yatineode128-hue/underground-shelter-project/DRAWING QAQC/QAQC_REPORT.md

# DRAWING QA/QC REPORT — revisions QA1 and QA1B

> **§10, 11 September 2026, is the current package state — revision QA2 (master H.25).**
> It re-scans the whole package, records the **twelve** sheets added at EM1 / EL1 / SG1 /
> SG2, explains why the index had frozen at 68, and corrects one revision-block overlap
> that `DR-A1` left on A-301. **The package is now 80 drawings, 74 PASS.**

> **§9, 10 September 2026, records the three sheets added after this pass** — F-101,
> F-102 and C-101, at revisions FS2 / CAM2 (master H.18). Sections 1–8 count 65 drawings.

> **QA1B addendum, 10 September 2026, is at §8** — the drawing outcome of design changes
> **BS1** and **SP-B2** (master Part H.12). Sections 1–7 record QA1 as issued on 9 September
> and are unchanged.

**Underground CBRN-hardened, blast-resistant protective structure + sentry post, Pune**
9 September 2026 · 65 DXF inspected · 65 corrected · scope: drafting, annotation,
sheet composition and title blocks only.

---

## 1  Headline result

| Measure | Before | After |
|---|---:|---:|
| DXF inspected | — | **65** |
| DXF edited in place (same filename, same folder) | — | **65** |
| **Text-on-text overlaps, all 65 drawings** | **67** | **2** |
| · of which, the 54 generated sheets | 49 | **0** |
| · of which, the 11 `current/cad` drawings | 18 | **2** |
| **Annotation crossing hard line work** (walls, stairs, openings, dimensions) — `current/cad`, whose layer names this test recognises | **50** | **10** |
| Drawing geometry sitting inside a notes panel — generated sheets | 46 | **35**, all legitimate (see note) |
| A view drawn on top of its own notes panel | 3 sheets | **0** |
| Entities outside the sheet border | 0 | **0** |
| Drawings with a border and title block | 54 of 65 | **65 of 65** |
| Panel / table body text below print size (1.4 mm on A1) | most of the package | **0** — floor is now 2.0 mm where the box has room |
| Generated packages rebuilding clean | 54/54 | **54/54, 0 errors** |

*Note on the 35.* They are the pipe-and-duct samples inside the **D-001** and **M-001**
legend panels (33) and a **D-103** section outline (2). A legend panel is *meant* to
contain line work. The eleven that were removed were the three views drawn over their
own notes panels (§3.4) and the bay bubbles that briefly landed inside the M-101 notes.

*Note on the generated sheets' remaining 91 label-over-geometry hits.* These are
bar-mark balloons, rebar callouts and level markers sitting on hatch, centre, reference
and reinforcement lines — which is what those annotations are **for**. They were
inspected on the plots and are correct drafting, not defects. The count that matters
for those sheets, geometry inside a **text panel**, is the row above.

**No engineering value was changed anywhere.** No dimension, level, bar mark, bar
size, spacing, load, material grade, thickness or room size was touched. The frozen
main staircase (24R @ 170.8333, tread 280, three flights of 8, total rise 4100) is
unchanged — verified entity by entity against the pre-edit files.

---

## 2  How the work was done

**The 54 generated sheets** (R-001…R-805, D-001…D-305, M-001…M-203, A-601/611/612 and
the four A4 handouts) are produced by the project's own Python generators. Every
defect in them was fixed **at source, in the generator**, and the sheets regenerated
to the same filenames. That keeps the generators and the DXF in agreement, which is
how the rest of this project is organised.

**The eleven `current/cad` drawings** have no generator in the workspace. They were
corrected directly by a recorded pipeline, `current/cad/Scripts/qa1_build_sheets.py`,
so the result is reproducible and auditable.

**Method for every drawing:** inspect programmatically → correct → save to the same
DXF → plot → look at the plot → correct again → plot again. Between three and six
inspect/correct/plot cycles were run on the package as a whole; sheets with real
defects (R-101, R-601, R-701, M-201, D-201, HV-H2, DR-H1, A-102, A-204) went round
individually four to six times.

Checks used, all in `DRAWING QAQC/Scripts/`:

| Script | What it measures |
|---|---|
| `dxfqa.py` | text bounding-box overlaps, text height range, text outside the sheet or inside the title block, duplicate annotation |
| `modelqa.py` | annotation crossing real line work, segment by segment |
| `panelclash.py` | drawing geometry sitting inside a notes panel |
| `voidqa.py` | occupancy grid and the largest empty rectangle on each sheet |
| `render.py` | plots the DXF so it can be judged as a printed sheet |

Automated checks were used to **find** candidates. Every fix was confirmed on a plot;
several defects (R-601, R-701, M-201) were invisible to the numeric checks and were
found by looking at the sheet.

---

## 3  Systemic defects found and fixed

### 3.1  Panels and tables were sized by eye — `sc_dxflib.py`
`panel()` and `table()` drew a box of a width the caller guessed, then poured text
into it. A long line ran past the border and a long cell ran into the next column.
Both now **measure their own content** with the same font metrics ezdxf uses to place
it: the text is fitted first, and only then is the box widened. A panel line cannot
cross its border and a cell cannot cross a column rule.

### 3.2  Body text was below print size
Every panel body and table cell in the package was written at the library minimum,
`TXT["small"] = 1.4 mm`. On A1 that is under what prints reliably. Panels and tables
now lift the body to **2.0 mm wherever the box has room**, measured, and fall back
only where it genuinely does not fit.

### 3.3  Blocks were pinned at fixed coordinates under variable-height blocks
A bar-mark key is as deep as the number of marks the sheet nominates; the bar-schedule
extract under it was pinned at a fixed `y`. On R-101 the key ran 25 mm straight
through the schedule. **Every such pair is now chained** off the height the block above
actually consumed — nine call sites across `g01`…`g08`.

### 3.4  Three views were drawn on top of their own notes panels
Found by plotting, not by the numeric checks:

| Sheet | What was wrong | Fix |
|---|---|---|
| **R-601** | view origin `(90, 260)` mapped the stair shaft to paper x 682–826: the 1:25 staircase plan was drawn over the MATERIALS panel and ran off the right border, while its own title, balloons and section marks sat on the empty left half | origin `(-508, 282)`; north arrow and two floating notes moved with it |
| **R-701** | origin `(70, 380)` put the headhouse roof plan at paper x 410–530, through “HEADHOUSE ROOF 500 — DESIGN BASIS” | origin `(-240, 380)` |
| **M-201** | section B-B sat at paper y 32–184, through “NOTES — SECTIONS AND CLEARANCES” (y 67–160) | moved into the clear band between V1 and the notes |

### 3.5  Pipe tags rotated along vertical runs
`pipe()` offset its tag +1.8 mm in Y whatever the pipe direction. On a vertical run
that pushes the label **along** the pipe, so a 66 mm tag lay across every label beside
it (D-201: U-05, SUMP, FF 1:80, GY-05, SU-01). Vertical runs now read horizontally,
set off to the side, as a callout normally is.

### 3.6  Table cells were hard-sliced
HV-H2's operating-modes table sliced every cell to a fixed character count —
“NO FILTER BYPASS IS SHO”, “bay 8 not pressuri”, “CBRN warning to all-clea” — losing
information on a sheet meant to be read in an emergency. Full text is now carried and
the table fits its own columns inside the printable width.

### 3.7  Grid bubbles sat on the view titles
On all sixteen MEP plan views the bay bubbles (520 above the box) collided with the
“V1 …” view title. Moving the bubbles below the box was tried and rejected — on M-101
and D-103 the plan sits directly on a notes panel and the bubbles landed inside the
notes. The clash is fixed at the titles, which move from y 548 to 553.

### 3.8  The Rev F drawings were drawings, not sheets
The ten `current/cad` Rev F files had no border, no title block, no notes box, and
annotation lying across the line work. They now carry an A1 (A-301: A0) border, inner
border, 180 × 100 title block and revision strip, drawn in model units at each
drawing's own stated scale, using LINE and TEXT only so the R12 (AC1009) format is
preserved. Loose bottom notes are collected into a ruled **NOTES** box and the drawing
is balanced between the header and the notes.

---

## 4  Per-drawing record

Sheets not named below had no defect beyond the systemic ones in §3, which were fixed
for them by the library and generator changes, and passed visual QA on the first plot
after the rebuild.

| Drawing | Problems found | Corrections | Cycles | Final QA |
|---|---|---|---|---|
| **R-001** | content in the top 40 % of the sheet, body text 1.4 mm, panel headings colliding with the first body line after enlargement, open-items text wrapped mid-word (“the platform b / ecomes”) | recomposed as three filled note columns via new `panel_column()`; heading band derived from both text sizes; word wrapping added; CODES panel moved to balance the columns | 3 | PASS |
| **R-002** | worst-composed sheet in the package — 45 % empty, legend descriptions 1.4 mm | layer-table row height 4.2 → 6.8; legend pitch opened; every description lifted to 2.0 mm; right column laid out with `panel_column` to fill and stop clear of the title block | 3 | PASS |
| **R-003** | bar-shape sketches drew up to 22 mm **above** their own origin, straight through the shape titles (“SHAPE 51” worst) | sketch dropped 30 mm below the title; cut-length lines moved down to match | 2 | PASS |
| **R-101** | bar-mark key (13 marks) ran through the bar-schedule extract; construction-requirements panel then collided with it; “SECTION A-A → R-102” floating mid-plan | key → schedule → notes chained; notes panel stretched to fill the bottom band; section reference moved beside its section mark | 4 | PASS |
| **R-103** | panel heading collided with the “900 HORIZONTAL LEG” detail note | panel dropped 10 mm | 2 | PASS |
| **R-202** | V1 and V2 view titles ran into each other | both titles shifted left | 2 | PASS |
| **R-203** | the right-hand column started at x 300, putting the mark key over the 1:60 wall elevation (which reaches x 407) | column moved to x 420, width 218 | 3 | PASS |
| **R-401 / R-402** | leader label on the W7 wall mark; V1 extension dimension inside the design panel; stray note inside the panel | leader dropped; panel top 400 → 384; note moved beside its dimension | 2 | PASS |
| **R-601** | see §3.4 — plan drawn over the materials panel and off the sheet | view origin corrected | 5 | PASS |
| **R-701** | see §3.4 | view origin corrected | 4 | PASS |
| **R-703** | “OPENING 2100 HIGH BELOW” pinned on the inner border, over the notes panel | moved into the view | 2 | PASS |
| **R-802** | stagger note sat on the D1 view title | note dropped 200 model mm | 2 | PASS |
| **D-101 / D-201 / D-203** | catchpit and gully labels on pipe tags; the long PD-05 rising-main tag lying across the sump labels | labels moved; pipe tags shortened and made horizontal (§3.5); the full route is already stated in sheet note 8, so nothing is lost | 4 | PASS |
| **DR-H1** | site-diagram captions crossing the headhouse and stairwell outlines and each other | captions split, shortened and moved into the clear areas; GY-11 note given a leader | 4 | PASS |
| **DR-H2** | plan title crossed by the service-entry flag; zone strip on the bubble row | flag and zone strip repositioned | 3 | PASS |
| **M-001** | AHU and blast-valve captions on the bay-bubble row and the stair-shaft note | captions moved below the plan | 3 | PASS |
| **M-201** | see §3.4 — section B-B through the notes panel | section relocated | 3 | PASS |
| **M-202** | “WEATHER LOUVRE” and “BLAST VALVE” wider than their own 300-wide stage boxes, so consecutive captions ran together | captions wrap onto two lines and are sized to the stage they name | 2 | PASS |
| **HV-H2** | operating-modes table slicing its cells (§3.6); operating-sequence panel running into the A4 footer | full text restored with `max_w` fitting; lower band re-stacked | 4 | PASS |
| **A-601** | anchor flag block sat above its detail and ran through the D2 title | flag block moved below the detail | 2 | PASS |
| **A-612** | the wall and ceiling halves of the finish tag were wider than their 13 mm cells | tag widened to 34 mm, lower row sized to its cell | 2 | PASS |
| **A-101 … A-301** (ten Rev F) | no sheet, no title block, no notes box; 115 annotations across walls, stairs, openings and dimensions | full pipeline §3.8 + de-clash; 93 labels moved, 28 leaders added | 5 | 5 PASS, 5 REVIEW |
| **S-06** | 18 annotations across the line work | de-clash only — it already has its own border and title block | 3 | REVIEW (2) |

---

## 5  Unresolved — REVIEW REQUIRED

### 5.1  Twelve annotations still crossing line work
All are single labels in the densest zones of a section or plan, where no clear
position exists within a 50 mm search of the object they name. They are legible; each
crosses a dimension, hidden or wall line. Listed so they can be nudged by hand:

| Drawing | Label | Crosses |
|---|---|---|
| S-06 | `CLEAN SUMP 1500 x 1500 x 1500` | CONC / SERVICES |
| S-06 | `UNDERGROUND SHELTER` | SERVICES |
| A-201 | `ROOF CONTINUOUS WITH THE HEADHOUSE ROOF` | WALLS |
| A-201 | `BLAST DOOR 2 -> GENERATOR (BEYOND)` | DIM |
| A-102 | `2200 ABOVE THE FLIGHT - SEE SECTION C-C` | DIM |
| A-102 | `550 ONLY` | DIM / WALLS |
| A-202 | `ROCKHEAD -1.500 / -2.000 (ASSUMED)` | DIM |
| A-202 | `HEADROOM 2533 BETWEEN STACKED FLIGHTS` | WALLS |
| A-203 | `900 PROJECTION` | DIM |
| A-204 | `300 CHANNEL AND GRATING ACROSS THE` | DIM / OPENINGS / WALLS |
| A-204 | `300 CHANNEL AND GRATING ACROSS THE` vs `2200 CLEAR` | label on label |
| A-204 | `NOW SECOND IN SERIES` vs `2400 CLEAR` | label on label |

### 5.2  Sheets that do not fill their paper
`voidqa.py` still reports 20–39 % empty on a number of sheets — after this pass the
worst are **R-202** (39 %), **R-302** (37 %), **D-002** (37 %) and **R-003** (37 %).
Two of the worst were fixed: **R-002** was 45 % empty and is no longer in the list, and
**R-004**, the 92-mark master schedule, was 31 % empty and is now filled (its schedule
row height was opened from 4.9 mm to 7.6 mm, which changes no text size and no value). Where the emptiness came from
layout it has been fixed (§3, §4). Where it remains it is **inherent to the content**:
R-002's L4 block must display text at its true plotted heights, so that sheet cannot
be scaled up, and a 1:50 section of a 22 m structure simply does not fill an A1. No
drawing scale was changed to fill paper. **Your ruling is invited** on whether any of
these sheets should be combined or re-scaled.

---

## 6  Engineering and documentation issues raised — YOUR RULING NEEDED

### 6.1  A-301 FRONT ELEVATION could never have been plotted as drawn — CORRECTED
The drawing is 44 m long, which is **880 mm at 1:50**. The A1 drawing area is 821 mm
wide. Its own note read “SCALE 1:50 AT A1”, which is not achievable. The scale governs
measurement and was kept; the **sheet size was corrected to A0** and the note now
reads “SCALE 1:50 AT A0”. This is the only text content changed anywhere in the
package. If you would rather keep A1 the drawing must go to about 1:75, or the sentry
post must be shown on a separate sheet — **please rule.**

### 6.2  Declared deviation from project rule M.12
M.12 forbids editing a generated DXF directly. **S-06 is a generated output sheet and
its generator is not in the workspace**, so the brief's explicit and repeated
instruction — every existing DXF to be corrected and saved back at the same filename —
could only be met by editing it directly. 15 labels were moved on S-06; nothing else
was touched. This is recorded, not hidden, and is trivially revertible from git.

### 6.3  Sheets that still cannot be regenerated
S-01…S-05, S-07 and S-08 are absent from the workspace, as are their generators
(`proj.py`, `dxflib.py`, `d01_wall.py`…`d08_sentryslab.py`). Nothing was invented for
them. Only S-06 exists and it has been QA'd.

### 6.4  Placeholders that remain, by design
`DRAWN / CHECKED / APPROVED` read `[PLACEHOLDER]` in every title block, matching the
issued R-series. No name, no signature and no approval date has been invented.

### 6.5  Open items untouched
C16, C17, C18, C19, C20, C21, U1–U3, U8 and WM-V1…12 are drafting-neutral and were not
resolved, closed, downgraded or removed. The open-item panels that carry them are
unchanged in content.

---

## 7  Hard-copy readiness checklist

| | |
|---|---|
| Existing DXF edited in place, same filename, same location | ✔ 65/65 |
| No duplicate or parallel “clean” drawing created | ✔ |
| DXF remains editable CAD — LINE, POLYLINE, TEXT, MTEXT, DIMENSION, LEADER, HATCH, INSERT | ✔ nothing rasterised, no block exploded, no geometry flattened |
| DXF format unchanged (R12 for `current/cad`, AC1024 for the generated packages) | ✔ |
| No text-on-text overlap | ✔ except the two named on A-204 |
| No text outside the sheet | ✔ 0 |
| No microscopic annotation in a panel or table | ✔ floor 2.0 mm where the box allows |
| Notes inside a notes box | ✔ including the ten Rev F drawings, which had none |
| Table text inside its cells | ✔ columns now measured, not guessed |
| Title block on every sheet, clean and consistent | ✔ 65/65 |
| Drawing title / number / scale / size correct and agreeing with the index | ✔ |
| Logical sheet sequence, no duplicate numbers | ✔ A-101…A-301, S-06, R-001…R-805, D-001…D-305, M-001…M-203, A-601…A-612, handouts |
| Engineering geometry preserved | ✔ verified entity by entity; where a Rev F drawing was re-centred on its new sheet it moved as a **pure vertical translation** |
| Frozen main staircase unchanged | ✔ verified |
| Plot generated and visually inspected for every drawing | ✔ |
| Remaining issues documented | ✔ §5, §6 |

---

## 8  ADDENDUM — revision QA1B, 10 September 2026

Two instructed design changes, **BS1** (the burster slab is laid to a 1:50 crossfall) and
**SP-B2** (lintels and wall ties for the sentry post masonry infill), were carried through
the drawing package on 10 September 2026 — see master **Part H.12**, **A.7.3** and
**A.4.8**. The drawings they touched were re-inspected, plotted and re-checked. This
addendum records the drafting outcome only; the engineering is in the master.

### 8.1  Result — the QA1 baseline is held

| Measure | QA1, 9 Sep | QA1B, 10 Sep |
|---|---:|---:|
| DXF in the package | 65 | **65** |
| Text-on-text overlaps, all 65 | 2 | **2** — the same two, both on A-204 |
| Annotation crossing hard line work — `current/cad` | 10 | **10** |
| Drawing geometry inside a notes panel — generated sheets | 35 | **35** |
| Drawings passing every automated check | 58 | **59** |
| Generated packages rebuilding clean | 54/54 | **54/54, 0 errors** |
| Frozen main staircase | unchanged | **unchanged — re-verified** |

### 8.2  A regression this work introduced, found and fixed

**A-103** went from 0 to 1 text-on-text the moment the ground-storey callout was
relabelled: *"200 RC BALLISTIC INFILL PANELS"* (30 characters) became *"190 BRICK MASONRY
INFILL (SP-B1)"* (32), and the longer string ran into the vertical **W1 1200** wall tag.
The note was **left-aligned onto the same x as the note above it** rather than left
centred where it no longer fitted. A-103 is back to **0 text-on-text, 0 hard-geometry**.

### 8.3  Defects found by plotting that no numeric check flagged

All three were **pre-existing** and all three were invisible to the overlap metric,
because each fell under its 12 %-of-the-smaller-box threshold. They were found the way
the brief requires — by looking at the plotted sheet.

1. **D-301 — the cover build-up was annotated inside a 33 mm band.** At 1:60 the 2000 mm
   cover is 33 mm on paper and the 100 mm protection screed is **1.7 mm**; six layer
   labels were written inside it and the soil hatch ran through all six. The layer lines
   stay in the section; the build-up now reads from a **panel in the clear space to the
   right, at 2.0 mm**, which also carries the BS1 statement. The
   *"DESIGN GWT (−)2.000 [ASSUMED]"* label, which started **1.7 mm outside the inner
   border** and crossed the 2000 dimension, moved under the GWT dash into the unhatched
   pressure-slab band.
2. **D-102 — two plan labels struck through by line work.** *"C3 ENGINEERED COVER OVER
   THE BOX…"* ran through the extension lines of the 4800 headhouse dimension, and
   *"GRADE CROWNED, FALLS 1:50 AWAY…"* straddled the top border of the V2 catchment
   table. Both dropped clear.
3. **A-103 — the beam note was wider than the room.** *"B1 / B2 250 × 450 FIRST FLOOR
   BEAMS OVER"* was 3851 mm long in a 3600 mm room, so it pushed through the east wall
   and through the **W1 1200** tag, and it sat wedged between the two halves of the
   *"SENTRY POST / GROUND FLOOR"* title. It is now **two centred lines above the title**,
   inside the room.

### 8.4  Also corrected

**Two U+00B7 middle dots had been written into A-105**, which is **R12 (AC1009)** and
therefore ANSI-coded, not UTF-8. They are now ASCII hyphens, and **all eleven
`current/cad` drawings are pure ASCII again.**

### 8.5  What this addendum did NOT change

- **No engineering value.** BS1 changes no thickness and no load: COMB 103 stays
  448.15 kPa and all three `.std` files were not opened. SP-B2 adds no frame member.
- **No open item was resolved by drafting.** **C17** is still open (BS1 does not touch
  it), **WM-V6** and **WM-V7** are still open, and **WM-V3** is deliberately left open —
  lintel L1 is designed to a bound that does not use an opening height.
  **WM-V5** and **WM-V11** are closed **by the design in master A.4.8**, not by anything
  on a drawing.
- **The frozen main staircase.** Re-verified: R-601 still carries all eight frozen
  values and the staircase drawings' text is identical, entity for entity, to the
  pre-change files.
- **QA-1 and QA-2 remain open** and still need your ruling — see §6.1 and §5.2.

### 8.6  Sheets touched by QA1B

| Sheet | Change |
|---|---|
| **R-302** Roof Sections | cover build-up drawn as a real 1:50 crown; fall arrows; labels and panel line updated |
| **D-102** Rainwater Catchment | BS1 continuation on note 3; two struck-through labels moved clear |
| **D-301** Drainage Sections | cover build-up moved out of the section into a legible panel; BS1 statement; GWT label brought inside the border |
| **A-103** Sentry GF Plan | infill relabelled to brick; beam note split and re-placed; regression fixed |
| **A-104** Sentry FF Plan | infill note relabelled to brick |
| **A-105** Sentry Framing Plan | infill callout, load-schedule line and R-value note rewritten; **new SP-B2 lintel and tie panel**; NOTES box rebuilt; non-ASCII removed |
| **A-301** Front Elevation | frame/infill note relabelled to brick |
| **A-202** Side Section X-X | burster slab label now states the 1:50 crossfall |

### 8.7  QA-2 re-measured — §5.2's figures were going stale

§5.2 was written on 9 September and is left as issued. Its list is now partly out of
date, so here are the current numbers, measured by `voidqa.py` on all 65 drawings.

| | 9 Sep (§5.2) | 10 Sep |
|---|---:|---:|
| **R-202** Internal Wall Reinforcement | 39 % | **39.3 %** |
| **D-002** Drainage Symbols | 37 % | **36.7 %** |
| **R-003** Typical Reinforcement Details | 37 % | **36.7 %** |
| **R-302** Roof Sections | 37 % | **35.5 %** — improved by the BS1 crown, its arrows and its longer labels |
| Package mean / median void | — | **23.2 % / 22.3 %** |
| Drawings over 30 % void | — | **14 of 65** |

**§5.2 also under-reported the `current/cad` drawings**, which it did not list at all.
Four of them are now in the worst eight: **A-201** and **A-203** at 38.7 %, **A-103** and
**A-104** at 36.3 %. Their emptiness has a different cause from the generated sheets' —
a Rev F drawing was re-centred on a sheet frame it was never drawn for, so the frame is
sized to the paper while the drawing is sized to its own subject.

**No sheet was re-scaled or re-composed to improve these numbers**, and none should be
without a decision: the scale on a sheet is a measurement statement, not a layout
parameter. **QA-2 stands as an open question for you** — whether any of these sheets
should be combined, re-scaled or left as they are.

One pattern is worth naming for whoever rules on it. On eight of the generated sheets —
R-202, R-003, D-002, R-402, R-002, R-201, R-401 and R-801 — the largest empty rectangle
is the same shape: **(0, 0) to (651, 220–302)**, the full-width strip along the bottom
of the sheet, left of the title block. That is not inherent to the content. It is the
generators stacking their blocks from the top and stopping, and it could be fixed by
chaining the block column to the sheet bottom, the way `panel_column()` already does on
R-001 and R-002. **RC1 examined that and ruled against doing it** (10 September 2026, master K.1).
Reflowing the blocks **moves** the void rather than removing it: the content on these six
sheets is genuinely sparse for an A1, and the two changes that would actually fill the
paper are both worse than the space. **Re-scaling** would turn the stated scale into a
layout variable instead of a measurement statement — 1:20 is the right scale for a 400
wall section however much paper it leaves. **Combining or renumbering** would break
cross-references on other sheets, the drawing index, master Part E.2 and the "N OF 30"
numbering, for no engineering gain. Every one of these sheets is **correct, complete and
legible**; emptiness is not an error. **Combining them is a register-level decision and
it belongs to the user — it remains a contained job if they ask for it.**

---

## 9  ADDENDUM — three sheets added at revisions FS2 / CAM2, 10 September 2026

**Sections 1–8 above record 65 drawings and are unchanged.** The package is now **68**.
The three new sheets did not exist when QA1 ran; they were drawn afterwards, to the same
standard, as the drawing half of the relocation recorded in master Part **H.18**.

| Sheet | Package | What it is |
|---|---|---|
| **F-101** | `Fire and Life Safety/DXF/` | Underground level escape plan — the three routes, the travel distances, and Blast Doors 1 and 2 drawn as the only two real fire barriers |
| **F-102** | `Fire and Life Safety/DXF/` | Entry level escape plan, and **V2, the vertical escape profile** — the climb each route actually is |
| **C-101** | `Site and Concealment/DXF/` | Above-ground signature elevation — a true elevation of every element standing above finished grade, at its confirmed height |

### QA actually executed on them

| Check | Tool | Result |
|---|---|---|
| DXF structure, layers, extents, title block, sheet-edge and scope declaration — 11 checks per file | `Drainage/Scripts/mep_validate.py` | **3 files, 0 errors, 0 warnings** |
| Text-on-text overlap | `Scripts/modelqa.py` | **0 on all three** |
| Annotation over line work | `Scripts/modelqa.py` | **0 on C-101 and F-102. 1 on F-101** — the shared background's own `STAIR SHAFT - FROZEN GEOMETRY` label, which appears identically on the issued D-201 and is not introduced by this work |
| Geometry drawn over a note panel | `Scripts/panelclash.py` | **0 on all three** |
| Index and final QA status | `Scripts/qa_report_data.py` | **68 drawings, 62 PASS** — the 6 REVIEW REQUIRED and the 12 residual items are the same ones §5 already lists. **The three new sheets added none.** |
| **Plotted and inspected visually** | `Scripts/render.py` at 170–200 dpi | **Mandatory under §17 of the brief, and it earned its place.** The first drafts of all three had defects no automated check reported — a travel-distance caption sitting inside a note panel on F-101, V2's level labels running across V1 on F-102, and a grade note struck through the ESC 1 label on C-101. Each was found by looking at the plot and fixed before issue. |

### Two shared modules changed, and why the change is safe

`mep_dxf.py` — the sheet's issue date and its two sentry-post scope notes became
overridable class attributes. `mep_validate.py` — check 11 now asks that a sheet
**declare** its sentry post scope rather than that it **exclude** it, because on C-101 the
sentry post is **in** scope: it is the tallest signature on the site, and a sheet that
drew it while printing "SENTRY POST EXCLUDED" would be stating a falsehood in its own
title block. Silence is still an error.

**Neither change alters any issued drawing.** Verified by regenerating D-101 and diffing
it line for line against the committed file: **26 869 lines against 26 869**, and every
one of the ten differing blocks is inside `$TDCREATE`, `$TDUPDATE`, `$FINGERPRINTGUID`,
`$VERSIONGUID`, `CLASS` ordering or the ezdxf `DictionaryVariables` stamp. **No geometry,
no text, no layer changed, and no issued sheet was regenerated into the repository.**
The other 24 sheets were re-validated in place and still pass.

---

## 10  ADDENDUM — revision QA2, 11 September 2026 (master H.25)

**Twelve sheets drawn after §9 had never been scanned, and the index had silently
frozen at 68.** §9 closed with *"68 drawings, 62 PASS"*. Since then EM1, EL1, SG1 and
SG2 added twelve A1 sheets. The index says at the top of its own file that it
*"cannot drift from the drawings"* — **it had drifted, and this is why.**

### 10.1  The cause — a hard-coded discipline list, not a scanning failure

`Scripts/qa_report_data.py` globs every `*.dxf` under the project root, but maps each
file to a discipline through a **hard-coded `DISCIPLINE` prefix list**. That list ended
at `Site and Concealment/DXF/`. It had no entry for `EMP Protection/DXF/`,
`Electrical/DXF/` or `Site Selection and Geotechnical/DXF/`, and `make_index.py`'s
`ORDER` list had no entry for their discipline names, so the twelve sheets were
collected as `OTHER` and then dropped when the index was grouped and ordered.

**Fixed** — three prefixes added to `DISCIPLINE`, three names added to `ORDER`. The
index is regenerated from the files and now reports **80**. **No drawing was changed by
this fix.**

> **The claim in the index header is now true, but it was only ever true for
> disciplines already on the list.** Any package added in future must add its own
> prefix, or it will be invisible to this tool in exactly the same way.

### 10.2  The twelve sheets, as scanned

| Sheet | Package | Title | Size | Texts | Overlap | Over line work | In panel |
|---|---|---|---|---:|---:|---:|---:|
| **EM-001** | `EMP Protection/` | EMP PROTECTION — DESIGN BASIS AND EMP ZONE KEY | A1 | 146 | 0 | 0 | 0 |
| **EM-101** | `EMP Protection/` | EMP ZONE PLAN — UNDERGROUND LEVEL (−)6.100 | A1 | 198 | 0 | 0 | 0 |
| **EM-102** | `EMP Protection/` | EMP BOUNDARY SECTION — THE ENTRY PATH | A1 | 119 | 0 | 0 | 0 |
| **EM-201** | `EMP Protection/` | SHIELDING EFFECTIVENESS — CAGE AND APERTURES | A1 | 152 | 0 | 0 | 0 |
| **EM-301** | `EMP Protection/` | EMP ZONE 2 ENCLOSURE — PLAN, SECTION AND SITING | A1 | 105 | 0 | 0 | 0 |
| **EM-302** | `EMP Protection/` | EMP PENETRATION, BONDING AND EARTHING DETAILS | A1 | 126 | 0 | 0 | 0 |
| **E-001** | `Electrical/` | SINGLE LINE DIAGRAM — SOURCES, BOARDS AND ESSENTIAL SERVICES | A1 | 146 | 0 | 0 | 0 |
| **SG-001** | `Site Selection and Geotechnical/` | SITE AND GEOTECHNICAL DESIGN BASIS | A1 | 210 | 0 | 0 | 0 |
| **SG-101** | `Site Selection and Geotechnical/` | SITE SETTING, SELECTION AND METEOROLOGY | A1 | 228 | 0 | 0 | 0 |
| **SG-102** | `Site Selection and Geotechnical/` | SITE LAYOUT PLAN | A1 | 138 | 0 | 0 | 0 |
| **SG-201** | `Site Selection and Geotechnical/` | GEOTECHNICAL PROFILE AGAINST THE STRUCTURE SECTION | A1 | 207 | 0 | 0 | 0 |
| **SG-202** | `Site Selection and Geotechnical/` | EXTERNAL WORKS SITING AND THE SOAK PIT FINDING | A1 | 126 | 0 | 0 | 0 |

**All twelve: 0 text-on-text overlaps, 0 annotations over line work, 0 geometry inside a
notes panel.** They were drawn against the post-QA1 shared library and each package ran
its own `mep_validate.py` at issue. **They add nothing to §5's residual list.**

### 10.3  A regression this scan caught — A-301, and it was invisible until now

**`DR-A1` (master H.24) added its revision line to A-301 on the same row as `QA1`'s, and
the two overlapped.** A-301 had been `PASS` with 0 overlaps at QA1; it was scanned again
here for the first time since, and the overlap is real:

```
QA1    09.09.2026 ...   at (-6183.1, -31075.0)   ends x = 1454.0
DR-A1  11.09.2026 ...   at (    0.0, -31075.0)   starts x = 0.0
                                                  -> 1454 units of overlap
```

The revision band on A-301 is 400 units tall (rules at −30800 and −31200) and the two
notes are 7 637 and 8 045 units wide against a band 14 396 wide, so **they cannot sit
side by side and were never going to.** A-202, the other sheet DR-A1 edited, had already
done it correctly — QA1 at −24073, DR-A1 at −24373, both at the same x.

**Corrected on A-301 to match A-202's convention** — the two notes stacked, both left-
aligned at x = −6183.1, QA1 lifted to y = −30905 and DR-A1 placed at y = −31075.
Both sit clear of both rules and of each other; **neither note's text was shortened and
no other entity was touched.** Editing this DXF directly is permitted — the ten Rev F
architectural drawings are source, not build artefacts.

### 10.4  Package state after QA2

| Measure | §9 (68 sheets) | QA2 (80 sheets) |
|---|---:|---:|
| Drawings indexed | 68 | **80** |
| PASS | 62 | **74** |
| REVIEW REQUIRED | 6 | **6** — the same six Rev F sheets |
| Text-on-text overlaps | 0 | **2**, both on A-204, both listed in §5.1 |
| Annotations over line work | 12 | **10** |
| Geometry inside a notes panel | 35 | **35** — the same legend samples, still legitimate (§1 note) |
| Sheets carrying a title block | 65 / 65 | **80 / 80** |

**The twelve new sheets introduced no defect. The one defect found was A-301's, it came
from `DR-A1`, and it is fixed.** §5's residual list is unchanged in substance: the same
six Rev F sheets, now carrying ten items rather than twelve, because the A-202 and A-301
counts were re-measured against their current content.

### 10.5  What QA2 did NOT do

No engineering design was reviewed or changed. No dimension, level, load, bar mark,
quantity, rate, date or float moved. No generated sheet was regenerated into the
repository. **STAAD.Pro was not run.** The main staircase was not touched.
