yatineode128-hue/underground-shelter-project/Site Selection and Geotechnical/Documentation/SITE_SELECTION_AND_GEOTECHNICAL_REPORT.md

# SITE SELECTION AND GEOTECHNICAL INVESTIGATION
### Underground CBRN-hardened blast-resistant protective structure and sentry post — Pune, Maharashtra

**Package** `Site Selection and Geotechnical/` · **revision SG1** · **11.09.2026** · GEOMETRY REV F + M1
**Status — FOR REVIEW - NOT FOR CONSTRUCTION.**

**Evidence class, as everywhere in this project:** `[C]` confirmed · `[R]` reconstructed · `[D]` derived here · `[A]` assumed by this package · `[U]` unresolved · `[N]` not available — DATA REQUIRED

---

## 1. Why this section exists, and what it does not do

Until now this project has carried its site and its ground entirely as assumptions. Master `A.6` tags **every** soil parameter `[ASSUMED]`; `K.2` lists six of them as items that must be confirmed before construction; and the Part J dependency map draws `[SITE INVESTIGATION]` as a root node with **nothing feeding it**. The design report has never contained a site selection section at all.

Two documents have now been supplied that feed that node for the first time. This section records them, checks them against each other and against the master, and states exactly what they do and do not establish.

> ### It resolves nothing, deliberately.
> Master rule `M.6` and the project operating guide both forbid converting an `[ASSUMED]` into a confirmed fact. **Not one `K.2` assumption is closed by this section.** What each one now has, for the first time, is a **stated provenance and a quantified margin** — and in four cases, a reason to stay open that is stronger than before.

**No design value changes.** No load, thickness, bar, level, quantity, rate, date or float moves. No `.std` file is touched. The main staircase is untouched. The sentry post is in scope for **ground only** — footing F1 bears on in-situ basalt at `(−)2.000` and that is a geotechnical statement — and no sentry structural value is changed.

## 2. Sources

| # | Document | What it is | Class |
|---|---|---|---|
| **1** | **SEMT/67/15** — *REPORT ON SUB-SOIL INVESTIGATION FOR CTW PH-III ACCN PROJECT AT CME PUNE*. Soil Engineering & Material Testing Wing, College of Military Engineering, Pune 411 031. Raised on CTW letter No 8722/Ph-III/CTW/116/Q dated 20 May 2015. | A real sub-soil investigation: **11 trial pits at 3 locations**, Appendices A (classification), B (soil test result) and C (rock cores), Sketches P and Q. | `[C]` |
| **2** | **P1 presentation deck** — *CONSTRUCTION OF CBRN HARDENED UNDERGROUND OPS ROOM*, TEAM GROUNDZERO, 32 slides. | The project's own first-phase presentation: site location, contour, watershed, road, pipelines, recce, elevation profile, SWOT, wind, precipitation, temperature, seismic and soil slides. | `[C]` as a record of what was presented |
| **3** | Location pin `https://maps.app.goo.gl/H2VjnrjS8X8SsXEr9` | The project owner's own positional reference. | `[N]` — **NOT RESOLVED - maps.app.goo.gl refused by the session egress policy (403). Coordinates [N]; supply lat/long to close.** |

### 2.1 A limitation that must be read before anything else

**The SEMT report is not an investigation of this plot.** It investigates three named buildings on the CTW/CME campus — **G Building (TP-1 to TP-4)**, **H Building (TP-5 to TP-8)** and the **Mess Building (TP-9 to TP-11)**. The project plot is a separate undeveloped area east of the CTW blocks, against the perimeter track (deck slides 13, 14 and 22).

The report may be carried across to this plot only on the strength of its own paragraph 5:

> *“The area under investigation is underlain by the Deccan Trap formation. These are volcanic lava flows, which were poured out between the late cretaceous and early Eocene times. These basaltic flows are horizontally bedded and more or less uniform in character over a wide area.”*

That carry-across is an **assumption of this section, not a finding of the report** `[A]`. And the report itself shows how much variation “uniform over a wide area” permits: across three locations a few hundred metres apart, rockhead moved from **0.9 m to 1.5 m** and the surface stratum changed from a 1.0 m high-plasticity clay to a 0.2 m clayey-sand murrum.

## 3. Site identification

| Item | Value | Class |
|---|---|---|
| Installation | CTW / College of Military Engineering campus, Pune, Maharashtra | `[C]` |
| Plot | Undeveloped rectangle **east of the two CTW blocks**, west of the perimeter track and nullah line, **CBRN Live Training Area to the south** | `[C]` deck slides 13, 14, 22 |
| Latitude / longitude | **NOT ESTABLISHED** — NOT RESOLVED - maps.app.goo.gl refused by the session egress policy (403). Coordinates [N]; supply lat/long to close. | `[N]` |
| Plot boundary and area | **NOT DIMENSIONED ANYWHERE.** No scale bar, grid, boundary dimension or coordinate appears on any supplied site image | `[N]` — master gap **D3** |
| Site benchmark | **NONE.** Nothing ties any supplied level to the project datum | `[N]` |
| Project datum | **finished grade = 0.000**, local, master `A.4.1` | `[C]` |

> **Master gap D3 — “no site plan” — is NOT closed by this section and cannot be.** Imagery is not a site plan. Until a boundary, a dimension, a benchmark and a coordinate exist, the berm, the hardstanding, the access, the five external drainage runs, the concealment layout (`CAM2`) and the cut-and-fill cannot be drawn. What this section adds is that the *setting* is now recorded, which it was not.

## 4. Site selection

The selection was made at P1 and is recorded here for the first time. The deck's own SWOT, verbatim:

| | |
|---|---|
| **Strengths** | Proximity to FCBRNP · Availability of electric lines · Good road connectivity · Good water supply · No pipelines |
| **Weaknesses** | Located near Perimeter Fence |
| **Opportunities** | Enhanced trg opportunities · Live demo model to facilitate practical trg · Good connectivity |
| **Threats** | Interference with CTW schedule |

### 4.1 What the selection got right, in this project's own terms

Three of the recorded strengths are load-bearing for the design that followed, and none of them was written down as such at the time:

1. **“No pipelines.”** The pipelines sketch (slide 18) draws the site box **outside** the campus pipe network; the nearest services are the RCC overhead reservoir (15 000 gallons, 15 m staging) and substation SS-15 beside buildings 526/527. For a **22 m × 6.2 m box excavated to (−)6.800** with a **continuous gas-tight, EMP-bonded envelope**, a buried main crossing the footprint would have been a first-order problem: every envelope penetration is a blast, gas and EMP discontinuity, which is why the master forbids movement joints inside the protective envelope at all. A clear plot is worth more here than on an ordinary building.
2. **“Availability of electric lines.”** `EL1` found that the only record of an incoming mains supply anywhere in the project is a line in the owner's own construction schedule. Slide 22 is the second, and it is earlier. It does not give a capacity — `EL-V4`, which blocks any fault-level study, **stays open**.
3. **“Good road connectivity.”** The road connectivity slide shows the plot reached from the campus network without passing through the built-up core. The works management package programmes **994 m³ of rock excavation by hydraulic breaker with no blasting** and tipper haulage throughout; that is a haul-route requirement, and the site meets it.

### 4.2 What the selection did not consider, and what it costs

| Not considered | Consequence, now quantified |
|---|---|
| **Ground conditions on the plot itself** | The selection rests on a soil report for three *other* buildings. The confirmatory site investigation (WBS `A1075`, 12 d, **critical path**) has to be located **on this plot**, not repeated from the report. `SG-V1` |
| **Depth of investigation** | Nothing is known below about 1.5 m; the structure founds at `(−)6.800`. **`SG-V2` — the governing item of this section.** |
| **Ground slope** | The plot sits on the edge of a slope falling east. A 22 m box on a level formation under a crowned grade needs cut and fill; **no cut-and-fill item exists in the BOQ** because no site plan exists. `SG-V4` |
| **“Located near Perimeter Fence”**, recorded as the single weakness | It is also a **concealment** weakness, and `CAM2` — whose finding is that *the shelter is concealed, the installation is not* — could not draw a concealment layout for exactly this reason. The sentry post stands at **+7.000** and the headhouse at **+0.900 with no earth cover**; how visible those are from the fence line is a function of a distance nobody has recorded. `CAM-V2`, `D3` |

## 5. Site setting — topography, drainage and access

### 5.1 Level and fall — and a conflict inside the deck

Two slides describe the ground surface, and **they do not agree**:

| Source | What it says | Implied ground level | Implied fall |
|---|---|---|---|
| **Contour map**, slide 15 | 1 m contours labelled **575 to 584**; the **580** and **581** contours both cross the plot; ground falls east / north-east, towards the track and nullah | **≈ 580–582 m** on that map's datum | of the order of **1–1.5 m** across the plot, ≈ 1 in 40 |
| **Elevation profile**, slide 21 | **593.9 m** at 0 m rising to **596.2 m** at **26.8 m** | **593.9–596.2 m** | **2.3 m over 26.8 m** = **1 in 11.7** (8.6%) |

**They differ by 12 to 16 m in level and by roughly a factor of four in gradient.** `[U]` `SG-V4`

The most likely reading is that the contour map is on a local survey datum while the profile is a satellite-derived MSL profile taken across a short transect that includes the track embankment east of the plot — **but that is a guess and it is recorded as one.** Neither figure is adopted.

**Why it does not matter to any calculation.** The project works on a local datum with finished grade `= 0.000` (master `A.4.1`). Every level in Parts A, B and F is relative to it and **no absolute reduced level appears anywhere in the project**. Nothing recalculates.

**Why it matters anyway.** Three things that are not yet drawn depend on it: the **cut and fill** needed to give a 22 m box a level formation under a crowned grade; the **berm toe**; and the point where the cover's **1:50 crossfall** (`BS1`) daylights into the berm fill. With 1 to 1.5 m of natural fall across the plot, finished grade at 0.000 **cannot be the natural surface everywhere**.

The report's own terrain sentence — *“The location for the proposed buildings is on fairly level ground.”* — is said of the G, H and Mess building locations. The contour map shows this plot is the edge of a slope.

### 5.2 Surface drainage

The watershed slide (16) shows the plot on the shoulder of a catchment draining east and south-east to the track and nullah line, with no channel crossing the plot itself. That is consistent with the contours and with the drainage package's position that **the engineered cover is not drained by pipework**: rain sheds at the surface, what infiltrates is intercepted by the 150 granular filter and dispersed at the berm toe (`D-201` note 3, calculation `D.7`, and `BS1`, which gave the burster slab the 1:50 crossfall that claim depends on).

**The site-wide catchment still cannot be closed.** Calculation `D.7` records the structures' own catchments as complete (177.23 m²) and the berm, approach and hardstanding as `[N]` for want of a site plan. Slide 16 does not supply a boundary, so that stays `[N]`.

## 6. Geology and regional setting

> *“The area under investigation is underlain by the Deccan Trap formation. These are volcanic lava flows, which were poured out between the late cretaceous and early Eocene times. These basaltic flows are horizontally bedded and more or less uniform in character over a wide area.”* — SEMT/67/15 para 5 `[C]`

This is the Deccan Trap, and the master has assumed it since Rev D. The report confirms the formation. **What it does not confirm is the thing the master is actually afraid of:**

> **Master `A.6`:** *“The hazard is not the basalt — it is the flow contacts. A single red-bole seam under the mat produces the differential-support case that SIZES the mat.”*

That case — a 3.0 m band of red-bole or vesicular material removed at the worst position — is **what governs the 600 mat and its T16 @ 150 EF EW at 84 % utilisation** (master `B.3`, Case 2). Horizontally bedded flows are precisely the geometry that produces flow contacts at intervals. **The report neither finds nor excludes one, because it never reached the founding horizon.** The red-bole case stands exactly as designed, and the confirmatory investigation must look for seams **at and below (−)6.800**, not above it.

## 7. The sub-soil investigation

### 7.1 Scope and method

| Item | Record | Class |
|---|---|---|
| Method | *“Excavation in open trench / trial pit by JCB was carried out and 11 trial pits were made.”* | `[C]` |
| Pits | **11**, at 3 locations | `[C]` |
| Boreholes | **none** | `[C]` |
| In-situ testing | **none** — no SPT, no plate load test, no permeability test, no percolation test | `[C]` |
| Date of field work | **not stated anywhere in the report** | `[N]` `SG-V10` |
| Laboratory | Soil Classification (IS 2720 Pt IV-1975 & IS 1498-1970) · Free Swell test (IS 2720 Pt XL-1977) · Soil compaction (IS 2720 Part VIII-1983) · UCS test (IS 2720 Pt X-1991) · Direct Shear Test (IS 2720 Pt XIII-1986) · Compressive strength on Rock (IS 1121 Pt I- 1874 [as printed]) | `[C]` |

### 7.2 The governing finding of this whole section

| | Level |
|---|---|
| **Deepest stratum boundary recorded anywhere in the report** | **(−)1.500** |
| Sentry footing F1, on in-situ basalt | `-2.000` |
| Underground box, internal floor | `-6.100` |
| Mat soffit | `-6.700` |
| **FORMATION — what the mat actually bears on** | **`-6.800`** |
| Sump SU-01 base | `-8.000` |

> ## `SG-F2` — THE INVESTIGATION REACHED ABOUT 1.5 m. THE STRUCTURE FOUNDS AT 6.8 m.
> There are **5.3 m of completely unlogged ground** between the bottom of the deepest trial pit and the formation the 600 mat bears on, and **6.5 m** to the sump base. **Only the sentry post footing F1 at `(−)2.000` lies inside the investigated horizon, and only just.**
> 
> Nothing the report says about rockhead continuity, groundwater, jointing, red-bole seams or modulus of subgrade reaction can be read as covering the founding horizon of the shelter. Master `K.2` items **A1, A2, A4, A5 and A8 all stay open**, and the programme's confirmatory site investigation `A1075` — *boreholes, rockhead, red-bole seams*, 12 days, **total float 0** — remains mandatory in full. `SG-V2`

### 7.3 What the pits did find — and the check that it is usable

The full stratum log is in `Schedules/TRIAL_PIT_SCHEDULE.md`. In summary, at all three locations: a thin **black cotton (CH) cover**, **murrum** below it, **disintegrated broken basalt** below that, and **sound basalt** below that again.

Before using any of it, the report was tested against itself. **Every derived number in it reproduces from its own inputs** (calculation `G.2`):

| Chain | Check | Result |
|---|---|---|
| Soil | `SBC = q_ult / 2.5`, the report's own stated factor of safety | **6 of 6 rows reproduce** |
| Rock, step 1 | `UCS = max load / specimen area` | **6 of 6 rows reproduce** |
| Rock, step 2 | `SBC = UCS / 25`, rounded — the factor the report applies but never prints | **6 of 6 rows reproduce** |

> **`SG-F1`.** The SEMT report is internally consistent and is usable. That is worth establishing before anything is built on it.

## 8. Bearing capacity

### 8.1 Soaked or unsoaked? It is not a free choice

The report gives sound basalt **two** bearing values, and they differ by a factor of about 1.6:

| Condition | Band | Class |
|---|---|---|
| **Soaked** | **1961 – 2059 kPa** (20–21 kg/cm²) | `[C]` |
| Unsoaked | 2942 – 3530 kPa (30–36 kg/cm²) | `[C]` |
| Master `A.6` presumptive, IS 1904:1986 Table 1, hard rock | **3240 kPa** | `[A]` |

The design groundwater table is at `-2.000` and the formation at `-6.800` — **4.8 m below it**, permanently submerged. **The soaked value is the applicable one.** Appendix B makes the same choice for the soils in its own remark: *“in submerged condition of soil”*.

The master's presumptive **3240 kPa** sits inside the *unsoaked* band and is **+65%** on the *soaked* one.

### 8.2 And it does not matter

Every bearing check in the master, re-run at the lowest soaked value:

| Check | Demand | / 3240 `[A]` | / 1961 soaked | Verdict |
|---|---|---|---|---|
| Mat, service — master `B.3` | 58.4 kPa | 1.80% | 2.98% | **PASS** |
| Mat, **blast** — master `B.3` | 404.9 kPa | 12.50% | 20.64% | **PASS** |
| Sentry footing F1 — master `B.8.7` | 157.6 kPa | 4.86% | 8.04% | **PASS** |

> **`SG-F3`.** The worst bearing utilisation in the whole project rises from **12.5 % to 20.6%** and everything still passes with a factor of **4.8** in hand. **Master `A.6` is not changed** — 3240 kPa is a presumptive value from IS 1904 and it is declared as one. What this section adds is that **the design is now known to survive the measured value too.**

A second check the report offers for free: even at the **broken** basalt value of 981 kPa — the horizon 5 m *above* the formation — the mat under full blast would be at **41%**. The bearing case is nowhere near governing anything.

### 8.3 The real foundation story: net pressure

The excavation removes ground before the structure replaces it. The report's profile lets that be quantified for the first time (calculation `G.5`, γ values `[A]`):

| | kPa |
|---|---|
| Overburden removed, 1.13 m soil at 19.5 kN/m³ | 22.10 |
| Overburden removed, 5.67 m basalt at 25.0 kN/m³ | 141.67 |
| **Total gross pressure removed at formation** | **163.77** |
| Replaced by, in service (master `B.3`) | 58.40 |
| **Net change in pressure at formation** | **-105.37** |

> **`SG-F4`.** **In service the structure is lighter than the ground it replaces, by about 105 kPa.** It is a fully compensated foundation and then some. This is the physical reason master `B.3` can write *“SETTLEMENT Negligible”* and mean it — and it is the same fact seen from the other side that makes **flotation**, not bearing or settlement, the governing foundation problem (FoS **0.33** at the mat-only stage). The report does not change either conclusion. It explains them.

## 9. Rockhead — and what it costs

> *“Basalt rock is encountered below this murrum / broken rock, below a depth 0.9 m to 1.5 m.”* — SEMT/67/15 para 12

| Location | Sound basalt below | On the project datum |
|---|---|---|
| G Building (TP-1 to TP-4) | 1.500 m | `(−)1.500` |
| H Building (TP-5 to TP-8) | 0.900 m | `(−)0.900` |
| Mess Bldg (TP-9 to TP-11) | 1.000 m | `(−)1.000` |
| **Report band** | | **`(−)0.900` to `(−)1.500`** `[C]` |
| **Master `A.6` assumed band** | | **`(−)1.500` to `(−)2.000`** `[A]` |

> **`SG-F5`. The two bands touch at exactly one point, `(−)1.500`.** The report's rock is at or **above** the master's whole assumed range. The master is therefore **conservative for founding depth** — the rock is there sooner than assumed — and **unconservative for excavation quantity**, because more of the cut is in rock and less is in soil.

Quantifying it. BOQ item `E-02b` at the mean rockhead, with its own stated range, fixes the excavation plan area:

| Rockhead | Depth of rock cut | Rock volume m³ | vs BOQ upper bound |
|---|---|---|---|
| `(−)0.900` | 5.900 m | 1161.12 | +118.12 |
| `(−)1.000` | 5.800 m | 1141.44 | +98.44 |
| `(−)1.500` | 5.300 m | 1043.04 | +0.04 |
| `(−)1.750` ← BOQ `E-02b` | 5.050 m | 993.84 | -49.16 |
| `(−)2.000` | 4.800 m | 944.64 | -98.36 |

| | |
|---|---|
| BOQ prices | **944.6 – 1043.0 m³** |
| On the report's band | **1043.0 – 1161.1 m³** |
| The report's **lower** bound equals the BOQ's **upper** bound | `(−)1.500` → 1043.0 m³ |
| Overrun at the report's shallow rockhead | **+118.1 m³** (**+11.3%**) |
| At the WBS `A2050` output of 60 m³/day | **≈ 2 extra days** |

**Total excavation does not change** — soil falls by the same volume as rock rises — so the money at stake is the **rate difference** over about 118 m³, not a rock rate over 118 m³.

**No BOQ quantity is changed here.** `WM2` adopted the project owner's own BOQ and it governs (master `H.13`), and risk `R-03` in the works management risk register already carries *“rock excavation quantity exceeds the estimate because rockhead is shallower than the mean assumed”*. What this section adds is **the number**: the register says *“roughly one extra day”*, and on the report's band it is about **2**.

One consequence is favourable and is recorded because it is free. Master `B.3` dismisses sliding on the grounds that the box is *“socketed ~4.8 m into basalt”*. On the report's band the socket is **5.3 m to 5.9 m**. The argument gets stronger.

## 10. Groundwater — the central question

> *“Water table was not encountered in any trial pit. However, water table may raise during/after rainy season.”* — SEMT/67/15 para 13 `[C]`

> P1 deck slide 29, verbatim: *“Water Table not encountered in any trial pit”* · *“Might increase during monsoon”* · **“Proposed structure safe for water table at depth of 2 m below GL”** `[C]`

### 10.1 The provenance of `(−)2.000`, recorded for the first time

Master `A.6` and `K.2 A2` record the design groundwater table as **`(−)2.000` `[ASSUMED]` — the single most important number to confirm** — and give **no source**. The source is now known, and it is this:

> **No water was found in any trial pit, so a depth of 2 m below ground level was *chosen*, and the structure was then designed to be safe for it.**

That is an assumption adopted in the absence of data. It is a defensible one — it puts the water table near the surface, which is the conservative direction for uplift and for lateral load. **It is not a measurement, and this section does not turn it into one.**

### 10.2 Three reasons the observation does not reach the design question

**(1) Depth.** The pits reached about 1.5 m. The design GWT is at `-2.000` — **already below the deepest pit** — and the founding horizon is at `-6.800`. A pit that stops at 1.5 m cannot find a water table at 2 m, let alone characterise one at 6.8 m. **Here, *“not encountered”* means *“not reached”*.**

**(2) Season.** The report itself says the table *“may raise during/after rainy season”*. The request is dated **20 May 2015**; if the field work followed promptly it was done in the last weeks before the monsoon — the annual minimum. **The report nowhere states the date of the field work**, so this is inference and is recorded as an open item, not as a finding. `[U]` `SG-V10`

**(3) Ground type.** Deccan Trap groundwater is not a simple water table in a porous medium. It sits in the vesicular and jointed zones **at the flow contacts** — the same feature master `A.6` names as the hazard and that the red-bole differential-support case in `B.3` is built around. Such water is commonly perched and strongly seasonal. **An open trial pit in the dry season is close to the worst available instrument for finding it.**

### 10.3 Why this is the number that matters

| From master `A.7.2` and `B.3` | |
|---|---|
| Of the **15.41 kPa/m** lateral gradient | **9.81 is water**, only 5.60 is soil |
| Hydrostatic uplift on the mat | **46.11 kPa = 6 289 kN over 136.4 m²** |
| Flotation FoS, mat cast only | **0.33 — FAIL** |
| Flotation FoS, box complete, no backfill | **1.22 — MARGINAL** |
| Flotation FoS, box complete, flooded to grade | **0.86 — FLOATS** |

> **`SG-F6`. `K.2 A2` stays `[ASSUMED]` and stays open — and the new evidence is a reason to keep it open, not to close it.** Water is nearly two thirds of the lateral load and the whole of the uplift. Everything this structure is afraid of is water.

### 10.4 What would actually close it — and a programme problem

The works management programme carries the right activity:

> `A1080` — **“Monsoon groundwater monitoring — confirm the design GWT (−)2.000”**, 20 days, **12-11-26 to 04-12-26**, total float 0, noted *“the single most important assumption in the project”*.

> ## `SG-F7` — that window is not in the monsoon.
> On the deck's own precipitation table, June to September carry **559.7 mm (74% of the year)**, while **November and December carry 28.6 mm between them**. An activity called *monsoon* groundwater monitoring scheduled **12 November to 4 December** measures the **recession, not the peak** — and the peak is exactly what `A2` asks for.
> 
> What closes `A2` is a **standpipe piezometer installed in the `A1075` borehole and read through a full monsoon**. Nothing shorter does. **No programme date is changed here**: the owner's own Master Construction Schedule R0 governs (master `H.13`) and `A1080` sits on the critical path at TF 0, so moving it moves the job. It is raised, with its reason and its cost, as **`SG-V3`** — a decision for the project owner.

## 11. Seismicity

| Source | Statement |
|---|---|
| SEMT/67/15 para 7 | *“Pune falls under Seismic Zone III as per IS 1893 of 1984. However, the earthquake activity in 1993 at Killari (Latur, Maharastra) should be kept in mind while designing the structure.”* |
| P1 deck slide 27 | **ZONE III**, design per **IS 1893:2016** |
| Master `A.7.8` | **Z = 0.16 (Zone III)**, IS 1893 (Part 1):2016 |

The report cites the **1984** zone map and the design uses the **2016** code. Pune is Zone III on both, and Z = 0.16 is read from IS 1893 (Part 1):2016 Table 3. Reproducing the master's two seismic coefficients from it:

| Structure | R | A_h = (Z/2)(I/R)(Sa/g) | Master | |
|---|---|---|---|---|
| Underground box | 4.0 | (0.16/2)(1.5/4.0)(2.5) = **0.0750** | 0.075 | **✔** |
| Sentry post | 3.0 | (0.16/2)(1.5/3.0)(2.5) = **0.1000** | 0.100 | **✔** |

> **`SG-F12`. Zone III is now corroborated by a document outside the project, and the master's seismic coefficients reproduce exactly from it.** This is the **only** master design input this section is able to corroborate externally. Nothing changes — and that is the point. It was already right.

The two documents name **different** 1993 events — the report names Killari (Latur), the deck names the Koyna area on 28 August 1993. Both are recorded as they stand; neither changes the zone, which is what the design uses, and this section does not adjudicate seismology. The deck's three regional events (M 4.8, 3.2, 2.6) are all well below the Zone III design basis and are recorded as context.

## 12. Meteorology

The full monthly table is in `Schedules/METEOROLOGICAL_SCHEDULE.md`.

### 12.1 Rainfall — the two documents disagree

| Source | Annual rainfall | Class |
|---|---|---|
| P1 deck slide 25, summed | **759.6 mm** | `[C]` |
| SEMT/67/15 para 9 | **500 – 600 mm** | `[C]` |
| Difference | **+27% to +52%** | `[U]` |

> **`SG-F11`. The two supplied documents disagree on annual rainfall by between a quarter and a half.** Neither names a station, a period of record or a source: the deck says *“last 10 years avg”* and the report says *“the region”*.

**No third figure is adopted here.** Published tertiary figures for “Pune” themselves range from about 720 mm to over 1 000 mm depending on which gauge and which period is quoted — which is the reason a **named station and period** is required, and the reason substituting a web figure for the deck's would be putting false authority on the design report. `SG-V5`

**One month is the outlier.** Read as a monsoon distribution for the interior Deccan:

| | |
|---|---|
| June to September | **559.7 mm**, 74% of the year |
| **October alone** | **139.8 mm**, 18% of the year |
| October ÷ September | **1.04** |
| October ÷ August | **1.16** |

The south-west monsoon withdraws from interior Maharashtra in the first half of October. An October that nearly equals September **and exceeds August** is not the shape of a Deccan rainfall year. **The October figure is the one to go back and check** — and note that removing it alone would bring the deck's total to **619.8 mm**, still above the report's range. **It is not corrected here**: correcting a datum whose source is unknown would be inventing evidence. `SG-V5`

### 12.2 And the part that matters most — nothing in the design uses the annual total

| What the design actually uses | Status |
|---|---|
| **50 mm/h design intensity**, Rev F drawing 5 note 1 — the only rainfall intensity anywhere in the project, with **no return period, duration or IDF source** | drainage open item **`DR-D1`**, **NOT closed by this section** — a monthly total cannot produce a short-duration intensity |
| **Soak-pit absorption 20 L/m²/day** | `K.2 A7` — needs the IS 2470 (Pt 2) Cl. 4 **percolation test** and nothing else. The report's basalt makes failure likely, which the master already says |
| **The monsoon window** | a **programme** input — `SG-F7` above |

So the rainfall conflict **changes no number in this project**. It changes what the design report may claim, and it changes when the groundwater monitoring has to happen.

### 12.3 Temperature — not a conflict, and a gap narrowed

| Source | Statistic | Values |
|---|---|---|
| SEMT/67/15 para 8 | **absolute extremes** | summer 40 / 12 °C · winter 26 / 4 °C |
| P1 deck slide 26 | **monthly means** | hottest Apr 38.3 °C mean daily max · coldest Jan 11.6 °C mean daily min |

A monthly mean daily maximum of 38.3 °C sitting under an absolute maximum of 40 °C is exactly what one expects. **These are different statistics and they are mutually consistent.**

HVAC calculation `H.10` records *“outdoor design dry-bulb / wet-bulb, Pune … NOT IN THE PROJECT `[N]`”* as the **first of eight missing inputs** that stop a cooling load being computed. This section **narrows that gap and does not close it**: an absolute extreme and a monthly mean are not a design dry-bulb, and **neither document gives a wet-bulb or any coincident value at all**. The remaining seven inputs are untouched, and `EL-V6` — *no cooling plant exists anywhere in the project* — is untouched.

### 12.4 Wind — a warning, because this one invites a wrong “correction”

| | |
|---|---|
| Deck slide 24, windiest month | June **6.6 km/h** = 1.83 m/s |
| Master `A.7.8` design basic wind speed | **39 m/s** |
| Ratio | **21.3 : 1** |

> **These are not the same quantity and the ratio is not an error.** The deck plots a **monthly mean speed**. IS 875 (Part 3):2015 `V_b` is a **3-second gust at 10 m with a 50-year return period**. A mean of 1.8 m/s and a 50-year gust of 39 m/s are entirely compatible. **Master `A.7.8` is not to be reduced on the strength of slide 24** — and in any case seismic governs the sentry post **2.4 : 1**, so the wind case decides nothing.

## 13. The soil parameters in master `A.6`, checked against measured data

Appendix B gives compaction and shear results for the **murrum** — the material the engineered fill, the side backfill and the berm will actually be built from. Master `A.6` and `A.7.3` have carried round numbers for these since Rev D with no measurement behind either. The full arithmetic is in calculation `G.8`.

### 13.1 Unit weight

| | |
|---|---|
| Measured, 95 % MDD at OMC, three murrum samples | **19.12 – 19.61 kN/m³** `[D]` |
| Master `A.6` / `A.7.3` bulk | **20.00 kN/m³** `[A]` — **2–5 % high**, i.e. conservative for lateral load |
| γ_sat back-figured from the measured MDD, G_s = 2.75 `[A]` | **21.26 kN/m³** `[R]` |
| Master `A.6` γ_sat | **21.00 kN/m³** — agrees within **1.2 %** |

Applied to the **engineered cover**, whose total is held at **40.65 kPa** by `RC1` / `C17`:

| Case | Six-layer sum | vs the held 40.65 |
|---|---|---|
| As placed, at the **lowest** measured γ | **38.49 kPa** | −2.16 (the declared allowance grows from 1.50 to 2.16) |
| As tabulated in `A.7.3` | 39.15 kPa | −1.50 (the `C17` allowance) |
| **Fully saturated**, all three soil-like layers `[A]` | **41.07 kPa** | **+0.42**, which is **+0.09 % of COMB 103** |

> **`SG-F8`. The held value of 40.65 kPa brackets both the as-placed case (lighter) and the fully saturated case (heavier by about 1 %, which is one tenth of one percent of COMB 103).** `C17`'s declared allowance turns out to be doing real work. **Nothing changes**: 40.65 stands, COMB 103 stays **448.15 kPa**, no `.std` file is touched.

### 13.2 Shear strength and K₀

| Sample | Class | c kg/cm² | φ | 1 − sin φ | vs the assumed 0.50 |
|---|---|---|---|---|---|
| 45/15 | `GM` | 0.00 | 33° | **0.4554** | -0.0446 |
| 62/15 | `GM` | 0.00 | 34° | **0.4408** | -0.0592 |
| 64/15 | `SC` | 0.01 | 27° | **0.5460** | +0.0460 |
| 65/15 | `GP` | 0.00 | 35° | **0.4264** | -0.0736 |

Three granular murrum samples give K₀ **0.426 – 0.455**: the assumed **0.50 is conservative against all three**. One clayey sand (`SC`, TP-9, a 0.2 m surface layer) gives 0.546. Carrying even that value to full depth — which no reading of the profile supports — moves the wall pressure at the floor from **83.18 to 87.11 kPa**, and against the 383 kPa blast on the same face that is **+0.84 % on the total**.

> **`SG-F9`. The measured shear parameters move the wall design load by under 1 %.** The walls are blast-governed. `A.6`'s K₀ = 0.50 is not changed, and the report gives no reason to change it.

### 13.3 A limit on all of the above, stated plainly

On the report's own rockhead band the box occupies `(−)2.000` to `(−)6.800` and is therefore **entirely within basalt**. What bears on the buried walls is rock and the 300 lean-concrete annulus, **not soil**. The master's *K₀ soil plus full hydrostatic* model is a conservative idealisation of that, and it is right to keep the whole hydrostatic term, because water pressure in a jointed rock mass is real and is two thirds of the load. **The measured soil parameters are the right check on the berm, the backfill and the cover. They are not a description of what the buried walls retain.**

## 14. The black cotton soil — where it is harmless, and two places it is not

| Property | Measured |
|---|---|
| Depth | **0.18 – 1.0 m** |
| Liquid limit | 61 – 63 % |
| Plastic limit | 29 – 30 % |
| Plasticity index | 32 – 33 % `[R]` |
| **Free swell index** | **60 – 65 %** |
| IS 1498 classification | **CH** |
| SBC | 0.25 – 0.27 kg/cm² = **24.5 – 26.5 kPa** |

A free swell index above 50 % is the top band of the IS 1498 scale — **very high swelling potential**. Deck slide 30 puts it in plain words: the soil *“contracts and produce cracks in dry season, 10 to 15 cm wide extending to maximum depth of 1 m”* and is *“Not suitable for foundation”*.

### 14.1 Where it is harmless — which is most of the project

**Nothing structural founds in it.** The mat is at `(−)6.700` and sentry footing F1 at `(−)2.000`, both in basalt, both far below the 0.18–1.0 m black cotton horizon. Master `B.8.7`'s insistence that F1 bears *“on IN-SITU ROCK, never on backfill”* — and the decision to put the sentry post **≥ 10 m clear of the shelter excavation** — are now backed by a measurement. **No action.**

### 14.2 `SG-F13` — the covered entry stairwell's stepped raft

Master `A.4.7`: *“Stepped RC raft 300 thk **on compacted fill**”*, stepping from the top landing at `0.000` down to the platform at `(−)2.000`. With 300 of raft, **its top founds at about `(−)0.300` — inside the black cotton horizon at two of the report's three locations.**

*“On compacted fill”* implies the black cotton is stripped and replaced, but **no specification anywhere says so**, **no strip-and-replace item exists in the BOQ**, and a very-high-swelling CH clay under a stepped raft is a **heave** problem, not a bearing one — the SBC of 24.5 kPa is irrelevant; the 60–65 % free swell is not.

The stairwell is declared **expendable** against blast (master `B.6`, Rev F drawing note 8) — but **heave is a service-life problem, not a blast one, and this stair is the only primary access to the shelter**. `SG-V6`

### 14.3 `SG-F14` — the concealment layer

Master `A.7.3` puts **300 of topsoil / turf** at the top of the cover, and `CAM2` makes it *the concealment layer*, **“re-laid from the site's own stockpile.”** If the site's own topsoil is this CH clay at FSI 60–65 %, then the concealment layer is a very-high-swelling clay 300 mm thick:

- it **cracks in the dry season**, and a cracked, patchy turf is a **concealment defect** — which is `CAM2`'s entire subject;
- the cracks are a **direct infiltration path** into the 150 granular filter immediately below it;
- wetting and drying cycles **pump clay fines into that filter**, which is the one thing the filter exists to stop (`A.7.3`: *“Stops fines clogging”*).

**The load is unaffected** — 300 at 18 kN/m³ = 5.40 kPa is right for a black cotton soil — so **no calculation moves**. What is missing is a **specification**: either qualify the stockpiled topsoil against a swell limit, or import a non-expansive topsoil and price it. Neither exists. `BS1`'s 1:50 crossfall on the burster slab still works and is unaffected; it is the filter above it that would see more water and more fines than assumed. `SG-V7`

## 15. The P1 deck against its own cited source

Deck slides 29 and 30 both carry the source line *“Source : SEMT wing, CME”*. **Three of their statements are not in that report.** They are listed because the deck is a **presented** document and the same claims will be presented again unless they are corrected at source. **None of them affects the design**, because the design does not use any of them.

| Deck statement | What the report actually says | Effect on the design |
|---|---|---|
| *“Safe Bearing Capacity = 300 kN/m² at 1.5 m depth from Top”* | 300 kPa = 3.06 kg/cm², which is **not any value in the report**. At 1.5 m it gives CH clay 26.5, murrum 418.7, broken rock 981, sound basalt 1961 soaked / 3236 unsoaked kPa | **None.** It is 6.5× below the lowest rock value at that depth — conservative — and master `A.6` uses the IS 1904 presumptive 3240 kPa instead |
| *“Murrum … SBC of 25 – 30 kg/cm²”* | the report's murrum SBCs are **2.07, 4.27, 4.66 and 5.18 kg/cm²**. 25–30 is the **sound basalt unsoaked** band | **None.** But it assigns **rock** strength to **soil**, about 5–6× high |
| *“Compressive strength ranging from 609 – 900 kg/cm² in unsoaked condition”* | Appendix C's unsoaked results are **[752, 814, 900]** — a range of **752 to 900**. **609 appears nowhere in the report** | **None.** The upper bound is right |

Two deck statements are **right and important**:

- *“Ultimate Bearing Capacity = S.B.C × 2.5”* — this is Appendix B's own relationship read backwards, with the report's stated factor of safety. **Correct.**
- *“Proposed structure safe for water table at depth of 2 m below GL”* — **true, and now traceable**. It is the provenance of `(−)2.000`. See §10.

`SG-V8`

## 16. Findings

| Ref | Finding |
|---|---|
| `SG-F1` | The SEMT report reproduces completely from its own inputs — soil, rock strength and rock bearing. **It is usable.** |
| `SG-F2` | **THE INVESTIGATION REACHED ABOUT 1.5 m; THE STRUCTURE FOUNDS AT 6.8 m.** 5.3 m of unlogged ground under the whole structure. **The governing finding.** |
| `SG-F3` | The presumptive SBC is 65 % above the measured *soaked* value — and no element cares. Worst utilisation 12.5 % → 20.6 %. |
| `SG-F4` | In service the structure is **lighter than the ground it replaces**, by ≈ 105 kPa. Settlement was never the problem; flotation always was. |
| `SG-F5` | The report's rockhead band (0.9–1.5 m) is **entirely at or above** the master's assumed band (1.5–2.0 m). +118 m³ of rock, ≈ 2 days. |
| `SG-F6` | *“No water table”* means **“not reached”**. `K.2 A2` stays `[ASSUMED]` and stays open — the provenance of `(−)2.000` is now recorded, its verification is not. |
| `SG-F7` | **The monsoon groundwater monitoring is programmed outside the monsoon** (12 Nov – 4 Dec), on the critical path. |
| `SG-F8` | The held cover value of 40.65 kPa **brackets both** the as-placed and the fully saturated case. `C17`'s declared allowance is doing real work. |
| `SG-F9` | Measured shear parameters move the wall design load by **under 1 %**. The walls are blast-governed. |
| `SG-F10` | The deck's contour map and its elevation profile disagree by **12–16 m** in level and ≈ 4× in gradient. |
| `SG-F11` | The two supplied documents disagree on annual rainfall by **27 – 52 %**. October is the outlier. |
| `SG-F12` | **Seismic Zone III is externally corroborated** and the master's A_h values reproduce exactly. The only master input this section can corroborate. |
| `SG-F13` | The **entry stairwell's stepped raft founds in very-high-swelling CH clay** with no strip-and-replace specification anywhere. |
| `SG-F14` | **The concealment layer may be a very-high-swelling CH clay** re-laid from the site's own stockpile, over the filter it would clog. |

## 17. Open items — `SG-V1` to `SG-V10`

**None of these is resolved, and that is deliberate.** Each needs something this project does not contain.

| Ref | Item | What would close it |
|---|---|---|
| `SG-V1` | **The geotechnical data is off-site.** The trial pits are at the G, H and Mess buildings. **No investigation has ever been made on the project plot.** | Locate WBS `A1075` **on this plot** |
| `SG-V2` | **Depth of investigation.** ≈ 1.5 m against a formation at `(−)6.800` and a sump base at `(−)8.000`. | Boreholes with core recovery and RQD to well below `(−)6.800`, logging **every flow contact and red-bole seam**, with packer permeability at the contacts |
| `SG-V3` | **The monsoon GWT monitoring window is not in the monsoon** (12-11-26 → 04-12-26, TF 0). | A project-owner decision: a standpipe piezometer in the `A1075` borehole read through a **full monsoon**, and the programme consequence accepted |
| `SG-V4` | **Site level and fall.** The contour map and the elevation profile disagree by 12–16 m; nothing ties either to the project datum. | A levelled **benchmark on the plot** and a spot-level survey; then the cut-and-fill, berm toe and `BS1` daylight point can be drawn |
| `SG-V5` | **Annual rainfall.** 759.6 mm against 500–600 mm; the **October figure** does not fit a Deccan year. | A **named IMD station and period of record** — and separately, an IDF source for the 50 mm/h intensity (`DR-D1`) |
| `SG-V6` | **The entry stairwell raft founds in black cotton soil.** No strip-and-replace specification or BOQ item. | A specification for stripping and replacing the CH horizon under the stepped raft, and the quantity priced |
| `SG-V7` | **The 300 concealment turf may be very-high-swelling CH clay** re-laid from the site's own stockpile. | A swell limit on the stockpiled topsoil, or imported non-expansive topsoil, priced — a `CAM2` coordination decision |
| `SG-V8` | **Three P1 deck statements are not in the report they cite** (SBC 300 kN/m², murrum SBC 25–30 kg/cm², UCS 609–900 kg/cm²). | Correct them at source before the next presentation. **No design value is affected** |
| `SG-V9` | **The project has no coordinates.** The owner's Google Maps pin could not be resolved in this session (egress 403). | The latitude and longitude, supplied directly |
| `SG-V10` | **The date of the SEMT field work is not stated**, so the season in which *“no water table”* was observed cannot be established. | The field-work dates from the SEMT wing, or acceptance that the observation is season-unknown |

## 18. What this section changed, and what it did not

**Changed:** nothing in the design.

| | |
|---|---|
| Design values in Parts A, B, D, F, L | **untouched** |
| Loads, thicknesses, bars, levels | **untouched** |
| `.std` models | **untouched — and STAAD.Pro was not run** |
| Existing DXF, schedules, calculations | **untouched** |
| BOQ quantities, rates, dates, floats | **untouched** — `WM2` adopted the owner's own documents and they govern |
| **The main staircase** | **untouched — frozen, 24R @ 170.8333 / 280, 3 flights × 8, total rise 4100** |
| Any `[ASSUMED]` tag | **not one converted, downgraded or deleted** |

**Added:** this section, five schedules, a calculation printout, three A1 drawings, a QA/QC report, and — in the master — Part `H.22`, provenance notes against `A.6` and `K.2`, ten new open items in `K.1b`, and the manifest entries.

### 18.1 What this section is still not

- It is **not a site investigation report**. It is a reading of somebody else's, for other buildings, that stopped 5.3 m above the founding horizon.
- It is **not a site plan**. Master gap **D3 stays open**: no boundary, no dimension, no benchmark, no coordinate.
- It **does not close `DR-D1`**, `EL-V4`, `EL-V6`, `CAM-V2`, or any `K.2` assumption.
- It is **not construction-ready**, and neither is the confirmatory investigation it calls for — that is `A1075` and `A1080` on the programme, both on the critical path, both still to happen.

---

## 19. References

| Code / document | Used for |
|---|---|
| **IS 1498:1970** | Classification and identification of soils — CH, GM, GP, SC, free swell index |
| **IS 2720** Pts IV, VIII, X, XIII, XL | Classification, compaction, UCS, direct shear, free swell — the report's own test methods |
| **IS 1121 (Pt I)** | Compressive strength of rock |
| **IS 12070:1987** | Design and construction of shallow foundations on rocks — Cl. 6 bearing, Table 2 broken bedrock |
| **IS 1904:1986** | Presumptive bearing capacity, Table 1, hard rock 3240 kPa — the master's `A.6` value |
| **IS 1893 (Part 1):2016** | Seismic zone and Z; the report cites the **1984** map |
| **IS 875 (Part 3):2015** | Basic wind speed — §12.4 |
| **IS 2470 (Part 2):1985** Cl. 4 | Percolation test — still mandatory, `K.2 A7` |
| **IS 2720 (Part 28)** | In-situ density testing of backfill, WBS `A7015` |
| **SEMT/67/15** | The sub-soil investigation itself |
| **P1 presentation deck** | Site selection, setting and meteorology |

---

*Site Selection and Geotechnical package, revision **SG1**, 11.09.2026. Compiled from the two supplied documents and the master project state. Every value is tagged. Nothing in this document was invented, and nothing that was assumed has been made confirmed.*
