yatineode128-hue/underground-shelter-project/Drainage/Documentation/DRAINAGE_DESIGN_BASIS.md

# DRAINAGE DESIGN BASIS

**Underground CBRN-hardened blast-resistant protective structure — Pune, Maharashtra**
Package **DRAINAGE**, revision **DR1** · 5 September 2026 · geometry **Rev F + M1**
Status: **DEVELOPED FOR PROJECT COORDINATION — PENDING ENGINEERING VERIFICATION**

**Sentry post is excluded from this package.** No sentry post drainage is designed, drawn,
scheduled or quantified here. Historical sentry post information elsewhere in the project is
untouched.

---
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
