yatineode128-hue/underground-shelter-project/WORKS MANAGEMENT/Documentation/WM_PROJECT_COMPONENT_REGISTER.md

<!-- GENERATED by WORKS MANAGEMENT/Scripts/wm_docs.py.  Edit the source
     data in wm_data.py / wm_content.py and re-run wm_build_all.py. -->

# PROJECT COMPONENT REGISTER
## Underground CBRN-hardened blast-resistant protective structure and sentry post — Pune, Maharashtra

**Works Management package revision WM1** · 07 September 2026
**Geometry:** Architectural Rev F · Structural Phase 2 Rev A + M1 · **Services:** Drainage DR1 · HVAC HV1 · Schedule of Finishes FN1 · Structural CAD SC1
**Evidence classes:** `[C]` confirmed · `[D]` derived here · `[A]` assumed by this package ·
`[U]` unresolved · `[N]` not available — data required

> **THE ONLY DESIGN CHANGE in this package is reference SP-B1: the sentry post walls
> are BRICK MASONRY, replacing the Rev F 200 mm RC ballistic infill panels.
> No other element of the project is changed.**

> **AMENDED 10 September 2026 for design revision SP-B2** (master **A.4.8**, Part
> **H.12**), which designs the **lintel L1** and the **wall tie detail** that SP-B1
> created a need for and this package recorded as not existing. **WM-V5 and WM-V11 are
> closed by it.** The amendment is to the WRITTEN RECORD ONLY — the lintel and tie
> paragraphs, the risk entry, the verification register and the gap list now state the
> designed values instead of saying no design exists. **NO QUANTITY, RATE, DURATION,
> DATE, FLOAT OR RESOURCE IN THIS PACKAGE CHANGED**, and bill item `SP-06` still
> measures the superseded provisional 200 × 150 lintel section: see
> `Documentation/WM_RECONCILIATION_REGISTER.md` §6. **WM-V3, WM-V6 and WM-V7 remain
> open.**

---

Before a work breakdown structure can be written, the components that make up the
finished project have to be identified from the project record — not assumed.

This register lists every component the current project documentation actually
establishes. A component is included only where the master project state file, the
Rev F drawings or an existing discipline package confirms it. Where the project
does not support a component, it is not invented, and the second table records the
items in the supplied R0 schedule that were removed for exactly that reason.

**Twenty-three components are confirmed. All twenty-three are covered by the Works
Management package.**

---

## Confirmed components

| Ref | Component | Description | Source | Class |
|---|---|---|---|---|
| `PC-01` | **Main underground box — mat foundation** | 600 thk M35 mat on 100 M15 blinding, u/s (-)6.700, on in-situ Deccan basalt. T16 @ 150 EF EW with a T12 @ 250 x 250 link grid. 84 % utilised — the most highly worked foundation element. | master A.4.2, B.3, F.1 | `[C]` |
| `PC-02` | **Main underground box — perimeter walls W1–W4** | 600 thk M35, 3.200 clear height, T16 @ 150 EF EW with T12 closed links @ 200. Designed for 383 kPa blast on the walls as well as the roof (K_a = 1.0) plus a 15.41 kPa/m earth-and-water gradient. | master A.4.2, B.1, F.1 | `[C]` |
| `PC-03` | **Main underground box — protective walls W6 and W7** | 400 thk M35 at X 14800–15200 and 18000–18400. These two walls, with the mat, the perimeter walls, the pressure slab and blast doors 1 and 2, ARE the protective boundary. T20 @ 150 EF EW, T12 4L @ 200. | master A.3, B.2, F.1 | `[C]` |
| `PC-04` | **Main underground box — wall W5 and partitions W8** | W5 200 thk at X 12600–12800, fire and gas-tight only, no pressure differential. Four W8 partitions at 110 thk with A252 mesh both faces, each with a 900 door gap at Y 2500–3400. Non-structural. | master A.3, F.1 | `[C]` |
| `PC-05` | **Main underground box — pressure (roof) slab** | 900 thk M35, top (-)2.000, soffit (-)2.900, spanning ONE WAY across the 5.000 internal width. T25 @ 150 EF EW. Total design load 448.15 kPa under COMB 103. THE GOVERNING ELEMENT of the whole structure. | master A.4.2, A.7.4, B.4, F.1 | `[C]` |
| `PC-06` | **Roof openings — stair void and escape shafts** | Stair void 2800 x 3160 at X 15200–18000, Y 600–3760; two 1400 dia escape openings. Slab locally thickened 900 to 1200 with 6-T25 and 5-T25 trimmer bands and 4-T25 diagonal bars at the re-entrant corners. | master A.4.4, A.4.5, B.4.1, F.1 | `[C]` |
| `PC-07` | **Sump pit SU-01** | 1500 x 1500 x 1500 clear, invert (-)7.600, base slab (-)8.000, walls 300 and base 400, cast monolithic with the mat with the membrane dressed around the pit. Conflict C18 is CLOSED - RULED AT 400 by RC1, master K.1 U10: (-)8.000 - (-)7.600 = 0.400 is arithmetic, and F.1 says 400 too. | master F.1, Drainage DR1 | `[C]/[U]` |
| `PC-08` | **Escape shafts ESC 1 and ESC 2** | 1400 dia clear, 250 RC collar, OD 1900. ESC 1 at (2050, 2050) with its head at +0.150; ESC 2 at (19900, 2050) with its head at +0.700. The 750 clearance rule means a bay must be at least 2900 wide to hold one. | master A.4.5 | `[C]` |
| `PC-09` | **Blast doors 1 and 2** | 1200 x 2100, 7 bar, gas-tight, rebound rated, in W6 and W7 at Y 600–1800, level (-)6.100. Vendor item. The cast-in frame is welded to the reinforcement cage for EMP continuity. Jambs 4-T20 each face; header 400 x 1100 with 4-T20 top and bottom. | master A.2, F.1 | `[C]/[N]` |
| `PC-10` | **Main staircase — FROZEN** | Bay 7. 24 risers at 170.8333, tread 280, three flights of eight, total rise 4100, flights 1200 wide, waist 200, headroom 2533. Inside the protective envelope but NOT a blast element — designed to IS 456 with normal partial factors. Geometry is frozen and is not touched by this package. | master A.4.4, B.5; frozen by project instruction | `[C]` |
| `PC-11` | **Entry headhouse** | External 4800 x 5800 sitting on the pressure slab; walls 400, roof 500, top +0.900, NO earth cover. HW3 has no wall beneath it and loads the pressure slab as a line load. Walls designed for 383 kPa on either face (conflict C10). Roof at 90 % utilisation. | master A.4.6, B.7, F.3 | `[C]` |
| `PC-12` | **Covered entry stairwell** | External 6800 x 2000, walls 250, 12 risers at 166.6667 with 300 going, waist 250, platform 1500 x 1500 at (-)2.000, stepped raft 300 with a MOVEMENT JOINT at the headhouse. Outside the protective boundary and DECLARED EXPENDABLE. | master A.4.7, B.6, F.2 | `[C]` |
| `PC-13` | **Engineered cover / overburden** | 2000 layered = 40.65 kPa in six layers: 100 protection screed, 750 compacted fill at 95 % MDD, 500 crushed basalt rubble, 200 M30 burster slab, 150 granular filter, 300 topsoil and turf. The second metre is bought entirely for prompt neutron and gamma attenuation. | master A.7.3 | `[C]` |
| `PC-14` | **Waterproofing system WP-01 to WP-06** | Continuous external tank on the blinding, up the walls and over the roof; 100 protection screed; integral crystalline admixture in the concrete; internal wet-area tanking; two waterstops at every construction joint; external-grade roofing to the headhouse and stairwell. | Schedule of Finishes FN1, R-805 | `[C]` |
| `PC-15` | **Drainage and sanitary installation** | Clean sump SU-01 with duty, standby AND hand pumps; segregated decontamination effluent to tank TK-01 (tanker only, never to the clean sump); stairwell sump SU-02; septic tank ST-01; soak pits SK-01 to SK-04; gullies, drains, chambers and the threshold channel. | Drainage DR1 | `[C]` |
| `PC-16` | **HVAC and CBRN plant** | Two 300 m³/h NBC filter trains in true N+1 (louvre, blast valve, G4/F7 pre-filter, H14 HEPA, ASZM-TEDA carbon, fan with hand crank); CO2 scrubber; oxygen store; dehumidifier; five blast valves; fresh-air shaft SH-1 and generator air shaft SH-2; generator GEN-1 15 kVA in bay 8. | HVAC HV1 | `[C]` |
| `PC-17` | **Electrical and EMP installation** | Supply, distribution, lighting, small power, emergency lighting, generator changeover, earthing to a 5 ohm target, EMP Zone 2 shielded enclosure in bay 3, EMP straps at every construction joint, and EMP protection at every service penetration. THE SCOPE IS CONFIRMED BUT NO ELECTRICAL DESIGN PACKAGE EXISTS — every quantity is [N]. | master A.3, G; MIL-STD-188-125-1 | `[C] scope / [N] design` |
| `PC-18` | **Internal finishes** | Thirteen spaces. Every finish is a PERFORMANCE REQUIREMENT — decontaminable, non-dusting, joint-free within a room, no suspended ceiling and no boxing-in anywhere in the gas-tight envelope. The product that satisfies each requirement is deliberately left open. | Schedule of Finishes FN1 | `[C] requirement / [N] product` |
| `PC-19` | **SENTRY POST — RC frame** | Separate two-storey RC framed building, at least 10 m clear of the shelter excavation, on its own footings on in-situ basalt at (-)2.000. F1 1500 x 1500 x 600 x 4; C1 350 x 350 x 4 both storeys; B1/B2 250 x 450; S1 150 two-way at both levels; PB 250 x 400 at +0.450; external spiral stair. M30 / Fe500, ductile detailing to IS 13920. NOT BLAST DESIGNED — a recorded decision. | master A.4.8, B.8, F.4 | `[C]` |
| `PC-20` | **SENTRY POST — BRICK MASONRY WALLS  (design change SP-B1)** | Infill walls between the columns, both storeys, 190 thk one-brick modular brickwork in CM 1:6 within the confirmed 200 structural zone. REPLACES the 200 RC ballistic infill panels of Rev F. Ground storey has door D1 900 and window W1 1200; first storey has eight armoured vision panels 1200 wide and door D1. Lintels are a NEW requirement created by this change. | SP-B1, this package; geometry from Rev F drawings 3, 4, 6 | `[C] instruction / [D] quantities` |
| `PC-21` | **External works, berm and site restoration** | Berm graded 1.5:1 to +0.900 against the headhouse and covered stairwell; site crowned with 1:50 falls away from the structure; surface water drainage; access route and hardstanding; removal of temporary works. NO SITE PLAN OR GROUND MODEL EXISTS, so extents are indicative. | master A.4.6, A.4.7; Drainage DR1 open item D3 | `[C] intent / [N] extent` |
| `PC-22` | **Camouflage and concealment** | The 300 topsoil and turf layer at the top of the engineered cover is the only concealment element the project confirms; its stated function is 'concealment, erosion, sheds rain'. Any further measure — spoil dressing, screening, track discipline, planting regime — is planned as work but has no specification in the project. | master A.7.3 | `[C] layer / [N] regime` |
| `PC-23` | **Testing, commissioning and handover** | Cube results, NDT, watertightness, drainage tests, electrical tests, earth resistance, EMP shielding effectiveness survey to IEEE Std 299, blast door functional and seal tests, escape shaft functional test, CBRN commissioning, gas-tightness and overpressure test, generator load test, integrated protective-mode commissioning, training and handover. | master G; this package | `[C]` |

---

## Components that do NOT exist in this project

The supplied R0 master construction schedule describes a different building in
several places. Each item below was removed from the Works Management scope because
the project record does not support it.

| Item in R0 | Why it is not in this project |
|---|---|
| **Lift / lift shaft** | The supplied R0 schedule contains 'Column, Staircase & Lift Shear Wall' activities. THERE IS NO LIFT ANYWHERE IN THIS PROJECT. Those activities are generic building boilerplate and have been removed. |
| **Second grade slab over 4 m of overburden** | The R0 schedule programmes a '2nd Slab (Ground Lvl) Grade Slab' over '4m Soil Overburdon'. The current design has a SINGLE 900 pressure slab at (-)2.000 under 2000 of layered engineered cover containing a 200 M30 burster slab. The 4 m arrangement is a superseded revision. |
| **1000 mm roof slab** | The R0 schedule calls the roof '1st Slab (1000 mm Thk)'. The confirmed thickness is 900. |
| **Structural RC columns in the shelter** | None exists. The box is a wall-and-slab structure; master B.3 declares punching shear NOT APPLICABLE for the same reason, and Structural CAD SC1 records that drawing a column sheet would be fabrication. |
| **Dado / wall tiling in the shelter** | The R0 schedule programmes wall tiles. The Schedule of Finishes states the opposite for the gas-tight envelope: 'NO joints, NO tiles, NO grout — grout lines are a decontamination failure'. Tiling is therefore not programmed inside the envelope. |
| **Suspended ceilings and gypsum punning in the shelter** | The R0 schedule programmes gypsum punning to ceilings. FN1 forbids any suspended ceiling or boxing-in in the gas-tight envelope for three confirmed reasons: duct inspectability, pipe inspectability and contamination trapping. |

---

## The three structures

The project is not one building. Master A.2 defines three separate structures, and
the Works Management package treats them as three, because they have different
design bases, different risk profiles and different places in the programme.

**1. The main underground box.** Buried RC shelter, eight bays, 22.0 × 6.2 m
external, roof 2.0 m below grade. Designed for a 344.7 kPa nuclear air-blast design
basis threat with a design pressure of 383 kPa on the roof **and** the walls. This
is the protected structure.

**2. The entry headhouse and covered approach stairwell.** Above-ground bermed RC
sitting on the shelter roof and on adjacent fill. The headhouse is designed for full
blast pressure on either face; **the covered stairwell is outside the protective
boundary and is declared expendable.**

**3. The sentry post.** A separate two-storey RC framed building at least 10 m clear
of the shelter excavation, on its own footings on in-situ rock. **Not blast
designed — a recorded decision.** Its walls are the subject of the only design
change in this package.

### The protective boundary

Master A.2 is explicit and the Works Management sequence depends on it:

> The protective boundary is **Blast Doors 1 and 2 at level (-)6.100, plus walls
> W6/W7, the perimeter walls, the mat and the pressure slab.** Everything above the
> blast doors — the stair shaft, the headhouse, the entry stairwell — is outside the
> boundary, and the entry stairwell is declared expendable.

That is why the blast door frames must be cast into W6 and W7, why there is no
movement joint anywhere inside the envelope, why every construction joint carries
two waterstops and a welded EMP strap, and why the gas-tightness test covers bays 1
to 6 only.

---

## Scope coverage check

| Requirement | Covered by | Where |
|---|---|---|
| Main underground shelter structure | `PC-01` to `PC-10` | WBS 3, 4 |
| Sentry post | `PC-19`, `PC-20` | WBS 8 |
| All associated structural works | `PC-11`, `PC-12` | WBS 5 |
| Access and egress | `PC-08` to `PC-12` | WBS 4.4, 5 |
| External works | `PC-21` | WBS 13 |
| Drainage | `PC-15` | WBS 10 |
| Waterproofing | `PC-14` | WBS 6 |
| Electrical works | `PC-17` | WBS 11 |
| Overburden and backfilling | `PC-13` | WBS 7 |
| Camouflage and concealment | `PC-22` | WBS 13.3 |
| Construction and completion activities | `PC-23` | WBS 1, 2, 14 |
