yatineode128-hue/underground-shelter-project/WORKS MANAGEMENT/Cost/WM4_Underground_Shelter_BOQ_Cost_Estimate_SSR_2022-23.xlsx

Sheet: Cover
BILL OF QUANTITIES AND DETAILED COST ESTIMATE
Underground CBRN-hardened blast-resistant protective structure and sentry post — Pune, Maharashtra
 | THE ESTIMATE
 | Package revision | Works Management WM4
 | Date | 15 September 2026
 | Supersedes | Nothing. WM1 (master H.10) measured this bill and carried NO rate; WM4 prices it. WM1, WM2 and WM3 are preserved unaltered alongside
 | Geometry | Architectural Rev F · Structural Phase 2 Rev A + M1
 | Quantities | WM1, unchanged. NOT ONE QUANTITY IS ALTERED BY THIS REVISION. Where a WM1 line is split to reach two different SSR items the parts sum back to the WM1 figure exactly — see the Verification sheet
 | RATE SOURCE
 | Schedule | Government of Maharashtra, Public Works Department — STATE SCHEDULE OF RATES 2022-23, approved by Government Circular RADASU-2022/PR.KR.12/NIYOJAN-3 dated 25 July 2022, effective 25 July 2022. Supplied by the project owner as "SSR 22-23 MH (1).pdf", 624 pages.
 | Rate basis | 'Completed Rate for 2022-23 excluding GST' — the SSR's own column. These rates ALREADY contain 10 % overheads, 10 % contractor's profit and 1 % labour cess, and every concrete item already contains its steel centering and formwork
 | Reinforcement | NOT in the concrete rates — SSR 26.33, measured on the weight fixed in position
 | WHAT THE BOTTOM LINE COVERS
 | Priced at a published SSR item | 53 lines Rs 13,823,328.00
 | Priced on a stated assumption [A] | 21 lines Rs 1,459,949.78
 | Included in another rate — not payable twice | 15 lines
 | NOT PRICED — no specification, or no SSR item | 25 lines
 | TOTAL OF ITEMS | Rs 15,283,277.78
 | ESTIMATED COST after recapitulation and GST | Rs 20,739,407.95
 | WHAT IS EXCLUDED FROM IT — READ THIS BEFORE USING THE FIGURE
 | Protective plant and closures | Blast doors, exit hatches, blast valves, the NBC collective protection trains, the EMP Zone 2 enclosure, the standby generator, sump pumps and commissioning have NO SSR ITEM and are NOT in the total. The owner's own bill prices them at about Rs 1.05 crore from vendor figures. See sheet 'Not priced'
 | Electrical and EMP installation | No electrical design package exists, so there is no quantity to price. Seven lines, all nil
 | Waterstops | 109.76 m measured. THE SSR HAS NO WATERSTOP ITEM anywhere in 624 pages
 | Flooring, window W1, spiral stair, berm, camouflage | No specification, or no quantity, exists in the project for any of them. No rate is invented
 | EVIDENCE DISCIPLINE
 | No invented rates | Every rate is either a published SSR item, or is derived from one by a method the SSR itself prescribes, with the arithmetic shown on the 'Rate derivation' sheet
 | No resolved assumptions | Every [A] and [N] tag carried by WM1 is carried forward. None is upgraded
 | Main staircase | UNTOUCHED — 24 risers, 170.8333 mm riser, 280 mm tread, 3 flights x 8, 4 100 mm total rise
 | Open items raised by this revision | WM4-V1, WM4-V2, WM4-V3, WM4-V4, WM4-V5, WM4-V6, WM4-V7 — see the 'Open items' sheet

Sheet: BOQ priced
BILL OF QUANTITIES — PRICED AT SSR 2022-23
Quantities are WM1's, unchanged. Amount = Quantity x Rate, as a formula in every row. Rates in blue are read from the SSR; rates in black are derived from a published SSR item by the schedule's own method.
Section / Item | Description | Unit | Quantity | SSR item | Rate (Rs) | Amount (Rs) | Status | Basis / note
A · SITE PREPARATION AND EARTHWORKS
E-01 | Site clearance and grubbing, shelter area | m2 | 618.800 | 21.33 | 7.00 |  | PRICED | Clearance only. The 150 topsoil strip is measured and priced at E-01a
E-01a | Topsoil stripped 150 thk and stockpiled for re-use in the concealment layer | m3 | 92.820 | 21.02 | 207.00 |  | PRICED | Excavation in soil, lift <= 1.5 m, mechanical. Stacking within 50 m is inside the SSR rate, which is exactly what stockpiling for re-use is
E-02 | Bulk excavation, main shelter, 0.000 to (-)6.800, all strata — SUM OF THE SIX DEPTH BANDS BELOW | m3 | 1338.240 | — |  |  | INCLUDED — not separately payable | Measured at E-02.1 to E-02.6. Plan area 196.80 m2 = 1338.24 / 6.800
E-02.1 | 0.000 to (-)1.500, soil / weathered overburden | m3 | 295.200 | 21.02 | 207.00 |  | PRICED | Lift <= 1.5 m. Reproduces the WM1 lower bound of 295.2 m3 exactly
E-02.2 | (-)1.500 to (-)1.750, soil to mean rockhead | m3 | 49.200 | 21.04 | 258.00 |  | PRICED | Lift 1.5 to 3.0 m. E-02.1 + E-02.2 = 344.4 m3 = WM1 item E-02a exactly
E-02.3 | (-)1.750 to (-)3.000, Deccan basalt | m3 | 246.000 | 21.20 | 1307.00 |  | PRICED | BY HYDRAULIC BREAKER, NOT BLASTING — WM_CONSTRUCTION_METHODOLOGY.md and risk S-02. SSR 21.20 is the schedule's non-blasting rock item; the three blasting items 21.17 / 21.18 / 21.19 do not apply to this project
E-02.4 | (-)3.000 to (-)4.500, Deccan basalt | m3 | 295.200 | 21.20 | 1568.40 |  | PRICED | SSR 21.20 + 20 % depth increase, General Notes Section B
E-02.5 | (-)4.500 to (-)6.000, Deccan basalt | m3 | 295.200 | 21.20 | 1699.10 |  | PRICED | SSR 21.20 + 30 % depth increase, General Notes Section B
E-02.6 | (-)6.000 to (-)6.800, Deccan basalt | m3 | 157.440 | 21.20 | 1699.10 |  | PRICED [A] — stated assumption | [A] BEYOND THE SSR's LAST DEFINED BAND. Priced at the 4.5-6.0 m band's +30 % as a declared LOWER BOUND. Section B leaves the percentage to the Superintending Engineer. OPEN ITEM WM4-V1
E-02a | of which excavation in soil / weathered overburden | m3 | 344.400 | — |  |  | INCLUDED — not separately payable | Memorandum. Priced at E-02.1 and E-02.2
E-02b | of which excavation in rock (Deccan basalt) | m3 | 993.840 | — |  |  | INCLUDED — not separately payable | Memorandum. Priced at E-02.3 to E-02.6
E-03 | Excavation in rock for sump pit SU-01, below general formation | m3 | 9.477 | 21.20 | 1699.10 |  | PRICED [A] — stated assumption | [A] Below (-)6.800, so beyond the SSR's last defined depth band. Same lower bound and the same open item as E-02.6 — WM4-V1
E-04 | Excavation for the covered entry stairwell, outside the box envelope, 0.000 to (-)2.000 | m3 | 19.096 | 21.04 | 258.00 |  | PRICED [A] — stated assumption | [A] Priced wholly as soil at the 1.5-3.0 m lift. The strata split is not derivable from the project record; SG1 puts a CH clay horizon here to 1.0 m. If basalt is met below the mean rockhead the 21.20 rate applies to that part
E-05.1 | Excavation, sentry post footings F1, 4 No.: 0.000 to (-)1.500, soil | m3 | 26.460 | 21.02 | 207.00 |  | PRICED | Pits 2.100 sq (0.300 working space) x 2.100 deep — wm_quantities.py 1.6
E-05.2 | (-)1.500 to (-)1.750, soil | m3 | 4.410 | 21.04 | 258.00 |  | PRICED | Lift 1.5 to 3.0 m
E-05.3 | (-)1.750 to (-)2.100, Deccan basalt | m3 | 6.174 | 21.20 | 1307.00 |  | PRICED | F1 founds on in-situ basalt at (-)2.000. Depth under 3.0 m: no increase. E-05.1 + E-05.2 + E-05.3 = 37.044 m3 = WM1 item E-05 exactly
E-06 | Filling in compacted granular fill under the sentry post ground floor | m3 | 7.452 | 21.37 | 599.00 |  | PRICED | Contractor's material, 15-20 cm layers, watered and compacted
E-07 | Side backfill in selected granular fill, 250 layers to 95 % MDD | m3 | 289.920 | 21.37 | 599.00 |  | PRICED | SSR layers are 15-20 cm against the specified 250 — the specification is TIGHTER than the schedule, so the SSR rate is not understated on that count
E-08 | Surplus excavated material — re-use on site as engineered fill / crushed rubble, remainder to spoil | m3 | 1113.937 | — |  |  | INCLUDED — not separately payable | INCLUDED. Every SSR excavation item already carries removal to 50 m beyond the building area and stacking as directed. Lead beyond 50 m is payable under SSR Statement C-1 transportation charges and CANNOT be quantified — no site plan and no spoil destination exists (Drainage D3)
E-09 | Preconstructional antitermite treatment to the bottom surface and sides of the excavation, IS 6313 Part II | m2 |  | 21.22 | 107.00 |  | NOT PRICED | NOT IN THE WM1 BILL and no quantity exists. Listed because the owner's own RC1 bill carries a 320 m2 anti-termite line and the SSR has an item for it. Rate shown for information; NOT in the total
 | SUB-TOTAL — A
B · MAIN UNDERGROUND SHELTER — CONCRETE
C-01 | Mat 600 (M35) | m3 | 81.800 | 25.17 | 7562.00 |  | PRICED | SSR 25.17 names raft foundations explicitly. Formwork IS IN THE RATE
C-02 | Pressure slab 900, net of openings (M35) | m3 | 112.000 | 25.76 | 14391.00 |  | PRICED | R.C.C. slabs and landings, M-35
C-03 | Perimeter walls 600 (M35) | m3 | 103.700 | 26.19 der. | 16024.97 |  | PRICED | R.C.C. pardi (wall) of required thickness, grade-uplifted M25 -> M35 by the SSR's own cement-consumption rule
C-04 | Walls W6 / W7 400 (M35) | m3 | 12.800 | 26.19 der. | 16024.97 |  | PRICED | As C-03
C-05 | Wall W5 200 (M35) | m3 | 3.200 | 26.19 der. | 16024.97 |  | PRICED | As C-03
C-06.1 | Headhouse walls 400 (M35) | m3 | 18.800 | 26.19 der. | 16024.97 |  | PRICED | WM1 item C-06 is walls + roof at 32.7 m3. Split pro rata from its own derivation: walls (4.800 x 5.800 - 4.000 x 5.000) x 2.400 = 18.816, roof 4.800 x 5.800 x 0.500 = 13.920, total 32.736. No quantity is changed
C-06.2 | Headhouse roof 500 (M35) | m3 | 13.900 | 25.76 | 14391.00 |  | PRICED | Same split as C-06.1
C-07 | Main staircase, waist and landings (M35) | m3 | 3.000 | 26.26 der. | 12518.97 |  | PRICED | R.C.C. waist slab and steps of staircases, grade-uplifted M25 -> M35. THE STAIRCASE GEOMETRY IS FROZEN AND IS NOT TOUCHED — 24 risers, 170.8333 riser, 280 tread, 3 flights x 8, 4 100 total rise
C-08 | Entry stairwell: walls, roof, raft, flight, landings (M35) | m3 | 19.900 | 26.19 der. | 16024.97 |  | PRICED [A] — stated assumption | [A] A composite accepted whole from SC1 — no volume split by member exists. Priced entirely at the WALL rate, which is the DEAREST of the M-35 family, so the line cannot be understated by the choice. 83.0 of the 110.9 m2 of its formwork is wall face, so walls do govern
C-09 | Blinding / PCC M15, 100 thk under the mat | m3 | 14.208 | 24.04 | 6359.00 |  | PRICED | M15 for foundation and bedding
C-10 | Blinding / PCC M15, 100 thk, sump pit, footings F1 and stairwell raft | m3 | 3.045 | 24.04 | 6359.00 |  | PRICED | As C-09
C-11 | Sump pit SU-01 walls 300 and base 400 below the mat soffit (M35) | m3 | 3.708 | 26.19 der. | 16024.97 |  | PRICED [A] — stated assumption | [A] Walls and base measured together in WM1. Priced at the wall rate throughout — the dearer of the two applicable rates
C-12 | Escape shaft collars ESC 1 and ESC 2, 250 RC, OD 1900 (M35) | m3 | 6.285 | 26.19 der. | 16024.97 |  | PRICED | Circular 250 walls. The SSR has no curved-formwork item; 26.19 is 'of required thickness' and is the closest published item
C-13 | Local thickenings of the pressure slab 900 -> 1200 at openings (M35) | m3 | 3.331 | 25.76 | 14391.00 |  | PRICED | Slab work
C-14 | Internal partitions W8, 4 No., 110 thk, non-structural (M35) | m3 | 6.208 | 26.19 der. | 16024.97 |  | PRICED [A] — stated assumption | [A] W8 is non-structural with A252 mesh both faces; the project states NO GRADE and WM1 measured it as M35 with the rest of the box (tagged [A] there). That tag is carried, not resolved
 | SUB-TOTAL — B
C · REINFORCEMENT — ALL WORKS
R-T8 | Reinforcement T8 Fe500D, shelter and entry structures | t | 0.006 | 26.33 | 89703.00 |  | PRICED | TMT Fe-500, cut, bent, hooked, tied and FIXED IN POSITION. The SSR measures the fixed weight, which is the net weight scheduled here
R-T10 | Reinforcement T10 Fe500D, shelter and entry structures | t | 0.063 | 26.33 | 89703.00 |  | PRICED | TMT Fe-500, cut, bent, hooked, tied and FIXED IN POSITION. The SSR measures the fixed weight, which is the net weight scheduled here
R-T12 | Reinforcement T12 Fe500D, shelter and entry structures | t | 20.318 | 26.33 | 89703.00 |  | PRICED | TMT Fe-500, cut, bent, hooked, tied and FIXED IN POSITION. The SSR measures the fixed weight, which is the net weight scheduled here
R-T16 | Reinforcement T16 Fe500D, shelter and entry structures | t | 23.707 | 26.33 | 89703.00 |  | PRICED | TMT Fe-500, cut, bent, hooked, tied and FIXED IN POSITION. The SSR measures the fixed weight, which is the net weight scheduled here
R-T20 | Reinforcement T20 Fe500D, shelter and entry structures | t | 10.923 | 26.33 | 89703.00 |  | PRICED | TMT Fe-500, cut, bent, hooked, tied and FIXED IN POSITION. The SSR measures the fixed weight, which is the net weight scheduled here
R-T25 | Reinforcement T25 Fe500D, shelter and entry structures | t | 15.439 | 26.33 | 89703.00 |  | PRICED | TMT Fe-500, cut, bent, hooked, tied and FIXED IN POSITION. The SSR measures the fixed weight, which is the net weight scheduled here
R-BS | Reinforcement T12 Fe500 to the burster slab (M30) | t | 1.218 | 26.33 | 89703.00 |  | PRICED | TMT Fe-500, cut, bent, hooked, tied and FIXED IN POSITION. The SSR measures the fixed weight, which is the net weight scheduled here
R-S8 | Reinforcement T8 Fe500, sentry post | t | 0.645 | 26.33 | 89703.00 |  | PRICED | TMT Fe-500, cut, bent, hooked, tied and FIXED IN POSITION. The SSR measures the fixed weight, which is the net weight scheduled here
R-S10 | Reinforcement T10 Fe500, sentry post | t | 0.245 | 26.33 | 89703.00 |  | PRICED | TMT Fe-500, cut, bent, hooked, tied and FIXED IN POSITION. The SSR measures the fixed weight, which is the net weight scheduled here
R-S12 | Reinforcement T12 Fe500, sentry post | t | 0.190 | 26.33 | 89703.00 |  | PRICED | TMT Fe-500, cut, bent, hooked, tied and FIXED IN POSITION. The SSR measures the fixed weight, which is the net weight scheduled here
R-S16 | Reinforcement T16 Fe500, sentry post | t | 0.624 | 26.33 | 89703.00 |  | PRICED | TMT Fe-500, cut, bent, hooked, tied and FIXED IN POSITION. The SSR measures the fixed weight, which is the net weight scheduled here
R-S20 | Reinforcement T20 Fe500, sentry post | t | 0.269 | 26.33 | 89703.00 |  | PRICED | TMT Fe-500, cut, bent, hooked, tied and FIXED IN POSITION. The SSR measures the fixed weight, which is the net weight scheduled here
R-ORD | Reinforcement ORDER quantity, all works, incl. 5 % wastage | t | 77.330 | — |  |  | INCLUDED — not separately payable | PROCUREMENT MEMORANDUM, NOT A PAYABLE ITEM. SSR 26.33 is paid on the weight fixed in position — 73.647 t, the sum of the twelve lines above. 77.33 / 1.05 = 73.648, so the two figures agree exactly. Wastage is inside the SSR rate and must not be paid a second time
 | SUB-TOTAL — C
D · FORMWORK AND FALSEWORK
F-01 | Formwork, shelter and entry structures, contact area | m2 | 1057.743 | — |  |  | INCLUDED — not separately payable | INCLUDED IN EVERY CONCRETE RATE ABOVE. SSR items 24.04, 25.15, 25.17, 25.35, 25.54, 25.74, 25.76, 26.19 and 26.26 each read 'including STEEL CENTERING, FORMWORK, cover blocks'. Paying F-01 separately would pay for the same formwork twice. The quantity stands as a measured control figure
F-02 | Falsework to the pressure slab soffit, 3.200 m height, props to remain 14 days (IS 456 Table 11) | m2 | 104.000 | — |  |  | INCLUDED — not separately payable | INCLUDED, as F-01. The 14-day prop period remains a PROGRAMME driver even though it is not a separately payable item
 | SUB-TOTAL — D
E · ENGINEERED COVER, OVERBURDEN AND CONCEALMENT
B-screed | Protection screed 100 over the membrane (cover layer 1) | m3 | 10.289 | 24.04 | 6359.00 |  | PRICED | M15 bedding concrete. THIS IS THE SAME WORK AS ITEM W-05, which is measured in m2 — 102.889 x 0.100 = 10.289. Paid here ONCE
B-fill | Compacted engineered fill @ 95 % MDD | m3 | 77.167 | 21.37 | 599.00 |  | PRICED | As E-07
B-rubble | Crushed basalt rubble 25-75 mm | m3 | 51.445 | 21.38 | 1382.00 |  | PRICED | Trap rubble stone soling, hand packed and compacted. SEE THE CREDIT LINE BELOW — this material is to be won from the project's own rock excavation
B-rubble-cr | CREDIT if the rubble is won on site and crushed, as the quantity derivation directs | m3 | 51.445 | 21.38 |  |  | INCLUDED — not separately payable | MEMORANDUM, NOT DEDUCTED. 994 m3 of basalt comes out of E-02b against 51.4 m3 needed. The SSR labour component of 21.38 is Rs 432 against the completed Rs 1 382, so winning it on site is worth about 51.445 x (1382 - 432) = Rs 48 873, and removes 51 m3 of import AND 51 m3 of cart-away. Left in the bill at the full SSR rate because the crushing plant is not in the project record
B-burster | RC burster slab M30, T12 @ 150 B/W, 200 thk | m3 | 20.578 | 25.15 | 7471.00 |  | PRICED | Ground-supported: it is cast on the 500 crushed-rubble layer, and its own formwork measure is EDGE ONLY, 11.3 m2. So the raft item 25.15 governs, not the suspended-slab item 25.74 (M-30, Rs 14 299)
B-filter | Granular filter, 150 thk | m3 | 15.433 | 21.39 | 2160.00 |  | PRICED [A] — stated assumption | [A] SSR 21.39 sand filling is the nearest published item and carries the condition 'to be executed with prior approval of the Superintending Engineer'. The project specifies no filter grading — no gradation is invented here
B-concealment | Topsoil / turf — concealment and erosion, 300 thk | m3 | 30.867 | 21.36 | 120.00 |  | PRICED | Filling with APPROVED EXCAVATED MATERIAL, watered and compacted — exactly the 92.82 m3 stripped and stockpiled at E-01a, of which 30.867 is used. TURFING ITSELF IS NOT IN THE SSR: the schedule directs Parks and Gardens wing rates for that, which this project does not hold
B-berm | Berm forming and grading, 1.5:1 to +0.900 against the headhouse and covered stairwell | m3 |  | 21.36 |  |  | NOT PRICED | NOT PRICED. NO QUANTITY EXISTS — no site plan and no ground model is in the project (Drainage open item D3). A rate is available (SSR 21.36, Rs 120/m3) the moment a quantity does
B-camo | Camouflage and concealment measures beyond the 300 topsoil / turf layer | item |  | — |  |  | NOT PRICED | NOT PRICED and NOT IN THE SSR. No concealment specification exists in the project. SSR General Notes Section B: rates not in the schedule are to be approved by the Superintending Engineer
 | SUB-TOTAL — E
F · WATERPROOFING
W-01 | WP-01 tanking, horizontal on blinding under the mat | m2 | 142.080 | 51.114 | 678.00 |  | PRICED [A] — stated assumption | [A] SPECIFICATION SUBSTITUTION. WP-01 is a continuous external tanking MEMBRANE (FINISH_LEGEND). SSR 51.114 is a five-layer polymeric membrane on a 90 micron HMHDPE core — the material matches; the SSR describes it applied to roof and parapet, not below grade. The SSR's own below-grade item, 31.12, is a rough shahabad BOX treatment at Rs 1 286 — a different specification, carried in the workbook as the alternative
W-02 | WP-01 tanking, vertical to external wall faces, (-)6.700 to (-)2.000 | m2 | 265.080 | 51.114 | 678.00 |  | PRICED [A] — stated assumption | [A] As W-01. SSR alternative for vertical basement faces is 31.13, Rs 1 338
W-03 | WP-01 tanking, roof membrane, net of the void and shafts | m2 | 121.881 | 51.114 | 678.00 |  | PRICED [A] — stated assumption | [A] As W-01
W-04 | WP-01 upstands, fillets and dressing to openings and penetrations | m2 | 37.145 | 51.114 | 678.00 |  | PRICED [A] — stated assumption | [A] As W-01
W-05 | WP-02 protection screed 100 over the roof membrane (also cover layer 1) | m2 | 102.889 | — |  |  | INCLUDED — not separately payable | THE SAME WORK AS B-screed, measured in m2 instead of m3. Paid once, at B-screed. 102.889 x 0.100 = 10.289 m3
W-06 | WP-06 headhouse and stairwell roofs, external grade + protection | m2 | 41.440 | 51.114 + 51.115 | 1068.00 |  | PRICED [A] — stated assumption | [A] Membrane plus the SSR's own 20 mm mechanical protective layer
W-08 | WP-04 internal wet-area tanking, floors | m2 | 26.800 | 31.09 | 615.00 |  | PRICED [A] — stated assumption | [A] Acrylic polymer modified cement-based coating with fibre glass mesh — the SSR's tanking-under-finish item. WP-04 names no product
W-09 | WP-04 internal wet-area tanking, walls, 2.000 high | m2 | 81.440 | 31.09 | 615.00 |  | PRICED [A] — stated assumption | [A] As W-08
W-10 | Waterstops, 2 No. at every construction joint (WP-05), ~6 m centres | m | 109.760 | — |  |  | NOT PRICED | NOT PRICED. THE SSR HAS NO WATERSTOP ITEM ANYWHERE IN 624 PAGES — searched for waterstop, water stop, water bar and PVC water bar. Section B: the rate is to be approved by the Superintending Engineer. The joint positions are also not fixed in the project ([A] in WM1)
 | SUB-TOTAL — F
G · SENTRY POST — CONCRETE AND FRAME (M30)
SC-01 | Sentry post: Footings F1, 4 No., 1500 x 1500 x 600 | m3 | 5.400 | 25.15 | 7471.00 |  | PRICED | M-30 foundations and footings
SC-02 | Sentry post: Columns C1, 4 No., 350 x 350, (-)1.400 to +6.700 | m3 | 3.969 | 25.35 | 14150.00 |  | PRICED | M-30 columns. No floor lift applied — a column is cast in one pour from its base
SC-03 | Sentry post: Plinth beam PB 250 x 400, 15.200 m clear | m3 | 1.520 | 25.54 | 12635.00 |  | PRICED | M-30 beams, ground level
SC-04.1 | Sentry post: Beams B1 / B2 250 x 450, first-floor level | m3 | 1.140 | 25.54 | 12761.35 |  | PRICED | Half of WM1 item SC-04 (2.28 m3 at two levels). +1 % first-floor lift
SC-04.2 | Sentry post: Beams B1 / B2 250 x 450, roof level | m3 | 1.140 | 25.54 | 12761.35 |  | PRICED | The other half. +1 % floor lift
SC-05 | Sentry post: Slab S1 150, first floor, 4.000 x 5.000 | m3 | 3.000 | 25.74 | 14441.99 |  | PRICED | M-30 slabs, +1 % first-floor lift
SC-06 | Sentry post: Slab S1 150, roof, 4.600 x 5.600 incl. the 300 projection | m3 | 3.864 | 25.74 | 14441.99 |  | PRICED | M-30 slabs, +1 % floor lift. The SSR table runs ground / first / second / third / fourth; the roof of a G+1 is read as the first-floor band
SC-07 | Sentry post: Parapet 300 high x 150 thk over the roof projection | m3 | 0.918 | 26.19 der. | 16092.65 |  | PRICED [A] — stated assumption | [A] Pardi grade-uplifted M25 -> M30, +1 % floor lift. The 150 thickness is [A] in WM1 and that tag is carried, not resolved
SC-08 | Sentry post ground floor slab on grade — PROVISIONAL, not designed | m2 | 16.560 | — |  |  | NOT PRICED | NOT PRICED. Thickness and specification are to be confirmed — WM1 tags this [N] and no rate can be chosen without them
SC-09 | Sentry post: blinding / PCC M15 100 thk under F1, 4 No. | m3 | 1.156 | 24.04 | 6359.00 |  | PRICED | As C-09
SC-10 | Sentry post: external spiral stair, 1000 R, 250 dia central pole | item | 1.000 | — |  |  | NOT PRICED | NOT PRICED. THE SSR HAS NO SPIRAL STAIR ITEM, and the fabrication detail is not in the project record. SSR 40.06, SS 304 handrail at Rs 1 220/m, is the only related published item and cannot stand for the stair. Section B: Superintending Engineer to approve the rate
 | SUB-TOTAL — G
H · SENTRY POST — BRICK MASONRY AND FINISHES (design change SP-B1)
SP-01 | Brick masonry, ground storey, 190 thk in a 200 zone, CM 1:6, incl. scaffolding | m3 | 6.876 | 27.05 | 7994.00 |  | PRICED [A] — stated assumption | [A] Mortar CM 1:6 and location (superstructure) match SSR 27.05 exactly. SP-B1 specifies modular bricks CLASS 10 to IS 1077. THE SSR PUBLISHES NO FIRST-CLASS ITEM FOR SUPERSTRUCTURE WALLS AT ALL — chapter 27 offers first class only in plinth (27.02) and in pillars (27.08, 27.09) — so 27.05 is the only published superstructure brick wall item and it governs whatever class the bricks are. The SSR's first / second class is a workmanship grading and does not map onto IS 1077 strength classes. OPEN ITEM WM4-V2
SP-02 | Brick masonry, first storey, 190 thk in a 200 zone, CM 1:6, incl. scaffolding | m3 | 5.320 | 27.05 | 8073.94 |  | PRICED [A] — stated assumption | [A] As SP-01, +1 % first-floor lift
SP-03 | Modular burnt clay bricks class 10 to IS 1077, delivered | No. | 6402.952 | — |  |  | INCLUDED — not separately payable | INCLUDED in SP-01 / SP-02 — SSR 27.05 is a composite supply-and-lay rate. SSR general material rate for II class brick is Rs 8.50 each, so this quantity carries about Rs 54 425 of material INSIDE the masonry rate
SP-04 | Cement for masonry mortar CM 1:6 | bag | 14.458 | — |  |  | INCLUDED — not separately payable | INCLUDED in SP-01 / SP-02. SSR general rate Rs 6 000 / M.T. = Rs 300 / bag
SP-05 | Sand for masonry mortar, to IS 2116 | m3 | 3.012 | — |  |  | INCLUDED — not separately payable | INCLUDED in SP-01 / SP-02. SSR general rate, crushed sand, Rs 1 200 / m3
SP-06 | RC lintels over openings, 200 x 150 — PROVISIONAL section | m3 | 0.510 | 25.54 | 12635.00 |  | PRICED [A] — stated assumption | [A] M-30 beams and lintels. THE SECTION IS SUPERSEDED: design revision SP-B2 (master A.4.8 / H.12) designs lintel L1 at 190 x 150, and WM_RECONCILIATION_REGISTER section 6 records that this bill line still measures the superseded 200 x 150. WM4 does NOT re-measure it — the quantity is WM1's and stays WM1's. OPEN ITEM WM4-V3
SP-07 | Internal cement plaster 12 mm, CM 1:4 | m2 | 125.150 | 32.04 | 278.00 |  | PRICED | Thickness, mortar and location all match the SSR item exactly. WM1's description says 'sand faced'; sand facing is an EXTERNAL finish in the SSR (32.11) and 12 mm internal CM 1:4 is 32.04. Priced as internal
SP-08 | External cement plaster 15 mm, two coat | m2 | 97.390 | 32.11 | 639.00 |  | PRICED | SSR 32.11 sand faced external: 15 mm base coat in CM 1:4 plus a finishing coat — the specified two-coat 15 mm work exactly
SP-09 | Flooring, ground and first floor, 3.600 x 4.600 each | m2 | 33.120 | 33.24 |  |  | NOT PRICED | NOT PRICED. NO FLOORING SPECIFICATION EXISTS IN THE PROJECT (WM1 tags it [N]). For information only, and NOT in the total: SSR 33.24 matt ceramic 300 x 300 is Rs 1 182 / m2, which would be Rs 39 147
SP-10.1 | Painting, INTERNAL — plastic emulsion, two coats | m2 | 125.150 | 36.12 | 80.00 |  | PRICED [A] — stated assumption | [A] WM1 item SP-10 is one 222.54 m2 line for internal and external together. It splits EXACTLY on the two plaster areas — 125.15 + 97.39 = 222.54 — so the split is arithmetic, not judgement. The paint SYSTEM is assumed: WM1 records the specification as not in the project
SP-10.2 | Painting, EXTERNAL — exterior acrylic emulsion, two coats | m2 | 97.390 | 35.25 | 261.00 |  | PRICED [A] — stated assumption | [A] As SP-10.1
SP-11 | Door D1 900 x 2100, 2 No. (ground and first floor) | m2 | 3.780 | 39.10 | 2913.00 |  | PRICED [A] — stated assumption | [A] SHUTTER ONLY — the SSR bills the frame as a separate item and no frame specification exists. The door TYPE is not in the project either; a 32 mm commercial flush shutter is assumed. Height 2100 is [A] in WM1
SP-12 | Window W1 1200 wide, ground storey, 1 No. | No. | 1.000 | 39.50 |  |  | NOT PRICED | NOT PRICED. THE HEIGHT IS NOT STATED ANYWHERE IN THE PROJECT ([N] in WM1), so there is no area to price. SSR 39.50 aluminium openable window is Rs 5 700 / m2 when a height exists
SP-13 | Armoured vision panels 1200 wide, 8 No., first storey — SPECIALIST | No. | 8.000 | — |  |  | NOT PRICED | NOT PRICED and NOT IN THE SSR. An armoured vision panel is not a schedule item. Specification is not in the project either
 | SUB-TOTAL — H
I · ELECTRICAL AND EMP INSTALLATION
EL-01 | Conduits, boxes and concealed work, cast into RC — builder's work | item |  | — |  |  | NOT PRICED | NOT PRICED. NO ELECTRICAL DESIGN PACKAGE EXISTS — no quantity, and for EL-03 and EL-07 no SSR item either. The SSR's water-supply and sanitary chapters 41-43 hold no EMP or shielding item of any kind
EL-02 | Cabling, distribution board and final circuits | item |  | — |  |  | NOT PRICED | NOT PRICED. NO ELECTRICAL DESIGN PACKAGE EXISTS — no quantity, and for EL-03 and EL-07 no SSR item either. The SSR's water-supply and sanitary chapters 41-43 hold no EMP or shielding item of any kind
EL-03 | EMP Zone 2 shielded enclosure, bay 3 — SPECIALIST | item |  | — |  |  | NOT PRICED | NOT PRICED. NO ELECTRICAL DESIGN PACKAGE EXISTS — no quantity, and for EL-03 and EL-07 no SSR item either. The SSR's water-supply and sanitary chapters 41-43 hold no EMP or shielding item of any kind
EL-04 | Earthing installation, 5 ohm target, IS 3043 | item |  | — |  |  | NOT PRICED | NOT PRICED. NO ELECTRICAL DESIGN PACKAGE EXISTS — no quantity, and for EL-03 and EL-07 no SSR item either. The SSR's water-supply and sanitary chapters 41-43 hold no EMP or shielding item of any kind
EL-05 | Lighting, small power and emergency lighting | item |  | — |  |  | NOT PRICED | NOT PRICED. NO ELECTRICAL DESIGN PACKAGE EXISTS — no quantity, and for EL-03 and EL-07 no SSR item either. The SSR's water-supply and sanitary chapters 41-43 hold no EMP or shielding item of any kind
EL-06 | Generator connection, changeover and protection | item |  | — |  |  | NOT PRICED | NOT PRICED. NO ELECTRICAL DESIGN PACKAGE EXISTS — no quantity, and for EL-03 and EL-07 no SSR item either. The SSR's water-supply and sanitary chapters 41-43 hold no EMP or shielding item of any kind
EL-07 | EMP protection to every service penetration (power PCI, waveguide-below-cutoff, fibre) | item |  | — |  |  | NOT PRICED | NOT PRICED. NO ELECTRICAL DESIGN PACKAGE EXISTS — no quantity, and for EL-03 and EL-07 no SSR item either. The SSR's water-supply and sanitary chapters 41-43 hold no EMP or shielding item of any kind
 | SUB-TOTAL — I
J · PRINCIPAL MATERIALS — PROCUREMENT VOLUMES
M-01 | Cement, OPC 43 grade to IS 269, all works | t | 194.169 | — |  |  | INCLUDED — not separately payable | PROCUREMENT MEMORANDUM, NOT A PAYABLE ITEM — cement is inside every composite rate above. At the SSR general rate of Rs 6 000 / M.T. this volume carries Rs 1 165 014 of cement INSIDE those rates
M-02 | Coarse and fine aggregate to IS 383, all concrete | t | 828.661 | — |  |  | INCLUDED — not separately payable | PROCUREMENT MEMORANDUM. Inside the composite rates. SSR general rates: 20 mm aggregate Rs 1 050 / m3, crushed sand Rs 1 200 / m3
M-03 | Water for concrete, mortar and curing — site supply | item |  | — |  |  | INCLUDED — not separately payable | PROCUREMENT MEMORANDUM. Curing and watering are inside every SSR item. SSR general rate for water is Rs 213 / 1 000 litre
 | SUB-TOTAL — J
K · ITEMS ADDED BY OWNER RULING RC4 (master H.28)
RC4-01 | Strip expansive CH horizon to 1.000 m below existing ground under and 1.000 m beyond the entry stairwell stepped raft, cart away and dispose | m3 | 8.000 | 21.02 | 207.00 |  | PRICED | RC4 recorded this as '[A] NOT PRICED' because no rate existed. A RATE NOW EXISTS. The QUANTITY tag stays [R] and the ruling is untouched — only the rate column is filled
RC4-02 | Supply and place free-draining granular replacement fill, FSI <= 20 % to IS 2720 Pt XL, in 200 mm layers compacted to >= 95 % MDD, incl. 50 mm sand blinding | m3 | 8.000 | 21.37 | 599.00 |  | PRICED | As RC4-01. SSR 21.37 is filling with contractor's material in 15-20 cm layers, watered and compacted — the specified work, at a TIGHTER layer thickness than the schedule assumes
 | SUB-TOTAL — K
L · PROTECTIVE PLANT, CLOSURES AND SERVICES — OUTSIDE THE SSR
Z-01 | Blast Doors 1 and 2, >= 7 bar, rebound-rated | set | 2.000 | — |  |  | NOT PRICED | NOT IN THE WM1 BILL AND NOT IN THE SSR. Recorded here so the estimate is honest about its boundary: the owner's own bill (Cost/USER_BOQ_*, Cost/REVISED_BOQ_*_RC1) prices these from vendor figures. SSR General Notes Section B: 'The items for which rates are not included in State Schedule of Rates, the rates shall be approved by concerned Superintending Engineer, PWD'
Z-02 | Emergency exit hatches, 900 clear, 621 kPa | set | 2.000 | — |  |  | NOT PRICED | NOT IN THE WM1 BILL AND NOT IN THE SSR. Recorded here so the estimate is honest about its boundary: the owner's own bill (Cost/USER_BOQ_*, Cost/REVISED_BOQ_*_RC1) prices these from vendor figures. SSR General Notes Section B: 'The items for which rates are not included in State Schedule of Rates, the rates shall be approved by concerned Superintending Engineer, PWD'
Z-03 | Fast-acting blast valves BV-1 to BV-3 (DN100) | set | 3.000 | — |  |  | NOT PRICED | NOT IN THE WM1 BILL AND NOT IN THE SSR. Recorded here so the estimate is honest about its boundary: the owner's own bill (Cost/USER_BOQ_*, Cost/REVISED_BOQ_*_RC1) prices these from vendor figures. SSR General Notes Section B: 'The items for which rates are not included in State Schedule of Rates, the rates shall be approved by concerned Superintending Engineer, PWD'
Z-04 | Generator blast valves BV-4 and BV-5 (DN350) | set | 2.000 | — |  |  | NOT PRICED | NOT IN THE WM1 BILL AND NOT IN THE SSR. Recorded here so the estimate is honest about its boundary: the owner's own bill (Cost/USER_BOQ_*, Cost/REVISED_BOQ_*_RC1) prices these from vendor figures. SSR General Notes Section B: 'The items for which rates are not included in State Schedule of Rates, the rates shall be approved by concerned Superintending Engineer, PWD'
Z-05 | NBC collective protection trains, 2 x 300 m3/h | set | 2.000 | — |  |  | NOT PRICED | NOT IN THE WM1 BILL AND NOT IN THE SSR. Recorded here so the estimate is honest about its boundary: the owner's own bill (Cost/USER_BOQ_*, Cost/REVISED_BOQ_*_RC1) prices these from vendor figures. SSR General Notes Section B: 'The items for which rates are not included in State Schedule of Rates, the rates shall be approved by concerned Superintending Engineer, PWD'
Z-06 | Sealed Zone-2 welded EMP enclosure, 3 x 3 x 2.4 m | item | 1.000 | — |  |  | NOT PRICED | NOT IN THE WM1 BILL AND NOT IN THE SSR. Recorded here so the estimate is honest about its boundary: the owner's own bill (Cost/USER_BOQ_*, Cost/REVISED_BOQ_*_RC1) prices these from vendor figures. SSR General Notes Section B: 'The items for which rates are not included in State Schedule of Rates, the rates shall be approved by concerned Superintending Engineer, PWD'
Z-07 | Submersible sump pumps, effluent piping and septic | set | 1.000 | — |  |  | NOT PRICED | NOT IN THE WM1 BILL AND NOT IN THE SSR. Recorded here so the estimate is honest about its boundary: the owner's own bill (Cost/USER_BOQ_*, Cost/REVISED_BOQ_*_RC1) prices these from vendor figures. SSR General Notes Section B: 'The items for which rates are not included in State Schedule of Rates, the rates shall be approved by concerned Superintending Engineer, PWD'
Z-08 | Standby generator 15 kVA in bay 8, fuel system, exhaust and acoustic treatment | set | 1.000 | — |  |  | NOT PRICED | NOT IN THE WM1 BILL AND NOT IN THE SSR. Recorded here so the estimate is honest about its boundary: the owner's own bill (Cost/USER_BOQ_*, Cost/REVISED_BOQ_*_RC1) prices these from vendor figures. SSR General Notes Section B: 'The items for which rates are not included in State Schedule of Rates, the rates shall be approved by concerned Superintending Engineer, PWD'
Z-09 | Testing, commissioning and envelope leakage test | item | 1.000 | — |  |  | NOT PRICED | NOT IN THE WM1 BILL AND NOT IN THE SSR. Recorded here so the estimate is honest about its boundary: the owner's own bill (Cost/USER_BOQ_*, Cost/REVISED_BOQ_*_RC1) prices these from vendor figures. SSR General Notes Section B: 'The items for which rates are not included in State Schedule of Rates, the rates shall be approved by concerned Superintending Engineer, PWD'
 | SUB-TOTAL — L
 | TOTAL OF ITEMS — carried to the Recapitulation sheet

Sheet: Recapitulation
RECAPITULATION
Block A is the SSR's own recapitulation, General Notes Section B. Block B is the project owner's provision structure, carried from their RC1 estimate and kept separate because it is not part of the schedule. Block D is what must NOT be added.
 | Head | Basis | Rate | Amount (Rs) | Source / note
A | Total of items — SSR 2022-23 completed rates, excl. GST | sum of the priced bill |  |  | this bill
A | Insurance of project / work facility | 1.00 % — work value above Rs 25.00 lakh | 1.00% |  | SSR General Notes Section B (i) A
A | Labour insurance | 1.00 % — work value above Rs 25.00 lakh | 1.00% |  | SSR General Notes Section B (i) B
A | Material testing charges | SSR chapter 18, Testing Charges and Frequency of Test |  |  | NOT QUANTIFIED — the test schedule is priced per test and the frequencies depend on delivered lot sizes
A | SUB-TOTAL — SSR recapitulation, before GST
B | Contingencies | 3 % of the item total | 3.00% |  | Project owner's own provision structure, carried from their RC1 estimate. NOT part of the schedule of rates
B | Water and electricity provisions | 1 % of the item total | 1.00% |  | Project owner's own provision structure, carried from their RC1 estimate. NOT part of the schedule of rates
B | Specialist CBRN / EMP and engineering consultant | 6 % of the item total | 6.00% |  | Project owner's own provision structure, carried from their RC1 estimate. NOT part of the schedule of rates
B | Site supervision and quality assurance | 2 % of the item total | 2.00% |  | Project owner's own provision structure, carried from their RC1 estimate. NOT part of the schedule of rates
B | Statutory clearances and liaisoning | 1 % of the item total | 1.00% |  | Project owner's own provision structure, carried from their RC1 estimate. NOT part of the schedule of rates
B | SUB-TOTAL — before GST
C | GST on works contract | 18 % [A] | 18.00% |  | SSR requires a separate provision in the recapitulation sheet but does NOT fix the rate — tagged [A]
C | ESTIMATED COST — civil works priced from SSR 2022-23 |  |  |  | EXCLUDES every NOT PRICED item — see the exclusions register
D | Contractor's overhead — NOT ADDED | 10 % |  |  | ALREADY INSIDE EVERY SSR COMPLETED RATE. General Notes: 'For labour amenities and all other overhead charges, 10 % provision is considered in Rate Abstract'
D | Contractor's profit — NOT ADDED | 10 % |  |  | ALREADY INSIDE EVERY SSR COMPLETED RATE. General Notes: 'In addition, 10 % provision for Contractor's Profit is also considered separately'
D | Labour cess — NOT ADDED | 1 % |  |  | ALREADY INSIDE EVERY SSR COMPLETED RATE. General Notes, Govt. Circular SSR-1090/CR-6453/PLN-3 dt. 14.07.1993: 'Labour Cess at 1 % has been considered separately in Rate Abstracts'
 | THE YELLOW CELL IS THE ONLY LEVER IN THIS WORKBOOK
 | Change the GST rate in D15 and every figure below it recalculates. Percentages in blue are inputs.

Sheet: Rate derivation
RATE DERIVATION
Every rate in the bill that is not a straight SSR item, with the arithmetic that produced it. The method is the SSR's own.
Derived rate | Rs | Working
PARDI_M35 | 16024.97 | SSR 26.19 R.C.C. pardi M-25 = 15750. Highest grade published for this item is M-25; the box is M-35. General Notes Section B: derive by adding the difference in standard cement consumption. (8.25 - 7.50) bags x 50 kg x Rs 6.00/kg x 1.2221 on-cost = 274.97. 15750 + 274.97 = 16024.97 /m3
PARDI_M30 | 15933.32 | SSR 26.19 R.C.C. pardi M-25 = 15750. Sentry post parapet is M-30. (8.00 - 7.50) bags x 50 kg x Rs 6.00/kg x 1.2221 = 183.32. 15750 + 183.32 = 15933.32 /m3
WAIST_M35 | 12518.97 | SSR 26.26 R.C.C. waist slab and steps of staircases M-25 = 12244. Highest grade published for this item is M-25; the main staircase is M-35. (8.25 - 7.50) bags x 50 kg x Rs 6.00/kg x 1.2221 = 274.97. 12244 + 274.97 = 12518.97 /m3
ROCK_0_3 | 1307.00 | SSR 21.20 hard rock by chiselling / wedging / line drilling, mechanical = 1307. Depth below 3.0 m: no increase
ROCK_3_45 | 1568.40 | SSR 21.20 = 1307 x 1.20. Section B: '3.0 m to 4.50 m depth add 20 %'
ROCK_45_6 | 1699.10 | SSR 21.20 = 1307 x 1.30. Section B: '4.5 m to 6.0 m depth add 30 %'
ROCK_6_PLUS | 1699.10 | SSR 21.20 = 1307 x 1.30. [A] Section B stops at 6.0 m: 'Depth beyond 6.0 m - extra percent to be decided by concerned Superintending Engineer'. NO PERCENTAGE IS INVENTED HERE. The 4.5-6.0 m band's 30 % is carried on as a DECLARED LOWER BOUND so the line is not left blank; the true figure can only be higher. Open item WM4-V1
M30_SLAB_FF | 14441.99 | SSR 25.74 = 14299 x 1.01. Section B floor lift: 'First floor 1 %'
M30_BEAM_FF | 12761.35 | SSR 25.54 = 12635 x 1.01. Section B floor lift: 'First floor 1 %'
PARDI_M30_FF | 16092.65 | Derived M-30 pardi 15933.32 x 1.01 (first floor lift 1 %)
BRICK_FF | 8073.94 | SSR 27.05 = 7994 x 1.01 (first floor lift 1 %)
MEMBRANE_PROT | 1068.00 | SSR 51.114 membrane 678 + SSR 51.115 20 mm protective screed 390 = 1068 /m2. WP-06 is specified as external-grade membrane PLUS protection
THE CHECK THAT MAKES THESE USABLE
M20 to M25 | 183.32 | The SSR publishes this step itself, in four separate item families, as 183 / 184. The formula reproduces it, so the same formula can be trusted where the SSR stops publishing.
M25 to M30 | 183.32 | The SSR publishes this step itself, in four separate item families, as 183 / 184. The formula reproduces it, so the same formula can be trusted where the SSR stops publishing.
M30 to M35 | 91.66 | The SSR publishes this step itself, in four separate item families, as 91 / 92. The formula reproduces it, so the same formula can be trusted where the SSR stops publishing.

Sheet: SSR rate library
SSR 2022-23 — EVERY RATE USED, AS PUBLISHED
Read out of the owner's PDF and re-verified against the raw page text. 'Completed rate' and 'Labour rate' are the SSR's own column headings, both excluding GST.
SSR item | SSR chapter | Description (SSR wording, trimmed) | Unit | Completed rate (Rs) | Labour rate (Rs) | SSR page | PDF page
21.02 | Excavation | Excavation for foundation in earth, soil of all types, sand, gravel and soft murum, including removing the excavated material up to a distance of 50 m beyond the building area and stacking and spreading as directed, dewatering, preparing the bed for the foundation and necessary back filling, ramming, watering including shoring and strutting etc. complete. (Lift upto 1.5 m.) By Mechanical Means | m3 | 207 | 116 | 153 | 160
21.04 | Excavation | Excavation for foundation in earth, soils of all types, sand, gravel and soft murum ... (Lift from 1.5 m to 3.0 m) By Mechanical Means | m3 | 258 | 144 | 153 | 160
21.20 | Excavation | Excavation for foundation in Hard rock by chiselling, wedging, line drilling, etc. including trimming and levelling the bed, removing the excavated material upto a distance of 50 metres beyond the building area, stacking as directed, dewatering and back filling with available earth/murum, watering, ramming etc. complete. (Lift upto 1.5 m.) By Mechanical Means | m3 | 1307 | 889 | 155 | 162
21.22 | Excavation | Providing preconstructional antitermite treatment as per IS 6313 (Part-II) by treating the bottom surface and sides of excavation at the rate of 5 litres of emulsion concentrate of 1.0 percent chlorpyrifos per square metre etc. complete | m2 | 107 | 6 | 155 | 162
21.33 | Excavation | Labour charges for removing grass, thorny shrubs, jungli shrub, kubabul and alike grass, making the ground clean by shovel and phavaras etc. complete | m2 | 7 | 7 | 157 | 164
21.36 | Excavation | Filling in plinth and floors with approved excavated material in 15 cm to 20 cm layers including watering and compacting etc. complete | m3 | 120 | 120 | 157 | 164
21.37 | Excavation | Filling in plinth and floors with contractor's material / brought from outside and approved by Engineer in charge in layers of 15 cm to 20 cm including watering and compaction etc. complete | m3 | 599 | 135 | 157 | 164
21.38 | Excavation | Providing dry / trap / granite / quartzite / gneiss rubble stone soling 15 cm to 20 cm thick including hand packing and compacting etc. complete | m3 | 1382 | 432 | 157 | 164
21.39 | Excavation | Providing and filling in the foundation with sand of approved quality including watering, compacting etc. complete. (To be executed with prior approval of Superintending Engineer) | m3 | 2160 | 120 | 157 | 164
21.40 | Excavation | Providing soling using 80 mm size trap metal in 15 cm layer including filling voids with crushed sand / grit, ramming, watering etc. complete | m3 | 1454 | 436 | 157 | 164
24.01 | Plain Cement Concrete | Providing and laying cast in situ / ready mix cement concrete in M-10 of trap / granite / quartzite / gneiss metal for foundation and bedding including bailing out water, steel centering, formwork, laying / pumping, compacting and curing etc. complete. The SSR's own consumption table gives nominal PCC 1:3:6 and M-10 the SAME 4.40 bags/m3, so 24.01 is the published item for a 1:3:6 levelling bed | m3 | 5830 | 1616 | 175 | 182
24.04 | Plain Cement Concrete | Providing and laying cast in situ / ready mix cement concrete in M15 of trap / granite / quartzite / gneiss metal for foundation and bedding / steps including steel centering, formwork, laying / pumping, compacting, roughening them if special finish is to be provided, finishing uneven and honeycombed surface and curing etc. complete. With fine aggregate (Crushed sand VSI grade) | m3 | 6359 | 1616 | 175 | 182
25.15 | Reinforced Cement Concrete | Providing and laying cast in situ / ready mix cement concrete M-30 of trap / granite / quartzite / gneiss metal for R.C.C. work in foundations like raft, strip foundations, grillage and footings of R.C.C. columns and steel stanchions etc. ... including steel centering, formwork, cover blocks, laying / pumping, compaction, finishing ... and curing etc. complete, (EXCLUDING reinforcement and structural steel) | m3 | 7471 | 2110 | 178 | 185
25.17 | Reinforced Cement Concrete | As 25.15 but grade M-35. | m3 | 7562 | 2110 | 178 | 185
25.35 | Reinforced Cement Concrete | Providing and laying cast in situ / ready mix cement concrete M-30 ... for R.C.C. COLUMNS as per detailed designs and drawing ... including steel centering, formwork, cover blocks ... (EXCLUDING reinforcement) | m3 | 14150 | 5252 | 180 | 187
25.54 | Reinforced Cement Concrete | Providing and laying cast in situ / ready mix cement concrete M-30 ... for R.C.C. BEAMS AND LINTELS ... including steel centering, formwork, cover blocks ... (EXCLUDING reinforcement) | m3 | 12635 | 5085 | 181 | 188
25.74 | Reinforced Cement Concrete | Providing and laying cast in situ / ready mix cement concrete M-30 ... for R.C.C. SLABS AND LANDINGS ... including steel centering, formwork, cover blocks ... (EXCLUDING reinforcement) | m3 | 14299 | 5988 | 183 | 190
25.76 | Reinforced Cement Concrete | As 25.74 but grade M-35. | m3 | 14391 | 5988 | 183 | 190
26.19 | Reinforced Cement Concrete | Providing and laying cast in situ / ready mix cement concrete in M-25 ... for R.C.C. PARDI (wall) of required thickness including steel centering, formwork, cover blocks ... (EXCLUDING reinforcement). M-25 is the HIGHEST grade the SSR publishes for this item | m3 | 15750 | 7338 | 185 | 192
26.26 | Reinforced Cement Concrete | Providing and laying cast in situ / ready mix cement concrete in M-25 ... for R.C.C. WAIST SLAB AND STEPS OF STAIRCASES ... (EXCLUDING reinforcement). M-25 is the HIGHEST grade the SSR publishes for this item | m3 | 12244 | 5219 | 186 | 193
26.33 | Reinforced Cement Concrete | Providing and fixing in position TMT Fe-500 bar reinforcement of various diameters for R.C.C. pile caps, footings, foundations, slabs, beams, columns, canopies, staircase, newels, chajjas, lintels, pardis, copings, fins, arches etc. as per detailed designs, drawings and schedules, including cutting, bending, hooking the bars, binding with wires or tack welding and supporting as required, complete | t | 89703 | 11762 | 188 | 195
27.05 | Brick Work | Providing second class burnt brick masonry with conventional / IS type bricks in cement mortar 1:6 in SUPERSTRUCTURE including striking joints, raking out joints, watering and scaffolding etc. complete | m3 | 7994 | 1705 | 197 | 204
27.06 | Brick Work | Providing second class burnt brick masonry with conventional / IS type bricks in cement mortar 1:4 in HALF BRICK THICK WALL including mild steel longitudinal reinforcement of 2 bars of 6 mm dia / 2 hoop iron strips 25 x 1.6 mm at every third course, scaffolding etc. complete | m2 | 1119 | 203 | 197 | 204
27.08 | Brick Work | Providing FIRST class burnt brick masonry with conventional / IS type bricks in cement mortar 1:4 including scaffolding, racking out joints, pointing in CM 1:3 and watering etc. IN PILLARS of rectangular or square shape. NOTE: the SSR publishes NO first-class item for superstructure WALLS — 27.08 and 27.09 are both pillar items | m3 | 9525 | 2704 | 197 | 204
31.09 | Water Proofing | Providing and applying waterproofing treatment using acrylic polymer modified cement based waterproofing coating with fibre glass mesh etc. complete | m2 | 615 | 316 | 206 | 213
31.12 | Water Proofing | Providing and fixing 20 to 25 mm thick rough shahabad box type waterproofing FOR BASEMENT OR UNDERGROUND FLOOR on a base of cement concrete 1:3:6 ... with 7 years guarantee ... with ponding test etc. complete (excluding cement concrete 1:3:6 base concrete) | m2 | 1286 | 393 | 206 | 213
31.13 | Water Proofing | Providing and fixing 20 to 25 mm thick rough shahabad box type waterproofing treatment TO VERTICAL OUTSIDE FACES OF REINFORCED CEMENT CONCRETE WALLS OF BASEMENT or underground floor ... with 7 years guarantee ... with ponding test etc. complete | m2 | 1338 | 509 | 207 | 214
32.04 | Plastering and Pointing | Providing INTERNAL cement plaster 12 mm thick in single coat in cement mortar 1:4 without neeru finish to concrete or brick surfaces, in all positions, including scaffolding and curing etc. complete | m2 | 278 | 204 | 209 | 216
32.11 | Plastering and Pointing | Providing SAND FACED plaster EXTERNALLY in cement mortar using approved screened sand, in all positions, including base coat of 15 mm thick in cement mortar 1:4 and a finishing coat, including scaffolding and curing etc. complete | m2 | 639 | 412 | 209 | 216
32.15 | Plastering and Pointing | Providing NEERU FINISH to plastered surfaces in all positions including scaffolding and curing etc. complete | m2 | 65 | 56 | 210 | 217
33.24 | Paving, Flooring and Dado | Providing and laying matt finish ceramic tiles 30 cm x 30 cm conforming to IS 15622, on a bed of cement mortar, including cement float, filling joints, curing etc. complete | m2 | 1182 | 355 | 216 | 223
35.25 | Oil Painting | Providing and applying two coats of EXTERIOR ACRYLIC EMULSION paint conforming to the corresponding IS, of approved make, colour and shade, including scaffolding and preparing the surface etc. complete | m2 | 261 | 172 | 226 | 233
36.12 | Colouring | Providing and applying PLASTIC EMULSION paint of approved quality, colour and shade to old and new surfaces in TWO coats including scaffolding and preparing the surface etc. complete | m2 | 80 | 24 | 228 | 235
39.10 | Doors and Windows | Providing and fixing solid core FLUSH DOOR SHUTTER, commercial, single leaf, 32 mm thick, without ventilator, with necessary fixtures and fastenings etc. complete. SHUTTER ONLY — the frame is a separate item | m2 | 2913 | 851 | 246 | 253
39.50 | Doors and Windows | Providing and fixing in position ALUMINIUM OPENABLE WINDOW of any size as per detailed drawing, with all necessary aluminium sections, fixtures and fastenings, with 5 mm thick clear float glass etc. complete, with colour anodising (section weight 6.90 kg/m2 considered) | m2 | 5700 | 1809 | 256 | 263
40.06 | Iron Work | Providing and fixing 40 mm diameter and 1.5 mm thick STAINLESS STEEL HAND RAILING in SS 304 grade including fabrication, fixtures, erection etc. complete | m | 1220 | 286 | 264 | 271
51.114 | Water Proofing (new items 2019-20) | Providing and laying Hyperplas standard or equivalent POLYMERIC MULTIPLE MONOLITHIC FIVE LAYER waterproofing flexible, pliable, high tensile strength MEMBRANE (3 kg/m2) with a centre core of 90 micron thick high molecular high density polyethylene film (HMHDPE) protected on both sides with polymeric mix, applied by thermofusing after a primer, 10 cm overlapping, with a 7 year guarantee. (Prior written permission of the Superintending Engineer is necessary before inclusion in an estimate) | m2 | 678 | 115 | 382 | 389
51.115 | Water Proofing (new items 2019-20) | Providing and laying mechanical protective layer over waterproofing membrane with cement screed plaster 1:5 after laying chicken mesh over the membrane, 20 mm thick, including the cost of chicken mesh, curing, and a 7 year guarantee | m2 | 390 | 193 | 383 | 390

Sheet: Not priced
DECLARED EXCLUSIONS — NOT IN ANY TOTAL IN THIS WORKBOOK
Each line is here because the project has no specification for it, or the SSR has no item for it, or both. No rate is invented for any of them. SSR General Notes Section B: 'The items for which rates are not included in State Schedule of Rates, the rates shall be approved by concerned Superintending Engineer, PWD.'
Sec | Item | Description | Unit | Quantity | Why it is not priced
A | E-09 | Preconstructional antitermite treatment to the bottom surface and sides of the excavation, IS 6313 Part II | m2 |  | NOT IN THE WM1 BILL and no quantity exists. Listed because the owner's own RC1 bill carries a 320 m2 anti-termite line and the SSR has an item for it. Rate shown for information; NOT in the total
E | B-berm | Berm forming and grading, 1.5:1 to +0.900 against the headhouse and covered stairwell | m3 |  | NOT PRICED. NO QUANTITY EXISTS — no site plan and no ground model is in the project (Drainage open item D3). A rate is available (SSR 21.36, Rs 120/m3) the moment a quantity does
E | B-camo | Camouflage and concealment measures beyond the 300 topsoil / turf layer | item |  | NOT PRICED and NOT IN THE SSR. No concealment specification exists in the project. SSR General Notes Section B: rates not in the schedule are to be approved by the Superintending Engineer
F | W-10 | Waterstops, 2 No. at every construction joint (WP-05), ~6 m centres | m | 109.760 | NOT PRICED. THE SSR HAS NO WATERSTOP ITEM ANYWHERE IN 624 PAGES — searched for waterstop, water stop, water bar and PVC water bar. Section B: the rate is to be approved by the Superintending Engineer. The joint positions are also not fixed in the project ([A] in WM1)
G | SC-08 | Sentry post ground floor slab on grade — PROVISIONAL, not designed | m2 | 16.560 | NOT PRICED. Thickness and specification are to be confirmed — WM1 tags this [N] and no rate can be chosen without them
G | SC-10 | Sentry post: external spiral stair, 1000 R, 250 dia central pole | item | 1.000 | NOT PRICED. THE SSR HAS NO SPIRAL STAIR ITEM, and the fabrication detail is not in the project record. SSR 40.06, SS 304 handrail at Rs 1 220/m, is the only related published item and cannot stand for the stair. Section B: Superintending Engineer to approve the rate
H | SP-09 | Flooring, ground and first floor, 3.600 x 4.600 each | m2 | 33.120 | NOT PRICED. NO FLOORING SPECIFICATION EXISTS IN THE PROJECT (WM1 tags it [N]). For information only, and NOT in the total: SSR 33.24 matt ceramic 300 x 300 is Rs 1 182 / m2, which would be Rs 39 147
H | SP-12 | Window W1 1200 wide, ground storey, 1 No. | No. | 1.000 | NOT PRICED. THE HEIGHT IS NOT STATED ANYWHERE IN THE PROJECT ([N] in WM1), so there is no area to price. SSR 39.50 aluminium openable window is Rs 5 700 / m2 when a height exists
H | SP-13 | Armoured vision panels 1200 wide, 8 No., first storey — SPECIALIST | No. | 8.000 | NOT PRICED and NOT IN THE SSR. An armoured vision panel is not a schedule item. Specification is not in the project either
I | EL-01 | Conduits, boxes and concealed work, cast into RC — builder's work | item |  | NOT PRICED. NO ELECTRICAL DESIGN PACKAGE EXISTS — no quantity, and for EL-03 and EL-07 no SSR item either. The SSR's water-supply and sanitary chapters 41-43 hold no EMP or shielding item of any kind
I | EL-02 | Cabling, distribution board and final circuits | item |  | NOT PRICED. NO ELECTRICAL DESIGN PACKAGE EXISTS — no quantity, and for EL-03 and EL-07 no SSR item either. The SSR's water-supply and sanitary chapters 41-43 hold no EMP or shielding item of any kind
I | EL-03 | EMP Zone 2 shielded enclosure, bay 3 — SPECIALIST | item |  | NOT PRICED. NO ELECTRICAL DESIGN PACKAGE EXISTS — no quantity, and for EL-03 and EL-07 no SSR item either. The SSR's water-supply and sanitary chapters 41-43 hold no EMP or shielding item of any kind
I | EL-04 | Earthing installation, 5 ohm target, IS 3043 | item |  | NOT PRICED. NO ELECTRICAL DESIGN PACKAGE EXISTS — no quantity, and for EL-03 and EL-07 no SSR item either. The SSR's water-supply and sanitary chapters 41-43 hold no EMP or shielding item of any kind
I | EL-05 | Lighting, small power and emergency lighting | item |  | NOT PRICED. NO ELECTRICAL DESIGN PACKAGE EXISTS — no quantity, and for EL-03 and EL-07 no SSR item either. The SSR's water-supply and sanitary chapters 41-43 hold no EMP or shielding item of any kind
I | EL-06 | Generator connection, changeover and protection | item |  | NOT PRICED. NO ELECTRICAL DESIGN PACKAGE EXISTS — no quantity, and for EL-03 and EL-07 no SSR item either. The SSR's water-supply and sanitary chapters 41-43 hold no EMP or shielding item of any kind
I | EL-07 | EMP protection to every service penetration (power PCI, waveguide-below-cutoff, fibre) | item |  | NOT PRICED. NO ELECTRICAL DESIGN PACKAGE EXISTS — no quantity, and for EL-03 and EL-07 no SSR item either. The SSR's water-supply and sanitary chapters 41-43 hold no EMP or shielding item of any kind
L | Z-01 | Blast Doors 1 and 2, >= 7 bar, rebound-rated | set | 2.000 | NOT IN THE WM1 BILL AND NOT IN THE SSR. Recorded here so the estimate is honest about its boundary: the owner's own bill (Cost/USER_BOQ_*, Cost/REVISED_BOQ_*_RC1) prices these from vendor figures. SSR General Notes Section B: 'The items for which rates are not included in State Schedule of Rates, the rates shall be approved by concerned Superintending Engineer, PWD'
L | Z-02 | Emergency exit hatches, 900 clear, 621 kPa | set | 2.000 | NOT IN THE WM1 BILL AND NOT IN THE SSR. Recorded here so the estimate is honest about its boundary: the owner's own bill (Cost/USER_BOQ_*, Cost/REVISED_BOQ_*_RC1) prices these from vendor figures. SSR General Notes Section B: 'The items for which rates are not included in State Schedule of Rates, the rates shall be approved by concerned Superintending Engineer, PWD'
L | Z-03 | Fast-acting blast valves BV-1 to BV-3 (DN100) | set | 3.000 | NOT IN THE WM1 BILL AND NOT IN THE SSR. Recorded here so the estimate is honest about its boundary: the owner's own bill (Cost/USER_BOQ_*, Cost/REVISED_BOQ_*_RC1) prices these from vendor figures. SSR General Notes Section B: 'The items for which rates are not included in State Schedule of Rates, the rates shall be approved by concerned Superintending Engineer, PWD'
L | Z-04 | Generator blast valves BV-4 and BV-5 (DN350) | set | 2.000 | NOT IN THE WM1 BILL AND NOT IN THE SSR. Recorded here so the estimate is honest about its boundary: the owner's own bill (Cost/USER_BOQ_*, Cost/REVISED_BOQ_*_RC1) prices these from vendor figures. SSR General Notes Section B: 'The items for which rates are not included in State Schedule of Rates, the rates shall be approved by concerned Superintending Engineer, PWD'
L | Z-05 | NBC collective protection trains, 2 x 300 m3/h | set | 2.000 | NOT IN THE WM1 BILL AND NOT IN THE SSR. Recorded here so the estimate is honest about its boundary: the owner's own bill (Cost/USER_BOQ_*, Cost/REVISED_BOQ_*_RC1) prices these from vendor figures. SSR General Notes Section B: 'The items for which rates are not included in State Schedule of Rates, the rates shall be approved by concerned Superintending Engineer, PWD'
L | Z-06 | Sealed Zone-2 welded EMP enclosure, 3 x 3 x 2.4 m | item | 1.000 | NOT IN THE WM1 BILL AND NOT IN THE SSR. Recorded here so the estimate is honest about its boundary: the owner's own bill (Cost/USER_BOQ_*, Cost/REVISED_BOQ_*_RC1) prices these from vendor figures. SSR General Notes Section B: 'The items for which rates are not included in State Schedule of Rates, the rates shall be approved by concerned Superintending Engineer, PWD'
L | Z-07 | Submersible sump pumps, effluent piping and septic | set | 1.000 | NOT IN THE WM1 BILL AND NOT IN THE SSR. Recorded here so the estimate is honest about its boundary: the owner's own bill (Cost/USER_BOQ_*, Cost/REVISED_BOQ_*_RC1) prices these from vendor figures. SSR General Notes Section B: 'The items for which rates are not included in State Schedule of Rates, the rates shall be approved by concerned Superintending Engineer, PWD'
L | Z-08 | Standby generator 15 kVA in bay 8, fuel system, exhaust and acoustic treatment | set | 1.000 | NOT IN THE WM1 BILL AND NOT IN THE SSR. Recorded here so the estimate is honest about its boundary: the owner's own bill (Cost/USER_BOQ_*, Cost/REVISED_BOQ_*_RC1) prices these from vendor figures. SSR General Notes Section B: 'The items for which rates are not included in State Schedule of Rates, the rates shall be approved by concerned Superintending Engineer, PWD'
L | Z-09 | Testing, commissioning and envelope leakage test | item | 1.000 | NOT IN THE WM1 BILL AND NOT IN THE SSR. Recorded here so the estimate is honest about its boundary: the owner's own bill (Cost/USER_BOQ_*, Cost/REVISED_BOQ_*_RC1) prices these from vendor figures. SSR General Notes Section B: 'The items for which rates are not included in State Schedule of Rates, the rates shall be approved by concerned Superintending Engineer, PWD'

Sheet: Included not payable
MEASURED, BUT ALREADY INSIDE ANOTHER RATE
The double-count guard. Every line here is real work with a real quantity that is already paid for somewhere else in the bill. Pricing any of them again would pay for the same work twice.
Sec | Item | Description | Unit | Quantity | Where it is already paid
A | E-02 | Bulk excavation, main shelter, 0.000 to (-)6.800, all strata — SUM OF THE SIX DEPTH BANDS BELOW | m3 | 1338.240 | Measured at E-02.1 to E-02.6. Plan area 196.80 m2 = 1338.24 / 6.800
A | E-02a | of which excavation in soil / weathered overburden | m3 | 344.400 | Memorandum. Priced at E-02.1 and E-02.2
A | E-02b | of which excavation in rock (Deccan basalt) | m3 | 993.840 | Memorandum. Priced at E-02.3 to E-02.6
A | E-08 | Surplus excavated material — re-use on site as engineered fill / crushed rubble, remainder to spoil | m3 | 1113.937 | INCLUDED. Every SSR excavation item already carries removal to 50 m beyond the building area and stacking as directed. Lead beyond 50 m is payable under SSR Statement C-1 transportation charges and CANNOT be quantified — no site plan and no spoil destination exists (Drainage D3)
C | R-ORD | Reinforcement ORDER quantity, all works, incl. 5 % wastage | t | 77.330 | PROCUREMENT MEMORANDUM, NOT A PAYABLE ITEM. SSR 26.33 is paid on the weight fixed in position — 73.647 t, the sum of the twelve lines above. 77.33 / 1.05 = 73.648, so the two figures agree exactly. Wastage is inside the SSR rate and must not be paid a second time
D | F-01 | Formwork, shelter and entry structures, contact area | m2 | 1057.743 | INCLUDED IN EVERY CONCRETE RATE ABOVE. SSR items 24.04, 25.15, 25.17, 25.35, 25.54, 25.74, 25.76, 26.19 and 26.26 each read 'including STEEL CENTERING, FORMWORK, cover blocks'. Paying F-01 separately would pay for the same formwork twice. The quantity stands as a measured control figure
D | F-02 | Falsework to the pressure slab soffit, 3.200 m height, props to remain 14 days (IS 456 Table 11) | m2 | 104.000 | INCLUDED, as F-01. The 14-day prop period remains a PROGRAMME driver even though it is not a separately payable item
E | B-rubble-cr | CREDIT if the rubble is won on site and crushed, as the quantity derivation directs | m3 | 51.445 | MEMORANDUM, NOT DEDUCTED. 994 m3 of basalt comes out of E-02b against 51.4 m3 needed. The SSR labour component of 21.38 is Rs 432 against the completed Rs 1 382, so winning it on site is worth about 51.445 x (1382 - 432) = Rs 48 873, and removes 51 m3 of import AND 51 m3 of cart-away. Left in the bill at the full SSR rate because the crushing plant is not in the project record
F | W-05 | WP-02 protection screed 100 over the roof membrane (also cover layer 1) | m2 | 102.889 | THE SAME WORK AS B-screed, measured in m2 instead of m3. Paid once, at B-screed. 102.889 x 0.100 = 10.289 m3
H | SP-03 | Modular burnt clay bricks class 10 to IS 1077, delivered | No. | 6402.952 | INCLUDED in SP-01 / SP-02 — SSR 27.05 is a composite supply-and-lay rate. SSR general material rate for II class brick is Rs 8.50 each, so this quantity carries about Rs 54 425 of material INSIDE the masonry rate
H | SP-04 | Cement for masonry mortar CM 1:6 | bag | 14.458 | INCLUDED in SP-01 / SP-02. SSR general rate Rs 6 000 / M.T. = Rs 300 / bag
H | SP-05 | Sand for masonry mortar, to IS 2116 | m3 | 3.012 | INCLUDED in SP-01 / SP-02. SSR general rate, crushed sand, Rs 1 200 / m3
J | M-01 | Cement, OPC 43 grade to IS 269, all works | t | 194.169 | PROCUREMENT MEMORANDUM, NOT A PAYABLE ITEM — cement is inside every composite rate above. At the SSR general rate of Rs 6 000 / M.T. this volume carries Rs 1 165 014 of cement INSIDE those rates
J | M-02 | Coarse and fine aggregate to IS 383, all concrete | t | 828.661 | PROCUREMENT MEMORANDUM. Inside the composite rates. SSR general rates: 20 mm aggregate Rs 1 050 / m3, crushed sand Rs 1 200 / m3
J | M-03 | Water for concrete, mortar and curing — site supply | item |  | PROCUREMENT MEMORANDUM. Curing and watering are inside every SSR item. SSR general rate for water is Rs 213 / 1 000 litre

Sheet: Owner bill vs SSR
THE OWNER'S OWN PRICED BILL, RE-RATED AT SSR 2022-23
The owner's quantities and the owner's rates are reproduced exactly as supplied and nothing in their bill is edited. Master H.15 records of that bill: 'No cost was re-estimated, no rate was checked against a market or a schedule of rates.' This sheet is that check.
Part | Owner's bill description (RC1) | Unit | Quantity | Owner rate | Owner amount | SSR item | SSR rate | SSR amount | Difference | Diff % | Note
I | Confirmatory soil and rock core boreholes | No | 4.000 | 50000.00 |  | — |  |  |  |  | Not comparable. The SSR's site-investigation items are road trial pits, not cored boreholes
I | Site clearance, grubbing and setting out | m2 | 1800.000 | 44.80 |  | 21.33 | 7.00 |  |  |  | SSR clearance is a labour-only item at Rs 7/m2
I | Mass excavation in basalt / murum (~6.8 m) | m3 | 1539.000 | 850.00 |  | 21.20 | 1307.00 |  |  |  | SSR 21.20, hard rock by chiselling, BEFORE the Section B depth increases of +20 % and +30 % that a 6.8 m excavation attracts. The owner's single blended Rs 850 covers both murum and basalt
I | Surface dressing and anti-termite treatment | m2 | 320.000 | 180.00 |  | 21.22 | 107.00 |  |  |  | IS 6313 Part II, bottom and sides of excavation
II | Formwork for mat raft and bay 5 sump | m2 | 125.000 | 410.00 |  | — |  |  |  |  | INCLUDED IN THE SSR CONCRETE RATE
II | PCC 1:3:6 levelling bed (100 mm) | m3 | 17.170 | 5500.00 |  | 24.01 | 5830.00 |  |  |  | The SSR's consumption table gives 1:3:6 and M-10 the same 4.40 bags/m3. The project's own bill (C-09 / C-10) specifies M15, which is 24.04 at Rs 6 359 — the two bills differ on the blinding grade
II | Monolithic mat raft casting (M35) | m3 | 81.840 | 8640.00 |  | 25.17 | 7562.00 |  |  |  | Raft foundations, M-35. Formwork inside both rates
II | Pre-applied waterproofing membrane + screed | m2 | 280.000 | 950.00 |  | 51.114 + 51.115 | 1068.00 |  |  |  | Polymeric HMHDPE membrane plus the SSR's 20 mm protective screed
II | Dual swelling hydrophilic kicker waterstops | m | 68.000 | 650.00 |  | — |  |  |  |  | NOT IN THE SSR — no waterstop item exists in the schedule
III | Formwork for 600 mm shear walls (3.2 m ht) | m2 | 480.000 | 580.00 |  | — |  |  |  |  | INCLUDED IN THE SSR CONCRETE RATE
III | Casting 600 mm perimeter and shear walls (M35) | m3 | 132.610 | 8640.00 |  | 26.19 der. | 16024.97 |  |  |  | R.C.C. pardi (wall) uplifted M25 -> M35. THE LARGEST SINGLE RATE GAP IN THE BILL: wall formwork is what the SSR item is dear for
III | Formwork and staging for 900 mm pressure slab | m2 | 145.000 | 650.00 |  | — |  |  |  |  | INCLUDED IN THE SSR CONCRETE RATE
III | Casting 900 mm pressure roof slab (M35) | m3 | 114.720 | 8640.00 |  | 25.76 | 14391.00 |  |  |  | R.C.C. slabs and landings, M-35
III | Internal dog-leg staircase RCC | m3 | 4.800 | 9200.00 |  | 26.26 der. | 12518.97 |  |  |  | Waist slab and steps, uplifted M25 -> M35
III | Headhouse structure (400 mm wall / 500 mm roof) | m3 | 28.560 | 8640.00 |  | 26.19 der. / 25.76 |  |  |  |  | Two SSR items apply — walls at the derived pardi rate, roof at 25.76. The owner bills them as one line, so no single SSR rate can stand against it. The project's own bill splits them at C-06.1 / C-06.2
III | Approach stairwell RC box (250 mm RC) | m3 | 18.200 | 8640.00 |  | 26.19 der. | 16024.97 |  |  |  | Priced at the wall rate, as C-08
III | Engineered burster slab (200 mm M30 — RC1 R-1) | m3 | 38.400 | 8200.00 |  | 25.15 | 7471.00 |  |  |  | Ground-supported slab on the rubble layer, so the M-30 raft item. RC1 flagged this rate [REVIEW] after the grade changed; the SSR answers it
III | Sentry post RC frame — brick infill measured as brickwork (RC1 R-6) | m3 | 18.600 | 8500.00 |  | 25.15 / 25.35 / 25.54 / 25.74 |  |  |  |  | Four SSR items apply to a frame — footings, columns, beams, slabs — at Rs 7 471 to Rs 14 299. The project's own bill splits them at SC-01 to SC-07. One blended rate cannot be checked against one SSR rate
III | 110 mm internal brick partition walls | m2 | 95.000 | 920.00 |  | 27.06 | 1119.00 |  |  |  | Half-brick thick wall in CM 1:4 with hoop-iron reinforcement. NOTE: the project's own W8 partitions (C-14) are 110 REINFORCED CONCRETE with A252 mesh both faces, not brick — the two bills describe different work
III | Escape shaft collars ESC 1 and ESC 2, 250 RC, OD 1900 (RC1 R-7) | m3 | 6.285 | 8640.00 |  | 26.19 der. | 16024.97 |  |  |  | As C-12
IV | Pressure roof slab rebar (T25 / T12) | t | 23.220 | 78000.00 |  | 26.33 | 89703.00 |  |  |  | TMT Fe-500 fixed in position
IV | Perimeter and shear wall rebar (T16 / T20) | t | 17.850 | 78000.00 |  | 26.33 | 89703.00 |  |  |  | As above
IV | Mat raft and haunch diagonal rebar | t | 13.140 | 78000.00 |  | 26.33 | 89703.00 |  |  |  | As above
IV | Headhouse, approach and staircase steel | t | 6.760 | 78000.00 |  | 26.33 | 89703.00 |  |  |  | As above
IV | Burster slab mesh (T12 @ 150 B/W) | t | 2.890 | 78000.00 |  | 26.33 | 89703.00 |  |  |  | The RC1 [REVIEW] on this line is a QUANTITY question and the SSR does not touch it — only the rate is compared here
IV | Sentry post structural rebar | t | 3.930 | 78000.00 |  | 26.33 | 89703.00 |  |  |  | As above
IV | EMP welding at 4th node and bonding straps | item | 1.000 | 380000.00 |  | — |  |  |  |  | NOT IN THE SSR
V | Blast doors 1 and 2 (>= 7 bar, rebound-rated) | set | 2.000 | 1250000.00 |  | — |  |  |  |  | NOT IN THE SSR
V | Emergency exit hatches (900 clear, 621 kPa) | set | 2.000 | 450000.00 |  | — |  |  |  |  | NOT IN THE SSR
V | Fast-acting blast valves BV-1 to BV-3 (DN100) | set | 3.000 | 160000.00 |  | — |  |  |  |  | NOT IN THE SSR
V | Generator blast valves BV-4 and BV-5 (DN350) | set | 2.000 | 320000.00 |  | — |  |  |  |  | NOT IN THE SSR
V | NBC collective protection trains (2 x 300 m3/h) | set | 2.000 | 1850000.00 |  | — |  |  |  |  | NOT IN THE SSR
V | Sealed Zone-2 welded EMP enclosure (3 x 3 x 2.4 m) | item | 1.000 | 850000.00 |  | — |  |  |  |  | NOT IN THE SSR
V | Layerwise engineered fill and basalt rubble berm | m3 | 620.000 | 420.00 |  | 21.37 / 21.38 | 599.00 |  |  |  | Compared at the engineered-fill item 21.37. The rubble part of the same owner line is 21.38 at Rs 1 382
V | Submersible sump pumps + effluent piping + septic | set | 1.000 | 420000.00 |  | — |  |  |  |  | NOT IN THE SSR in this form
V | Sand-faced internal plaster, punning and painting | m2 | 720.000 | 180.00 |  | 32.04 + 32.15 + 36.12 | 423.00 |  |  |  | Three SSR items make up this one owner line: 12 mm internal plaster CM 1:4 (Rs 278) + neeru finish, which is what punning is (Rs 65) + two coats of plastic emulsion (Rs 80) = Rs 423
V | Testing, commissioning and envelope leakage test | item | 1.000 | 250000.00 |  | — |  |  |  |  | NOT IN THE SSR
 | TOTAL — comparable lines only |  |  |  |  |  |  |  |  |  | The owner's rates sit BELOW SSR 2022-23 on the lines that can be compared. The gap is concentrated in three places: R.C.C. wall casting, rock excavation, and reinforcement.

Sheet: SSR general rates
SSR 2022-23 — GENERAL MATERIAL, LABOUR AND CONSUMPTION RATES
Printed pages 541 (materials), 545 (labour) and 567-581 (consumption). These do not price the bill — the completed rates do. They are here because the derivations use them and because they show what is inside a composite rate.
Description | Unit | Rate / quantity (Rs) | Block
Cement | M.T. | 6000.00 | Material
Structural Steel | M.T. | 62575.00 | Material
TMT Fe-500 | M.T. | 61000.00 | Material
HCRM / CRS reinforcement | M.T. | 63755.00 | Material
Sand — natural / VSI artificial | Cu.M. | 1670.00 | Material
Sand — crushed | Cu.M. | 1200.00 | Material
Sand — natural screened (plaster only) | Cu.M. | 1781.00 | Material
Bricks — I class (red) | No. | 9.00 | Material
Bricks — II class (red) | No. | 8.50 | Material
Rubble stone (excluding royalty) | Cu.M. | 653.00 | Material
Aggregate 40 mm (hand broken, blasted, excl. royalty) | Cu.M. | 900.00 | Material
Aggregate 20 mm | Cu.M. | 1050.00 | Material
Stone dust | Cu.M. | 835.00 | Material
Soft murum | Cu.M. | 313.00 | Material
Hard murum | Cu.M. | 316.00 | Material
Water | 1000 litre | 213.00 | Material
Mason I class (skilled) | day | 677.00 | Labour
Carpenter I class (skilled) | day | 677.00 | Labour
Bar bender (skilled) | day | 677.00 | Labour
Vibrator operator (skilled) | day | 677.00 | Labour
Painter I class (skilled) | day | 677.00 | Labour
Welder (skilled) | day | 677.00 | Labour
Electrician | day | 677.00 | Labour
Maistry / supervisor / mate (skilled) | day | 677.00 | Labour
Jack hammer operator | day | 677.00 | Labour
Semi-skilled labour | day | 648.00 | Labour
Chiseler (semi-skilled) | day | 648.00 | Labour
Breaker (semi-skilled) | day | 648.00 | Labour
Bhisti, mixing / curing (semi-skilled) | day | 648.00 | Labour
Mukadam (semi-skilled) | day | 648.00 | Labour
Mazdoor — unskilled heavy | day | 615.00 | Labour
Helper — unskilled | day | 615.00 | Labour
Labour for excavation in hard rock (unblasted) | day | 615.00 | Labour
Cement consumption, M15 | bags of 50 kg / m3 | 6.00 | Consumption
Cement consumption, M20 | bags of 50 kg / m3 | 7.00 | Consumption
Cement consumption, M25 | bags of 50 kg / m3 | 7.50 | Consumption
Cement consumption, M30 | bags of 50 kg / m3 | 8.00 | Consumption
Cement consumption, M35 | bags of 50 kg / m3 | 8.25 | Consumption
Cement consumption, M40 | bags of 50 kg / m3 | 8.50 | Consumption

Sheet: Open items
OPEN ITEMS RAISED BY THIS REVISION
Each one is a question this rating exercise could not answer from the evidence. None of them is closed here and none is guessed.
Ref | Title | What the evidence says | What WM4 did | What is needed to close it
WM4-V1 | Excavation below 6.0 m depth — the SSR sets no percentage | SSR General Notes Section B stops at '4.5 m to 6.0 m depth add 30 %' and then says 'Depth beyond 6.0 m — extra percent to be decided by concerned Superintending Engineer'. 157.44 m3 of rock between (-)6.000 and (-)6.800, and the 9.477 m3 sump pit below it, fall in that band. | Priced at +30 % as a DECLARED LOWER BOUND, tagged [A]. Every extra 10 percentage points is about Rs 21 800 on these two lines. | A determination by the Superintending Engineer, PWD, Pune circle
WM4-V2 | Brick class — SSR grading against IS 1077 | SP-B1 specifies modular bricks CLASS 10 to IS 1077. The SSR grades brick masonry as 'first class' and 'second class', which is a workmanship grading, and it publishes NO first-class item for superstructure walls at all — only plinth (27.02) and pillars (27.08, 27.09). | Priced at 27.05, second class in CM 1:6 in superstructure, which is the only published superstructure wall item and matches the specified mortar. | Confirmation that 27.05 is the correct billing item for class 10 bricks
WM4-V3 | Lintel SP-06 measures a superseded section | The bill line measures 200 x 150. Design revision SP-B2 (master A.4.8, H.12) designs lintel L1 at 190 x 150. WM_RECONCILIATION_REGISTER section 6 already records this. | WM4 prices the quantity AS MEASURED and does not re-measure it. The difference is 0.51 against 0.4845 m3, about 5 %, or Rs 322. | A re-measure, which belongs to the package that owns the quantity, not to a rating exercise
WM4-V4 | No district cost index or circle variation applied | The SSR is a STATE schedule. Its covering circular gives every Superintending Engineer power to vary the rates of relevant items for the geographical conditions of the district, and the General Notes say the basic material rates are a state-wide average. | State rates are used exactly as published. No index, uplift or discount is applied anywhere. | The Pune circle's current variation order, if one exists
WM4-V5 | GST rate is not fixed by the schedule | The SSR says 'separate provision for GST shall be made in recapitulation sheet' and does not state a percentage anywhere in 624 pages. | 18 % is used, tagged [A], as a single parameter cell in the workbook so another rate can be tested by changing one number. | The applicable works-contract GST rate for this employer
WM4-V6 | Tanking specification substituted | WP-01 is a continuous external tanking MEMBRANE. The SSR's own below-grade items (31.12, 31.13) are rough shahabad BOX treatments, a different specification. The nearest membrane item, 51.114, is described applied to roof and parapet. | Priced at 51.114 because the MATERIAL matches — a five-layer polymeric membrane on a 90 micron HMHDPE core. The shahabad alternative is carried in the workbook at Rs 1 286 / Rs 1 338 so the swap can be costed: it would add about Rs 400 000. | A decision on which specification is being bought
WM4-V7 | The protective plant is outside the schedule entirely | Blast doors, exit hatches, blast valves, the NBC trains, the EMP enclosure, the generator and the commissioning tests have NO SSR item. The SSR's answer is explicit: 'The items for which rates are not included in State Schedule of Rates, the rates shall be approved by concerned Superintending Engineer, PWD.' | Listed in bill section L at nil. The owner's own bill prices them from vendor figures at about Rs 1.05 crore; those figures are NOT SSR rates and WM4 does not adopt them. | Vendor quotations, and the Superintending Engineer's approval of the resulting non-schedule rates

Sheet: Verification
CONSISTENCY AND VERIFICATION
Run by wm4_build.py against the generated bill every time it is built. The quantity checks prove that splitting a WM1 line to reach two SSR items did not change the quantity.
Result | Check | Detail
PASS | E-02 depth bands sum to the WM1 quantity | 1338.24 against 1338.24
PASS | soil bands sum to WM1 E-02a | 344.40 against 344.4
PASS | rock bands sum to WM1 E-02b | 993.84 against 993.84
PASS | E-05 bands sum to the WM1 quantity | 37.044 against 37.044
PASS | C-06 split sums to the WM1 quantity | 32.70 against 32.7
PASS | SC-04 split sums to the WM1 quantity | 2.28 against 2.28
PASS | SP-10 split sums to the WM1 quantity | 222.54 against 222.54
PASS | reinforcement net = order / 1.05 | 73.647 against 73.648
PASS | W-05 and B-screed are the same work, paid once | 102.889 x 0.100 = 10.2889
PASS | grade uplift M20->M25 reproduces the SSR step | 183.32 against the SSR's 183
PASS | grade uplift M25->M30 reproduces the SSR step | 183.32 against the SSR's 183
PASS | grade uplift M30->M35 reproduces the SSR step | 91.66 against the SSR's 92
PASS | no bill line carries both a rate and 'included'
PASS | every NOT PRICED line carries no amount
PASS | every PRICED line carries a rate and an amount
PASS | every rate used is in the SSR library or is a derived rate
PASS | overhead, profit and labour cess are NOT added again
PASS | MAIN STAIRCASE QUANTITY UNCHANGED (frozen geometry) | 3.00 m3, as WM1
