yatineode128-hue/underground-shelter-project/Owner Rulings RC4/Schedules/RC4_BOQ_ADDENDUM.csv

ITEM | DESCRIPTION | UNIT | QTY | RATE | CLASS | BASIS
RC4-01 | Strip expansive CH horizon to 1.000 m below existing ground level under and 1.000 m beyond the entry stairwell stepped raft, cart away and dispose | m3 | 8 | [A] NOT PRICED | [R] qty | RC4 ruling on SG-V6, master H.28. Plan extent 4.410 x 4.000 m, mean depth below raft formation 0.400 m. Derivation in Owner Rulings RC4/Calculations/RC4_CALC_OUTPUT.txt R.5
RC4-02 | Supply and place free-draining granular replacement fill, free swell index <= 20 % to IS 2720 Pt XL, in 200 mm layers compacted to >= 95 % MDD to IS 2720 Pt VIII, tested to IS 2720 Pt 28, including 50 mm sand blinding | m3 | 8 | [A] NOT PRICED | [R] qty | Same extent as RC4-01. Must extend 1.000 m beyond every raft edge so the raft never bears partly on replaced and partly on natural CH
