yatineode128-hue/underground-shelter-project/Fire and Life Safety/Schedules/FS_ESCAPE_ROUTE_SCHEDULE.csv

ROUTE | DESCRIPTION | GEOMETRY | TRAVEL m | CLIMB m | EMERGES AT | EVIDENCE
R1 | PRIMARY - MAIN STAIR | BAY 7 STAIR SHAFT, 24R @ 170.8333, 3 FLIGHTS OF 8, 1200 WIDE - FROZEN GEOMETRY | 14.6 m | 6.100 m | HEADHOUSE (-2.000), THEN 12R @ 166.6667 TO THE ENTRY DOOR AT GRADE | [C] / [D]
R2 | ESCAPE SHAFT - ESC 1 | BAY 1, 1400 DIA CLEAR, 250 RC COLLAR, OD 1900 | 1.45 m | 6.250 m | HEAD (+0.150) | [C] / [D]
R3 | ESCAPE SHAFT - ESC 2 | BAY 8, 1400 DIA CLEAR - SHARED WITH THE GENERATOR, FS-3 | 1.50 m | 6.800 m | HEAD (+0.700) | [C] / [D]
