yatineode128-hue/underground-shelter-project/WORKS MANAGEMENT/USER_SOURCE/Underground_CBRN_Ops_Room_BOQ_Estimate.xlsx

Sheet: BOQ & Estimate
BILL OF QUANTITIES & COST ESTIMATE
Underground CBRN-Hardened Ops Room (22.0 m × 6.2 m Box)
WORKS MANAGEMENT & SCHEDULE PARAMETERS
Total Duration | 224 Working Days
Scheduled Dates | 02-11-2026 to 26-07-2027
Working Week | 6 Days / Week
Monsoon Relaxation | 3 Days / Month
Milestone 1 | Substructure Finish (18-12-26)
Milestone 2 | Superstructure Finish (26-03-27)
Milestone 3 | Hand-Over (26-07-27)
Specifications | M35 RCC & Fe500D (Blast Governed)
1. CONCRETE ESTIMATE
# | Structural Component & Geometry | Grade | Quantity | Unit
1.1 | Bottom PCC Levelling Bed for Raft Mat (100 mm thk) | M15 | 17.17 | m³
1.2 | Monolithic Mat Raft Foundation (600 mm thk) | M35 | 81.84 | m³
1.3 | Perimeter External Shear Walls W1–W4 (600 mm thk) | M35 | 108.29 | m³
1.4 | Internal Structural / Blast Shaft Walls W5–W7 | M35 | 24.32 | m³
1.5 | Pressure Roof Slab (900 mm thk, deduct stair void) | M35 | 114.72 | m³
1.6 | Internal Dog-Leg Staircase Flights & Intermediate Landings | M35 | 4.8 | m³
1.7 | Internal Sump Pit (1.5 m³) & Equipment Plinth Pads | M35 | 6.4 | m³
1.8 | Entry Headhouse (400 mm Walls, 500 mm Roof Slab) | M35 | 28.56 | m³
1.9 | Approach Stairwell Box (250 mm Raking Wall & Roof) | M35 | 18.2 | m³
1.10 | Sacrificial RC Burster Slab in 2 m Soil Overburden (300 mm) | M35 | 57.6 | m³
1.11 | Detached Sentry Post (Footings, Plinth, Columns, Beams, Slabs) | M30 | 18.6 | m³
 | TOTAL CONCRETE QUANTITY |  | 470.5 | m³
2. STEEL REINFORCEMENT ESTIMATE (Fe500D)
# | Bar Diameter & Structural Application | Net Weight (kg) | Wastage | Gross Weight (Tonnes)
2.1 | 8 mm Bars (Hoops, Ties, Sentry Post Reinforcement) | 1120 | 5% | 1.18
2.2 | 10 mm Bars (Distribution Steel & Secondary Links) | 1480 | 5% | 1.55
2.3 | 12 mm Bars (Shear Links, Burster Slab, Internal Partitions) | 9390 | 5% | 9.86
2.4 | 16 mm Bars (Perimeter Walls, Raft Foundation Mesh) | 24140 | 5% | 25.35
2.5 | 20 mm Bars (Shaft Walls W6/W7, Headhouse, Haunches) | 8740 | 5% | 9.18
2.6 | 25 mm Bars (Pressure Slab Main Curtains & Opening Trimmers) | 19690 | 5% | 20.67
 | TOTAL REINFORCEMENT STEEL | 64560 |  | 67.79

Sheet: Detailed BOQ
Part | # | Item Description | Unit | Qty | Rate (₹) | Material (₹) | Labour Deployment | Total Cost (₹)
PART I - SURVEY, SITE CLEARANCE & EXCAVATION
PART I - SURVEY, SITE CLEARANCE & EXCAVATION | 1 | Confirmatory Soil & Rock Core Boreholes | No | 4.00 | 50000.00 | 200000.00 | 2 Trad / 4 Maz (10 d) | 234660.00
PART I - SURVEY, SITE CLEARANCE & EXCAVATION | 2 | Site Clearance, Grubbing & Setting Out | Sqm | 1800.00 | 44.80 | 80640.00 | 1 Trad / 6 Maz (4 d) | 96500.00
PART I - SURVEY, SITE CLEARANCE & EXCAVATION | 3 | Mass Excavation in Basalt / Murum (~6.8 m) | Cum | 1539.00 | 850.00 | 1308150.00 | 2 Trad / 10 Maz (30 d) | 1512570.00
PART I - SURVEY, SITE CLEARANCE & EXCAVATION | 4 | Surface Dressing & Anti-Termite Treatment | Sqm | 320.00 | 180.00 | 57600.00 | 1 Trad / 4 Maz (4 d) | 68996.00
 |  |  |  |  |  |  | SUBTOTAL | 1912726
PART II - SUBSTRUCTURE & FOUNDATION WORKS
PART II - SUBSTRUCTURE & FOUNDATION WORKS | 1 | Formwork for Mat Raft & Bay 5 Sump | Sqm | 125.00 | 410.00 | 51250.00 | 4 Trad / 6 Maz (5 d) | 82750.00
PART II - SUBSTRUCTURE & FOUNDATION WORKS | 2 | PCC 1:3:6 Levelling Bed (100 mm) | Cum | 17.17 | 5500.00 | 94435.00 | 2 Trad / 8 Maz (2 d) | 105831.00
PART II - SUBSTRUCTURE & FOUNDATION WORKS | 3 | Monolithic Mat Raft Casting (M35) | Cum | 81.84 | 8640.00 | 707098.00 | 4 Trad / 12 Maz (6 d) | 762082.00
PART II - SUBSTRUCTURE & FOUNDATION WORKS | 4 | Pre-Applied Waterproofing Membrane + Screed | Sqm | 280.00 | 950.00 | 266000.00 | 2 Trad / 4 Maz (4 d) | 280832.00
PART II - SUBSTRUCTURE & FOUNDATION WORKS | 5 | Dual Swelling Hydrophilic Kicker Waterstops | M | 68.00 | 650.00 | 44200.00 | 2 Trad / 2 Maz (3 d) | 51976.00
 |  |  |  |  |  |  | SUBTOTAL | 1283471
PART III - SUPERSTRUCTURE & STRUCTURAL RCC
PART III - SUPERSTRUCTURE & STRUCTURAL RCC | 1 | Formwork for 600 mm Shear Walls (3.2 m Ht) | Sqm | 480.00 | 580.00 | 278400.00 | 6 Trad / 12 Maz (12 d) | 411888.00
PART III - SUPERSTRUCTURE & STRUCTURAL RCC | 2 | Casting 600 mm Perimeter & Shear Walls (M35) | Cum | 132.61 | 8640.00 | 1145750.00 | 4 Trad / 16 Maz (8 d) | 1236918.00
PART III - SUPERSTRUCTURE & STRUCTURAL RCC | 3 | Formwork & Staging for 900 mm Pressure Slab | Sqm | 145.00 | 650.00 | 94250.00 | 6 Trad / 14 Maz (10 d) | 216650.00
PART III - SUPERSTRUCTURE & STRUCTURAL RCC | 4 | Casting 900 mm Pressure Roof Slab (M35) | Cum | 114.72 | 8640.00 | 991181.00 | 6 Trad / 18 Maz (6 d) | 1073657.00
PART III - SUPERSTRUCTURE & STRUCTURAL RCC | 5 | Internal Dog-Leg Staircase RCC | Cum | 4.80 | 9200.00 | 44160.00 | 2 Trad / 4 Maz (4 d) | 58992.00
PART III - SUPERSTRUCTURE & STRUCTURAL RCC | 6 | Headhouse Structure (400 mm Wall / 500 mm Roof) | Cum | 28.56 | 8640.00 | 246758.00 | 3 Trad / 6 Maz (6 d) | 280130.00
PART III - SUPERSTRUCTURE & STRUCTURAL RCC | 7 | Approach Stairwell RC Box (250 mm RC) | Cum | 18.20 | 8640.00 | 157248.00 | 2 Trad / 4 Maz (5 d) | 175788.00
PART III - SUPERSTRUCTURE & STRUCTURAL RCC | 8 | Concrete Burster Slab (300 mm M35) | Cum | 57.60 | 8200.00 | 472320.00 | 3 Trad / 8 Maz (6 d) | 510210.00
PART III - SUPERSTRUCTURE & STRUCTURAL RCC | 9 | Sentry Post RCC Frame & Infill | Cum | 18.60 | 8500.00 | 158100.00 | 2 Trad / 4 Maz (8 d) | 187764.00
PART III - SUPERSTRUCTURE & STRUCTURAL RCC | 10 | 110 mm Internal Brick Partition Walls | Sqm | 95.00 | 920.00 | 87400.00 | 2 Trad / 4 Maz (6 d) | 109648.00
 |  |  |  |  |  |  | SUBTOTAL | 4261645
PART IV - REINFORCEMENT STEEL & SHIELDING
PART IV - REINFORCEMENT STEEL & SHIELDING | 1 | Pressure Roof Slab Rebar (T25 / T12) | Tonne | 23.22 | 78000.00 | 1811160.00 | 6 Trad / 12 Maz (18 d) | 2011392.00
PART IV - REINFORCEMENT STEEL & SHIELDING | 2 | Perimeter & Shear Wall Rebar (T16 / T20) | Tonne | 17.85 | 78000.00 | 1392300.00 | 6 Trad / 12 Maz (16 d) | 1570284.00
PART IV - REINFORCEMENT STEEL & SHIELDING | 3 | Mat Raft & Haunch Diagonal Rebar | Tonne | 13.14 | 78000.00 | 1024920.00 | 5 Trad / 10 Maz (12 d) | 1136160.00
PART IV - REINFORCEMENT STEEL & SHIELDING | 4 | Headhouse, Approach & Staircase Steel | Tonne | 6.76 | 78000.00 | 527280.00 | 4 Trad / 8 Maz (10 d) | 601440.00
PART IV - REINFORCEMENT STEEL & SHIELDING | 5 | Burster Slab Mesh (T12 @ 150 B/W) | Tonne | 2.89 | 78000.00 | 225420.00 | 3 Trad / 6 Maz (6 d) | 258792.00
PART IV - REINFORCEMENT STEEL & SHIELDING | 6 | Sentry Post Structural Rebar | Tonne | 3.93 | 78000.00 | 306540.00 | 2 Trad / 4 Maz (8 d) | 336204.00
PART IV - REINFORCEMENT STEEL & SHIELDING | 7 | EMP Welding at 4th Node & Bonding Straps | Item | 1.00 | 380000.00 | 380000.00 | 2 Trad / 2 Maz (15 d) | 418880.00
 |  |  |  |  |  |  | SUBTOTAL | 6333152
PART V - CBRN, EMP, CLOSURES & ANCILLARY SERVICES
PART V - CBRN, EMP, CLOSURES & ANCILLARY SERVICES | 1 | Blast Doors 1 & 2 (≥7 bar, Rebound-Rated) | Set | 2.00 | 1250000.00 | 2500000.00 | 4 Trad / 6 Maz (8 d) | 2550400.00
PART V - CBRN, EMP, CLOSURES & ANCILLARY SERVICES | 2 | Emergency Exit Hatches (900 mm Clear, 621 kPa) | Set | 2.00 | 450000.00 | 900000.00 | 2 Trad / 4 Maz (6 d) | 922248.00
PART V - CBRN, EMP, CLOSURES & ANCILLARY SERVICES | 3 | Fast-Acting Blast Valves BV-1 to BV-3 (DN100) | Set | 3.00 | 160000.00 | 480000.00 | 2 Trad / 2 Maz (4 d) | 490368.00
PART V - CBRN, EMP, CLOSURES & ANCILLARY SERVICES | 4 | Generator Blast Valves BV-4 & BV-5 (DN350) | Set | 2.00 | 320000.00 | 640000.00 | 2 Trad / 2 Maz (4 d) | 650368.00
PART V - CBRN, EMP, CLOSURES & ANCILLARY SERVICES | 5 | NBC Collective Protection Trains (2 × 300 m³/h) | Set | 2.00 | 1850000.00 | 3700000.00 | 4 Trad / 4 Maz (14 d) | 3772576.00
PART V - CBRN, EMP, CLOSURES & ANCILLARY SERVICES | 6 | Sealed Zone-2 Welded EMP Enclosure (3×3×2.4 m) | Item | 1.00 | 850000.00 | 850000.00 | 2 Trad / 4 Maz (12 d) | 894496.00
PART V - CBRN, EMP, CLOSURES & ANCILLARY SERVICES | 7 | Layerwise Engineered Fill & Basalt Rubble Berm | Cum | 620.00 | 420.00 | 260400.00 | 2 Trad / 10 Maz (12 d) | 342168.00
PART V - CBRN, EMP, CLOSURES & ANCILLARY SERVICES | 8 | Submersible Sump Pumps + Effluent Piping + Septic | Set | 1.00 | 420000.00 | 420000.00 | 2 Trad / 4 Maz (10 d) | 456500.00
PART V - CBRN, EMP, CLOSURES & ANCILLARY SERVICES | 9 | Sand-Faced Internal Plaster, Punning & Painting | Sqm | 720.00 | 180.00 | 129600.00 | 4 Trad / 6 Maz (12 d) | 199632.00
PART V - CBRN, EMP, CLOSURES & ANCILLARY SERVICES | 10 | Testing, Commissioning & Envelope Leakage Test | Item | 1.00 | 250000.00 | 250000.00 | 4 Trad / 2 Maz (4 d) | 266272.00
 |  |  |  |  |  |  | SUBTOTAL | 10545028

Sheet: Cost Summary
Cost Head Component | Basis / % Addition | Cost Incurred (₹)
Total Basic Cost | Subtotal Packages | ₹24336022.00
Contingencies | 3.0% | ₹730081.00
Water & Electricity Provisions | 1.0% | ₹243360.00
Specialist CBRN / EMP & Engineering Consultant | 6.0% | ₹1460161.00
Site Supervision & Quality Assurance | 2.0% | ₹486720.00
Statutory Clearances & Liaisoning | 1.0% | ₹243360.00
Contractor's Overhead & Profit | 10.0% | ₹2433602.00
FINAL PROJECT COST | - | ₹30033306.00
