yatineode128-hue/underground-shelter-project/Drainage/Handout/DR-H1_Drainage_Above_Ground.dxf

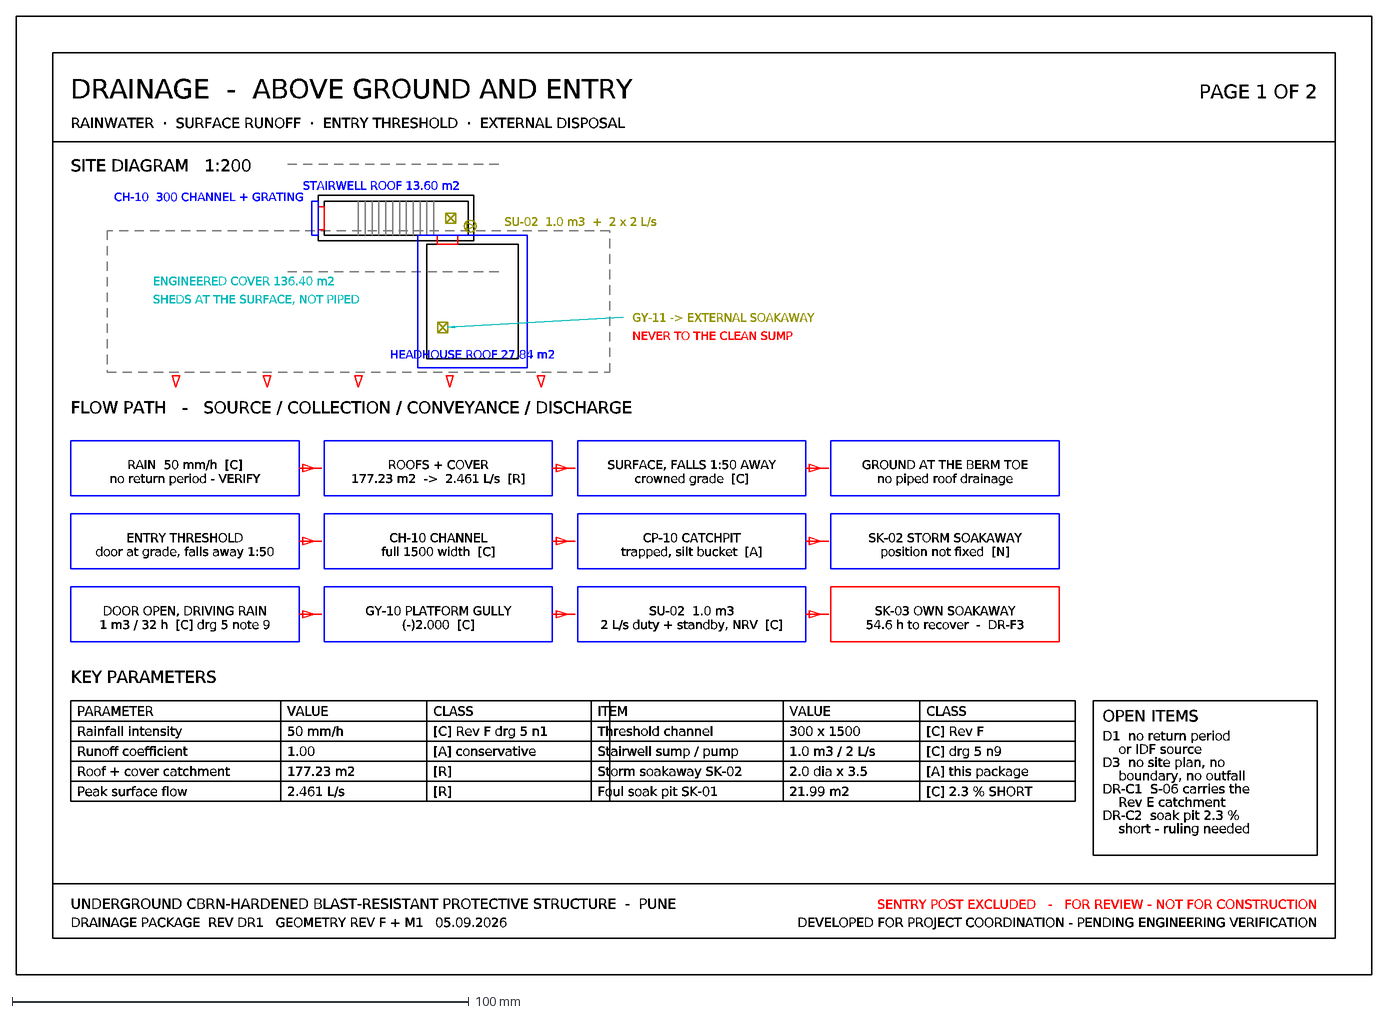
[picture p1: CAD file, 2026-09-10]
Drainage/Handout/DR-H1_Drainage_Above_Ground.dxf
SITE DIAGRAM 1:200
HEADHOUSE ROOF 27.84 m2
STAIRWELL ROOF 13.60 m2
ENGINEERED COVER 136.40 m2
SHEDS AT THE SURFACE, NOT PIPED
CH-10 300 CHANNEL + GRATING
SU-02 1.0 m3 + 2 x 2 L/s
GY-11 -> EXTERNAL SOAKAWAY
NEVER TO THE CLEAN SUMP
FLOW PATH - SOURCE / COLLECTION / CONVEYANCE / DISCHARGE
RAIN 50 mm/h [C]
no return period - VERIFY
ROOFS + COVER
177.23 m2 -> 2.461 L/s [R]
SURFACE, FALLS 1:50 AWAY
crowned grade [C]
GROUND AT THE BERM TOE
no piped roof drainage
ENTRY THRESHOLD
door at grade, falls away 1:50
CH-10 CHANNEL
full 1500 width [C]
CP-10 CATCHPIT
trapped, silt bucket [A]
SK-02 STORM SOAKAWAY
position not fixed [N]
DOOR OPEN, DRIVING RAIN
1 m3 / 32 h [C] drg 5 note 9
GY-10 PLATFORM GULLY
(-)2.000 [C]
SU-02 1.0 m3
2 L/s duty + standby, NRV [C]
SK-03 OWN SOAKAWAY
54.6 h to recover - DR-F3
KEY PARAMETERS
PARAMETER
VALUE
CLASS
Rainfall intensity
50 mm/h
[C] Rev F drg 5 n1
Runoff coefficient
1.00
[A] conservative
Roof + cover catchment
177.23 m2
[R]
Peak surface flow
2.461 L/s
ITEM
Threshold channel
300 x 1500
[C] Rev F
Stairwell sump / pump
1.0 m3 / 2 L/s
[C] drg 5 n9
Storm soakaway SK-02
2.0 dia x 3.5
[A] this package
Foul soak pit SK-01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
