yatineode128-hue/underground-shelter-project/HVAC/Handout/HV-H1_HVAC_Normal_Operation.dxf

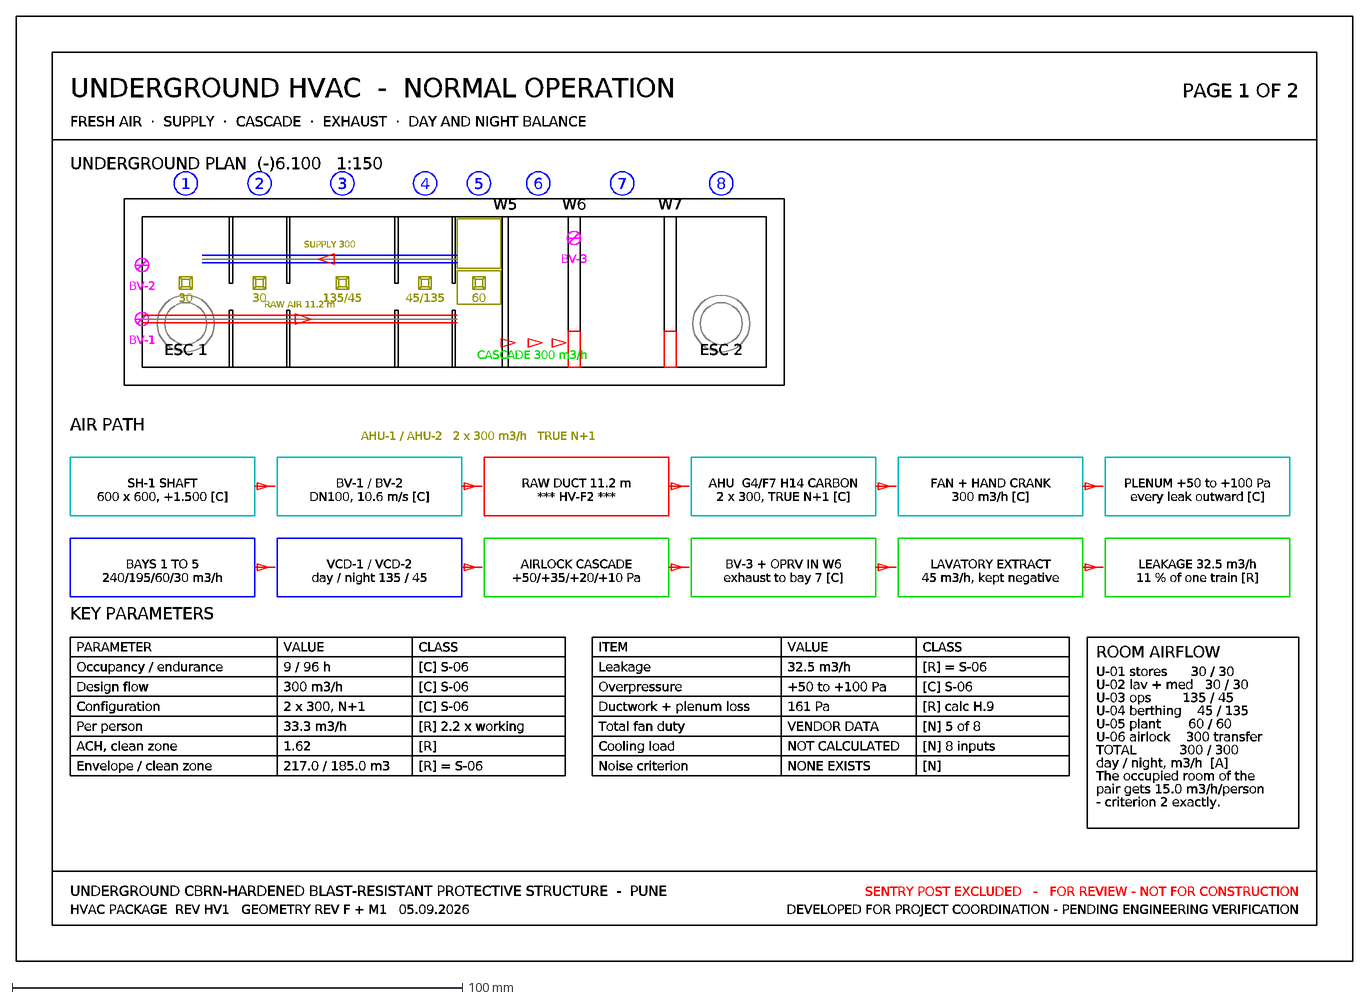
[picture p2: CAD file, 2026-09-11]
HVAC/Handout/HV-H1_HVAC_Normal_Operation.dxf
UNDERGROUND PLAN (-)6.100 1:150
W5
W6
W7
ESC 1
ESC 2
1
2
3
4
5
6
7
8
AHU-1 / AHU-2 2 x 300 m3/h TRUE N+1
BV-1
BV-2
BV-3
RAW AIR 11.2 m
SUPPLY 300
30
135/45
45/135
60
CASCADE 300 m3/h
AIR PATH
SH-1 SHAFT
600 x 600, +1.500 [C]
BV-1 / BV-2
DN100, 10.6 m/s [C]
RAW DUCT 11.2 m
*** HV-F2 ***
AHU G4/F7 H14 CARBON
2 x 300, TRUE N+1 [C]
FAN + HAND CRANK
300 m3/h [C]
PLENUM +50 to +100 Pa
every leak outward [C]
BAYS 1 TO 5
240/195/60/30 m3/h
VCD-1 / VCD-2
day / night 135 / 45
AIRLOCK CASCADE
+50/+35/+20/+10 Pa
BV-3 + OPRV IN W6
exhaust to bay 7 [C]
LAVATORY EXTRACT
45 m3/h, kept negative
LEAKAGE 32.5 m3/h
11 % of one train [R]
KEY PARAMETERS
PARAMETER
VALUE
CLASS
Occupancy / endurance
9 / 96 h
[C] S-06
Design flow
300 m3/h
Configuration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
