yatineode128-hue/underground-shelter-project/Presentation Sheets/DXF/WMS013_Works_Management_Master_Programme_and_Bill_of_Quantities.dxf

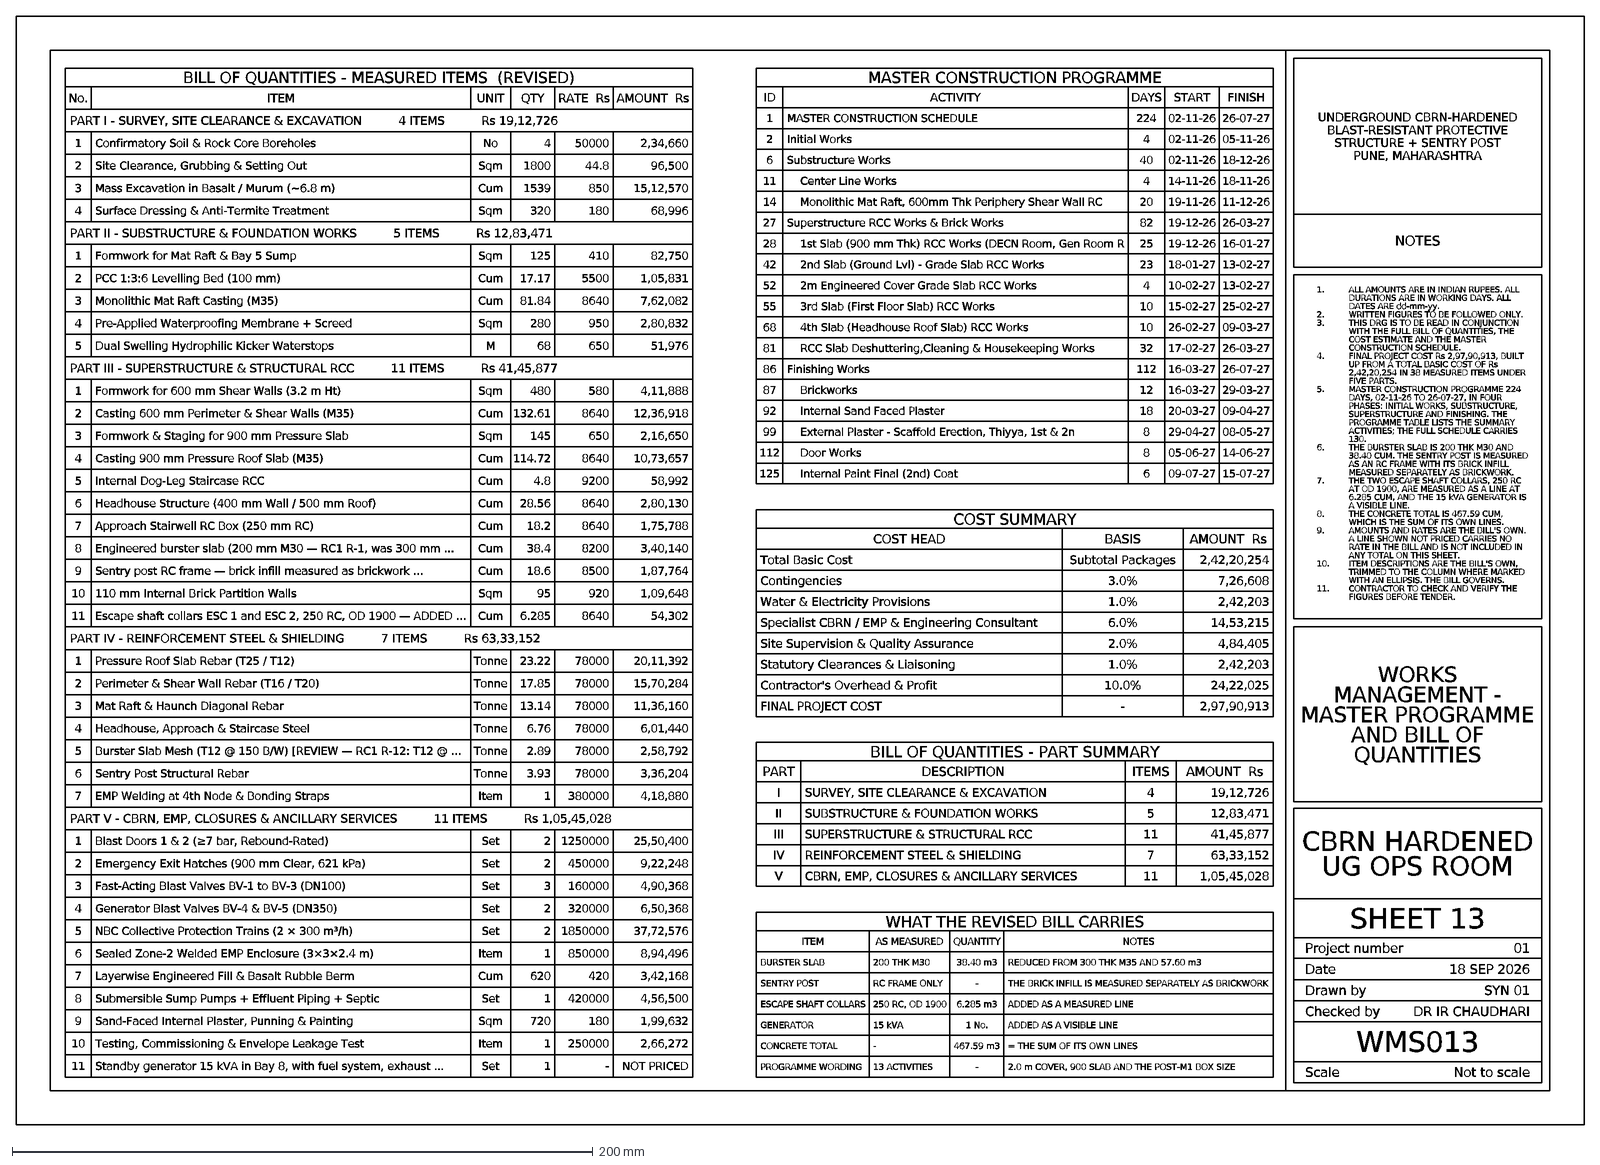
[picture p3: CAD file, 2026-09-18]
Presentation Sheets/DXF/WMS013_Works_Management_Master_Programme_and_Bill_of_Quantities.dxf
UNDERGROUND CBRN-HARDENED
BLAST-RESISTANT PROTECTIVE
STRUCTURE + SENTRY POST
PUNE, MAHARASHTRA
NOTES
1.
ALL AMOUNTS ARE IN INDIAN RUPEES. ALL
DURATIONS ARE IN WORKING DAYS. ALL
DATES ARE dd-mm-yy.
2.
WRITTEN FIGURES TO BE FOLLOWED ONLY.
3.
THIS DRG IS TO BE READ IN CONJUNCTION
WITH THE FULL BILL OF QUANTITIES, THE
COST ESTIMATE AND THE MASTER
CONSTRUCTION SCHEDULE.
4.
FINAL PROJECT COST Rs 2,97,90,913, BUILT
UP FROM A TOTAL BASIC COST OF Rs
2,42,20,254 IN 38 MEASURED ITEMS UNDER
FIVE PARTS.
5.
MASTER CONSTRUCTION PROGRAMME 224
DAYS, 02-11-26 TO 26-07-27, IN FOUR
PHASES: INITIAL WORKS, SUBSTRUCTURE,
SUPERSTRUCTURE AND FINISHING. THE
PROGRAMME TABLE LISTS THE SUMMARY
ACTIVITIES; THE FULL SCHEDULE CARRIES
130.
6.
THE BURSTER SLAB IS 200 THK M30 AND
38.40 CUM. THE SENTRY POST IS MEASURED
AS AN RC FRAME WITH ITS BRICK INFILL
MEASURED SEPARATELY AS BRICKWORK.
7.
THE TWO ESCAPE SHAFT COLLARS, 250 RC
AT OD 1900, ARE MEASURED AS A LINE AT
6.285 CUM, AND THE 15 kVA GENERATOR IS
A VISIBLE LINE.
8.
THE CONCRETE TOTAL IS 467.59 CUM,
WHICH IS THE SUM OF ITS OWN LINES.
9.
AMOUNTS AND RATES ARE THE BILL'S OWN.
A LINE SHOWN NOT PRICED CARRIES NO
RATE IN THE BILL AND IS NOT INCLUDED IN
ANY TOTAL ON THIS SHEET.
10.
ITEM DESCRIPTIONS ARE THE BILL'S OWN,
TRIMMED TO THE COLUMN WHERE MARKED
WITH AN ELLIPSIS. THE BILL GOVERNS.
11.
CONTRACTOR TO CHECK AND VERIFY THE
FIGURES BEFORE TENDER.
WORKS
MANAGEMENT -
MASTER PROGRAMME
AND BILL OF
QUANTITIES
CBRN HARDENED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
