yatineode128-hue/underground-shelter-project/Drainage/Handout/DR-H2_Drainage_Underground.dxf

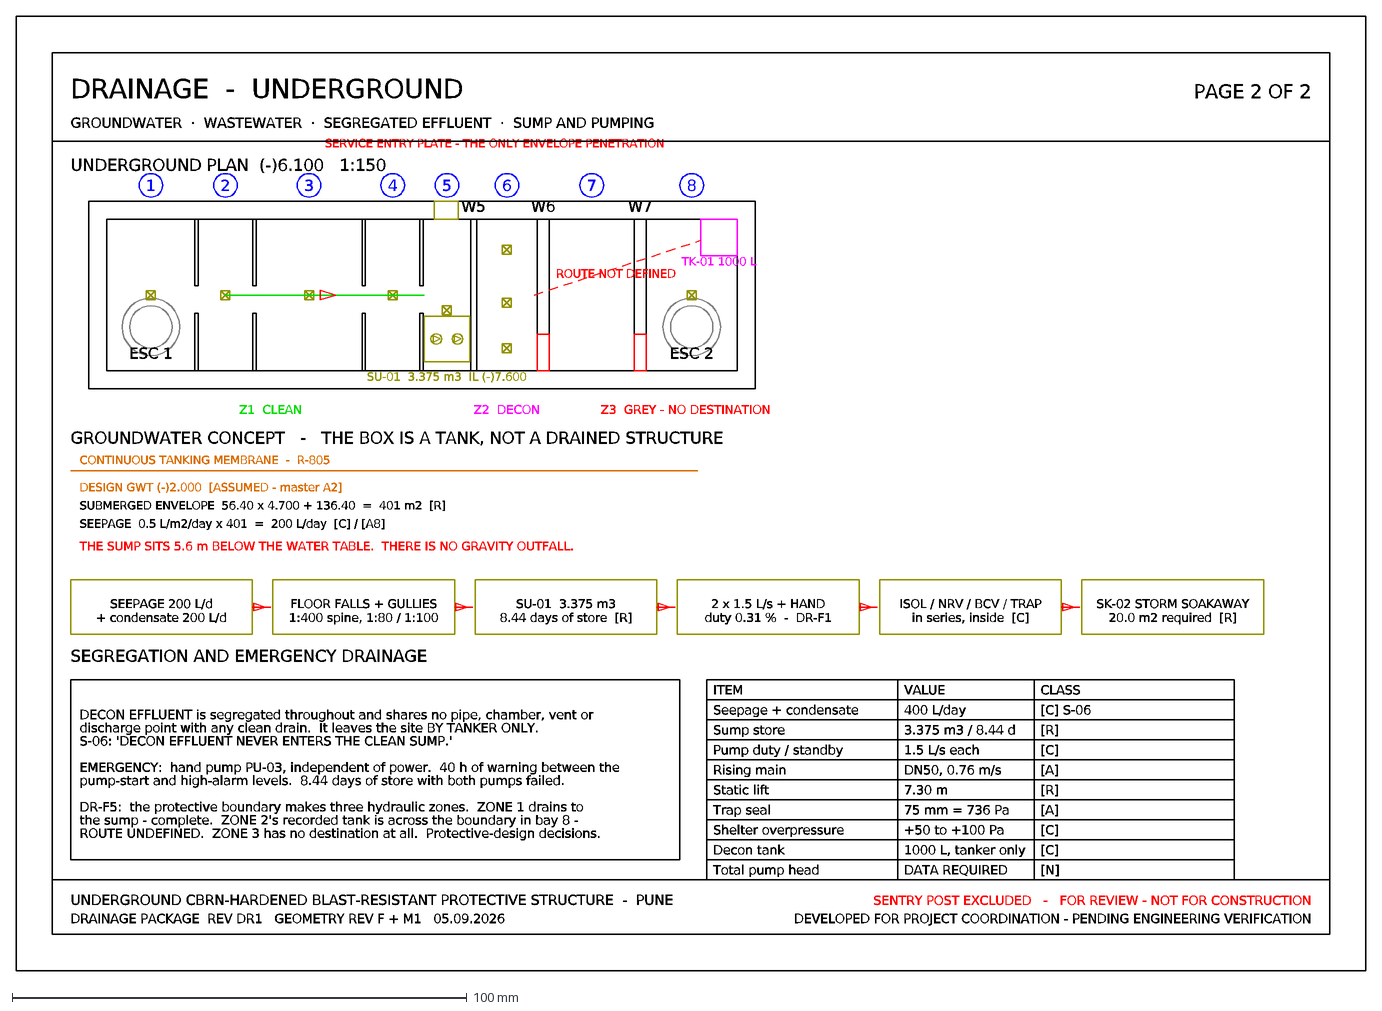
[picture p4: CAD file, 2026-09-10]
Drainage/Handout/DR-H2_Drainage_Underground.dxf
UNDERGROUND PLAN (-)6.100 1:150
W5
W6
W7
ESC 1
ESC 2
1
2
3
4
5
6
7
8
SU-01 3.375 m3 IL (-)7.600
SERVICE ENTRY PLATE - THE ONLY ENVELOPE PENETRATION
TK-01 1000 L
ROUTE NOT DEFINED
Z1 CLEAN
Z2 DECON
Z3 GREY - NO DESTINATION
GROUNDWATER CONCEPT - THE BOX IS A TANK, NOT A DRAINED STRUCTURE
CONTINUOUS TANKING MEMBRANE - R-805
DESIGN GWT (-)2.000 [ASSUMED - master A2]
SUBMERGED ENVELOPE 56.40 x 4.700 + 136.40 = 401 m2 [R]
SEEPAGE 0.5 L/m2/day x 401 = 200 L/day [C] / [A8]
THE SUMP SITS 5.6 m BELOW THE WATER TABLE. THERE IS NO GRAVITY OUTFALL.
SEEPAGE 200 L/d
+ condensate 200 L/d
FLOOR FALLS + GULLIES
1:400 spine, 1:80 / 1:100
SU-01 3.375 m3
8.44 days of store [R]
2 x 1.5 L/s + HAND
duty 0.31 % - DR-F1
ISOL / NRV / BCV / TRAP
in series, inside [C]
SK-02 STORM SOAKAWAY
20.0 m2 required [R]
SEGREGATION AND EMERGENCY DRAINAGE
DECON EFFLUENT is segregated throughout and shares no pipe, chamber, vent or
discharge point with any clean drain. It leaves the site BY TANKER ONLY.
S-06: 'DECON EFFLUENT NEVER ENTERS THE CLEAN SUMP.'
EMERGENCY: hand pump PU-03, independent of power. 40 h of warning between the
pump-start and high-alarm levels. 8.44 days of store with both pumps failed.
DR-F5: the protective boundary makes three hydraulic zones. ZONE 1 drains to
the sump - complete. ZONE 2's recorded tank is across the boundary in bay 8 -
ROUTE UNDEFINED. ZONE 3 has no destination at all. Protective-design decisions.
ITEM
VALUE
CLASS
Seepage + condensate
400 L/day
[C] S-06
Sump store
3.375 m3 / 8.44 d
[R]
Pump duty / standby
1.5 L/s each
[C]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
