yatineode128-hue/underground-shelter-project/HVAC/Handout/HV-H2_HVAC_Emergency_Protective_Operation.dxf

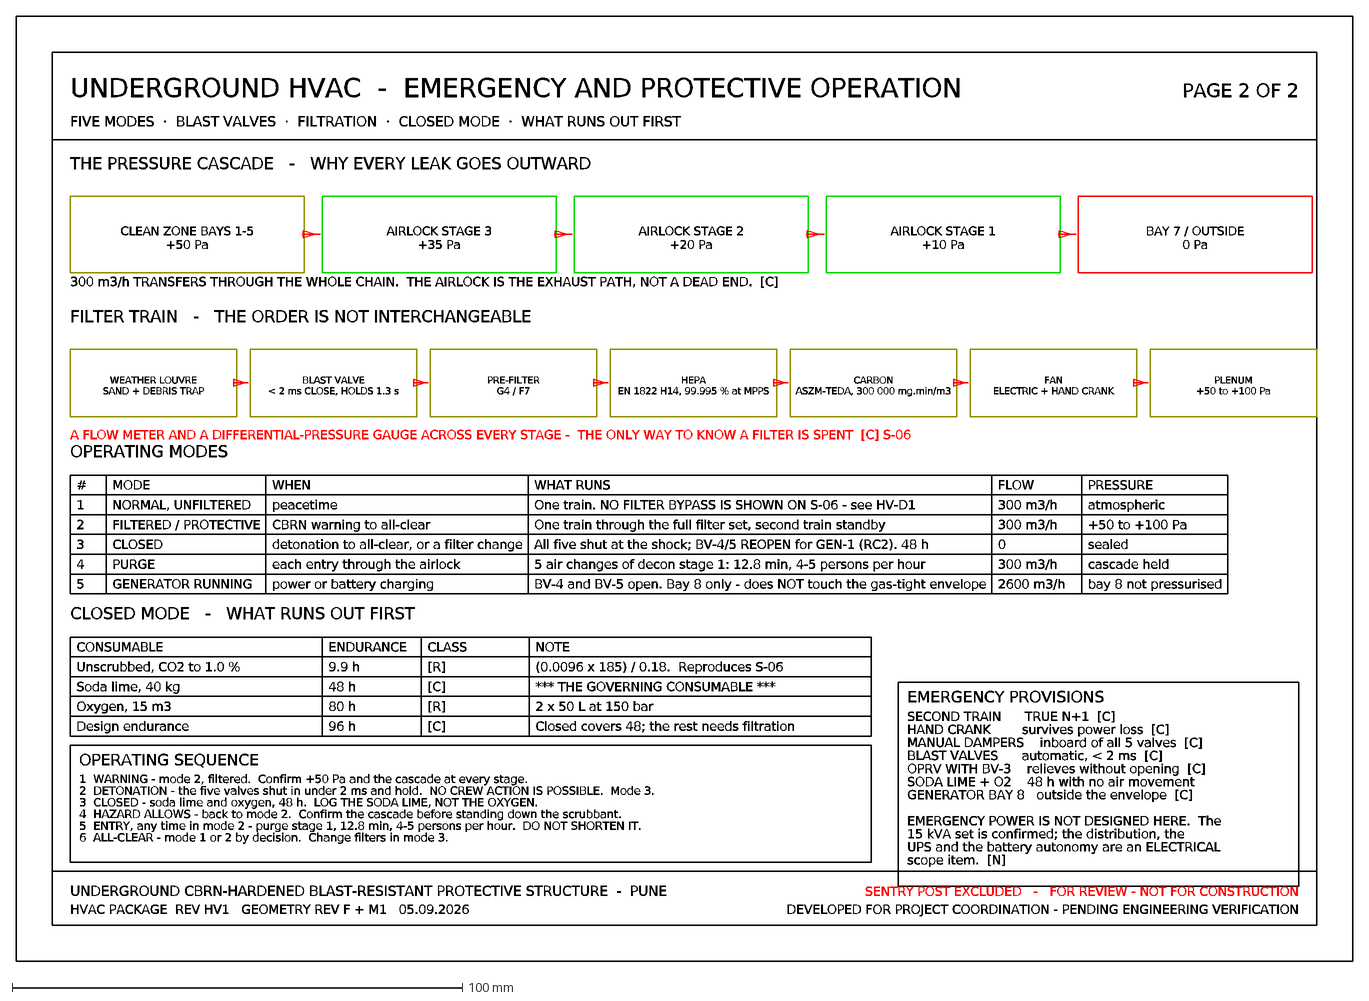
[picture p5: CAD file, 2026-09-11]
HVAC/Handout/HV-H2_HVAC_Emergency_Protective_Operation.dxf
THE PRESSURE CASCADE - WHY EVERY LEAK GOES OUTWARD
CLEAN ZONE BAYS 1-5
+50 Pa
AIRLOCK STAGE 3
+35 Pa
AIRLOCK STAGE 2
+20 Pa
AIRLOCK STAGE 1
+10 Pa
BAY 7 / OUTSIDE
0 Pa
300 m3/h TRANSFERS THROUGH THE WHOLE CHAIN. THE AIRLOCK IS THE EXHAUST PATH, NOT A DEAD END. [C]
FILTER TRAIN - THE ORDER IS NOT INTERCHANGEABLE
WEATHER LOUVRE
SAND + DEBRIS TRAP
BLAST VALVE
< 2 ms CLOSE, HOLDS 1.3 s
PRE-FILTER
G4 / F7
HEPA
EN 1822 H14, 99.995 % at MPPS
CARBON
ASZM-TEDA, 300 000 mg.min/m3
FAN
ELECTRIC + HAND CRANK
PLENUM
+50 to +100 Pa
A FLOW METER AND A DIFFERENTIAL-PRESSURE GAUGE ACROSS EVERY STAGE - THE ONLY WAY TO KNOW A FILTER IS SPENT [C] S-06
OPERATING MODES
#
MODE
WHEN
WHAT RUNS
FLOW
PRESSURE
1
NORMAL, UNFILTERED
peacetime
One train. NO FILTER BYPASS IS SHOWN ON S-06 - see HV-D1
300 m3/h
atmospheric
2
FILTERED / PROTECTIVE
CBRN warning to all-clear
One train through the full filter set, second train standby
3
CLOSED
detonation to all-clear, or a filter change
All five shut at the shock; BV-4/5 REOPEN for GEN-1 (RC2). 48 h
0
sealed
4
PURGE
each entry through the airlock
5 air changes of decon stage 1: 12.8 min, 4-5 persons per hour
cascade held
5
GENERATOR RUNNING
power or battery charging
BV-4 and BV-5 open. Bay 8 only - does NOT touch the gas-tight envelope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
