yatineode128-hue/underground-shelter-project/Presentation Sheets/DXF/STR009_Structural_Reinforcement_Detailing_Sentry_Post_Footing_and_Slab.dxf

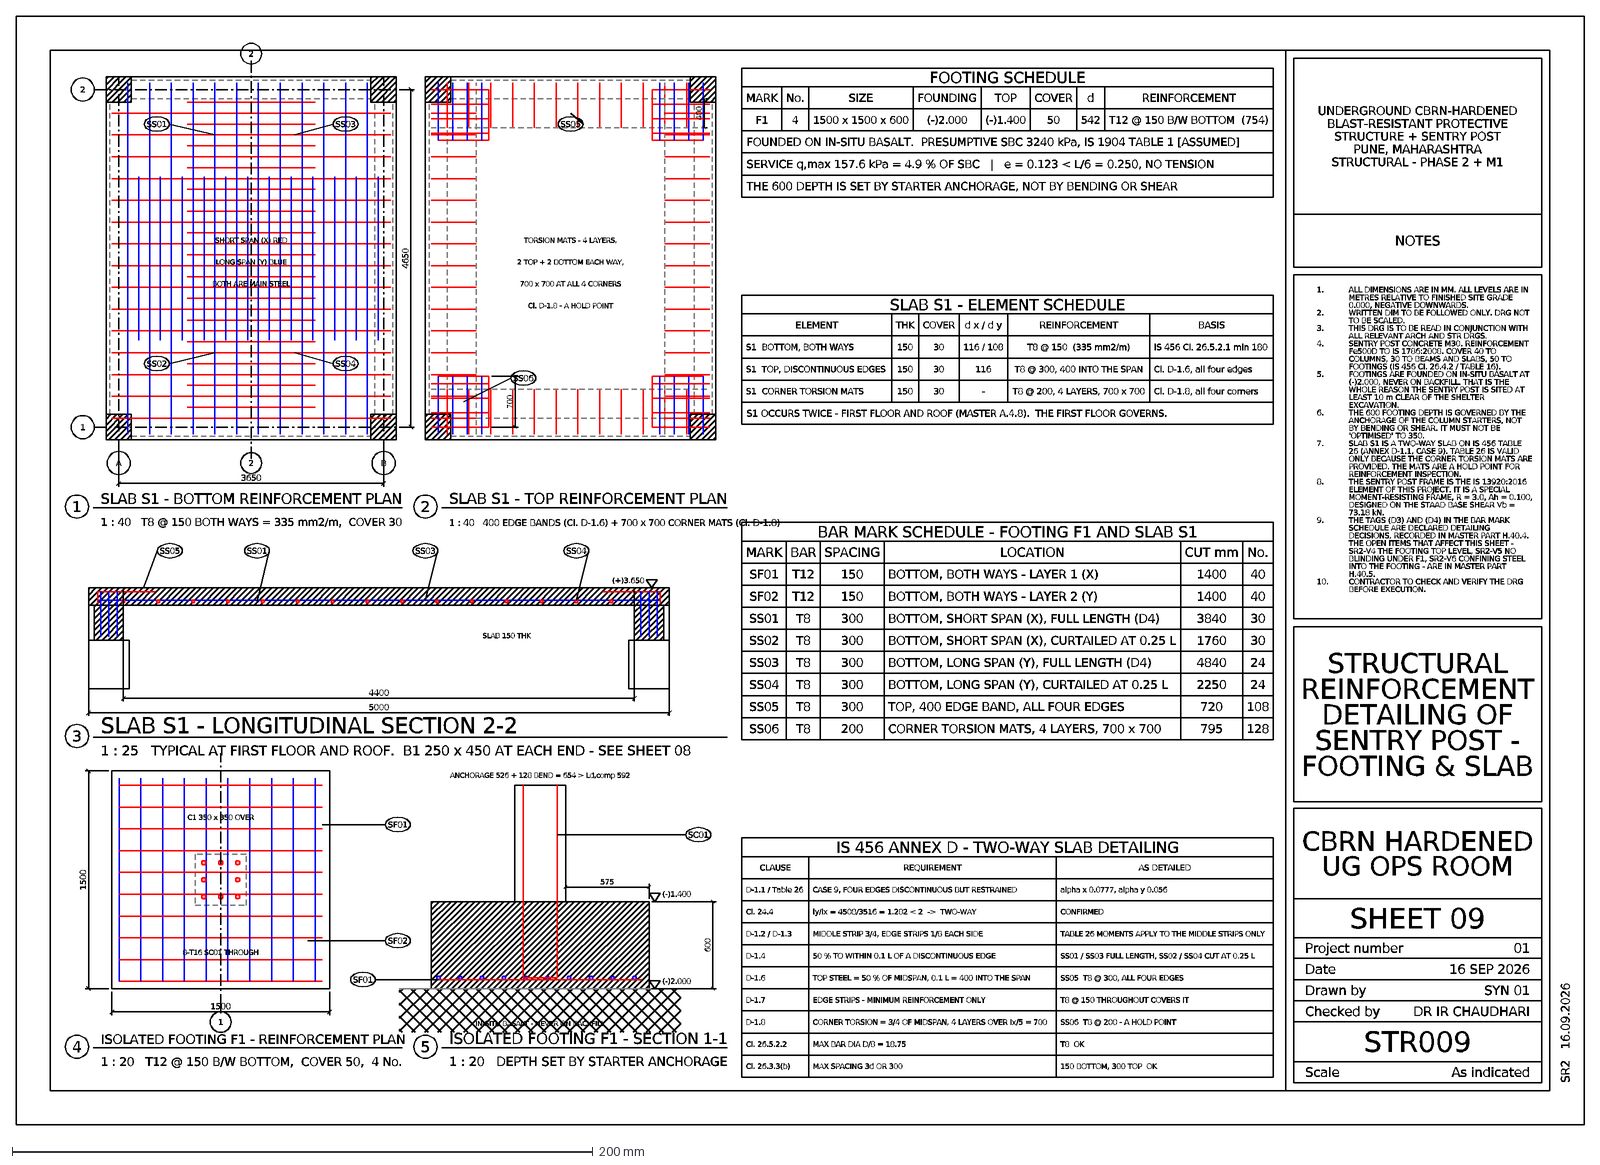
[picture p6: CAD file, 2026-09-16]
Presentation Sheets/DXF/STR009_Structural_Reinforcement_Detailing_Sentry_Post_Footing_and_Slab.dxf
UNDERGROUND CBRN-HARDENED
BLAST-RESISTANT PROTECTIVE
STRUCTURE + SENTRY POST
PUNE, MAHARASHTRA
STRUCTURAL - PHASE 2 + M1
NOTES
1.
ALL DIMENSIONS ARE IN MM. ALL LEVELS ARE IN
METRES RELATIVE TO FINISHED SITE GRADE
0.000, NEGATIVE DOWNWARDS.
2.
WRITTEN DIM TO BE FOLLOWED ONLY. DRG NOT
TO BE SCALED.
3.
THIS DRG IS TO BE READ IN CONJUNCTION WITH
ALL RELEVANT ARCH AND STR DRGS.
4.
SENTRY POST CONCRETE M30. REINFORCEMENT
Fe500D TO IS 1786:2008. COVER 40 TO
COLUMNS, 30 TO BEAMS AND SLABS, 50 TO
FOOTINGS (IS 456 Cl. 26.4.2 / TABLE 16).
5.
FOOTINGS ARE FOUNDED ON IN-SITU BASALT AT
(-)2.000, NEVER ON BACKFILL. THAT IS THE
WHOLE REASON THE SENTRY POST IS SITED AT
LEAST 10 m CLEAR OF THE SHELTER
EXCAVATION.
6.
THE 600 FOOTING DEPTH IS GOVERNED BY THE
ANCHORAGE OF THE COLUMN STARTERS, NOT
BY BENDING OR SHEAR. IT MUST NOT BE
'OPTIMISED' TO 350.
7.
SLAB S1 IS A TWO-WAY SLAB ON IS 456 TABLE
26 (ANNEX D-1.1, CASE 9). TABLE 26 IS VALID
ONLY BECAUSE THE CORNER TORSION MATS ARE
PROVIDED. THE MATS ARE A HOLD POINT FOR
REINFORCEMENT INSPECTION.
8.
THE SENTRY POST FRAME IS THE IS 13920:2016
ELEMENT OF THIS PROJECT. IT IS A SPECIAL
MOMENT-RESISTING FRAME, R = 3.0, Ah = 0.100,
DESIGNED ON THE STAAD BASE SHEAR Vb =
73.18 kN.
9.
THE TAGS (D3) AND (D4) IN THE BAR MARK
SCHEDULE ARE DECLARED DETAILING
DECISIONS, RECORDED IN MASTER PART H.40.4.
THE OPEN ITEMS THAT AFFECT THIS SHEET -
SR2-V4 THE FOOTING TOP LEVEL, SR2-V5 NO
BLINDING UNDER F1, SR2-V6 CONFINING STEEL
INTO THE FOOTING - ARE IN MASTER PART
H.40.5.
10.
CONTRACTOR TO CHECK AND VERIFY THE DRG
BEFORE EXECUTION.
STRUCTURAL
REINFORCEMENT
DETAILING OF
SENTRY POST -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
