yatineode128-hue/underground-shelter-project/Presentation Sheets/DXF/STR006_Structural_Reinforcement_Detailing_Roof_Slab_and_Mat_Foundation.dxf

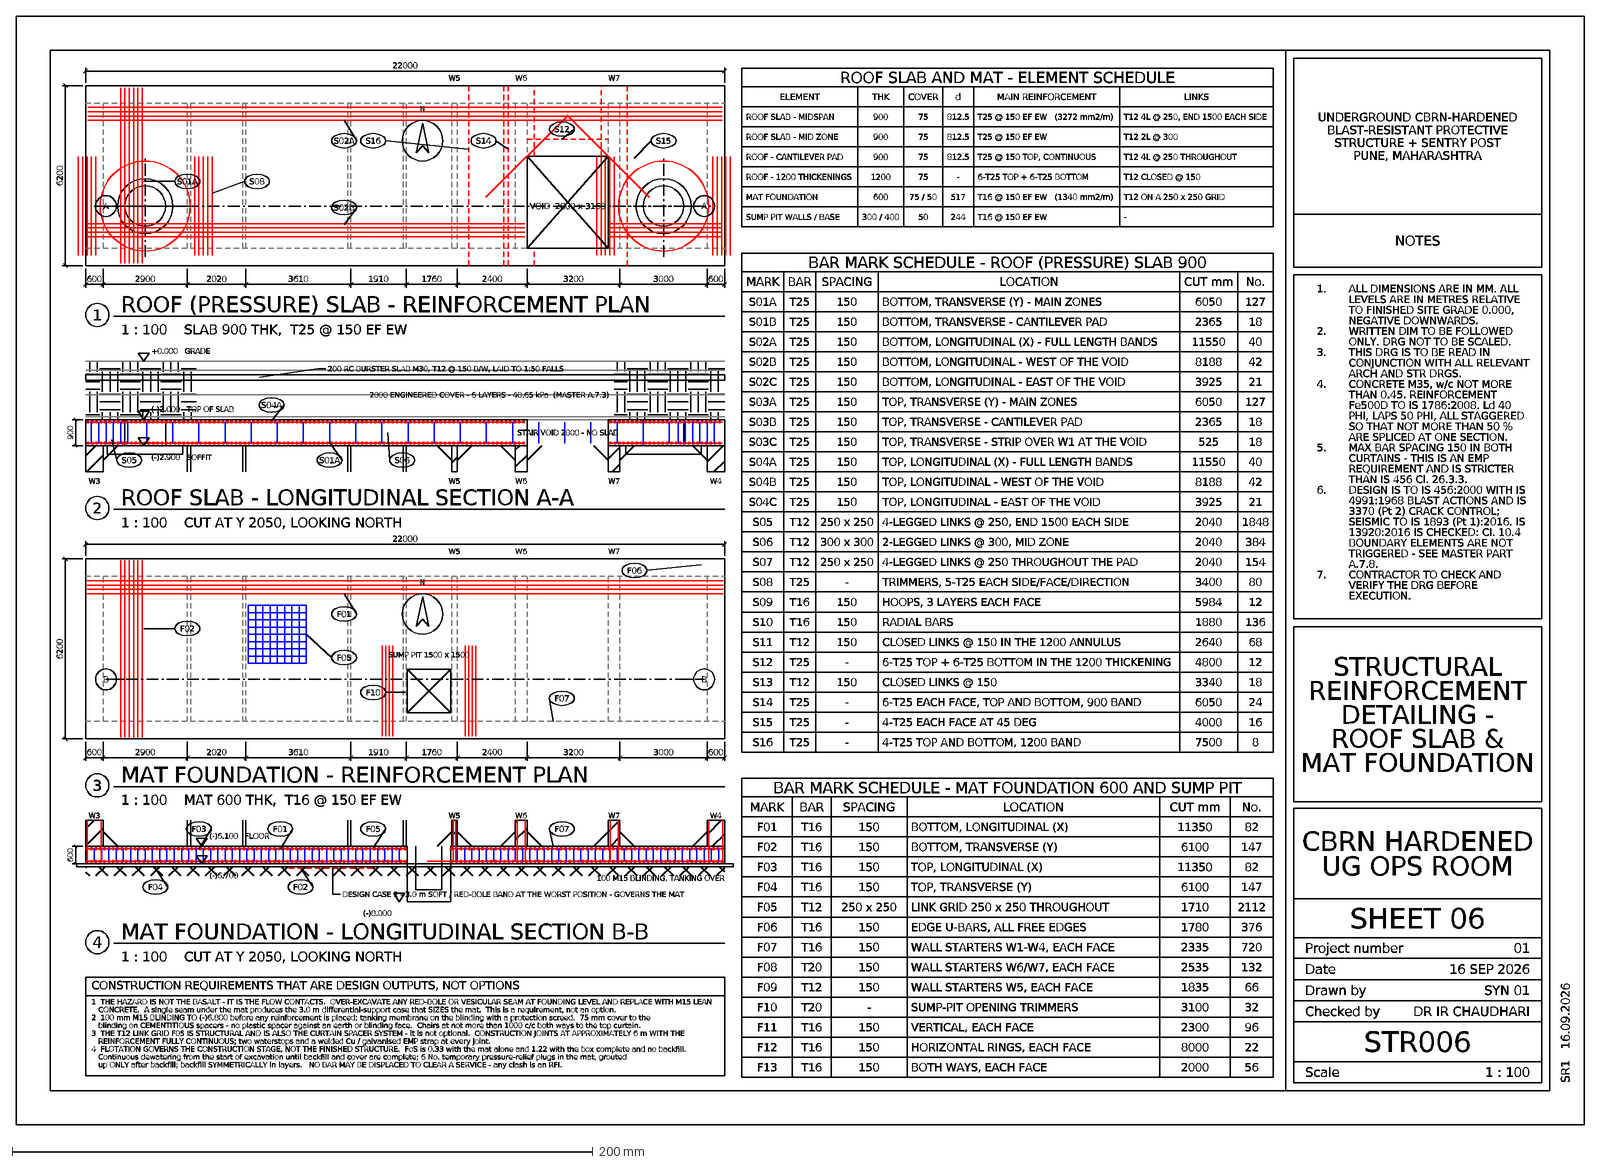
[picture p7: CAD file, 2026-09-16]
Presentation Sheets/DXF/STR006_Structural_Reinforcement_Detailing_Roof_Slab_and_Mat_Foundation.dxf
UNDERGROUND CBRN-HARDENED
BLAST-RESISTANT PROTECTIVE
STRUCTURE + SENTRY POST
PUNE, MAHARASHTRA
NOTES
1.
ALL DIMENSIONS ARE IN MM. ALL
LEVELS ARE IN METRES RELATIVE
TO FINISHED SITE GRADE 0.000,
NEGATIVE DOWNWARDS.
2.
WRITTEN DIM TO BE FOLLOWED
ONLY. DRG NOT TO BE SCALED.
3.
THIS DRG IS TO BE READ IN
CONJUNCTION WITH ALL RELEVANT
ARCH AND STR DRGS.
4.
CONCRETE M35, w/c NOT MORE
THAN 0.45. REINFORCEMENT
Fe500D TO IS 1786:2008. Ld 40
PHI, LAPS 50 PHI, ALL STAGGERED
SO THAT NOT MORE THAN 50 %
ARE SPLICED AT ONE SECTION.
5.
MAX BAR SPACING 150 IN BOTH
CURTAINS - THIS IS AN EMP
REQUIREMENT AND IS STRICTER
THAN IS 456 Cl. 26.3.3.
6.
DESIGN IS TO IS 456:2000 WITH IS
4991:1968 BLAST ACTIONS AND IS
3370 (Pt 2) CRACK CONTROL;
SEISMIC TO IS 1893 (Pt 1):2016. IS
13920:2016 IS CHECKED: Cl. 10.4
BOUNDARY ELEMENTS ARE NOT
TRIGGERED - SEE MASTER PART
A.7.8.
7.
CONTRACTOR TO CHECK AND
VERIFY THE DRG BEFORE
EXECUTION.
STRUCTURAL
REINFORCEMENT
DETAILING -
ROOF SLAB &
MAT FOUNDATION
CBRN HARDENED
UG OPS ROOM
SHEET 06
STR006
Project number
01
Date
16 SEP 2026
Drawn by
SYN 01
Checked by
DR IR CHAUDHARI
Scale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
