yatineode128-hue/underground-shelter-project/(list of files, cad)

Other CAD files:
Structural CAD/DXF/Stairs/R-601_Main_Staircase_Reinforcement_Plan.dxf
Structural CAD/DXF/Stairs/R-602_Main_Staircase_Sections.dxf
Presentation Sheets/DXF/STR007_Structural_Reinforcement_Detailing_Shear_Wall_and_Main_Staircase.dxf
current/cad/2_Side_Section_with_Stairs.dxf
Drainage/DXF/D-301_Drainage_Sections.dxf
Electrical/DXF/E-001_Single_Line_Diagram.dxf
EMP Protection/DXF/EM-101_EMP_Zone_Plan_Underground.dxf
Fire and Life Safety/DXF/F-102_Entry_Level_Escape_Plan.dxf
HVAC/DXF/M-203_Emergency_Protective_Ventilation_Schematic.dxf
Schedule of Finishes/DXF/A-601_Finish_Legend_Notes_and_Typical_Details.dxf
Site and Concealment/DXF/C-101_Above_Ground_Signature_Elevation.dxf
Site Selection and Geotechnical/DXF/SG-001_Site_and_Geotechnical_Design_Basis.dxf
Structural CAD/DXF/Beams/R-402_Beam_Type_Element_Details.dxf
Structural CAD/DXF/Entrance/R-703_Blast_Door_Opening_Details.dxf
Structural CAD/DXF/Foundations/R-102_Mat_Foundation_Sections.dxf
Structural CAD/DXF/General/R-004_Reinforcement_Schedule.dxf
Structural CAD/DXF/Headhouse/R-701_Headhouse_Reinforcement.dxf
Structural CAD/DXF/Slabs/R-301_Roof_Slab_Reinforcement_Plan.dxf
Structural CAD/DXF/Stairs/R-604_Stair_Connection_Details.dxf
Structural CAD/DXF/Typical_Details/R-805_Waterproofing_Structural_Interface.dxf
Structural CAD/DXF/Walls/R-205_Opening_Reinforcement_Details.dxf
current/cad/5_Front_Elevation.dxf
Drainage/DXF/D-203_Underground_Wastewater_and_Sanitary_Plan.dxf
EMP Protection/DXF/EM-302_EMP_Penetration_Bonding_and_Earthing_Details.dxf
Fire and Life Safety/DXF/F-101_Underground_Level_Escape_Plan.dxf
HVAC/DXF/M-202_Duct_and_Equipment_Details.dxf
Presentation Sheets/DXF/ARCH002_Sentry_Post_Floor_Plans_and_South_Elevation_Redrawn_to_Project_Data.dxf
Schedule of Finishes/DXF/A-612_Underground_Level_Finish_Plan.dxf
Site Selection and Geotechnical/DXF/SG-201_Geotechnical_Profile_and_Structure_Section.dxf
Structural CAD/DXF/Beams/R-401_Beam_Type_Element_Location_Plan.dxf
Structural CAD/DXF/Entrance/R-702_Entrance_Reinforcement.dxf
Structural CAD/DXF/Foundations/R-101_Mat_Foundation_Reinforcement_Plan.dxf
Structural CAD/DXF/General/R-003_Typical_Reinforcement_Details.dxf
Structural CAD/DXF/Slabs/R-304_Roof_Wall_Junction_Details.dxf
Structural CAD/DXF/Typical_Details/R-803_Wall_Slab_Connections.dxf
Structural CAD/DXF/Walls/R-201_External_Wall_Reinforcement.dxf
current/cad/5_Entry_Headhouse_Stair_Section.dxf
Drainage/DXF/D-103_Entry_Stairwell_and_Headhouse_Drainage.dxf
EMP Protection/DXF/EM-201_Shielding_Effectiveness_Cage_and_Apertures.dxf
HVAC/DXF/M-201_HVAC_Sections.dxf
Presentation Sheets/DXF/MEP010_HVAC_and_EMP_Zone_Layout_Plans.dxf
Schedule of Finishes/DXF/A-611_Entry_Level_Finish_Plan.dxf
Site Selection and Geotechnical/DXF/SG-101_Site_Setting_Selection_and_Meteorology.dxf
Structural CAD/DXF/Foundations/R-103_Foundation_Wall_Details.dxf
Structural CAD/DXF/General/R-002_Reinforcement_Legend_and_Symbols.dxf
Structural CAD/DXF/Slabs/R-302_Roof_Sections.dxf
Structural CAD/DXF/Stairs/R-603_Entry_Stairwell_Reinforcement.dxf
Structural CAD/DXF/Typical_Details/R-804_Construction_Joints.dxf
Structural CAD/DXF/Walls/R-203_Wall_Elevations.dxf
current/cad/3_Sentry_Post_Ground_Floor_Plan.dxf
Drainage/DXF/D-201_Underground_Drainage_Plan.dxf
EMP Protection/DXF/EM-001_EMP_Design_Basis_and_Zone_Key.dxf
HVAC/DXF/M-001_HVAC_General_Notes_and_Design_Basis.dxf
Presentation Sheets/DXF/FLS012_Fire_and_Life_Safety_Escape_Plan_and_Decision_Rule.dxf
Site Selection and Geotechnical/DXF/SG-202_External_Works_Siting_and_Soak_Pit_Finding.dxf
Structural CAD/DXF/General/R-001_General_Reinforcement_Notes.dxf
Structural CAD/DXF/Slabs/R-303_Roof_Opening_Details.dxf
Structural CAD/DXF/Typical_Details/R-801_Anchorage_and_Development.dxf
Structural CAD/DXF/Walls/R-202_Internal_Wall_Reinforcement.dxf
current/cad/06_Underground_Plan_Services_Sump_BlastValves.dxf
Drainage/DXF/D-102_Rainwater_Catchment_and_Surface_Water_Plan.dxf
EMP Protection/DXF/EM-301_EMP_Zone_2_Enclosure.dxf
HVAC/DXF/M-102_Fresh_Air_and_Exhaust_Plan.dxf
Presentation Sheets/DXF/MEP011_Septic_Tank_Soak_Pit_and_Sump_Pit_Plans_Sections_and_Schedules.dxf
Site Selection and Geotechnical/DXF/SG-102_Site_Layout_Plan.dxf
Structural CAD/DXF/Typical_Details/R-802_Lap_and_Splice_Details.dxf
Structural CAD/DXF/Walls/R-204_Wall_Sections.dxf
current/cad/1_Staircase_Section.dxf
Drainage/DXF/D-204_Sump_and_Pumping.dxf
EMP Protection/DXF/EM-102_EMP_Boundary_Section_Entry_Path.dxf
HVAC/DXF/M-101_Underground_HVAC_Ventilation_Plan.dxf
Presentation Sheets/DXF/ARCH001_Underground_Headhouse_and_Ground_Level_Plans_Redrawn_to_Project_Data.dxf
current/cad/3_Headhouse_Section_Cutaway.dxf
Drainage/DXF/D-002_Drainage_Symbols_and_Pipe_Coding.dxf
current/cad/2_Ground_Plan_Headhouse_Berm.dxf
Drainage/DXF/D-305_Septic_Tank_Soak_Pit_and_Chamber_Details.dxf
current/cad/1_Underground_Level_Plan.dxf
Drainage/DXF/D-101_Above_Ground_Entry_Level_Drainage_Plan.dxf
Presentation Sheets/DXF/STR008_Structural_Reinforcement_Detailing_Sentry_Post_Beams_and_Column.dxf
current/cad/6_Sentry_Post_Framing_Plan.dxf
Drainage/DXF/D-304_Pipe_Penetration_and_Waterproofing_Details.dxf
current/cad/4_Sentry_Post_First_Floor_Plan.dxf
Drainage/DXF/D-001_General_Drainage_Notes_Legend_Design_Basis.dxf
