yatineode128-hue/underground-shelter-project/HVAC/Schedules/OPERATING_MODE_SCHEDULE.md

# OPERATING MODE SCHEDULE

**Underground CBRN-hardened protective structure — Pune** · GEOMETRY REV F + M1
HVAC package revision **HV1** · 05.09.2026 · **FOR REVIEW - NOT FOR CONSTRUCTION**
**Sentry post excluded.** Evidence class: `[C]` confirmed · `[R]` reconstructed · `[A]` assumed by this package · `[U]` unresolved · `[N]` not available — DATA REQUIRED

| MODE | NAME | WHEN | WHAT RUNS | FLOW | PRESSURE |
|---|---|---|---|---|---|
| 1 | NORMAL, UNFILTERED | peacetime | One train. NO FILTER BYPASS IS SHOWN ON S-06 - see HV-D1 | 300 m3/h | atmospheric |
| 2 | FILTERED / PROTECTIVE | CBRN warning to all-clear | One train through the full filter set, second train standby | 300 m3/h | +50 to +100 Pa |
| 3 | CLOSED | detonation to all-clear, or a filter change | All five shut at the shock; BV-4/5 REOPEN for GEN-1 (RC2). 48 h | 0 | sealed |
| 4 | PURGE | each entry through the airlock | 5 air changes of decon stage 1: 12.8 min, 4-5 persons per hour | 300 m3/h | cascade held |
| 5 | GENERATOR RUNNING | power or battery charging | BV-4 and BV-5 open. Bay 8 only - does NOT touch the gas-tight envelope | 2600 m3/h | bay 8 not pressurised |

> **RULED — RC2, 11 September 2026 (master H.21). THE GENERATOR MAY RUN DURING MODE 3.** As issued, mode 3 said *"all five blast valves shut"* while mode 5 required *"BV-4 and BV-5 open"* and was called *"independent of modes 1–4"*. BV-4 and BV-5 are two of the five, so the two statements could not both hold during mode 3, and the project held no position (EL-V1). **The project owner has ruled: all five valves shut at the shock and hold 1.3 s; BV-4 and BV-5 are then REOPENED for generator operation.** Bay 8 is outside the gas-tight envelope, so the clean zone is unaffected — which is what the mode 5 note always said. **Mode 3's 48 h limit is unchanged: it is set by the soda lime, not by power.** Two consequences are recorded, not resolved: the electrical battery is confirmed at Case A, 149 Ah (master H.20, EL1); and **reopening BV-4/BV-5 leaves two DN350 bores open in the post-attack period — bores that EM1 showed fail both EMP criteria — which sharpens EM-V3, whether bay 8 is inside the EMP boundary, without deciding it.**

**Mode 5 is independent of modes 1–4.** The generator air path (BV-4, BV-5, Bay 8) does not touch the gas-tight envelope — Bay 8 is outside it, behind Blast Door 2 and W7. Running the generator does not depressurise the clean zone and does not consume filter life.

**Mode 3 is limited by the soda lime, not the oxygen** (finding HV-F1): unscrubbed CO₂ alone gives 9.9 h, the 40 kg soda-lime store gives 48 h, the 15 m³ oxygen store gives 80 h. **The consumable to count on the drill card is soda lime.**

**Mode 1 is a gap on S-06** — no filter bypass for peacetime running is shown anywhere. Without one, every hour of peacetime ventilation spends carbon-bed life. **Not added here**: a bypass adds a leak path to the envelope and that is a protective decision (HV-D1).
