yatineode128-hue/underground-shelter-project/WORKS MANAGEMENT/Documentation/WM_CONSTRUCTION_METHODOLOGY.md

<!-- GENERATED by WORKS MANAGEMENT/Scripts/wm_docs.py.  Edit the source
     data in wm_data.py / wm_content.py and re-run wm_build_all.py. -->

# CONSTRUCTION METHODOLOGY
## Underground CBRN-hardened blast-resistant protective structure and sentry post — Pune, Maharashtra

**Works Management package revision WM1** · 07 September 2026
**Geometry:** Architectural Rev F · Structural Phase 2 Rev A + M1 · **Services:** Drainage DR1 · HVAC HV1 · Schedule of Finishes FN1 · Structural CAD SC1
**Evidence classes:** `[C]` confirmed · `[D]` derived here · `[A]` assumed by this package ·
`[U]` unresolved · `[N]` not available — data required

> **THE ONLY DESIGN CHANGE in this package is reference SP-B1: the sentry post walls
> are BRICK MASONRY, replacing the Rev F 200 mm RC ballistic infill panels.
> No other element of the project is changed.**

> **AMENDED 10 September 2026 for design revision SP-B2** (master **A.4.8**, Part
> **H.12**), which designs the **lintel L1** and the **wall tie detail** that SP-B1
> created a need for and this package recorded as not existing. **WM-V5 and WM-V11 are
> closed by it.** The amendment is to the WRITTEN RECORD ONLY — the lintel and tie
> paragraphs, the risk entry, the verification register and the gap list now state the
> designed values instead of saying no design exists. **NO QUANTITY, RATE, DURATION,
> DATE, FLOAT OR RESOURCE IN THIS PACKAGE CHANGED**, and bill item `SP-06` still
> measures the superseded provisional 200 × 150 lintel section: see
> `Documentation/WM_RECONCILIATION_REGISTER.md` §6. **WM-V3, WM-V6 and WM-V7 remain
> open.**

---

This methodology describes how the complete project is built — the underground
shelter, the entry structures, the sentry post with its brick masonry walls, the
services, the cover and the external works — and why the sequence is what it is.

It is written to be read alongside the programme. Every section corresponds to a
level-1 work package, and the decisions explained here are the ones that produce the
logic links in `Underground_Shelter_Final_Works_Programme.xml`.

---

## M1  Site establishment and setting out

The site is a military installation, so the boundary, gate and access control are established before any other activity and workforce security clearance runs in parallel with mobilisation.

Setting out uses the project's own coordinate system (master A.4.1): origin at the south-west external corner of the box at ground level, X east 0 to 22000, Y north 0 to 6200, levels in metres relative to finished grade 0.000. Two permanent benchmarks are established outside the excavation influence zone and checked independently.

The sentry post is set out from the same grid but its site position is ASSUMED in the project — no coordinate for it exists. The only confirmed constraint is that it stands at least 10 m clear of the shelter excavation. That distance is set out and recorded before any excavation begins.

Temporary water supply is sized on curing demand, not domestic demand. About 1060 m² of formed concrete face requires continuous curing for up to 14 days at a time.

## M2  Excavation

Topsoil is stripped 150 deep and STOCKPILED, not carted away: the same material returns as the 300 concealment layer at the top of the engineered cover.

Excavation is 6.800 m deep over a 24.000 x 8.200 envelope, which includes 1.000 m of working space outside the external wall face. That working space is not optional — the external tanking membrane and its protection are applied from outside the structure.

Only the top 1.5 to 2.0 m is soil; below rockhead the material is Deccan basalt. Rock is removed by HYDRAULIC BREAKER, not by blasting. The sentry post founds on the same rock within 10 m, the site is operational, and controlled blasting would require a vibration regime the project has not specified.

The single most important instruction to the excavation gang concerns the flow contacts. Master A.6 is explicit: the hazard is not the basalt but the red-bole and vesicular seams between flows. A single red-bole seam under the mat produces the differential-support case that SIZES the mat. Every seam exposed at formation is over-excavated and replaced with M15 lean concrete before the formation is approved.

The formation is a HOLD POINT. It is trimmed, cleaned of all loose rock, inspected for seams and approved by the Engineer before the blinding is placed.

## M3  Dewatering

The design groundwater table is (-)2.000 in the monsoon and is ASSUMED — the master calls it the single most important number the site investigation must confirm. Of the 15.41 kPa/m lateral gradient on the walls, 9.81 is water and only 5.60 is soil.

Construction dewatering runs continuously from the start of the deep excavation until the side backfill is complete, with a standby pump and an independent power source. Groundwater monitoring during the monsoon is programmed as a critical-path activity precisely because the answer changes the dewatering, the tanking and the flotation check.

Discharge is to the surface water system away from the excavation, through a settlement facility. Silt-laden discharge into the soak pits would destroy their percolation capacity before they are commissioned.

## M4  Blinding, tanking and the mat

100 M15 blinding is placed over the whole formation, projecting 100 beyond the mat, to give a clean surface for the membrane.

The external tanking WP-01 is a CONTINUOUS TANK: horizontal on the blinding, turned up the external wall faces, and lapped to the roof membrane. It is inspected and signed off before it is covered, because after that it can never be seen again.

The mat is cast in a single continuous pour of about 85 m³ including the sump pit, which is cast monolithic with it and has the membrane dressed around it.

Wall starter bars are set with a 900 horizontal leg into the mat and a 50 phi lap above a 150 kicker. Getting the starters wrong at this stage is the most expensive error available on the job.

Curing is 14 days continuous. The mat is a 600 mass section in M35 and is 84 % utilised.

## M5  Walls

The 3.200 m wall height is cast in two lifts of 1.600 m. Vertical construction joints are formed at about 6 m centres; at every joint the reinforcement is FULLY CONTINUOUS and two waterstops plus a welded copper or galvanised EMP strap are installed. A construction joint in a protective structure is simultaneously a water path, a gas path and an EMP discontinuity, and all three have to be closed.

There is no movement joint anywhere inside the protective envelope. The only movement joint on the project is where the covered stairwell raft meets the headhouse — outside the boundary, in the structure that is declared expendable.

Bar spacing is 150 both curtains throughout. This is an EMP requirement and is stricter than IS 456 — it is not a strength requirement and must not be relaxed on site to ease congestion.

The blast door frames are set, aligned and WELDED TO THE CAGE in W6 and W7 before those walls are poured. This is why the doors are ordered on day one: a 75-day frame lead time sits directly upstream of the wall concrete, and a late frame stops the wall.

500 x 500 haunches with diagonal T20 @ 150 are formed at every wall–mat and wall–roof junction.

## M6  Pressure slab

The pressure slab is the governing element: 900 thk, T25 @ 150 each face each way, 20.5 t of reinforcement, carrying 448.15 kPa. It spans ONE WAY across the 5.000 internal width, which is the single fact that makes lengthening the box cheap and widening it expensive.

Falsework carries 104 m² of deck at 3.200 m height and is designed and checked as temporary works.

Reinforcement is fixed in a fixed order: bottom curtain, opening trimmers, escape shaft collar bands, local thickenings, links, top curtain, haunches. The opening details are not incidental — the stair void carries 6-T25 top and bottom with 4-T25 diagonal bars at each re-entrant corner, and each shaft carries 5-T25 on every side, face and direction with the slab thickened 900 to 1200 over a 600 annulus.

IS 4991 Cl. 10.3.1.1 allows NO dynamic increase on shear. That is why the end 1500 of the slab carries four-legged T12 links at 250 that a static design would not need, and it is the most commonly misapplied rule in blast design.

The slab is cast in a single continuous pour of 112 m³. Curing is 14 days. Props remain 14 days — IS 456 Table 11, props to a slab spanning over 4.5 m. This span is 5.000 m clear. Those 19 days sit on the critical path and cannot be argued away.

## M7  Entry structures and escape shafts

The headhouse is built off the top of the pressure slab, its floor being the slab surface at (-)2.000. Wall HW4 aligns exactly with W7 after modification M1; HW3 has no wall beneath it and loads the slab as a line load, which the slab was checked for.

The headhouse roof is 500 thk at 90 % utilisation — the most highly worked element in the project. Its reinforcement inspection is a hold point attended by the structural consultant.

The covered entry stairwell is built on a stepped raft on compacted fill, with the movement joint at the headhouse. It is outside the protective boundary and is DECLARED EXPENDABLE; it is built to IS 456 with normal partial factors and is not blast rated.

The escape shaft collars are 250 RC, OD 1900, rising from the roof slab to +0.150 at ESC 1 and +0.700 at ESC 2. They are built before the engineered cover so that the cover is placed against a finished collar, not around a partly built one.

## M8  Backfill, engineered cover and overburden

The walls are NOT backfilled until the pressure slab is cast and cured. A 3.2 m wall carrying an 83.2 kPa gradient at its base needs the roof as its prop; backfilling earlier means designing and installing temporary propping to do the same job worse.

Side backfill is placed in 250 layers compacted to 95 % MDD and tested in situ before the cover goes on.

The engineered cover is a designed six-layer structure, not a filling operation, and it is built from the bottom up in the reverse of the order given in master A.7.3: 100 protection screed over the membrane, 750 compacted engineered fill at 95 % MDD (the radiation mass), 500 crushed basalt rubble at 25–75 mm (which scatters burster energy), the 200 M30 burster slab reinforced T12 @ 150 both ways (which breaks up a penetrating item), 150 granular filter (which stops fines clogging the rubble) and 300 topsoil and turf (concealment and erosion control).

The 500 rubble layer is won from the site's own rock excavation and crushed on site. About 994 m³ of basalt is excavated and only about 51 m³ of rubble is needed, so the layer costs haulage and crushing and nothing else. This is the largest single saving available on the job.

The cover does not extend over the headhouse, which has no earth cover, nor over the two escape shaft heads.

The completed build-up is verified against master A.7.3 — the design load of 40.65 kPa on the roof depends on those six layers being the thicknesses and materials stated.

## M9  Sentry post — frame

The sentry post is an independent structure and is deliberately NOT started until the main rock breaking is finished. No green concrete stands within 10 m of a hydraulic breaker.

Footings F1 found on in-situ basalt at (-)2.000; the founding stratum is a hold point in the same way as the main formation.

Columns, beams and slabs are detailed to IS 13920 for Zone III. The detail that most often gets lost on site is the column confinement: T10 hoops with a cross-tie each way at 85 c/c over 500 mm from EVERY joint face, top and bottom, AND THROUGH THE JOINT.

Slab S1 carries corner torsion reinforcement — T8 @ 200 in FOUR LAYERS over 700 x 700 at all four corners (IS 456 Annex D-1.8). It is a small quantity of steel that is routinely omitted and should not be.

Beam B2 is reinforced 3-T20 rather than 5-T16 because five T16 bars need 256 mm of width in a 250 mm beam. That check is recorded in the master and is exactly the kind of item that becomes a site query if it is skipped.

## M10  Sentry post — BRICK MASONRY WALLS (design change SP-B1)

See `WM_SENTRY_POST_BRICK_MASONRY.md` — this is the only design change carried by the Works Management package and it has a document of its own.

## M11  Services

Builder's work — sleeves, ducts and penetrations — is coordinated with the reinforcement and is a predecessor to the wall inspection hold point. Cutting a penetration afterwards through a 600 wall at 150 bar spacing both curtains is not a repair, it is a defect.

Every duct and every pipe in the gas-tight envelope must remain inspectable along its whole length. That is why there is no suspended ceiling and no boxing-in anywhere in bays 1 to 6.

The decontamination effluent system is physically segregated from the clean sump and is never connected to it. Effluent goes to tank TK-01 for tanker removal.

The rising main from the clean sump carries four devices in series inside the envelope: isolation valve, gas-tight non-return valve, blast check valve and a 75 deep-seal trap. Each closes a different failure path.

The EMP works are structural as much as electrical: straps welded at every construction joint, the blast door frames welded to the cage, protection at every service penetration, and a welded steel Zone 2 room in bay 3 because the reinforcement cage on its own gives 0 dB at 1 GHz.

## M12  Finishes

Every finish in this project is specified as a PERFORMANCE REQUIREMENT and the product is deliberately left open. The requirements come from the decontamination duty, the gas-tight envelope, the EMP requirement and the wet areas.

Floors are laid to falls, joint-free within a room, and coved into the skirting in one piece. In the wet areas — bays 2, 5 and 6 — the finish is fully impervious and coved 150 up every wall in a single piece, with no tiles and no grout, because a grout line is a decontamination failure.

Wall finishes are applied direct to the concrete. There is no cavity, no dry lining and no batten anywhere in the envelope: a lined cavity is a contamination trap that cannot be decontaminated or inspected.

## M13  External works and concealment

The berm is graded 1.5:1 to +0.900 against the headhouse and covered stairwell, and the site is crowned with 1:50 falls away from the structure.

Turf over the cover is the confirmed concealment measure. Anything beyond it — spoil dressing, screening, planting regime, track discipline — is programmed as work but has no specification in the project, and the extent must be confirmed before it is priced.

Site restoration removes the temporary works, the haul road and the dewatering installation, and reinstates the ground so that the finished site reads as ground, which is the point of the whole exercise.

## M14  Testing, commissioning and handover

Structural verification is by 28-day cube results supported by ultrasonic pulse velocity and rebound hammer testing.

The protective systems are tested in a fixed order because each depends on the one before: EMP shielding effectiveness survey, blast door functional and seal test, then the gas-tightness and overpressure test of bays 1 to 6, then CBRN filter train commissioning, then integrated protective-mode operation.

Two claims must never be made, and are not made here. A static analysis gives the DEMAND on a blast structure; it is not proof of blast resistance — the non-linear support-rotation check is Phase 3 work. And flotation can never be read off a model whose springs take tension; it is a hand check.

Handover includes as-built drawings, O&M manuals, all test certificates, and operator training on the CBRN plant, the pumps, the generator, the blast doors and the escape shafts.

---

## The construction sequence in one page

```
MOBILISE ─┬─ approvals, security clearance, site establishment
          ├─ survey, confirmatory SI, MONSOON GWT MONITORING  ← closes the
          │                                                     biggest assumption
          └─ ORDER BLAST DOORS  ← day one; the frames gate the walls

EARTHWORKS ─ clear, strip topsoil (keep it) ─ temporary works ─ excavate soil
           ─ break rock in two lifts ─ sump pit ─ dewater ─ trim formation
           ─ over-excavate red-bole seams ─ FORMATION HOLD POINT

SUBSTRUCTURE ─ blinding ─ TANKING (horizontal) ─ HOLD POINT ─ mat + sump in one
             pour ─ 14-day cure ─ wall steel ─ BLAST DOOR FRAMES welded to the
             cage ─ walls in two lifts ─ lower stair flights

PRESSURE SLAB ─ falsework 3.2 m ─ bottom steel ─ trimmers, collars, thickenings
              ─ links ─ top steel ─ haunches ─ cast-ins ─ HOLD POINT
              ─ 112 m3 CONTINUOUS POUR ─ 14-day cure ─ 14-day props (IS 456
              Table 11) ─ strike ─ upper stair flight

    then, in parallel:
      ENTRY STRUCTURES ─ headhouse walls and roof ─ covered stairwell ─ escape
                         shaft collars ─ blast doors installed
      WATERPROOFING ─ vertical tanking ─ HOLD POINT ─ roof membrane ─ protection
                      screed ─ HOLD POINT
      SENTRY POST ─ (starts only after the rock breaking) footings ─ frame
                    ─ BRICK MASONRY ground storey ─ HOLD POINT ─ first storey
                    ─ HOLD POINT ─ lintels ─ spiral stair ─ plaster ─ finishes
      SERVICES ─ builder's work with the RC ─ ductwork ─ blast valves ─ filter
                 trains ─ generator ─ drainage ─ EMP enclosure ─ electrical

COVER ─ side backfill in 250 layers, density tested ─ 100 screed ─ 750 fill
      ─ 500 crushed basalt from our own excavation ─ 200 M30 BURSTER SLAB
      ─ 150 filter ─ 300 topsoil and turf ─ verify against master A.7.3

EXTERNAL ─ berm 1.5:1 ─ regrade with 1:50 falls ─ access ─ turf ─ concealment
         ─ remove temporary works

TEST ─ cubes and NDT ─ watertightness ─ drainage ─ electrical ─ earth 5 ohm
     ─ EMP SURVEY 80 dB ─ blast door seals ─ GAS-TIGHTNESS ─ CBRN commissioning
     ─ generator ─ INTEGRATED PROTECTIVE MODE ─ snag ─ rectify ─ contingency
     ─ HANDOVER
```

---

## Two claims this methodology does not make

The master project state file is explicit that two things must never be claimed
about this structure, and they are not claimed here.

**A static analysis gives the demand, not proof of blast resistance.** The
non-linear SDOF support-rotation check is Phase 3 work and has not been done. The
construction methodology delivers the structure that was designed; it does not
validate the design.

**Flotation cannot be read off the model.** The springs take tension. It is a hand
check, and it is the designer's.

Separately, and specific to this package: **editing and verifying a `.std` file is
not running an analysis.** No STAAD.Pro run was made in producing this Works
Management package, and none is claimed.
