yatineode128-hue/underground-shelter-project/WORKS MANAGEMENT/Underground_Shelter_QA_QC_Plan.md

<!-- GENERATED by WORKS MANAGEMENT/Scripts/wm_docs.py.  Edit the source
     data in wm_data.py / wm_content.py and re-run wm_build_all.py. -->

# QUALITY ASSURANCE AND QUALITY CONTROL PLAN
## Underground CBRN-hardened blast-resistant protective structure and sentry post — Pune, Maharashtra

**Works Management package revision WM1** · 07 September 2026
**Geometry:** Architectural Rev F · Structural Phase 2 Rev A + M1 · **Services:** Drainage DR1 · HVAC HV1 · Schedule of Finishes FN1 · Structural CAD SC1
**Evidence classes:** `[C]` confirmed · `[D]` derived here · `[A]` assumed by this package ·
`[U]` unresolved · `[N]` not available — data required

> **THE ONLY DESIGN CHANGE in this package is reference SP-B1: the sentry post walls
> are BRICK MASONRY, replacing the Rev F 200 mm RC ballistic infill panels.
> No other element of the project is changed.**

> **AMENDED 10 September 2026 for design revision SP-B2** (master **A.4.8**, Part
> **H.12**), which designs the **lintel L1** and the **wall tie detail** that SP-B1
> created a need for and this package recorded as not existing. **WM-V5 and WM-V11 are
> closed by it.** The amendment is to the WRITTEN RECORD ONLY — the lintel and tie
> paragraphs, the risk entry, the verification register and the gap list now state the
> designed values instead of saying no design exists. **NO QUANTITY, RATE, DURATION,
> DATE, FLOAT OR RESOURCE IN THIS PACKAGE CHANGED**, and bill item `SP-06` still
> measures the superseded provisional 200 × 150 lintel section: see
> `Documentation/WM_RECONCILIATION_REGISTER.md` §6. **WM-V3, WM-V6 and WM-V7 remain
> open.**

---

This plan covers the whole project — the underground shelter, the entry structures,
the sentry post including its **brick masonry walls**, the services, the external
works, and testing and commissioning.

It is built around **hold points**. A hold point is an activity in its own right in
the programme: it takes time, it requires the Engineer's attendance, and work does
not proceed past it. There are **16 hold points** in the programme, and they are
placed at the moments where an error becomes permanent — the formation before it is
covered, the tanking before it is buried, the reinforcement before it is cast in,
the masonry before it is plastered.

**Inspection types.** `HOLD` — work stops until released. `WITNESS` — the Engineer
is invited and work may proceed if attendance is waived. `TEST` — a measurement
against a stated acceptance criterion. `SURVEILLANCE` — ongoing observation.

---

## Hold points in the programme

| Hold | Activity | Description | Date | Float |
|---|---|---|---|---:|
| `H-11` | `A8020` | founding stratum inspection — in-situ basalt at (-)2.000 | 29-01-27 | 102 d |
| `H-01` | `A2085` | formation inspection and approval by the Engineer | 04-02-27 | 0 d |
| `H-12` | `A8035` | footing reinforcement and starter inspection | 04-02-27 | 102 d |
| `H-02` | `A3030` | tanking integrity inspection before covering | 18-02-27 | 0 d |
| `H-03` | `A3070` | mat reinforcement, cover and cast-in inspection | 11-03-27 | 0 d |
| `H-13` | `A8080` | first floor reinforcement inspection — IS 13920 detailing | 12-03-27 | 102 d |
| `H-15` | `A8145` | masonry line, level, plumb and joint thickness — ground storey | 31-03-27 | 118 d |
| `H-14` | `A8105` | sentry post roof reinforcement inspection | 06-04-27 | 102 d |
| `H-04` | `A3120` | wall reinforcement, frames and cover inspection — lift 1 | 08-04-27 | 0 d |
| `H-05` | `A3140` | wall reinforcement and cover inspection — lift 2 | 22-04-27 | 0 d |
| `H-16` | `A8160` | masonry inspection — first storey | 27-04-27 | 102 d |
| `H-09 — the last chance to see it` | `A6025` | vertical tanking inspection before backfilling | 24-05-27 | 52 d |
| `H-06` | `A4070` | pressure slab pre-pour inspection — reinforcement, cover, cast-ins | 23-06-27 | 0 d |
| `H-10` | `A6040` | roof membrane integrity test before covering | 04-08-27 | 0 d |
| `H-07` | `A5030` | headhouse wall inspection | 07-08-27 | 13 d |
| `H-08` | `A5055` | headhouse roof inspection | 26-08-27 | 13 d |

---

## Inspection and test plan

| Ref | Work | Stage | Requirement | Reference | Type | Record |
|---|---|---|---|---|---|---|
| `Q-01` | **Site setting out** | Before excavation | Position, orientation and level against the master A.4.1 grid; independent check. Sentry post at least 10 m clear of the excavation. | master A.4.1, A.2 | `WITNESS` | Setting-out record and check certificate |
| `Q-02` | **Excavation** | During | Line, level and stability of the faces; edge protection in place; dewatering operating. | IS 3764 | `SURVEILLANCE` | Daily excavation record |
| `Q-03` | **Formation** | Before blinding | Formation level (-)6.800; loose rock removed; red-bole and vesicular seams identified, over-excavated and replaced with M15. Founding stratum confirmed as in-situ basalt. The same check applies to the sentry post footings at (-)2.000 (H-11). | master A.6 | `HOLD (H-01, H-11)` | Formation approval certificate with a seam map |
| `Q-04` | **Backfill and engineered fill** | Each layer | Layer thickness not exceeding 250; in-situ dry density at least 95 % MDD. | IS 2720 (Part 8) for MDD; IS 2720 (Part 28) sand replacement | `TEST` | Field density test sheets, one set per layer per 100 m² |
| `Q-05` | **Engineered cover build-up** | On completion | Six layers reproduced at the thicknesses and materials of master A.7.3, totalling 2000 and 40.65 kPa. | master A.7.3 | `HOLD` | Cover verification record with layer levels |
| `Q-06` | **Concrete mix** | Before first pour | Trial mix and design for M35 (box) and M30 (sentry). Minimum cement 340 kg/m³ and w/c not more than 0.45 for M35 very severe exposure. Integral crystalline waterproofing admixture. | IS 456 Table 5; IS 10262; IS 2645 | `HOLD` | Approved mix design |
| `Q-07` | **Cement, aggregate and water** | Each delivery / source | Cement to IS 269 or IS 1489 (Part 1) with test certificates; aggregate to IS 383 tested to IS 2386; water to IS 456 Cl. 5.4. | IS 269, IS 383, IS 2386, IS 456 Cl. 5.4 | `TEST` | Material test register |
| `Q-08` | **Reinforcement** | Each consignment | Fe500D to IS 1786 for the box; Fe500 for the sentry post. Mill certificates plus independent tensile and bend tests per lot. | IS 1786 | `TEST` | Mill certificates and independent test reports |
| `Q-09` | **Reinforcement fixing — mat** | Before pour | Bar size, spacing 150 both curtains, laps 50 phi staggered so not more than 50 % are spliced at a section, cover 75 to the blinding and 50 to formed faces, chairs and spacers, wall starters with a 900 leg. | IS 456 Cl. 26.2, 26.4.2, Table 16; master A.5, F.1 | `HOLD (H-03)` | Pre-pour reinforcement checklist countersigned by the structural consultant |
| `Q-10` | **Reinforcement fixing — walls** | Before each lift | As Q-09 plus blast door jamb bars 4-T20 each face, header cage, haunch diagonals, and the blast door frame set, aligned and WELDED TO THE CAGE. | master F.1 | `HOLD (H-04, H-05, H-07)` | Pre-pour checklist and frame alignment record. H-07 is the headhouse walls, which carry the same 383 kPa either-face requirement |
| `Q-11` | **Reinforcement fixing — pressure slab** | Before pour | T25 @ 150 EF EW; opening trimmers 6-T25 and 5-T25; 4-T25 diagonals at the re-entrant corners; local thickenings 900 to 1200; four-legged T12 links @ 250 in the end 1500; HW3 band 4-T25 top and bottom; all cast-in items. | master B.4, B.4.1, F.1 | `HOLD (H-06, H-08)` | Pre-pour checklist countersigned by the structural consultant. H-08 is the headhouse roof, the most highly worked element at 90 % utilisation |
| `Q-12` | **Formwork and falsework** | Before pour | Line, level, plumb, camber, tightness and cleanliness; falsework designed and checked as temporary works. | IS 456 Cl. 11; IS 14687 | `HOLD` | Formwork release note; falsework design check |
| `Q-13` | **Concrete placing** | During pour | Slump on every load; placing and compaction; no cold joint in a continuous pour; temperature control on the 900 slab and 600 mat. | IS 456 Cl. 13; IS 1199 | `SURVEILLANCE` | Pour card per pour |
| `Q-14` | **Concrete strength** | 7 and 28 days | Cube sampling and testing; acceptance to IS 456 Cl. 15 and 16. | IS 516; IS 456 Cl. 15, 16 | `TEST` | Cube test certificates |
| `Q-15` | **Curing** | After each pour | Continuous moist curing: 14 days for the mat, the pressure slab and the headhouse roof; 7 days minimum elsewhere. | IS 456 Cl. 13.5 | `SURVEILLANCE` | Curing register |
| `Q-16` | **Formwork striking** | Before striking | Vertical faces after 16–24 h; props to slabs spanning over 4.5 m after 14 days. The pressure slab spans 5.000 clear. | IS 456 Cl. 11.3 Table 11 | `HOLD` | Striking permit signed by the site engineer |
| `Q-17` | **Construction joints** | At each joint | Surface prepared; reinforcement fully continuous; TWO waterstops and a welded EMP strap installed before the next pour. | IS 456 Cl. 13.4; master F.1 | `HOLD` | Joint record with photographs of the strap and waterstops |
| `Q-18` | **Hardened concrete — NDT** | After 28 days | Ultrasonic pulse velocity and rebound hammer on a sampling basis, concentrating on the pressure slab and the protective walls. | IS 13311 (Part 1) and (Part 2) | `TEST` | NDT report |
| `Q-19` | **Tanking — substrate** | Before application | Substrate sound, clean, dry and free of laitance; fillets formed at all internal angles. | IS 3067 | `WITNESS` | Substrate acceptance record |
| `Q-20` | **Tanking — horizontal and vertical** | Before covering | Continuity, laps, terminations, upstands and dressing to every penetration; protection layer in place before backfilling. | IS 3067; FN1 WP-01/WP-02 | `HOLD (H-02, H-09, H-10)` | Tanking inspection certificate with photographic record |
| `Q-21` | **Watertightness** | After completion | Visual inspection of the whole internal envelope for damp and seepage after the first monsoon exposure or a flood test where practicable. | IS 6494 principles | `WITNESS` | Watertightness inspection report |
| `Q-21A` | **SENTRY POST — RC footings and frame reinforcement** | Before each pour | Bar size, spacing, cover 50 to footings / 40 to columns / 30 to beams and slabs; column starters 8-T16; IS 13920 detailing — T10 confining hoops with a cross-tie each way @ 85 over 500 from every joint face AND through the joint; slab corner torsion steel T8 @ 200 in four layers over 700 x 700 at all four corners. | IS 456; IS 13920 Cl. 7.4, 8.1, 8.2; IS 456 Annex D-1.8; master F.4 | `HOLD (H-12, H-13, H-14)` | Pre-pour reinforcement checklist countersigned by the structural consultant |
| `Q-22` | **SENTRY POST — brick source** | Before order | Class designation 10 modular bricks; sampling to IS 5454; testing to IS 3495 for compressive strength, water absorption, efflorescence and warpage. Dimensional tolerance check on the 190 x 90 x 90 size. | IS 1077; IS 3495; IS 5454 | `HOLD` | Brick test report and source approval |
| `Q-23` | **SENTRY POST — masonry mortar** | Each batch | CM 1:6 by volume using gauge boxes; sand to IS 2116; used within 30 minutes; never re-tempered. Mortar cube tests on a sampling basis. | IS 2250; IS 2116 | `TEST` | Mortar register and cube results |
| `Q-24` | **SENTRY POST — masonry workmanship** | Each storey | English bond one brick thick; 10 mm joints fully filled bed, cross and vertical; bricks thoroughly soaked before laying; not more than 1 m of lift above adjacent work in a day. | IS 2212 | `SURVEILLANCE` | Daily masonry record |
| `Q-25` | **SENTRY POST — line, level, plumb and joints** | End of each storey | Plumb over the 2.600 storey height; level every fourth course; joint thickness 10 mm nominal; panel dimensions against the 190 thickness inside the 200 structural zone. | IS 2212; IS 1905 | `HOLD (H-15, H-16)` | Masonry inspection record with measured plumb and joint thickness |
| `Q-26` | **SENTRY POST — infill / frame interface** | Before plaster | Top course wedged and packed only after the panel has taken its initial shrinkage; ties to the columns installed at the specified spacing. | IS 1905; SP-B1 | `HOLD` | Interface inspection record |
| `Q-27` | **SENTRY POST — lintels** | Before and after casting | Approved lintel design in place before the opening is built; section, reinforcement, bearing 200 minimum each end, and curing. | IS 456; design NOT YET ISSUED | `HOLD` | Lintel inspection record |
| `Q-28` | **SENTRY POST — plaster** | Before and after | Surface prepared and raked; thickness, true to line and level; cured seven days; no hollowness on tapping. | IS 1661 | `WITNESS` | Plaster inspection record |
| `Q-29` | **SENTRY POST — flooring and finishes** | On completion | Level, falls, finish and freedom from cracking. | IS 2571 for in-situ cement concrete flooring | `WITNESS` | Finish inspection record |
| `Q-30` | **SENTRY POST — painting** | Each coat | Surface preparation, primer and coats; adhesion. | IS 2395 (Part 1) | `WITNESS` | Painting record |
| `Q-31` | **Drainage — pipes and chambers** | Before covering | Line, level, gradient, jointing; water or air test; rodding access at every change of direction. | IS 1742 principles; Drainage DR1 | `HOLD` | Drainage test certificate |
| `Q-32` | **Sump and pumps** | On commissioning | Duty and standby pump performance; auto-alternation; level switch settings at start +900, stop +300 and high alarm +1200 above the invert; hand pump PU-03 proved independently of power. | Drainage DR1 | `TEST` | Pump commissioning record |
| `Q-33` | **Soak pits** | Before construction | PERCOLATION TEST IS MANDATORY and must precede construction; SK-01 is 2.3 % short of its own stated requirement. CONFLICT C19 IS NOW CLOSED - RC1 WIDENED SK-01 to 2.200 dia, depth unchanged: 24.19 m2 against 22.50 required, +7.5 %. The percolation test still governs the final size. | IS 2470 (Part 2) Cl. 4 | `HOLD` | Percolation test report |
| `Q-34` | **Septic tank** | On completion | Capacity, baffle at two-thirds of the length, inlet and outlet tees, 50 cowled vent at least 2 m above grade; watertightness. | IS 2470 (Part 1) Cl. 6.2, 6.3, 6.5, 6.6, 6.9, Table 1 | `WITNESS` | Septic tank inspection record |
| `Q-35` | **Electrical installation** | On completion | Insulation resistance, continuity, polarity, protective device operation. | IS 732 | `TEST` | Electrical test certificate |
| `Q-36` | **Earthing** | On completion | Earth electrode resistance against the 5 ohm target; bonding continuity to all metalwork. | IS 3043; IEEE 142 | `TEST` | Earth resistance test report |
| `Q-37` | **EMP shielding** | After enclosure and all penetrations | Shielding effectiveness survey, 80 dB over 10 kHz to 1 GHz. | IEEE Std 299; MIL-STD-188-125-1 §5.4, §5.5, §5.7.2.1, §5.7.4.1, §5.7.6 | `TEST` | Shielding effectiveness survey report |
| `Q-38` | **Blast doors** | On installation | Alignment, seal compression, operation, and the vendor's rating documentation. The tested assembly is NOT overcoated. | Vendor specification; FN1 D-01 | `HOLD` | Door installation and seal test record |
| `Q-39` | **Gas-tightness and overpressure** | After doors and finishes | Envelope leakage of bays 1 to 6 (67.8 m² floor, 217.0 m³ volume) and overpressure hold with the filter trains running. | FEMA 453 principles; project protective requirement | `TEST` | Gas-tightness and overpressure test report |
| `Q-40` | **CBRN filter trains** | On commissioning | Airflow, filter seating, in-place leak test of the H14 HEPA stage, carbon bed condition, hand-crank operation of each fan. | EN 1822 for the HEPA classification; HVAC HV1 | `TEST` | Filter train commissioning report |
| `Q-41` | **Generator** | On commissioning | Load test, changeover proving, exhaust and combustion air path, bunding. | HVAC HV1 | `TEST` | Generator commissioning report |
| `Q-42` | **Integrated protective mode** | Before handover | Whole-system operation in protective mode: doors closed, blast valves set, filter trains running, overpressure maintained, drainage isolated. | This package | `HOLD` | Integrated commissioning report |

---

## The five checks that matter most on this project

**1. The formation (`Q-03`, hold point `H-01`).** The hazard is not the basalt, it
is the red-bole and vesicular seams at the flow contacts. A single seam under the
mat produces the differential-support case that sizes the mat. Every seam is
over-excavated and replaced with M15, and the approval carries a seam map.

**2. The tanking before it is covered (`Q-20`, hold points `H-02`, `H-09`,
`H-10`).** The external tank is continuous — under the mat, up the walls, over the
roof. Once it is backfilled it can never be seen again, and the structure sits with
its roof 2 m below grade and a design water table at the roof level.

**3. Reinforcement at 150 spacing both curtains (`Q-09` to `Q-11`).** The 150 mm
maximum bar spacing is an **EMP requirement** and is stricter than IS 456. It is not
a strength requirement, which means a site engineer looking only at strength will
see no reason not to relax it. It must not be relaxed.

**4. Formwork striking (`Q-16`, IS 456 Cl. 11.3 Table 11).** Props to a slab
spanning over 4.5 m stay for **14 days**. The pressure slab spans 5.000 m clear.
Striking requires a signed permit; the 14 days are in the baseline programme and
are not available for compression.

**5. Sentry post masonry line, level and plumb (`Q-25`, hold points `H-15`,
`H-16`).** Checked at the end of each storey, before plaster. Plumb over the 2.600
storey height and joint thickness are the two measurements that decide whether the
plaster can be held to its stated thickness — and once plaster is on, neither can
be corrected.

---

## QA/QC for the sentry post brick masonry — design change SP-B1

The masonry brings a set of checks that the RC infill panels did not need. They are
listed together here so that they can be issued as a single inspection sheet.

| Check | Criterion | Reference | When |
|---|---|---|---|
| Brick source approval | Class 10, dimensional tolerance on 190 × 90 × 90 | IS 1077 | Before order |
| Brick compressive strength | ≥ 10 N/mm² average | IS 3495 (Part 1) | Before order, and per delivery lot |
| Water absorption | Within the IS 1077 limit for the class | IS 3495 (Part 2) | Before order |
| Efflorescence | Within the IS 1077 limit | IS 3495 (Part 3) | Before order |
| Warpage | Within the IS 1077 limit | IS 3495 (Part 4) | Before order |
| Sampling | Sample size and selection | IS 5454 | Each lot |
| Soaking before laying | Bricks thoroughly wet, not surface-damp | IS 2212 | Continuous |
| Mortar proportioning | CM 1:6 by **gauge box**, not by shovel | IS 2250 | Each batch |
| Mortar working time | Used within 30 minutes; never re-tempered | IS 2250 | Each batch |
| Sand for mortar | Grading and cleanliness | IS 2116 | Source and each delivery |
| Bond | English bond, one brick thick | IS 2212 | Continuous |
| Joint thickness | 10 mm nominal, fully filled bed, cross and vertical | IS 2212 | Every course |
| Lift height | Not more than 1 m above adjacent work in a day | IS 2212 | Daily |
| Level | Every fourth course | IS 2212 | Continuous |
| Plumb | Over the full 2.600 storey height | IS 2212 | End of each storey — **hold point** |
| Frame interface | Top course wedged and packed only after initial shrinkage | IS 1905 | Before plaster — **hold point** |
| Wall ties to the columns | At the specified spacing — **detail does not yet exist** | — | Before plaster |
| Openings | Position and dimension against the Rev F drawings | Rev F drawings 3 and 4 | Before lintels |
| Lintels | Approved design, section, reinforcement, 200 bearing each end | IS 456 — **design does not yet exist** | Before and after casting |
| Curing | Damp for at least 7 days | IS 2212 | After each storey |
| Chases for conduit | **Cut, not hammered**; not before the masonry has cured | IS 2212 | Electrical first fix |
| Plaster | Thickness, line, level, no hollowness on tapping, 7-day cure | IS 1661 | Each face |

---

## Records

| Record | Raised by | Held by |
|---|---|---|
| Setting-out record and independent check certificate | Surveyor | QA/QC Engineer |
| Formation approval certificate with seam map | Site Engineer (Civil) | QA/QC Engineer |
| Material test register — cement, aggregate, steel, brick | Storekeeper | QA/QC Engineer |
| Mill certificates and independent steel test reports | Storekeeper | QA/QC Engineer |
| Pre-pour reinforcement checklists, countersigned | Site Engineer (Civil) | QA/QC Engineer |
| Formwork release notes and striking permits | Site Engineer (Civil) | QA/QC Engineer |
| Pour cards — one per pour, with slump and cube references | Site Engineer (Civil) | QA/QC Engineer |
| Cube test certificates at 7 and 28 days | Laboratory | QA/QC Engineer |
| Curing register | Site Engineer (Civil) | QA/QC Engineer |
| Construction joint records with photographs of waterstops and EMP straps | Site Engineer (Civil) | QA/QC Engineer |
| Tanking inspection certificates with photographic record | QA/QC Engineer | QA/QC Engineer |
| Field density test sheets | Laboratory | QA/QC Engineer |
| Brick and mortar test reports | Laboratory | QA/QC Engineer |
| Masonry inspection records with measured plumb and joint thickness | QA/QC Engineer | QA/QC Engineer |
| Drainage, electrical, earthing and EMP test certificates | Specialist / Electrician | QA/QC Engineer |
| Commissioning reports — filter trains, generator, gas-tightness, integrated | Specialist subcontractor | Site Engineer (Services) |
| Non-conformance reports and their close-out | Anyone | QA/QC Engineer |

## Non-conformance

A non-conformance is raised the moment it is identified, by anyone, and is closed
only by the QA/QC Engineer against evidence. Three categories of non-conformance on
this project are **not** closable by repair and require the designer's ruling:
reinforcement spacing relaxed beyond 150 in the protective envelope; a construction
joint formed without both waterstops and the EMP strap; and any penetration cut
through the envelope after casting.
