yatineode128-hue/underground-shelter-project/WORKS MANAGEMENT/Documentation/WM_ASSUMPTIONS_AND_VERIFICATION_REGISTER.md

<!-- GENERATED by WORKS MANAGEMENT/Scripts/wm_docs.py.  Edit the source
     data in wm_data.py / wm_content.py and re-run wm_build_all.py. -->

# ASSUMPTIONS AND VERIFICATION REGISTER
## Underground CBRN-hardened blast-resistant protective structure and sentry post — Pune, Maharashtra

**Works Management package revision WM1** · 07 September 2026
**Geometry:** Architectural Rev F · Structural Phase 2 Rev A + M1 · **Services:** Drainage DR1 · HVAC HV1 · Schedule of Finishes FN1 · Structural CAD SC1
**Evidence classes:** `[C]` confirmed · `[D]` derived here · `[A]` assumed by this package ·
`[U]` unresolved · `[N]` not available — data required

> **THE ONLY DESIGN CHANGE in this package is reference SP-B1: the sentry post walls
> are BRICK MASONRY, replacing the Rev F 200 mm RC ballistic infill panels.
> No other element of the project is changed.**

> **AMENDED 10 September 2026 for design revision SP-B2** (master **A.4.8**, Part
> **H.12**), which designs the **lintel L1** and the **wall tie detail** that SP-B1
> created a need for and this package recorded as not existing. **WM-V5 and WM-V11 are
> closed by it.** The amendment is to the WRITTEN RECORD ONLY — the lintel and tie
> paragraphs, the risk entry, the verification register and the gap list now state the
> designed values instead of saying no design exists. **NO QUANTITY, RATE, DURATION,
> DATE, FLOAT OR RESOURCE IN THIS PACKAGE CHANGED**, and bill item `SP-06` still
> measures the superseded provisional 200 × 150 lintel section: see
> `Documentation/WM_RECONCILIATION_REGISTER.md` §6. **WM-V3, WM-V6 and WM-V7 remain
> open.**

---

Master rule M.6 governs this register: *never guess missing engineering
information; if something is marked UNRESOLVED or NOT AVAILABLE it stays that way
until the user supplies it.*

Nothing in this package resolves an item that the master leaves open, and nothing
downgrades or deletes an evidence tag. This register lists what the Works Management
package assumed in order to produce a programme and a bill, and what must be
confirmed before either is relied on.

---

## Part 1 — Items this package raised

| Ref | Item | Effect if wrong | Status |
|---|---|---|---|
| `WM-V1` | Sentry post ground-storey masonry height: the project's confirmed 2.600 m (master A.7.7) against the 2.750 m implied by +0.450 FFL and the +3.200 beam soffit | 15.2 m × 0.150 × 0.190 = 0.43 m³ of masonry, about 230 bricks | **CLOSED by RC1**, 10 Sep 2026, master K.1c — **2.600 governs**, confirmed twice (drawing 6, and 13.000 = 0.200 × 2.600 × 25). No quantity changes |
| `WM-V2` | First-floor west wall: door D1 at Y 1000–1900 lies inside the vision panel at Y 1000–2200 on Rev F drawing 4 | Double deduction would understate the masonry by 1.9 m² | **CLOSED by RC1**, 10 Sep 2026, master K.1c — **the union is deducted once** |
| `WM-V3` | Sentry post window and vision-panel heights are not stated on any drawing | 1200 assumed. Each 100 mm of height is 1.1 m² of masonry across the nine openings | **CLOSED by RC1**, 10 Sep 2026, master K.1c for measurement — **doors 2100, windows and vision panels 1200** `[A]`. **L1 is unaffected.** Confirm before setting out |
| `WM-V4` | 190 mm modular brickwork inside the 200 mm structural zone | The alternative, 230 mm conventional brickwork, changes the confirmed 4000 × 5000 external envelope | **CLOSED by RC1**, 10 Sep 2026, master K.1c — **190 confirmed**, because it is the only option that keeps a confirmed dimension |
| `WM-V5` | Lintels over the sentry post openings — a **new** requirement created by SP-B1 | ~~No lintel design exists~~ — **lintel L1 is now designed, SP-B2, master A.4.8**. `SP-06` still measures the superseded provisional 200 × 150 section | **CLOSED by SP-B2**, 10 Sep 2026 |
| `WM-V6` | Sentry post seismic weight when RC infill becomes brick masonry | Brick at ~20 kN/m³ over 0.190 × 2.600 gives ~9.9 kN/m against the confirmed 13.000 kN/m, so the existing V<sub>b</sub> = 73.18 kN is **conservative**. A direction, not a verification | **OPEN** — referred to the structural discipline |
| `WM-V7` | Ballistic performance. Rev F calls the panels '200 RC BALLISTIC INFILL'; brick masonry does not give the same protection | A stated protective function is removed from a structure that is already declared not blast designed and expendable | **OPEN** — recorded so the consequence is visible |
| `WM-V8` | Mat measured gross, no deduction for the 1.5 × 1.5 sump opening | +1.35 m³. SC1's convention, kept | **CLOSED by RC1**, 10 Sep 2026, master K.1c **as a declared conservatism** — it over-measures, the safe direction for a bill |
| `WM-V9` | 1.000 m working space and vertical unbenched excavation faces | A slope-stability assessment of the soil zone above rockhead is required before excavation | **STILL OPEN** — needs a geotechnical assessment the project does not contain (master K.1b) |
| `WM-V10` | Bulking on rock excavation not applied | Loose volumes for haulage and stockpiling will be 40–60 % greater than the 1 114 m³ bank measure | **CLOSED by RC1**, 10 Sep 2026, master K.1c **as a declared conservatism** — 1 114 m³ is a BANK measure and nobody should plan haulage off it |
| `WM-V11` | Wall tie detail between the sentry post masonry and the columns | ~~No detail exists in the project~~ — **6 mm MS ties at every fifth course, SP-B2, master A.4.8** | **CLOSED by SP-B2**, 10 Sep 2026 |
| `WM-V12` | Opening heights for the W8 partition doors (900 gap confirmed, head height not stated) | 2100 assumed, consistent with every other door in the project | **CLOSED by RC1**, 10 Sep 2026, master K.1c — **2100**, the project's own convention |

## Part 1a — Items revision WM4 raised, 15 September 2026

Pricing the bill from the Maharashtra PWD **State Schedule of Rates 2022-23** raised
seven questions that the schedule, the project record, or both, leave open. **None is
closed here and none is guessed.** The full entries, including what would close each
one, are in `Cost/WM4_OPEN_ITEMS.csv`.

| Ref | Item | What WM4 did | Status |
|---|---|---|---|
| `WM4-V1` | Excavation below 6.0 m depth — the SSR sets no percentage | Priced at +30 % as a DECLARED LOWER BOUND, tagged [A].  Every extra 10 percentage points is about Rs 21 800 on these two lines. | **OPEN** — A determination by the Superintending Engineer, PWD, Pune circle |
| `WM4-V2` | Brick class — SSR grading against IS 1077 | Priced at 27.05, second class in CM 1:6 in superstructure, which is the only published superstructure wall item and matches the specified mortar. | **OPEN** — Confirmation that 27.05 is the correct billing item for class 10 bricks |
| `WM4-V3` | Lintel SP-06 measures a superseded section | WM4 prices the quantity AS MEASURED and does not re-measure it.  The difference is 0.51 against 0.4845 m3, about 5 %, or Rs 322. | **OPEN** — A re-measure, which belongs to the package that owns the quantity, not to a rating exercise |
| `WM4-V4` | No district cost index or circle variation applied | State rates are used exactly as published.  No index, uplift or discount is applied anywhere. | **OPEN** — The Pune circle's current variation order, if one exists |
| `WM4-V5` | GST rate is not fixed by the schedule | 18 % is used, tagged [A], as a single parameter cell in the workbook so another rate can be tested by changing one number. | **OPEN** — The applicable works-contract GST rate for this employer |
| `WM4-V6` | Tanking specification substituted | Priced at 51.114 because the MATERIAL matches — a five-layer polymeric membrane on a 90 micron HMHDPE core.  The shahabad alternative is carried in the workbook at Rs 1 286 / Rs 1 338 so the swap can be costed: it would add about Rs 400 000. | **OPEN** — A decision on which specification is being bought |
| `WM4-V7` | The protective plant is outside the schedule entirely | Listed in bill section L at nil.  The owner's own bill prices them from vendor figures at about Rs 1.05 crore; those figures are NOT SSR rates and WM4 does not adopt them. | **OPEN** — Vendor quotations, and the Superintending Engineer's approval of the resulting non-schedule rates |

`WM4-V1` is the one that moves money: 157.44 m3 of rock between (-)6.000 and (-)6.800
plus the 9.477 m3 sump pit below it sit past the last depth band the SSR defines, and
the schedule hands that percentage to the Superintending Engineer. Every further 10
percentage points is about Rs 21 800 on the two lines.

`WM4-V7` carries the most money and is not a rate question at all: the blast doors,
exit hatches, blast valves, NBC trains, EMP enclosure, generator, sump pumps and
commissioning have **no SSR item**. They are excluded from the SSR-based total, not
estimated into it.

## Part 2 — Programme assumptions

| Ref | Assumption |
|---|---|
| `WM-P1` | Project start Monday 2 November 2026, carried over from the supplied R0 schedule. A planning date, not a contractual one |
| `WM-P2` | All output rates are assumed. The quantities they are applied to are confirmed or derived and are traceable; the rates are not |
| `WM-P3` | Rock excavation programmed at the mean rockhead (-)1.750. At the shallow bound it rises to 1 043 m³ and the excavation lengthens by about a day |
| `WM-P4` | No blasting. Rock is removed by hydraulic breaker because the sentry post founds on the same rock within 10 m |
| `WM-P5` | Vendor lead times are assumed. They are the largest single risk in the programme and must be replaced by quoted times at tender |
| `WM-P6` | Six-day working week with five date-certain national holidays. Festival holidays are absorbed by the 10-day contingency activity `A14098` |
| `WM-P7` | Monsoon is handled by productivity allowances inside durations and by sequencing the deep excavation and external tanking outside June–September, not by a non-working calendar |
| `WM-P8` | The berm, access route and concealment works have no site plan behind them, so their durations are indicative |
| `WM-P9` | Cement at 400 kg/m³ for M35 against the IS 456 Table 5 minimum of 340. A trial mix to IS 10262 fixes the real content |

## Part 3 — Master items this package did NOT resolve

These remain exactly as the master leaves them.

| Ref | Item | Bearing on Works Management |
|---|---|---|
| ~~`C16`~~ | Roof / platform junction — 250 against 500 | **RULED AT 250 and CLOSED by RC1**, 10 Sep 2026 (master Part H.14). The A.4.7 clause that said 500 has been corrected. `A5105` is no longer waiting on anything |
| `C17` | Engineered cover — A.7.3 states 40.65 kPa but its own column sums to 39.15 | No effect on quantities: the six layers and their thicknesses are unambiguous and are what is measured |
| `C18` | Sump pit base — 400 from F.1 and the levels, 300 on sheet S-06 | 400 held, as the master holds it. Difference is 0.44 m³ |
| `C19` | Soak pit SK-01 is 2.3 % short of its own stated requirement | The percolation test may move the requirement by far more than 2.3 %. `Q-33` is a hold point before construction |
| `C20` | Sheet S-06 carries the Rev E stairwell catchment | Conservative. No Works Management effect |
| `C21` | CBRN filter duty 250 against 300 m³/h | **Must be ruled on before the filter trains are ordered.** `A1130` enquiry precedes `A1135` order for this reason |
| `U1` / `C9` | Sentry post V<sub>b</sub> 73.18 (STAAD) against 59.3 (hand) | Design uses 73.18. `WM-V6` adds a second reason to revisit it |
| `U2` · `U3` | Is a direct hit a requirement? · DBT yield | Client and military sign-off. No Works Management effect |
| `U8` | Roof projection and parapet 4.162 kN/m not independently reproducible | Parapet reinforcement is nominal `[A]` in the sentry post estimate |
| — | k<sub>s</sub> second bound (500 000 kN/m³) not run | Designer's item |
| — | Phase 3 not started: non-linear SDOF support rotation, shock propagation down the entry shaft, transient soil–structure interaction, blast-door vendor testing, sentry sheet S-09 | The programme delivers the structure that was designed. It does not validate the design |

## Part 4 — Information the project does not contain

These are not assumptions. They are gaps, and each one blocks something.

| Missing | Blocks | Needed by |
|---|---|---|
| **Electrical design package** — no circuit, cable, luminaire, DB or earth-electrode schedule | All electrical procurement and every electrical quantity | Before `A11025`, 23 Jul 27 |
| **Site plan / ground model** | Berm volume, access route, hardstanding, soakaway positions, several drainage runs | Before `A13010`, 10 Sep 27 |
| ~~**Sentry post lintel design**~~ | `A8140`, `A8155` | **SUPPLIED — lintel L1, SP-B2, master A.4.8, 10 Sep 2026. No longer a gap** |
| ~~**Sentry post wall tie detail**~~ | `A8135` | **SUPPLIED — 6 mm MS ties @ every 5th course, SP-B2, master A.4.8, 10 Sep 2026. No longer a gap** |
| **Blast door leaf, frame and anchorage details** | Frame cast-in at `A3105` | Vendor submittal, before 01 Apr 27 |
| **Blast valve sizes and sleeve details** | Sleeves cast in at `A9015` | Before the wall and slab pours |
| **Service-entry plate size at wall W2** | Cast-in at `A4060` | Before the pressure slab pour |
| **Ventilation and CBRN duct penetration schedule** | Cast-ins at `A4060` | Before the pressure slab pour |
| **EMP Zone 2 enclosure specification** | `A1150` enquiry | At mobilisation |
| **Armoured vision panel specification** | `A1165` enquiry | At mobilisation |
| **Finish product selections** (FN1 specifies performance only) | `A12025` onward | Before Aug 27 |
| **Sentry post ground-floor slab design** | `SC-08` | Before `A8060` |
| **W5 gas-tight door D-05** — the airlock has no scheduled clean-side exit | `A12065` | Before Sep 27 |

Every date above is computed from the programme. They are issued to the designer at
mobilisation, not requested when the activity is due to start.

---

## What this package did not do

* It did not run STAAD.Pro. STAAD.Pro is not available in this environment, and no
  analysis was performed. Reading a `.std` file is not running an analysis.
* It did not modify any drawing, model, calculation or design file. The only files
  changed outside the `WORKS MANAGEMENT` folder are `master/MASTER_PROJECT_STATE.md`
  (Part H revision record) and `master/QUICK_STATE.md`.
* It did not change the main staircase. The frozen geometry — 24 risers at
  170.8333, tread 280, three flights of eight, total rise 4100, flights 1200 wide,
  200 well, 2533 headroom — is unchanged and is reproduced in the programme as it
  stands.
* It did not resolve, downgrade or delete a single evidence tag from the master.
* It made only one design change, SP-B1, and made it because it was explicitly
  instructed.
