yatineode128-hue/underground-shelter-project/Presentation Sheets/PDF/WMS013_Works_Management_Master_Programme_and_Bill_of_Quantities.pdf

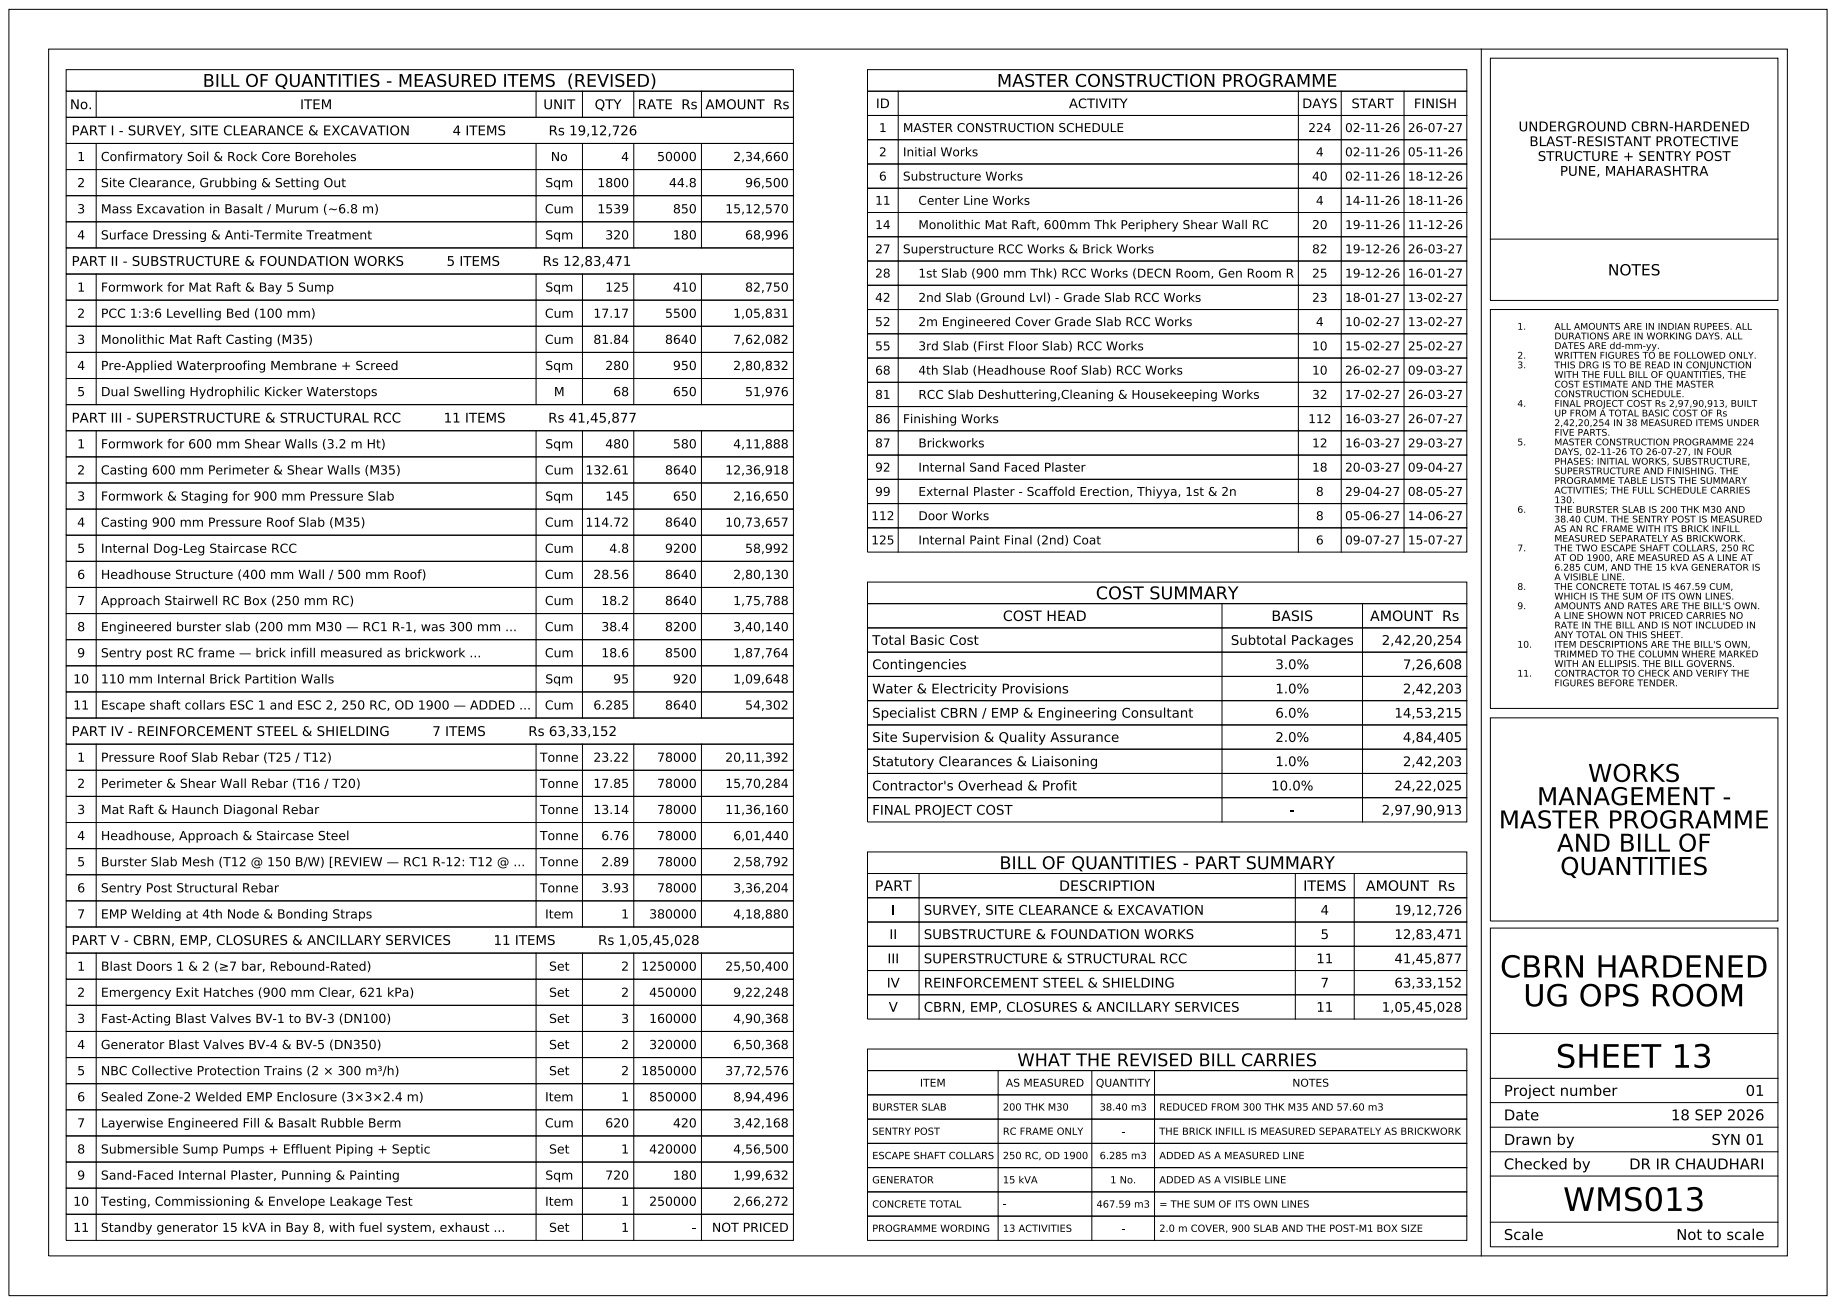
[picture p8: page 1]
