yatineode128-hue/underground-shelter-project/Presentation Sheets/PDF/ARCH001_Underground_Headhouse_and_Ground_Level_Plans_Redrawn_to_Project_Data.pdf

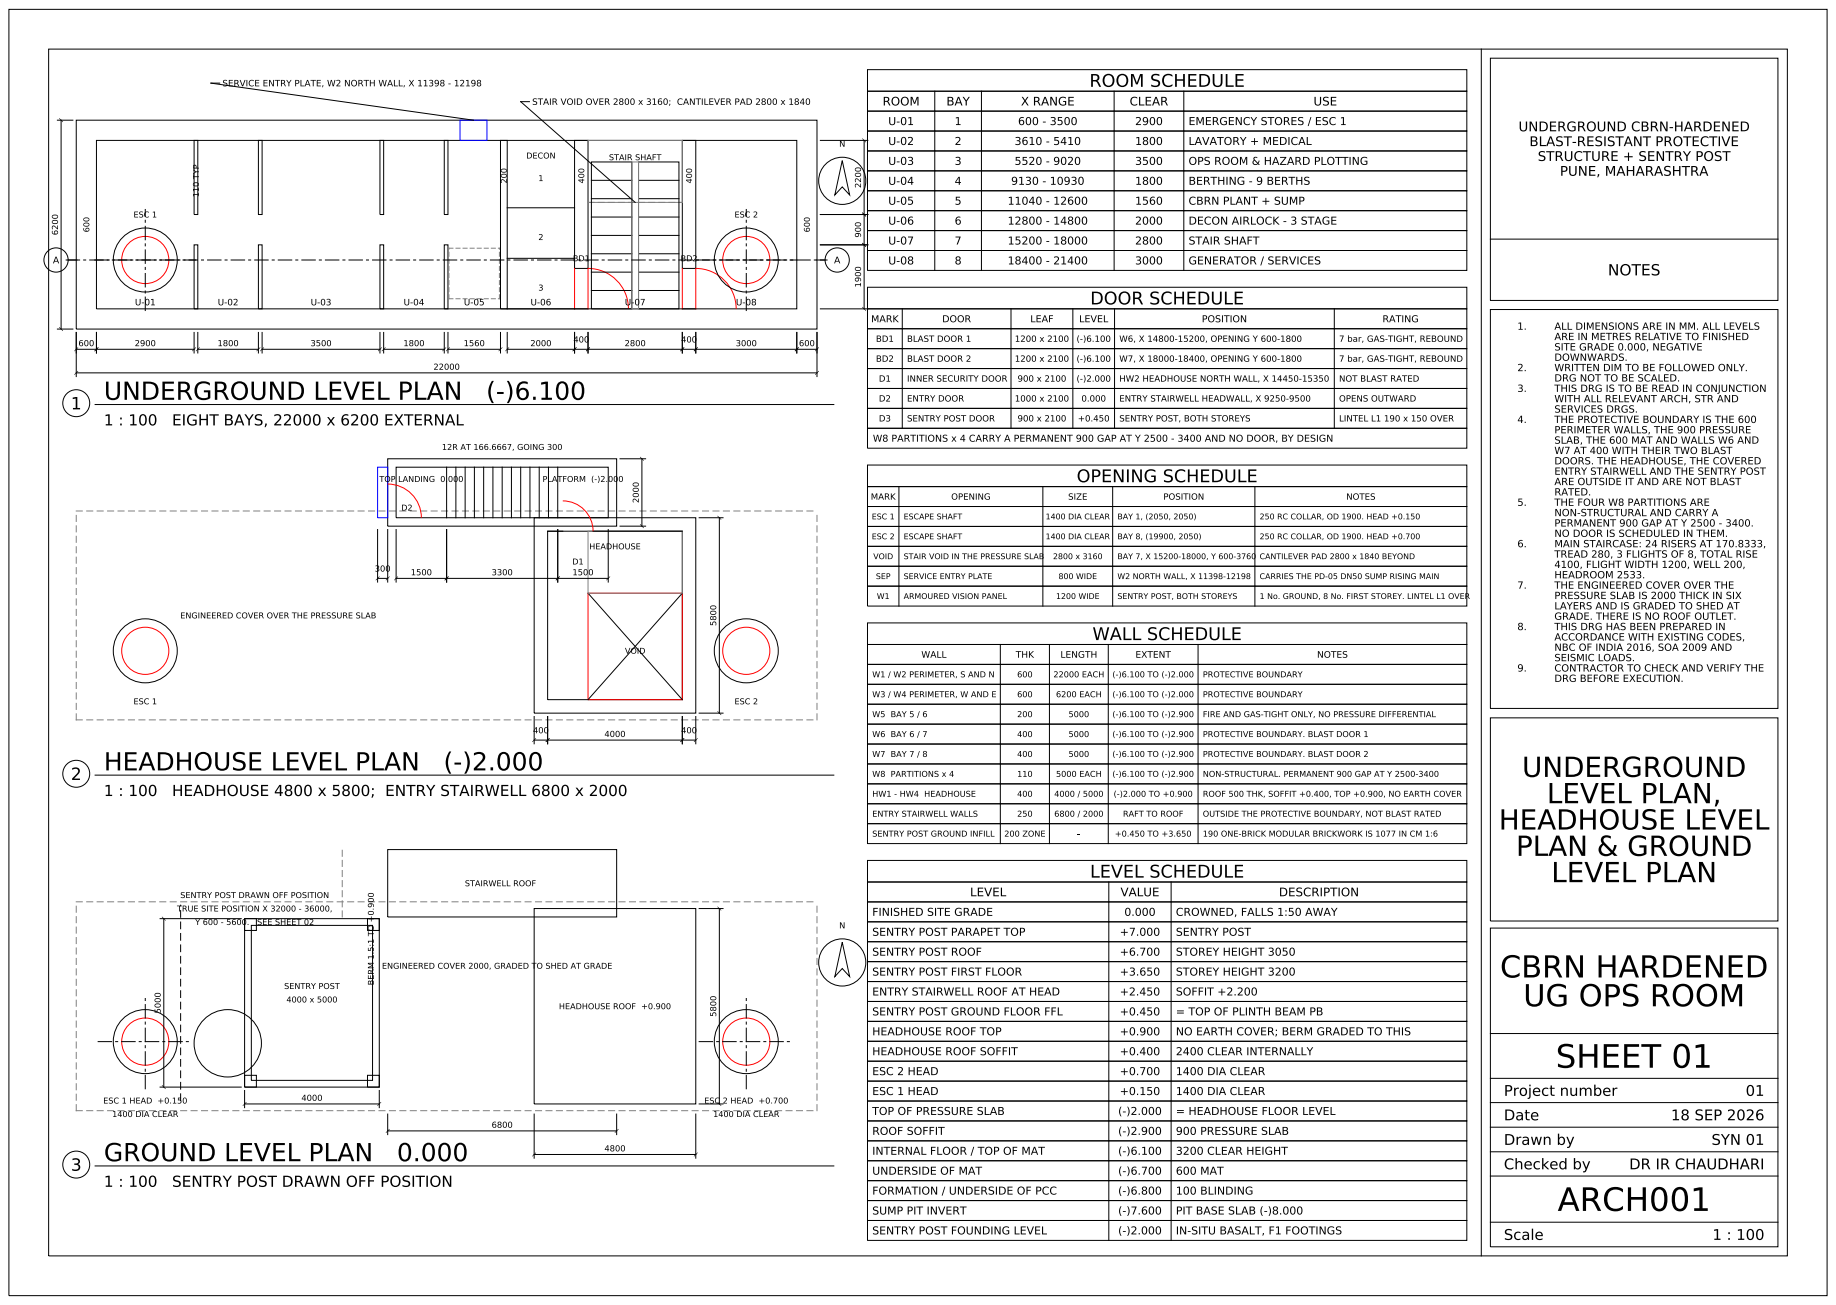
[picture p9: page 1]
