yatineode128-hue/underground-shelter-project/Presentation Sheets/PDF/ARCH002_Sentry_Post_Floor_Plans_and_South_Elevation_Redrawn_to_Project_Data.pdf

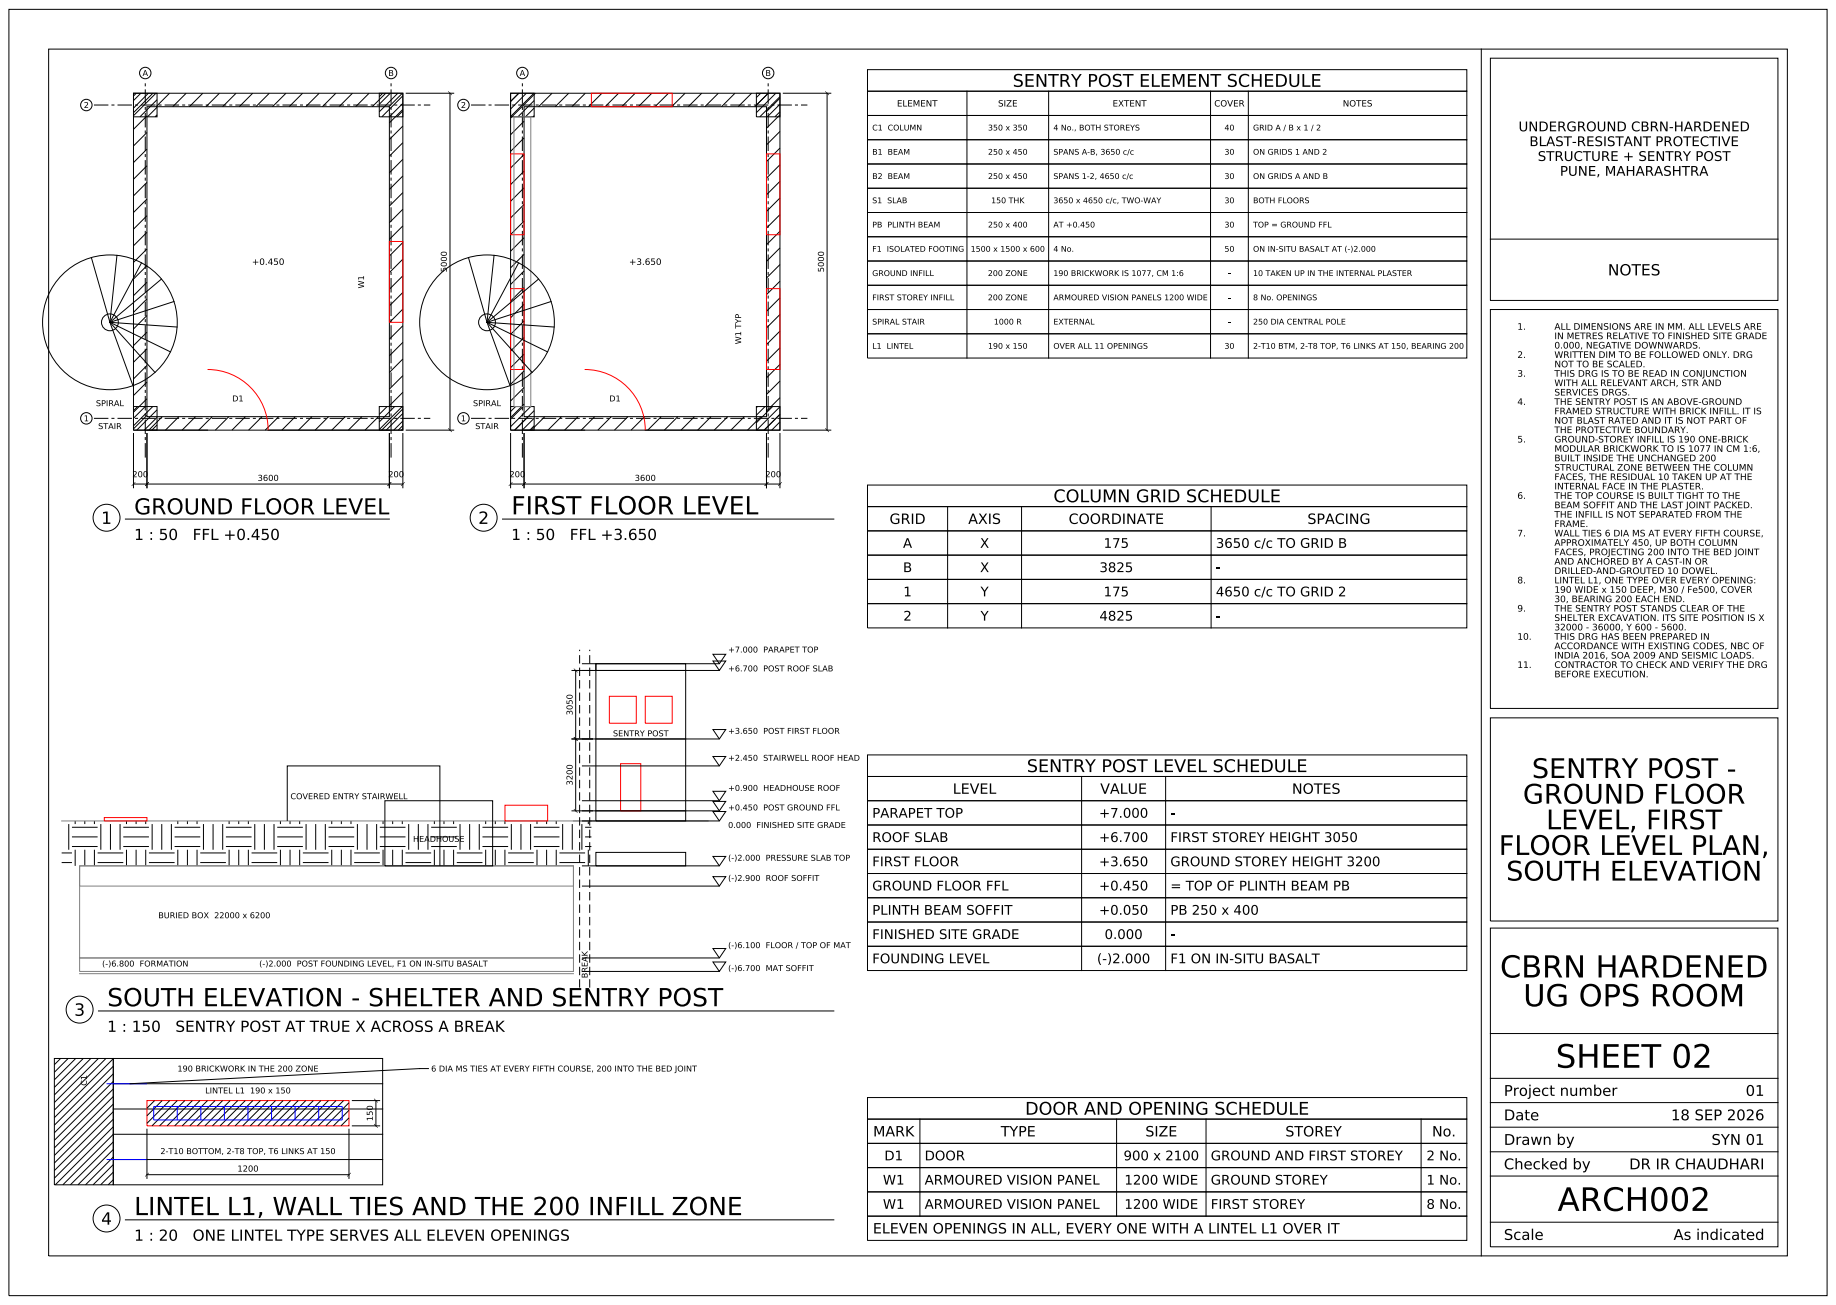
[picture p10: page 1]
