yatineode128-hue/underground-shelter-project/Presentation Sheets/PDF/FLS012_Fire_and_Life_Safety_Escape_Plan_and_Decision_Rule.pdf

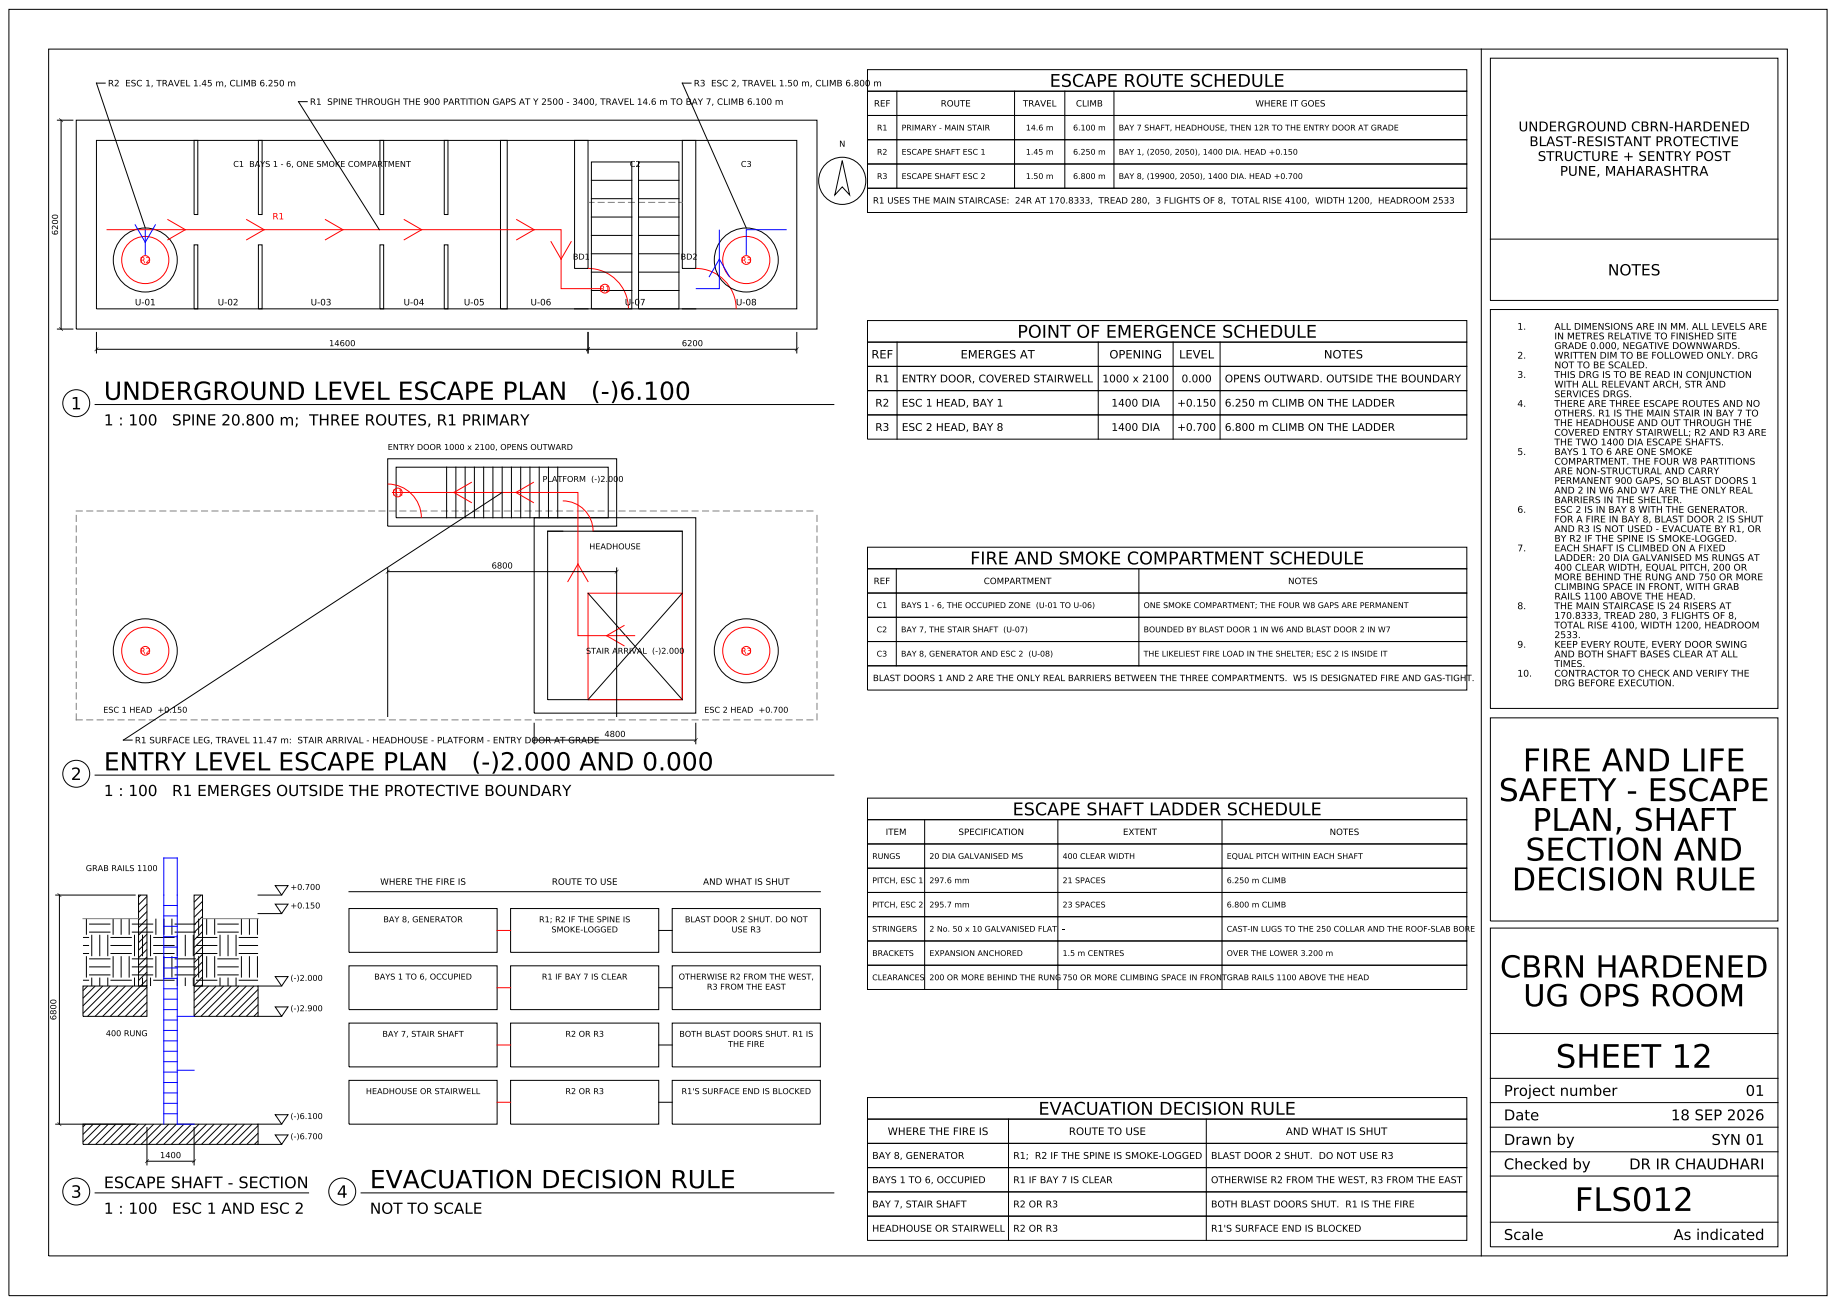
[picture p11: page 1]
