yatineode128-hue/underground-shelter-project/Presentation Sheets/PDF/MEP010_HVAC_and_EMP_Zone_Layout_Plans.pdf

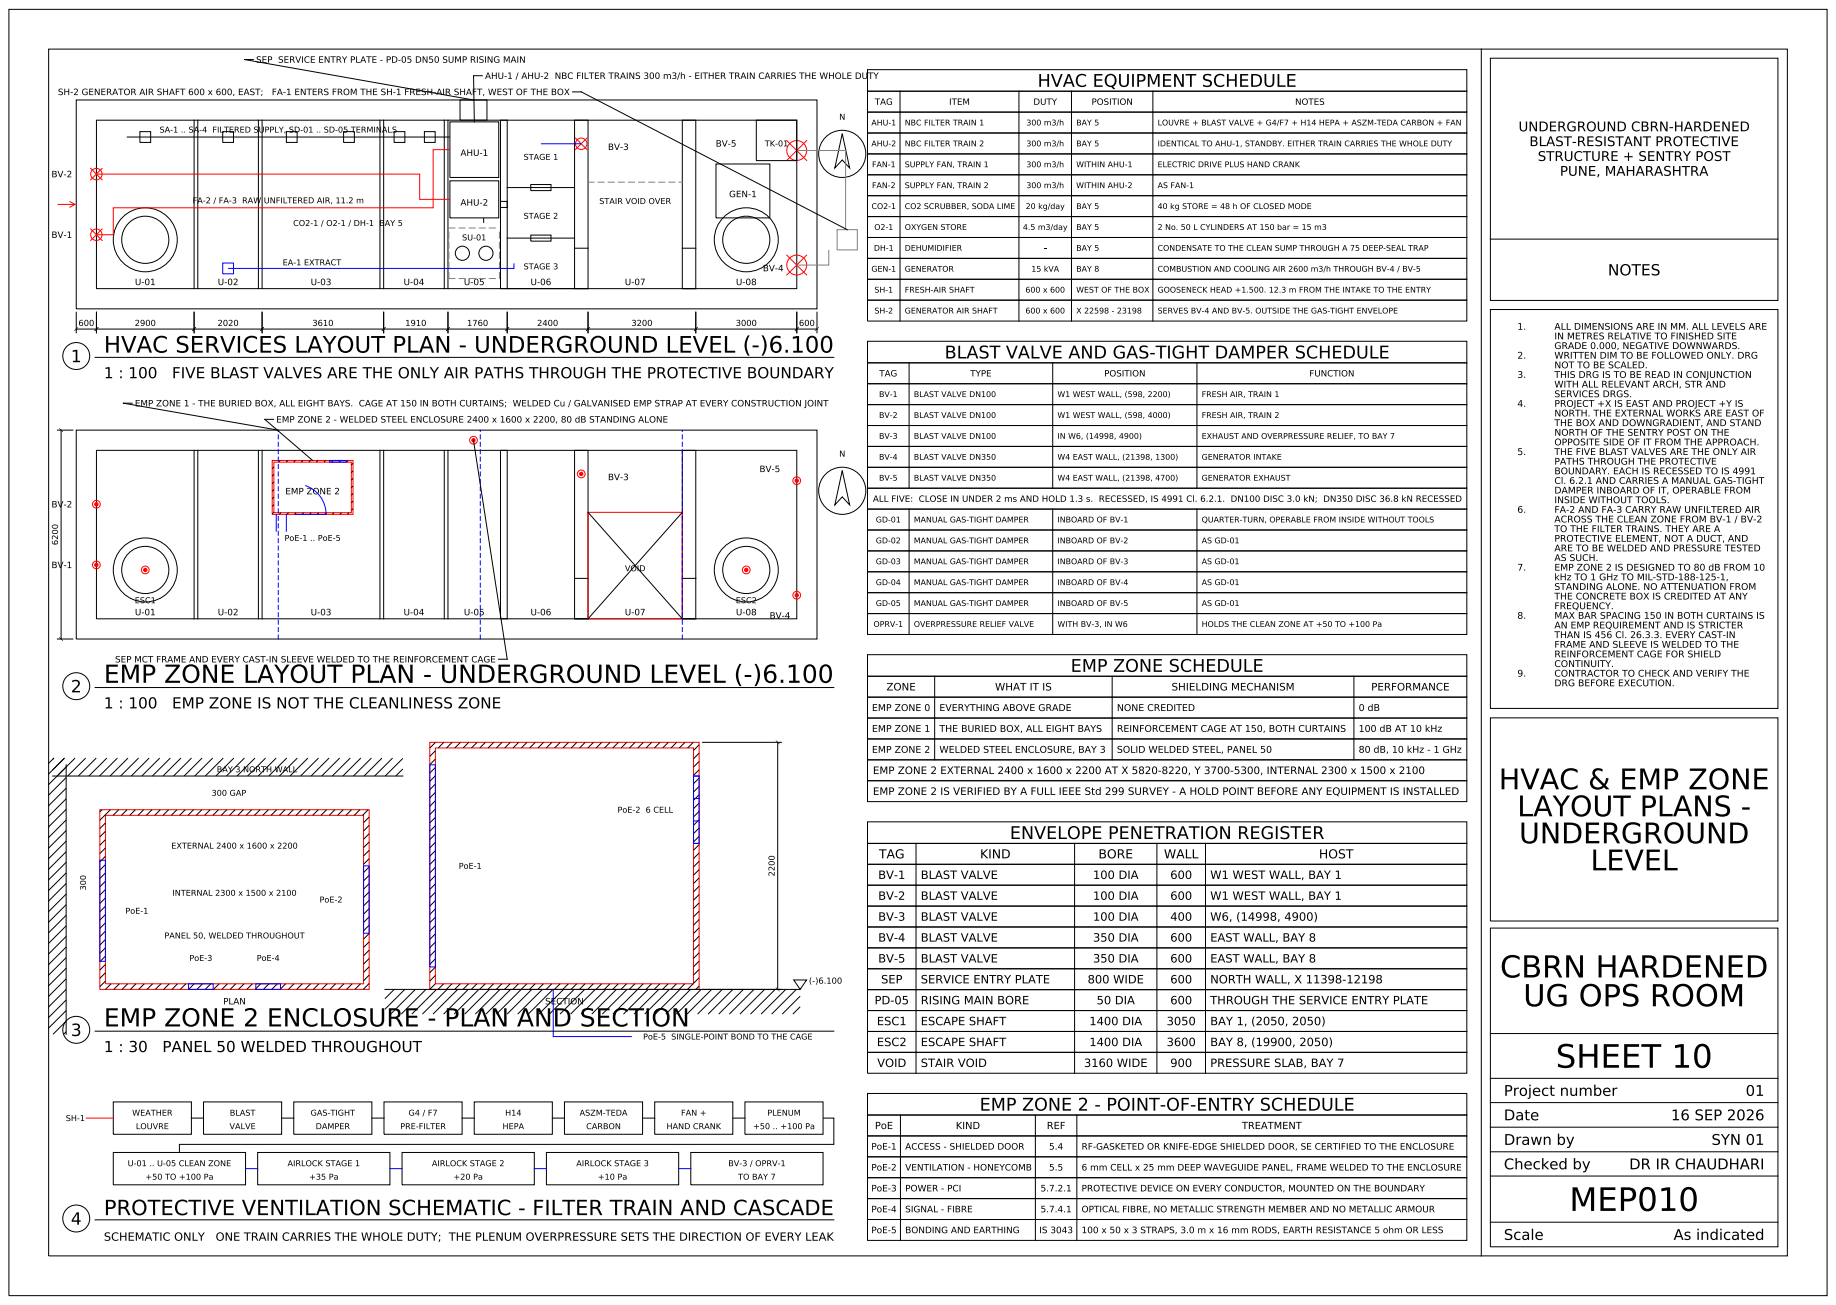
[picture p12: page 1]
