yatineode128-hue/underground-shelter-project/Presentation Sheets/PDF/MEP011_Septic_Tank_Soak_Pit_and_Sump_Pit_Plans_Sections_and_Schedules.pdf

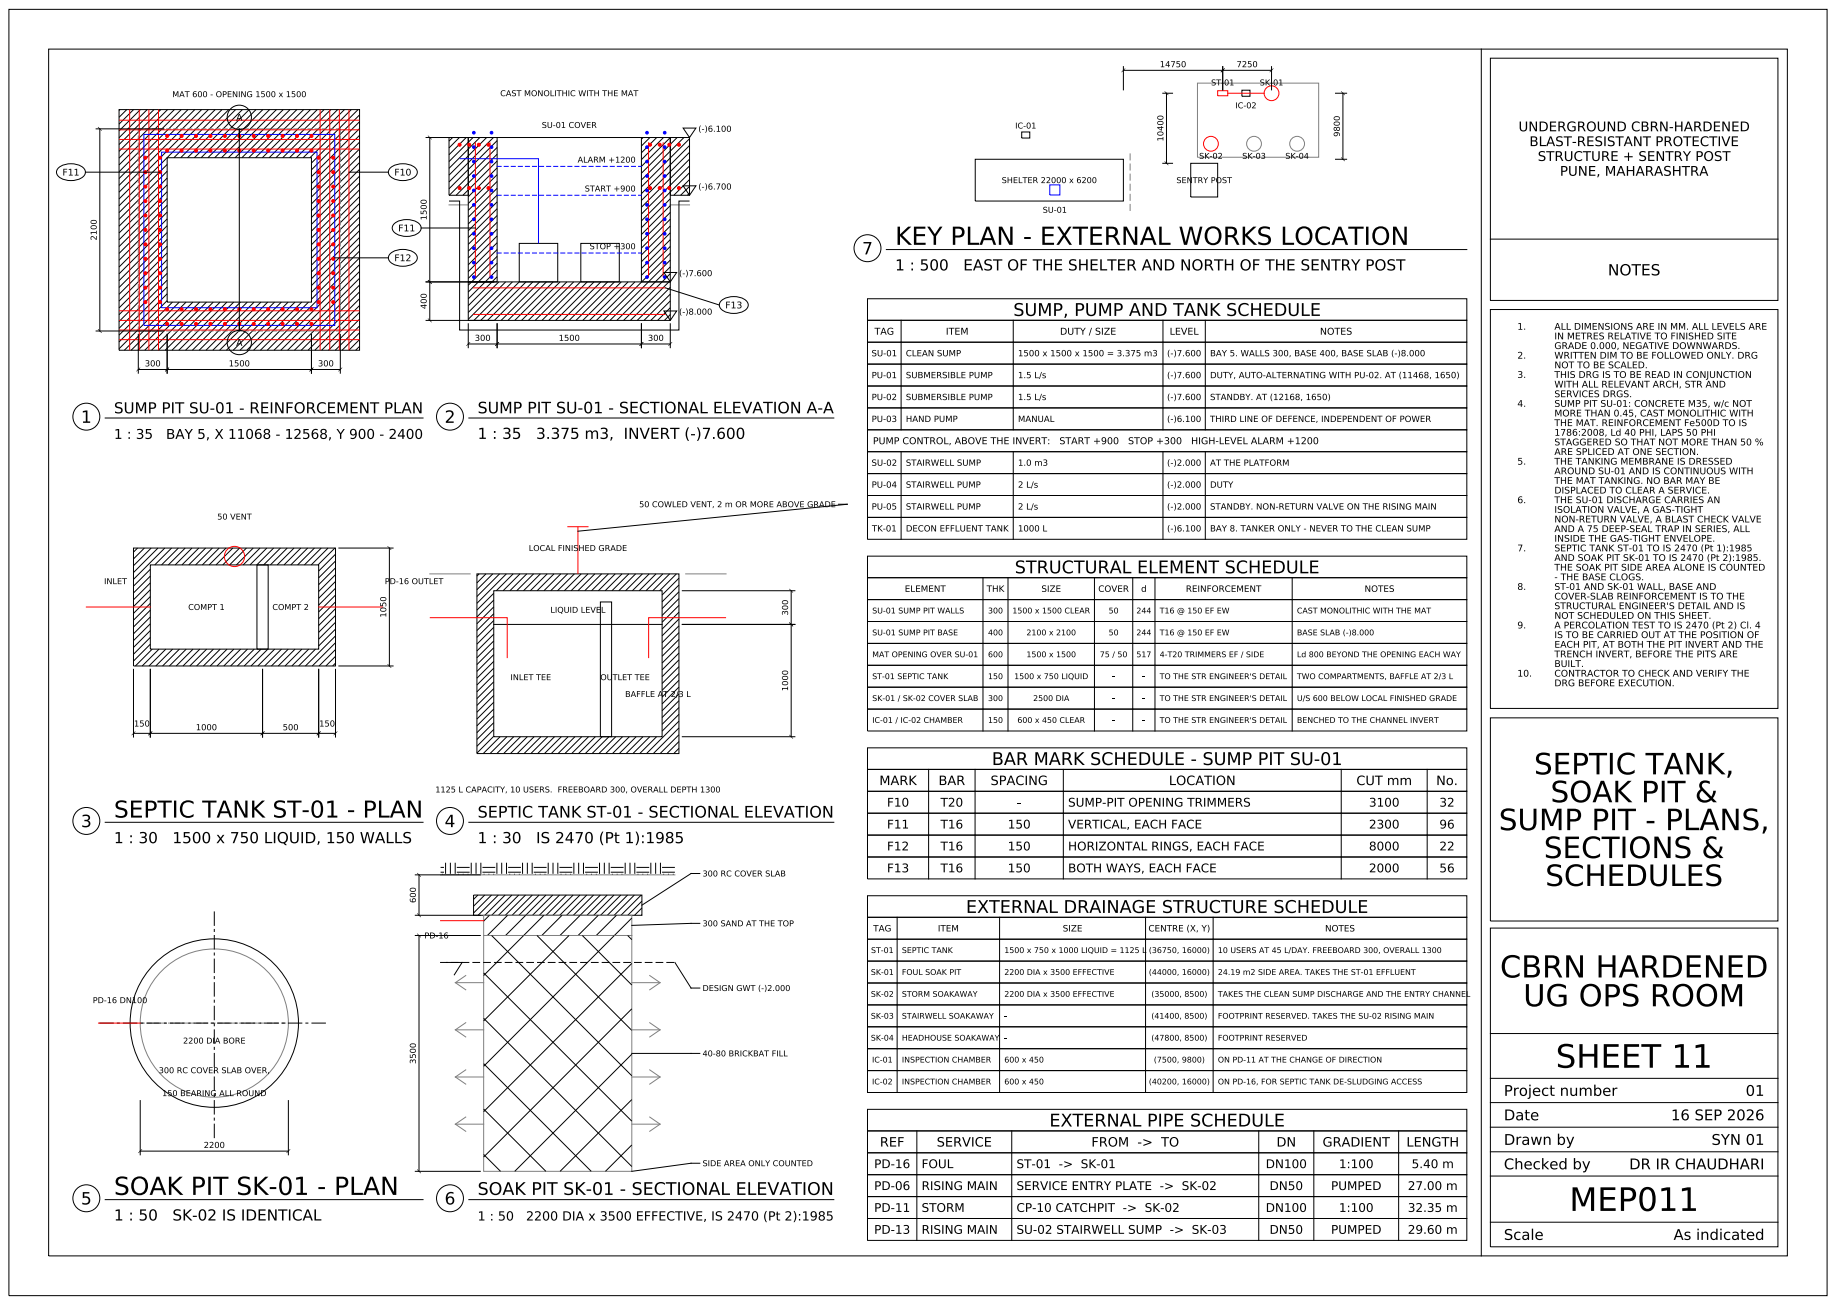
[picture p13: page 1]
