yatineode128-hue/underground-shelter-project/Presentation Sheets/PDF/STR006_Structural_Reinforcement_Detailing_Roof_Slab_and_Mat_Foundation.pdf

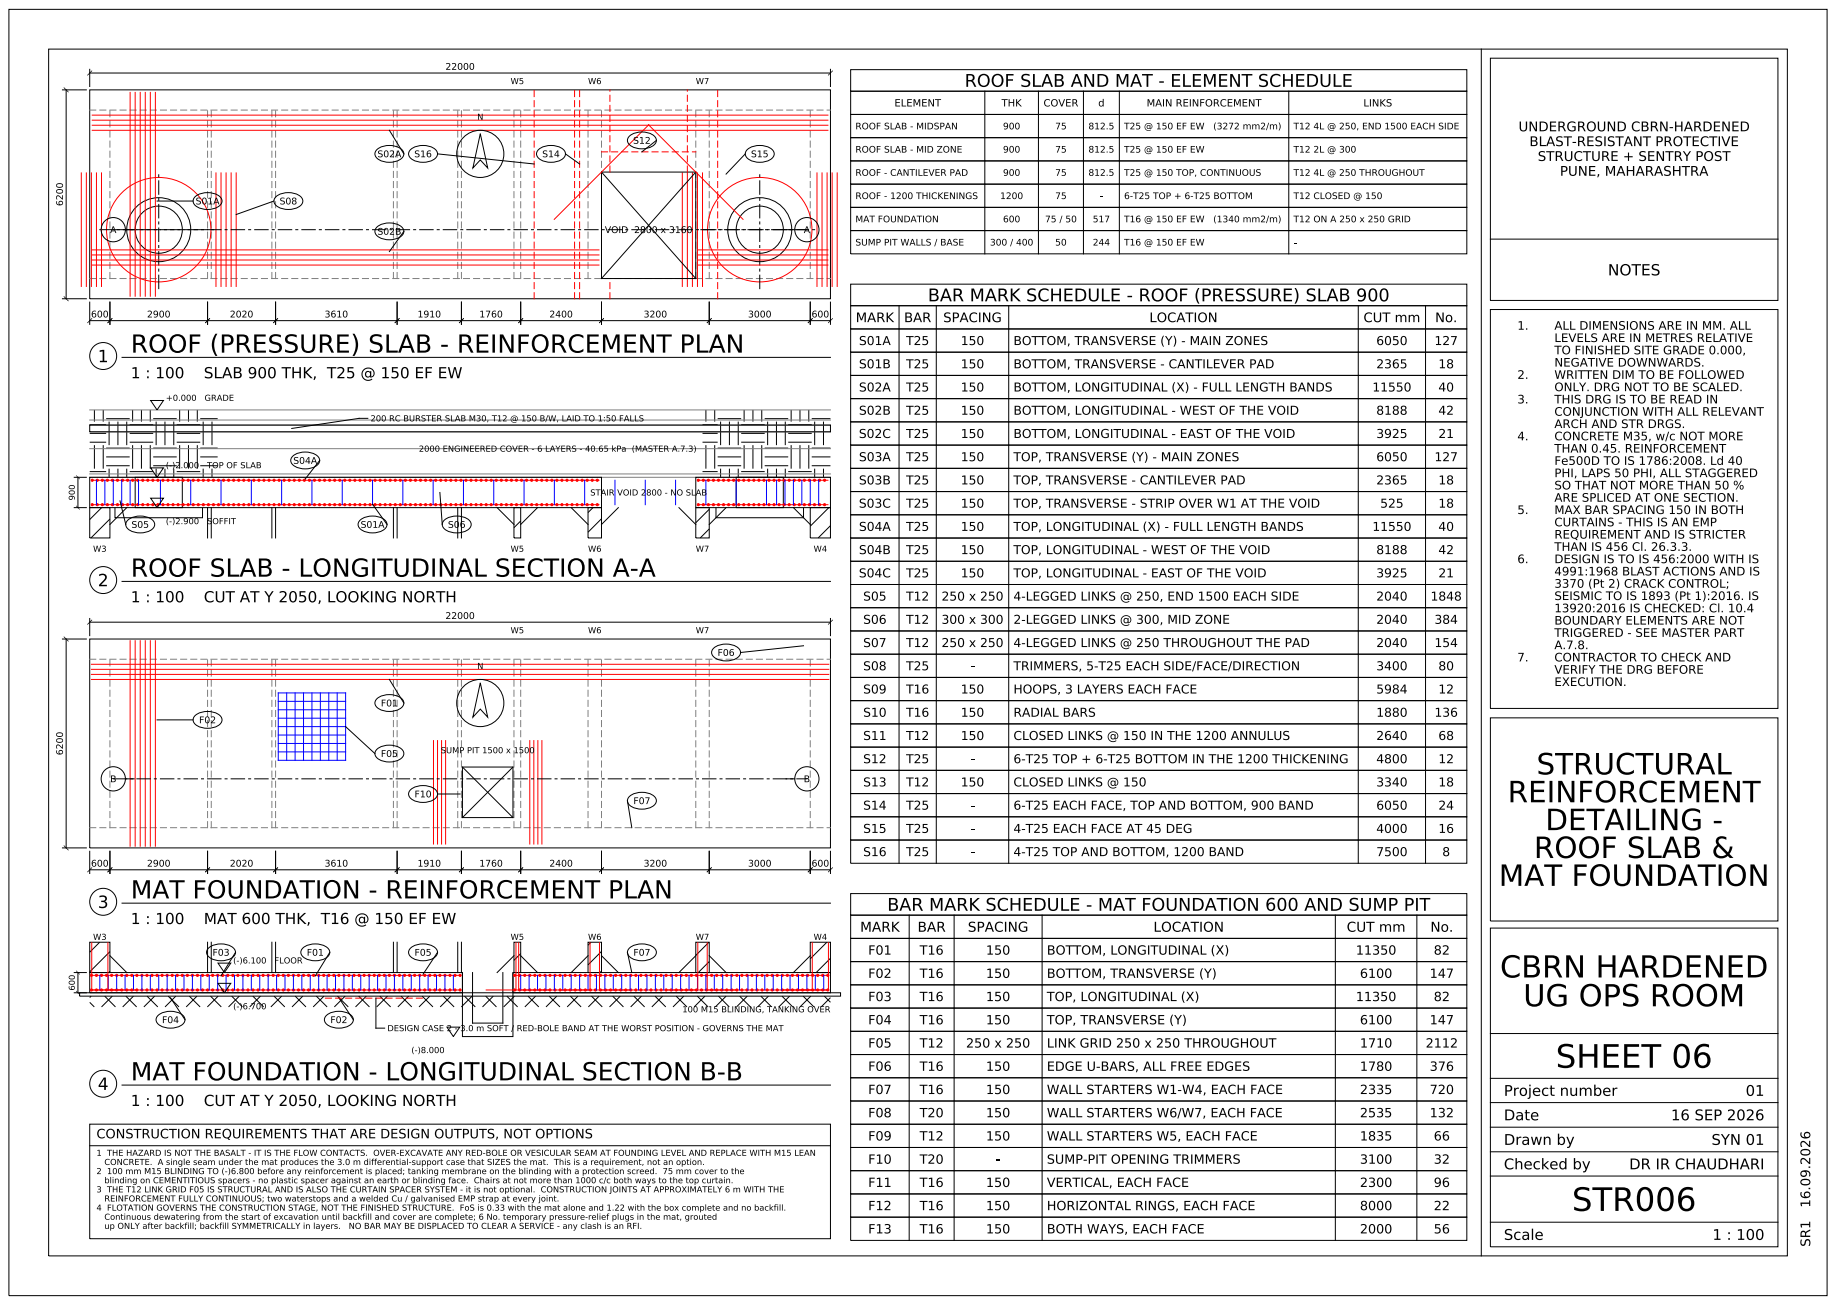
[picture p14: page 1]
