yatineode128-hue/underground-shelter-project/Presentation Sheets/PDF/STR007_Structural_Reinforcement_Detailing_Shear_Wall_and_Main_Staircase.pdf

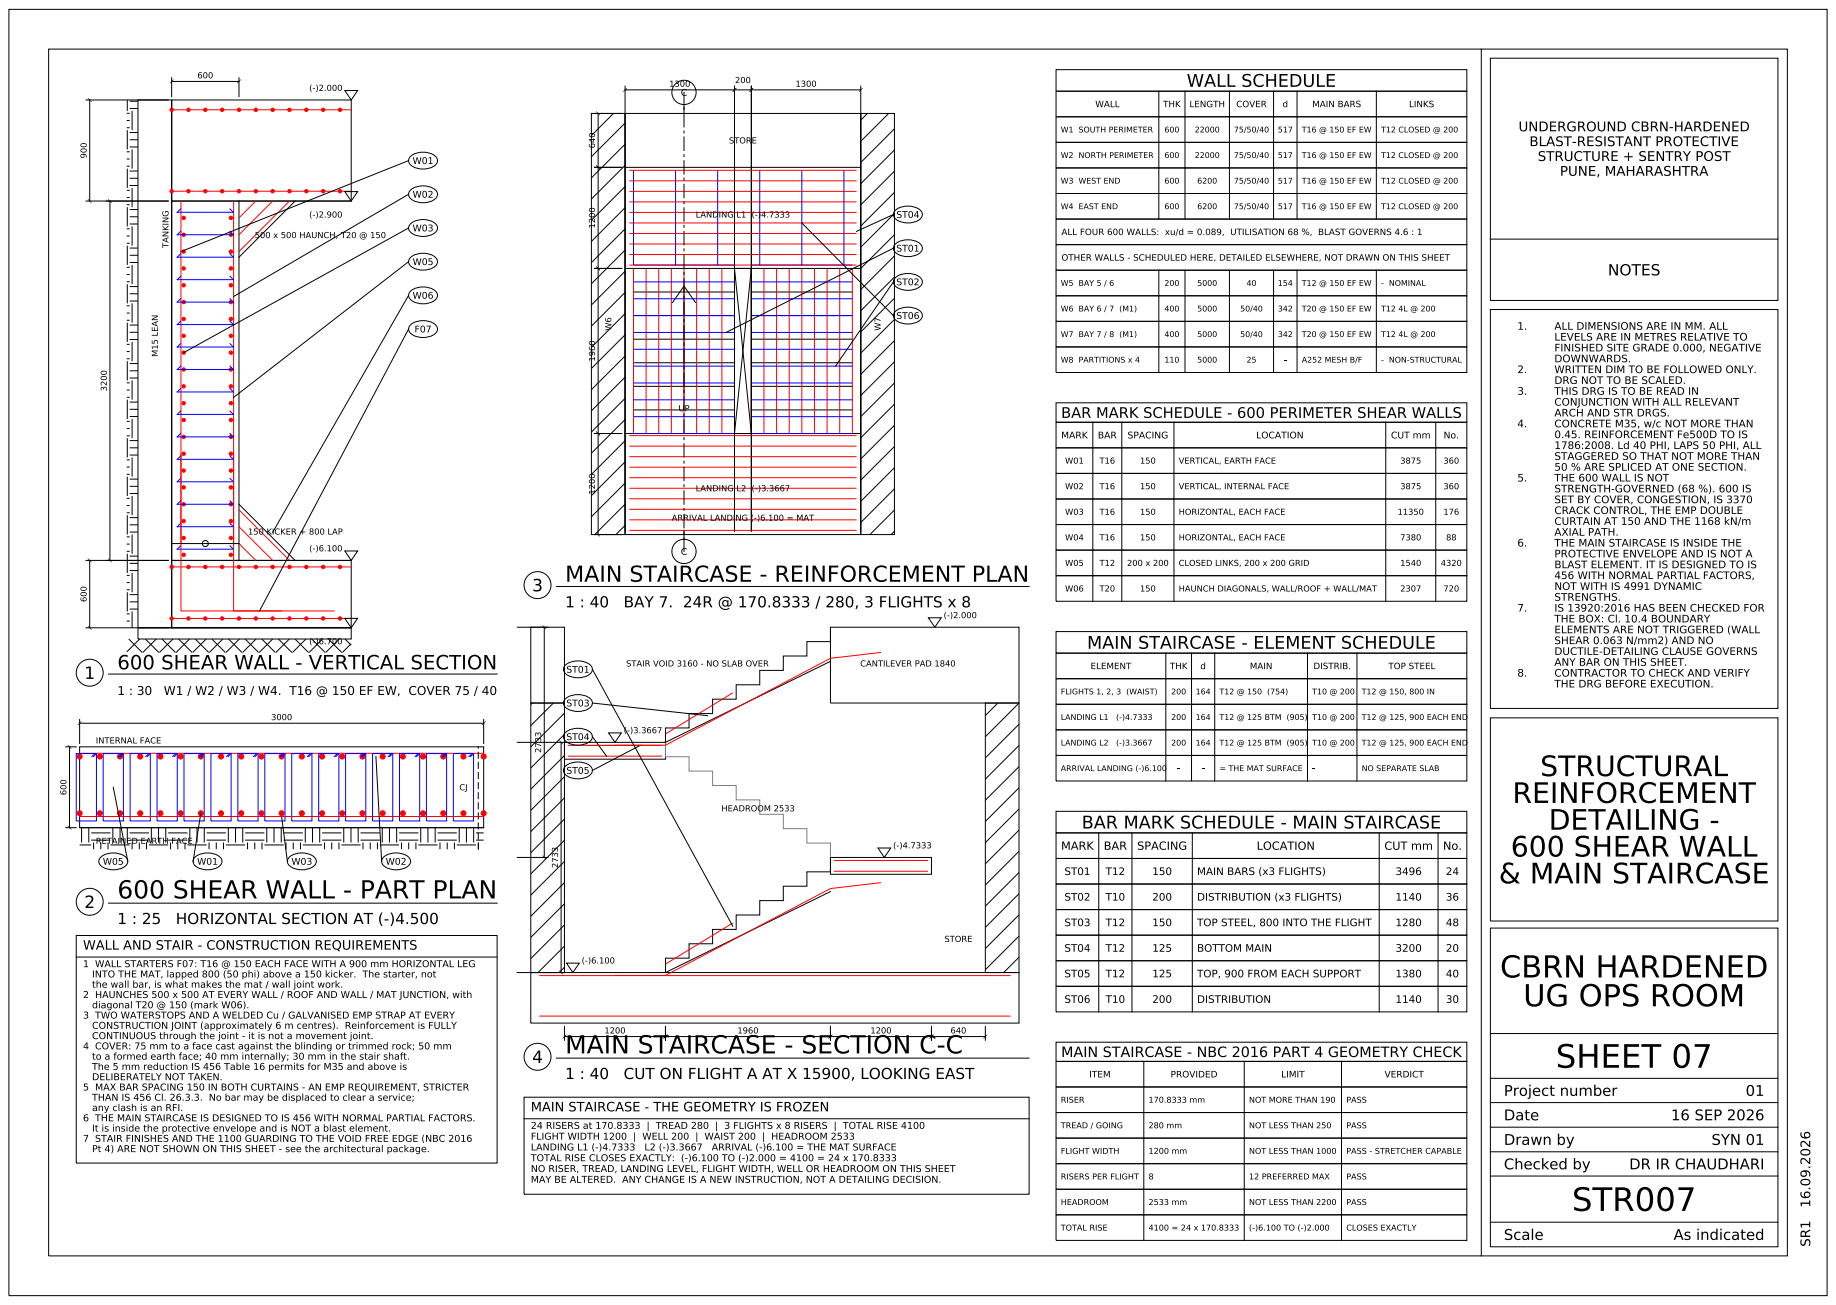
[picture p15: page 1]
