yatineode128-hue/underground-shelter-project/Presentation Sheets/PDF/STR008_Structural_Reinforcement_Detailing_Sentry_Post_Beams_and_Column.pdf

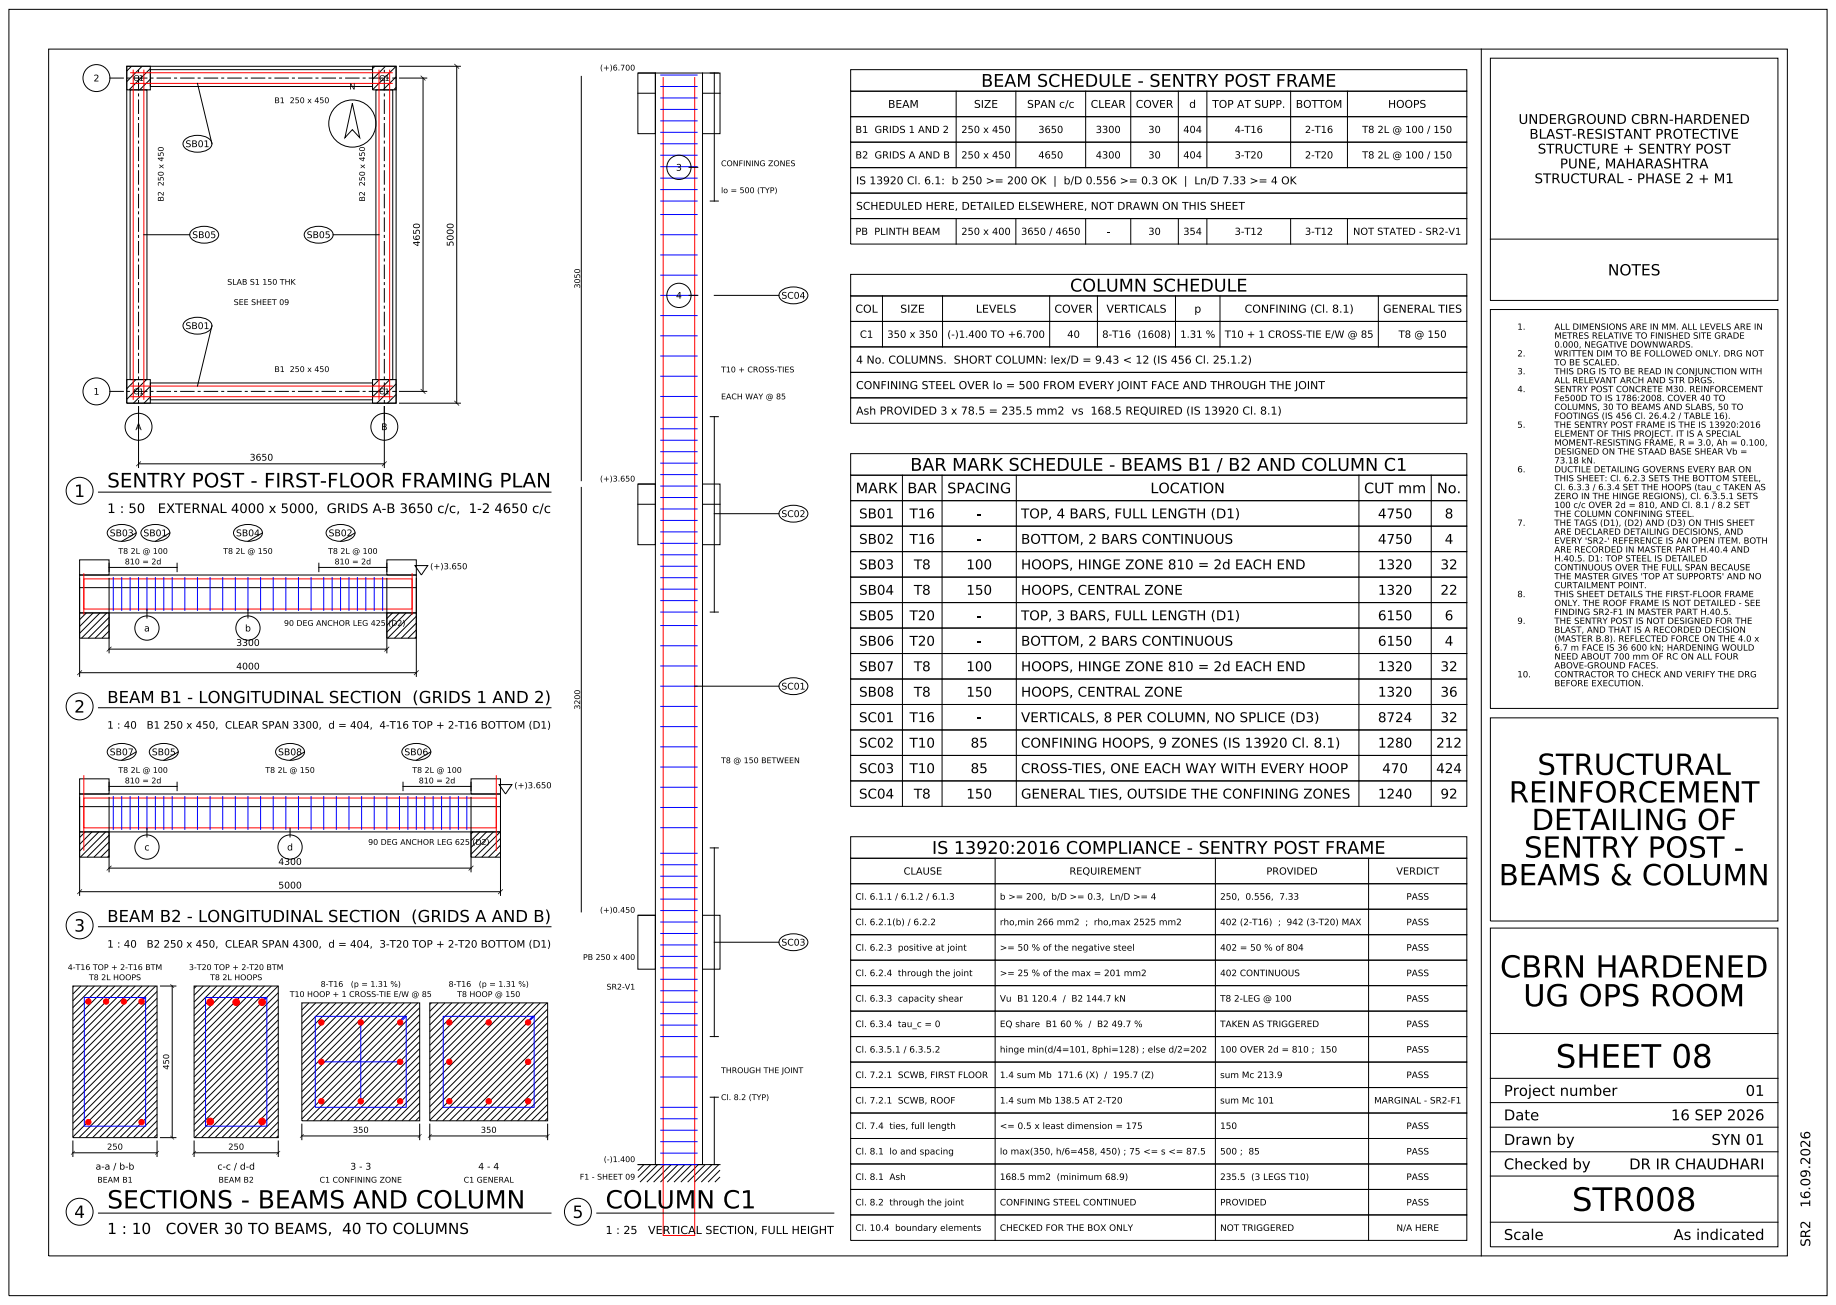
[picture p16: page 1]
