yatineode128-hue/underground-shelter-project/Presentation Sheets/PDF/STR009_Structural_Reinforcement_Detailing_Sentry_Post_Footing_and_Slab.pdf

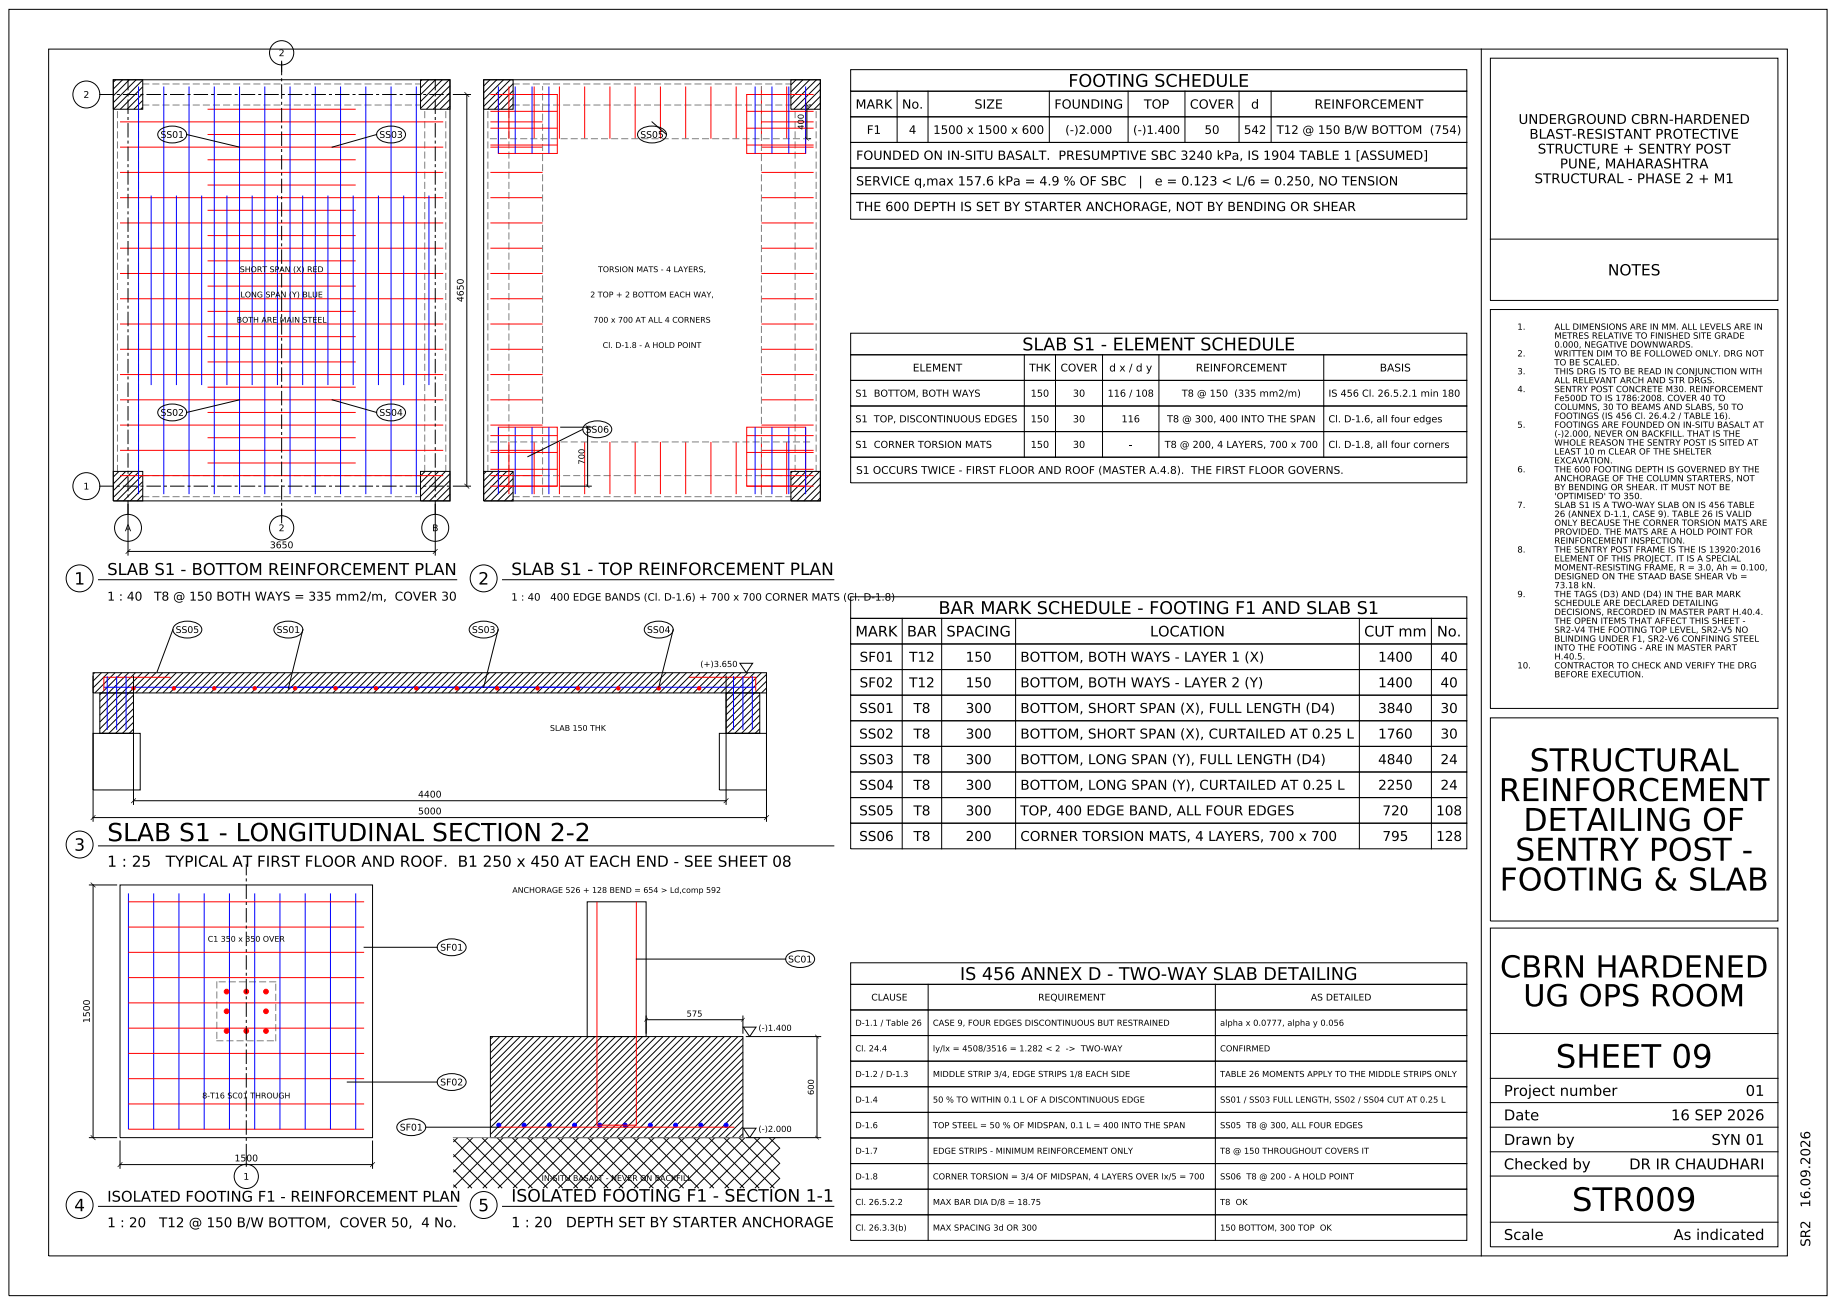
[picture p17: page 1]
