yatineode128-hue/underground-shelter-project/(commit log)

2026-09-03 Add files via upload
    Initial project upload
    [06_Underground_Plan_Services_Sump_BlastValves.dxf, 1_Staircase_Section.dxf, 1_Underground_Level_Plan.dxf, 2_Ground_Plan_Headhouse_Berm.dxf, 2_Side_Section_with_Stairs.dxf, 3_Headhouse_Section_Cutaway.dxf, 3_Sentry_Post_Ground_Floor_Plan.dxf, 4_Sentry_Post_First_Floor_Plan.dxf]
2026-09-03 Implement approved Modification M1 across CAD, STAAD and the master record
    M1 approved by the user. Parts A, B, F and L of the Master Summary already
    carried the M1 values; no design value in them was changed. This brings the
    CAD and STAAD files into agreement with them.
    DXF (6 of 10 input drawings; the other 4 are byte-identical)
    W6 14800-15200 (400 thk), W7 18000-18400 (400 thk), box 22000 external /
    20800 internal, shaft and void 15200-18000, ESC 2 centre X 19900, headhouse
    13600-18400, covered entry stairwell 9250-16050. Applied as the documented
    piecewise change, not a blanket shift: nothing west of X 14800 moves, W6 and
    W7 thicken about their own faces, the shaft shifts +200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
    [1_Underground_Level_Plan.dxf, 2_Ground_Plan_Headhouse_Berm.dxf, 2_Side_Section_with_Stairs.dxf, 3_Headhouse_Section_Cutaway.dxf, 5_Entry_Headhouse_Stair_Section.dxf, 5_Front_Elevation.dxf]
2026-09-03 Add CLAUDE.md operating guide and master/QUICK_STATE.md orientation digest
    Two context files so future sessions do not have to re-read the 2 000-line
    Master Summary to orient themselves.
    CLAUDE.md - permanent operating guide. Sets the authority chain (the Master
    Summary governs; QUICK_STATE.md is orientation only and never overrides it),
    the evidence discipline for [UNRESOLVED] / [ASSUMED] / [NOT AVAILABLE] tags,
    the frozen main staircase, the rule that input DXFs are editable source while
    the missing generators must not be fabricated, that STAAD models are checked
    against the master before modification, that reconciling a .std file is not
    running STAAD.Pro, and the git status/diff report r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
2026-09-03 Add MS1 mesh sensitivity study: coarse/medium/fine underground shelter STAAD models
    Builds three .STD variants of the reconciled M1 underground box model
    (current/staad/Underground_Structure_WITH_LOADS_worked_example (4).STD)
    differing only in plate mesh density, for a 3-model convergence study:
    - Medium: byte-identical copy of the reference mesh (0.6-0.7 m avg element,
    1113 joints / 1138 plates), header comments only.
    - Fine: exact h/2 refinement of every reference grid line (0.33 m avg
    element, 4500 joints / 4552 plates, 4x element count).
    - Coarse: alternating reference grid lines removed, always preserving the
    box boundary, W5/W6/W7 centrelines and all three opening edges (1.2 m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
2026-09-03 Add Revit 2026 BIM Phase 1: audit, project setup, structural model (BIM-P1)
    Phase 1 of the Revit 2026 BIM build: project audit, Revit project structure,
    and the structural envelope only, per the task's own scope cut (stop before
    architecture).
    - Audited CLAUDE.md, QUICK_STATE.md, Master Parts A/B/L, and all three
    primary STAAD models (underground box, sentry post, entry stairwell).
    No existing Revit folder, .rvt, or Dynamo/Revit API automation was found
    anywhere in the repository, contradicting the task's premise of an
    existing folder to reuse -- flagged in the QA doc rather than silently
    worked around.
    - Revit 2026 cannot run in this environment, so the deliverable is 6 Dynamo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
2026-09-05 Structural CAD reinforcement package SC1 - underground shelter
    Adds a complete, verified reinforcement design, detailing and CAD package for
    the underground shelter under `Structural CAD/`. SENTRY POST COMPLETELY EXCLUDED.
    SC1 is a deliverable, not a design change: no value in master Parts A, B, F or L
    was altered. The master edits are purely additive (97 insertions, 0 deletions).
    Deliverables
    - Input audit, design basis and 16-step element design for every in-scope element
    - 212 master Part B values independently recomputed: 211 agree, 1 differs
    - 92 bar marks / 70.46 t of bar bending schedules (master, per-group, CSV)
    - 30 A1 reinforcement drawings R-001..R-805, AutoCAD 2010 ASCII DXF, w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
    [BBS_MASTER.csv, R-001_General_Reinforcement_Notes.dxf, R-002_Reinforcement_Legend_and_Symbols.dxf, R-003_Typical_Reinforcement_Details.dxf, R-004_Reinforcement_Schedule.dxf, R-101_Mat_Foundation_Reinforcement_Plan.dxf, R-102_Mat_Foundation_Sections.dxf, R-103_Foundation_Wall_Details.dxf]
2026-09-05 Add DRAINAGE package (revision DR1)
    Complete drainage documentation package for the underground shelter,
    developed from the existing project files: master Parts A/B/E/F/G/K,
    issued sheet S-06, the Rev F architectural DXFs and R-805.
    Contents
    - Design basis, 11 A1 drawings (D-001 to D-305), 7 schedules,
    17-section calculation set, exactly-two-page A4 handout, QA/QC report,
    drawing index and a Revit script that extends the existing model.
    - All 13 DXF are AutoCAD 2010 ASCII with real editable entities
    (LINE, LWPOLYLINE, ARC, CIRCLE, TEXT, MTEXT, DIMENSION, LEADER,
    HATCH, INSERT); 13/13 pass an 11-check validator, 0 errors.
    - The sheet library subclasses Structural CAD/Scripts/sc_dxfli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
    [CHAMBER_SCHEDULE.csv, D-001_General_Drainage_Notes_Legend_Design_Basis.dxf, D-002_Drainage_Symbols_and_Pipe_Coding.dxf, D-101_Above_Ground_Entry_Level_Drainage_Plan.dxf, D-102_Rainwater_Catchment_and_Surface_Water_Plan.dxf, D-103_Entry_Stairwell_and_Headhouse_Drainage.dxf, D-201_Underground_Drainage_Plan.dxf, D-203_Underground_Wastewater_and_Sanitary_Plan.dxf]
2026-09-05 Add HVAC package (revision HV1)
    Protected-ventilation package for the underground shelter, developed from
    the existing project files: master Parts A/B/G/K and issued sheet S-06.
    - Design basis, 6 A1 drawings (M-001 to M-203), 7 schedules, a 14-section
    calculation set, exactly-two-page A4 handout, QA/QC, drawing index and a
    Revit script that extends the existing model.
    - All 8 DXF are AutoCAD 2010 ASCII with real editable entities; 8/8 pass
    the shared 11-check validator, 0 errors.
    Verification of the existing basis
    - ELEVEN S-06 FIGURES REPRODUCED FROM FIRST PRINCIPLES, all check:
    envelope 67.8 m2 / 217.0 m3, clean zone 57.8 m2 / 185.0 m3, the FEMA 453
    rate 264 m3/h, leak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
    [AIRFLOW_SCHEDULE.csv, DAMPER_AND_VALVE_SCHEDULE.csv, DUCT_SCHEDULE.csv, FILTER_TRAIN_SCHEDULE.csv, HV-H1_HVAC_Normal_Operation.dxf, HV-H2_HVAC_Emergency_Protective_Operation.dxf, HVAC_EQUIPMENT_SCHEDULE.csv, M-001_HVAC_General_Notes_and_Design_Basis.dxf]
2026-09-05 Add SCHEDULE OF FINISHES package (revision FN1)
    Finish schedule for every space in the project except the sentry post,
    built on the premise that NO FINISH SPECIFICATION EXISTS ANYWHERE IN THIS
    PROJECT - which is true, and is the first thing the package says.
    Approach
    - Every code is a PERFORMANCE REQUIREMENT traced to something the project
    does confirm, not a product. The product is deliberately left open and
    nine missing items are listed with reasons.
    - Traceability examples: the stair shaft gets a wet/dirty-zone finish
    because master A.5 designates those faces exactly that (it is why their
    cover is 30 and not 40); the headhouse gets a hose-down finish and a
    1:80 fall because th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
    [A-601_Finish_Legend_Notes_and_Typical_Details.dxf, A-611_Entry_Level_Finish_Plan.dxf, A-612_Underground_Level_Finish_Plan.dxf, FINISHES_DATA_REQUIRED.csv, FINISH_LEGEND.csv, FINISH_RULES.csv, ROOM_FINISH_SCHEDULE.csv, STAIR_FINISH_SCHEDULE.csv]
2026-09-05 Cross-discipline coordination + project state update (DR1/HV1/FN1)
    Phase 6 and 7 of the drainage / HVAC / finishes work. No design value in
    master Parts A, B, F or L is changed, and no existing drawing or model file
    is touched.
    Coordination (MEP_AND_FINISHES_COORDINATION.md, CO-1..CO-10)
    - CO-1 the rising main cannot run at low level through Bay 5: the two NBC
    filter trains leave 58 mm west and 52 mm east, and the direct line
    from the sump to the service entry plate passes through both.
    Resolved to a high-level route; the plate level is consequently
    required and is not recorded anywhere in the project.
    - CO-1b S-06's rising main read as a schematic line, wit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
    [A-601_Finish_Legend_Notes_and_Typical_Details.dxf, A-611_Entry_Level_Finish_Plan.dxf, A-612_Underground_Level_Finish_Plan.dxf, D-001_General_Drainage_Notes_Legend_Design_Basis.dxf, D-002_Drainage_Symbols_and_Pipe_Coding.dxf, D-101_Above_Ground_Entry_Level_Drainage_Plan.dxf, D-102_Rainwater_Catchment_and_Surface_Water_Plan.dxf, D-103_Entry_Stairwell_and_Headhouse_Drainage.dxf]
2026-09-07 Works Management package WM1 — complete project, mobilisation to handover
    Adds a full Works Management package for the ENTIRE project: the underground
    shelter, the entry headhouse and covered stairwell, the escape shafts, the
    engineered cover, the sentry post, the services, the external works and the
    concealment works.
    THE ONE DESIGN CHANGE — reference SP-B1
    The sentry post walls are BRICK MASONRY, replacing the Rev F "200 RC
    ballistic infill panels". Adopted as 190 one-brick modular brickwork to
    IS 1077 in CM 1:6, built inside the CONFIRMED 200 structural zone with the
    residual 10 mm taken up at the internal face in the plaster, so the
    confirmed 4000 x 5000 external envelope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
    [Underground_Shelter_BOQ.csv, Underground_Shelter_Codes_References.csv, Underground_Shelter_Final_Works_Programme.csv, Underground_Shelter_Procurement_Plan.csv, Underground_Shelter_QA_QC_Plan.csv, Underground_Shelter_Resource_Plan.csv, Underground_Shelter_Safety_Risk_Register.csv, Underground_Shelter_WBS.csv]
2026-09-09 DXF QA/QC pass QA1: remove every text-on-text collision in the 55 generated sheets
    Sheet library (sc_dxflib.py, shared by the R-series, Drainage, HVAC and
    Schedule of Finishes):
    - panel() and table() now measure their own content with the same font
    metrics ezdxf uses to place it. A panel line can no longer run past the
    box edge and a cell can no longer run into the next column: the text is
    fitted first, and only then is the box widened.
    - panel() heading band is derived from the heading and body sizes instead
    of a fixed 7.4 mm, so a large body size cannot collide with its heading.
    - panel bodies and table cells are lifted to a legible 2.0 mm where the box
    has room (they were all a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
    [A-601_Finish_Legend_Notes_and_Typical_Details.dxf, A-611_Entry_Level_Finish_Plan.dxf, A-612_Underground_Level_Finish_Plan.dxf, D-001_General_Drainage_Notes_Legend_Design_Basis.dxf, D-002_Drainage_Symbols_and_Pipe_Coding.dxf, D-101_Above_Ground_Entry_Level_Drainage_Plan.dxf, D-102_Rainwater_Catchment_and_Surface_Water_Plan.dxf, D-103_Entry_Stairwell_and_Headhouse_Drainage.dxf]
2026-09-09 DXF QA/QC pass QA1 (2): views drawn on top of their own notes panels
    Three sheets drew a whole view through a text panel because the view origin
    placed it in the panel's column, while the view's own title, balloons and
    section marks sat on the empty half of the sheet:
    - R-601 origin (90, 260) mapped the stair shaft to paper x 682..826, so the
    1:25 staircase plan was drawn over the MATERIALS panel and ran off
    the right border. Origin corrected to (-508, 282); north arrow and
    the two floating notes moved with it.
    - R-701 origin (70, 380) mapped the headhouse to paper x 410..530, straight
    through "HEADHOUSE ROOF 500 - DESIGN BASIS". Corrected to (-240, 3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
    [A-601_Finish_Legend_Notes_and_Typical_Details.dxf, A-611_Entry_Level_Finish_Plan.dxf, A-612_Underground_Level_Finish_Plan.dxf, D-001_General_Drainage_Notes_Legend_Design_Basis.dxf, D-002_Drainage_Symbols_and_Pipe_Coding.dxf, D-101_Above_Ground_Entry_Level_Drainage_Plan.dxf, D-102_Rainwater_Catchment_and_Surface_Water_Plan.dxf, D-103_Entry_Stairwell_and_Headhouse_Drainage.dxf]
2026-09-09 DXF QA/QC pass QA1 (3): sanitise and sheet the eleven current/cad drawings
    The ten Rev F drawings were model-space drawings, not sheets: no border, no
    title block, no notes box, and annotation lying across the line work.
    Annotation (all eleven files, S-06 included)
    - 93 labels moved off the walls, stairs, openings, dimensions and each other,
    each to the nearest clear position; 28 short leaders added where a label had
    to travel more than four text heights. Hard clashes 115 -> 18.
    - Text on TITLEBLOCK, TEXT-TITLE, TABLE, NOTES and DIM layers is never moved:
    those belong to a structured block or to their own dimension line.
    - Background line work (GROUND, HIDDEN "below", BEYOND, CENTRE,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
    [06_Underground_Plan_Services_Sump_BlastValves.dxf, 1_Staircase_Section.dxf, 1_Underground_Level_Plan.dxf, 2_Ground_Plan_Headhouse_Berm.dxf, 2_Side_Section_with_Stairs.dxf, 3_Headhouse_Section_Cutaway.dxf, 3_Sentry_Post_Ground_Floor_Plan.dxf, 4_Sentry_Post_First_Floor_Plan.dxf]
2026-09-09 DXF QA/QC pass QA1 (4): R-002 composition, second de-clash pass on the Rev F set
    R-002 REINFORCEMENT LEGEND AND SYMBOLS was the worst-composed sheet in the
    package (45 % of it empty, legend descriptions at 1.4 mm):
    - layer-table row height 4.2 -> 6.8, legend line pitch opened,
    - every legend description lifted from 1.4 mm to 2.0 mm,
    - the right-hand column (abbreviations, bar sizes, spacing) now lays out with
    panel_column so it fills the column and stops clear of the title block.
    Second, wider de-clash pass on the five crowded Rev F drawings: the last
    labels that could not find clear space at the first search radius are now
    placed. Residual hard clashes across the whole package: 2.
    Pack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
    [1_Staircase_Section.dxf, 2_Ground_Plan_Headhouse_Berm.dxf, 2_Side_Section_with_Stairs.dxf, 3_Headhouse_Section_Cutaway.dxf, 5_Entry_Headhouse_Stair_Section.dxf, R-001_General_Reinforcement_Notes.dxf, R-002_Reinforcement_Legend_and_Symbols.dxf, R-003_Typical_Reinforcement_Details.dxf]
2026-09-10 DXF QA/QC pass QA1 (5): drawing index, QA/QC report, master record, R-004 composition
    - `DRAWING QAQC/DRAWING_INDEX.md` - the index for all 65 DXF (60 A1, 1 A0, 4 A4),
    generated from the drawings themselves so it cannot drift from them. Carries
    drawing number, title, scale, sheet size, text count, QA verdict AND filename.
    - `DRAWING QAQC/QAQC_REPORT.md` - what was found, what was corrected, how many
    inspect/correct/plot cycles each sheet took, what is still open, and the
    hard-copy readiness checklist.
    - `DRAWING QAQC/Scripts/` - the five inspection scripts plus the index generator.
    - `current/cad/Scripts/` - the recorded pipeline that produced the current state
    of the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
    [06_Underground_Plan_Services_Sump_BlastValves.dxf, 1_Staircase_Section.dxf, 1_Underground_Level_Plan.dxf, 2_Ground_Plan_Headhouse_Berm.dxf, 2_Side_Section_with_Stairs.dxf, 3_Headhouse_Section_Cutaway.dxf, 3_Sentry_Post_Ground_Floor_Plan.dxf, 4_Sentry_Post_First_Floor_Plan.dxf]
2026-09-10 BS1 + SP-B2: burster slab laid to falls, sentry post lintels and wall ties
    Two instructed design changes, carried through the master, the calculations
    and every drawing that shows them. Recorded in master Part H.12, with the
    design itself in A.7.3 (BS1) and A.4.8 (SP-B2).
    BS1 - the RC burster slab is laid to falls
    ------------------------------------------
    The 200 M30 burster slab and every layer over it is now laid to a 1:50
    crossfall, crowned on the box longitudinal centreline (Y 3100) and falling
    62 mm each way to the box edge - the same fall and direction as the finished
    grade, which A.4.3 already records as crowned, falling 1:50 away.
    It fixes a real defect. The granular filter bear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
    [2_Side_Section_with_Stairs.dxf, 3_Sentry_Post_Ground_Floor_Plan.dxf, 4_Sentry_Post_First_Floor_Plan.dxf, 5_Front_Elevation.dxf, 6_Sentry_Post_Framing_Plan.dxf, D-001_General_Drainage_Notes_Legend_Design_Basis.dxf, D-002_Drainage_Symbols_and_Pipe_Coding.dxf, D-101_Above_Ground_Entry_Level_Drainage_Plan.dxf]
2026-09-10 WM2: adopt the project owner's own BOQ, cost estimate and construction schedule
    The owner supplied four Works Management files. Under the brief's order of
    authority they come FIRST - ahead of the master, ahead of the project
    documentation, and ahead of the generated package WM1 - so they now govern
    Works Management. Nothing of theirs has been corrected, re-derived, rounded
    or rebuilt, and WM1 is preserved, not overwritten.
    Recorded in master Part H.13.
    What is now published
    ---------------------
    USER_SOURCE/ holds the owner's four files unaltered: the BOQ and cost
    estimate workbook, the eight-page BOQ / works-management report, the master
    construction schedule R0 as a .mpp, and its Level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
    [USER_BOQ_PRICED.csv, USER_BOQ_TAKEOFF.csv, USER_COST_SUMMARY.csv, USER_MASTER_CONSTRUCTION_SCHEDULE_R0.csv, Underground_CBRN_Ops_Room_BOQ_Estimate.xlsx]
2026-09-10 SP-B2 carried through the Works Management package; QA-2 void figures refreshed
    Follow-through on "make changes in all places". The WM1 package still said,
    in eleven places, that NO LINTEL DESIGN AND NO WALL TIE DETAIL EXIST ANYWHERE
    IN THE PROJECT. SP-B2 designed both on 10 September, so those statements had
    become false - and a Works Management package that tells a builder a design
    does not exist, when it does, is worse than one carrying a stale quantity.
    Corrected at the generators and the package rebuilt:
    wm_content.py the SP-B1 consequences paragraph; TIES TO THE COLUMNS;
    LINTELS; risk R-09
    wm_docs.py shared document header banner; the masonry docu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
    [Underground_Shelter_Safety_Risk_Register.csv]
2026-09-10 RC1: rule on every inconsistency in the project
    Instructed: "remove all inconsistencies everywhere in all respects by
    choosing best option possible." That is an explicit instruction to decide,
    and it overrides the standing rule that a conflicting value stays
    [UNRESOLVED] until a person rules on it.
    TWENTY ITEMS CLOSED. Six that need information the project does not
    contain are NOT closed, and are now stated as single positions in K.1b
    rather than as conflicts - because none of them is a conflict any more.
    Recorded in master Part H.14, with K.1 rewritten as a ruled register:
    K.1 (project), K.1b (still open), K.1c (Works Management), K.1d (the
    pre-RC1 register, preserved under M.11).
    The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
    [A-601_Finish_Legend_Notes_and_Typical_Details.dxf, A-611_Entry_Level_Finish_Plan.dxf, A-612_Underground_Level_Finish_Plan.dxf, D-001_General_Drainage_Notes_Legend_Design_Basis.dxf, D-002_Drainage_Symbols_and_Pipe_Coding.dxf, D-101_Above_Ground_Entry_Level_Drainage_Plan.dxf, D-102_Rainwater_Catchment_and_Surface_Water_Plan.dxf, D-103_Entry_Stairwell_and_Headhouse_Drainage.dxf]
2026-09-10 WM3: the owner's Works Management package, revised with the RC1 rulings applied
    Requested: store the latest revised Works Management alongside the files
    uploaded in this session.
    RC1 (Part H.14) ruled on the owner's package but RECORDED the rulings rather
    than applying them, because WM2's whole position was that their figures are
    published exactly as supplied. WM3 closes that loop. Recorded in Part H.15.
    Three versions now exist side by side, deliberately
    ---------------------------------------------------
    USER_SOURCE/ the owner's four files, BYTE-FOR-BYTE
    UNTOUCHED - verified, git shows no change
    Cost/USER_BOQ_* th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
    [D-001_General_Drainage_Notes_Legend_Design_Basis.dxf, D-002_Drainage_Symbols_and_Pipe_Coding.dxf, D-101_Above_Ground_Entry_Level_Drainage_Plan.dxf, D-102_Rainwater_Catchment_and_Surface_Water_Plan.dxf, D-103_Entry_Stairwell_and_Headhouse_Drainage.dxf, D-201_Underground_Drainage_Plan.dxf, D-203_Underground_Wastewater_and_Sanitary_Plan.dxf, D-204_Sump_and_Pumping.dxf]
2026-09-10 CAM2/FS2: move the camouflage policy and fire plan into their own packages, and draw them
    Both documents were in WORKS MANAGEMENT/Documentation/ because that is where
    the generator that produced them happened to live, not because either one is a
    works-management deliverable. A camouflage policy is a site and security matter
    for the operator; a fire safety and evacuation plan is a life-safety design and
    operating document for the finished shelter. Neither describes how the works
    are managed.
    WORKS MANAGEMENT/Documentation/WM_CAMOUFLAGE_AND_CONCEALMENT_POLICY.md
    -> Site and Concealment/Documentation/CAMOUFLAGE_AND_CONCEALMENT_POLICY.md CAM2
    WORKS MANAGEMENT/Documentation/WM_FIRE_SAF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
    [C-101_Above_Ground_Signature_Elevation.dxf, F-101_Underground_Level_Escape_Plan.dxf, F-102_Entry_Level_Escape_Plan.dxf, FS_ESCAPE_ROUTE_SCHEDULE.csv]
2026-09-10 CAM2/FS2 follow-up: the consistency edits the relocation implies
    Five places still described the project as it stood before H.18. None is a
    design change; each is a statement that my own commit made stale.
    master/QUICK_STATE.md
    K.1b now reads EIGHT open items, not six - FS-V7 (how either escape shaft
    is climbed: 6.250 m and 6.800 m with no ladder, rung or fall-arrest
    specified anywhere, which needs a DESIGN, not a ruling) and CAM-V5 (SH-2's
    head level, recorded nowhere) were added to the master register but the
    digest still said six.
    The stale-PDF note now says which revisions the PDF predates - it is the
    user's upload of 9 September, there is no generator for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
2026-09-10 EM1: EMP protection package — the project required it since Rev F and had never designed it
    EMP hardening is in the project objective, the bay schedule (an "EMP Zone 2
    enclosure" in bay 3), the materials table (150 bar spacing "an EMP requirement"),
    the code register (MIL-STD-188-125-1, IEEE Std 299), thirty drawings and eight
    bar-bending schedules. It had never once been designed. Master H.10 already
    listed the EMP enclosure specification among the thirteen missing items, and the
    finishes package carried W-04 as [C] requirement / [N] specification.
    THE GOVERNING FACT, and it reproduces the master's own number.
    The concrete box is not an EMP shield and never could have been. At the confir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
    [BONDING_AND_EARTHING_SCHEDULE.csv, EM-001_EMP_Design_Basis_and_Zone_Key.dxf, EM-101_EMP_Zone_Plan_Underground.dxf, EM-102_EMP_Boundary_Section_Entry_Path.dxf, EM-201_Shielding_Effectiveness_Cage_and_Apertures.dxf, EM-301_EMP_Zone_2_Enclosure.dxf, EM-302_EMP_Penetration_Bonding_and_Earthing_Details.dxf, EMP_ZONE_SCHEDULE.csv]
2026-09-11 EL1: a basic electrical and power design — the project's largest gap, closed enough to unblock three packages
    "No electrical design package exists" has headed the thirteen-gap list since
    WM1. Three packages were stuck behind it in their own words: FS-V2 ("no fire
    detection, alarm, emergency lighting or suppression exists anywhere. Follows
    the missing electrical design"), EM-V2 (EMP Zone 2 dimensions await an
    equipment schedule), and HVAC P11 ("distribution, UPS and battery autonomy are
    an electrical scope item, not designed here").
    This is the minimum that unblocks them. It stops at board level, on purpose.
    A SOURCE THE MASTER NEVER RECORDED. The shelter has two supplies, not one.
    GEN-1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
    [DISTRIBUTION_AND_ESSENTIAL_SCHEDULE.csv, E-001_Single_Line_Diagram.dxf, EM-001_EMP_Design_Basis_and_Zone_Key.dxf, EM-102_EMP_Boundary_Section_Entry_Path.dxf, EM-201_Shielding_Effectiveness_Cage_and_Apertures.dxf, EM-301_EMP_Zone_2_Enclosure.dxf, EM-302_EMP_Penetration_Bonding_and_Earthing_Details.dxf, F-101_Underground_Level_Escape_Plan.dxf]
2026-09-11 RC2: two rulings by the project owner — the EMP zone model adopted, the generator may run in Mode 3
    Both questions were asked, not assumed. EM1 and EL1 each raised one thing
    they could not answer from the project's own evidence, sized the consequence
    of each answer, and stopped. Neither ruling changes a single number in either
    package — both confirm what the packages had already reasoned, and move the
    evidence class from [D]/[A] to [C]. That is the outcome a ruling should have.
    RULING 1 — THE THREE-ZONE EMP MODEL IS ADOPTED (closes EM-V1).
    EMP Zone 0 / 1 / 2, and the rule that EMP Zone 2 delivers the full 80 dB
    standing alone with no attenuation credited from the concrete box at any
    f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
    [E-001_Single_Line_Diagram.dxf, EM-001_EMP_Design_Basis_and_Zone_Key.dxf, EM-101_EMP_Zone_Plan_Underground.dxf, EM-102_EMP_Boundary_Section_Entry_Path.dxf, EM-201_Shielding_Effectiveness_Cage_and_Apertures.dxf, EM-301_EMP_Zone_2_Enclosure.dxf, EM-302_EMP_Penetration_Bonding_and_Earthing_Details.dxf, EMP_ZONE_SCHEDULE.csv]
2026-09-11 SG1: site selection and geotechnical investigation — the project's first
    Part J drew [SITE INVESTIGATION] as a root node with nothing feeding it, every
    parameter in master A.6 was [ASSUMED] with no source recorded anywhere, and the
    design report contained no site selection section at all. Two owner-supplied
    documents now feed that node for the first time: the SEMT/67/15 sub-soil
    investigation for the CTW PH-III ACCN project at CME Pune, and the P1
    presentation deck.
    THE FACT THAT GOVERNS THE PACKAGE
    The investigation reached about 1.5 m. The structure founds at (-)6.800. There
    are 5.3 m of completely unlogged ground under the whole structure, and only the
    sentry footing F1 at (-)2.000 li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
    [GEOTECHNICAL_PARAMETER_RECONCILIATION.csv, METEOROLOGICAL_SCHEDULE.csv, ROCK_STRENGTH_SCHEDULE.csv, SG-001_Site_and_Geotechnical_Design_Basis.dxf, SG-101_Site_Setting_Selection_and_Meteorology.dxf, SG-201_Geotechnical_Profile_and_Structure_Section.dxf, SOIL_PROPERTY_SCHEDULE.csv, TRIAL_PIT_SCHEDULE.csv]
2026-09-11 SG2: site layout and external works — the project's first site layout plan
    Master H.9 recorded the positions of the soakaways, the septic tank and the
    external chambers as "not determinable - no site plan, boundary or contour
    exists", and with them five pipe lengths and the IS 2470 (Pt 2) offsets.
    Drainage calculation D.11 ends on the same sentence. The project owner has now
    supplied the coordinate 18.6089876 N, 73.8587287 E and confirmed that "the
    area around 50 m is all available". That is enough. SG2 determines them.
    SITE ORIENTATION, FIXED FOR THE FIRST TIME
    Project +X = EAST, +Y = NORTH. The entry stairwell's grade door is at its west
    end and the campus is west, so the entry faces t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
    [EXTERNAL_PIPE_RUN_SCHEDULE.csv, EXTERNAL_WORKS_SCHEDULE.csv, SG-101_Site_Setting_Selection_and_Meteorology.dxf, SG-102_Site_Layout_Plan.dxf, SG-201_Geotechnical_Profile_and_Structure_Section.dxf, SG-202_External_Works_Siting_and_Soak_Pit_Finding.dxf, SG2_OPEN_ITEM_STATUS.csv, SITING_CLEARANCE_SCHEDULE.csv]
2026-09-11 DR-A1: the drainage items drawn on the Rev F architectural sheets
    The request was a drafting one - show the soak pit and septic tank on the
    front elevation and the sump pit on the side section. One of the three was
    straightforward; the other two turned out not to be, and the reason is the
    finding below.
    A-202 (2_Side_Section_with_Stairs.dxf) - SU-01 clean sump pit, Bay 5, drawn
    cut. It sits in this section's own cut plane and had never been drawn there.
    Pit clear X 11068-12568, 1500 x 1500 x 1500 = 3.375 m3, invert (-)7.600,
    base slab (-)8.000, walls 300 and base 400 (C18 as ruled by RC1). PU-01 /
    PU-02 and the rising main shown; PD-06 leaves through the service entry plate
    in the north wal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
    [2_Side_Section_with_Stairs.dxf, 5_Front_Elevation.dxf]
2026-09-11 Correct the STAAD input files, reconcile the project record, add a consolidated report
    The coarse mesh model reported errors when run in STAAD.Pro. Both defects were
    input-file defects, not model defects; correcting them led to a wider sweep.
    MS2 -- STAAD input files (master H.26). Three LOAD 6 south-wall lines in the
    coarse model were 80 columns against the file's own INPUT WIDTH 79, so STAAD
    read -77.6/-57.3/-37.0 instead of -77.64/-57.36/-37.07 and LOAD 6 failed its
    own PRINT STATICS CHECK by 4.8 kN in Z. LOAD 10 was defined after LOAD 11 in
    all four box models. Corner KFY at joint 1 read 27562 against the 27563 the
    study derives. All fixed; re-read at 79 columns, coarse, medium and fine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
    [5_Front_Elevation.dxf]
2026-09-11 RC4: sixteen rulings by the project owner, thirteen actioned
    The owner was taken through the open register item by item. Thirteen rulings
    are actioned; three items were deliberately left open and stay open. Every
    ruling is [C] owner ruling. No analysis was run, no evidence tag converted by
    inference, and the main staircase is untouched.
    Closed (8): U2 no direct hit - U3 50 psi held as the stated basis, yield left
    unstated rather than invented - WM-V7 ballistic protection not required, brick
    stands - EM-V3 bay 8 is INSIDE the EMP boundary, so BV-4/BV-5 now require
    honeycomb panels and the project holds two protective boundaries that do not
    coincide - EL-V6 the 96-hour heat balance computed -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
    [RC4_BOQ_ADDENDUM.csv]
2026-09-12 RC5: four more rulings, and the first K.2 assumption closed on the evidence
    Three rulings actioned, one left open, and A13 closed without needing a
    ruling at all. No analysis run, no tag converted by inference, main
    staircase untouched.
    A13 - sentry frame member releases. K.2 said "verify by: upload the .std
    file". The file has been in the workspace since H.4 and nobody re-read it.
    Reading it settles the row: there is no MEMBER RELEASE command anywhere,
    supports are 1 2 11 12 FIXED, members are PRIS 0.35 sq and 0.45 x 0.25, and
    the infill is carried as MEMBER LOAD, never as a strut. The assumption was
    right and is now CONFIRMED. First of the fourteen to close.
    RC4-V1 - reject to the ventil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
2026-09-12 RC7: six more closed, and the IS 2470 offset set completed
    K.1b goes from twenty-one to fifteen.
    EL-V7 ruled and narrowed. The CO2 production rate did not have to be
    assumed - it was already embedded in the HVAC package's own 9.9 h figure.
    Reading that backwards gives 0.18 m3/h of CO2, 17.28 m3 over a 96 h closed
    occupancy, and the check reproduces the stated 9.9 h. Adopted: a 75 m3/h
    recirculation loop, the worst cell of Q = production/(eta x C_target) across
    0.5-1.0 % and eta 0.5-0.95. A 75 m3/h fan at 250 Pa draws about 11.6 W
    against EL1's 100 W allowance, so the allowance is now checked rather than
    assumed and no electrical value changes. The scrubber is a closed-mode
    device and is not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
2026-09-12 RC10: what the rulings left stale in the packages
    RC4 to RC9 ruled on thirty-two open items and recorded every ruling in the
    master. They did not touch the discipline packages. Six artefacts therefore
    now say something the master has settled - the same class of defect RC9
    corrected one level up, and found this time by looking for it rather than
    waiting for it.
    1. EMP penetration register, BV-4/BV-5: "honeycomb WBC panel ... *if* bay 8
    is inside the EMP boundary". EM-V3 is ruled - it is inside - so the panels
    move from conditional to required. And RC2 lets BV-4/BV-5 reopen in closed
    mode, so the panels must work with the valves open, which neither document
    yet states.
    2. Same reg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
2026-09-12 DR-A2: the sump pit head, and where the pits actually are
    Two drafting requests on the Rev F architectural sheets, and the first one
    exposed a gap rather than a drafting error.
    A-202. The floor really was missing over SU-01, and DR-A1 was right to draw
    it that way: the project records a 1500 x 1500 OPENING through the mat - F.1
    trims it with 4-T20 each face each side, BBS line F10 calls it an opening,
    and WM-V8 measures the mat gross by its 1.35 m3. What the project does not
    record is anything that closes it. DR-A2-F1: a cover is not optional here.
    Bay 5 is 1560 clear against a 1500 opening, so with the pit open there is no
    route past it to the two filter trains, the CO2/O2 plant or the deh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
    [2_Side_Section_with_Stairs.dxf, 5_Front_Elevation.dxf]
2026-09-13 PR2 (work in progress): the drawn figure library and renderer support
    Adds Project Report/Scripts/report_figures.py -- 44 report figures drawn
    from the confirmed geometry of the master (GEOM / LEV / COVER constants in
    project coordinates), plus a bounds checker that refuses to let any figure
    draw outside its own frame or run text past the text measure.
    These are READING figures, not the issued drawings. They carry no title
    block, no revision box and no bar mark, they are drawn at reading scale,
    and they are not reconstructions of the seven absent S-series sheets.
    report_render.py gains three directives:
    <!-- FIG: name --> a numbered, captioned figure in document order
    <!-- LOF -->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
2026-09-14 PR2: EMP protection science and design, IS 10262 mix design, and the water operating procedure
    Expands PR2 from 137 to 151 pages and from 44 to 57 drawn figures.
    Recorded in master H.37. NO DESIGN VALUE CHANGED: no dimension, level,
    load, thickness, bar, quantity, rate, date or float; no .std file
    touched; STAAD.Pro not run; no drawing edited; no evidence tag converted,
    downgraded or deleted. The main staircase is untouched.
    EMP -- ELECTROMAGNETIC PULSE, science and design, which is what "EMP"
    means everywhere in this project. Part 2.8 gains the Compton-current
    mechanism that makes a HEMP and why a nanosecond rise puts energy to a
    gigahertz; the three coupling paths -- aperture, diffusion,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
2026-09-15 WM4: the Works Management bill priced from Maharashtra SSR 2022-23
    WM1 measured 90 items and carried no rate anywhere in it, on purpose — the
    master says why: "Rates come from the MES SSR. No item number could be
    verified from the material available, and inventing one would put false
    authority on a document an executing engineer might rely on."
    The owner has now supplied the schedule: SSR 22-23 MH (1).pdf, the Government
    of Maharashtra PWD State Schedule of Rates 2022-23, 624 pages, effective
    25 July 2022. Every item number can be verified, so the bill is priced.
    No quantity moved. Where a WM1 line had to be split to reach two different
    SSR items — the excavation by depth band, the hea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
    [Underground_Shelter_Codes_References.csv, WM4_BOQ_PRICED_SSR_2022-23.csv, WM4_COST_SUMMARY.csv, WM4_OPEN_ITEMS.csv, WM4_OWNER_BILL_VS_SSR.csv, WM4_SSR_RATE_LIBRARY.csv, WM4_Underground_Shelter_BOQ_Cost_Estimate_SSR_2022-23.xlsx]
2026-09-16 SR1: two A2 structural reinforcement sheets, STR006 and STR007
    Adds SHEET 06 and SHEET 07 to the owner's Revit A2 series (ARCH001..ARCH005),
    drawn on the same frame and title block, reverse-engineered from the vector
    content of the supplied PDF rather than estimated.
    STR006 ROOF SLAB & MAT FOUNDATION
    V1 roof slab reinforcement plan 1:100
    V2 roof slab longitudinal section A-A 1:100 (cut Y 2050)
    V3 mat foundation reinforcement plan 1:100
    V4 mat foundation longitudinal section B-B 1:100 (cut Y 2050)
    STR007 600 SHEAR WALL & MAIN STAIRCASE
    V1 600 shear wall vertical section 1:30
    V2 600 shear wall part plan / horizontal section 1: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
    [STR006_Structural_Reinforcement_Detailing_Roof_Slab_and_Mat_Foundation.dxf, STR007_Structural_Reinforcement_Detailing_Shear_Wall_and_Main_Staircase.dxf]
2026-09-16 SR2: A2 sentry-post reinforcement sheets STR008 (SHEET 08) and STR009 (SHEET 09)
    Two more A2 sheets in the frame and title block of the owner's Revit set
    (ARCH001..ARCH005), carrying the structural reinforcement detailing of the
    SENTRY POST. This is the project's IS 13920:2016 sheet pair: the underground
    box is not a ductile-detailing element (master A.7.8 checks Cl. 10.4 and it is
    not triggered), the sentry post frame is.
    SHEET 08 STR008 BEAMS B1 / B2 AND COLUMN C1
    1 first-floor framing plan 1:50 · 2 beam B1 longitudinal section 1:40
    3 beam B2 longitudinal section 1:40 · 4 sections a-a/b-b, c-c/d-d, 3-3, 4-4
    at 1:10 · 5 column C1 vertical section, full height (-)1.400 to (+)6.7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
    [STR008_Structural_Reinforcement_Detailing_Sentry_Post_Beams_and_Column.dxf, STR009_Structural_Reinforcement_Detailing_Sentry_Post_Footing_and_Slab.dxf]
2026-09-16 SR2A: delete both note panels and the "REV A" header token from STR008 / STR009
    By instruction. Three deletions and nothing else.
    1. DESIGN BASIS - THIS SHEET panel deleted from both sheets
    2. DECLARED DETAILING DECISIONS AND OPEN ITEMS panel deleted from both
    3. "REV A" in the title-block identity line deleted:
    STRUCTURAL - PHASE 2 REV A + M1 -> STRUCTURAL - PHASE 2 + M1
    NO VIEW, SCALE, DIMENSION, LEVEL, BAR, SPACING, CUT LENGTH OR BAR COUNT CHANGED
    on either sheet. The drawn geometry is the same. The main staircase is
    untouched and STR006 / STR007 are not regenerated.
    Three consequences were handled rather than left dangling:
    * The sheets still carry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
    [STR008_Structural_Reinforcement_Detailing_Sentry_Post_Beams_and_Column.dxf, STR009_Structural_Reinforcement_Detailing_Sentry_Post_Footing_and_Slab.dxf]
2026-09-16 SR1A: delete the design-basis panel and the whole revision line from STR006 / STR007
    By instruction, on the owner's own uploaded copies of the two SR1 sheets.
    1. DESIGN BASIS - THIS SHEET panel deleted from both STR006 and STR007
    2. "STRUCTURAL - PHASE 2 REV A + M1" deleted from the header, WHOLE LINE
    Asked directly which reading of "delete Phase 2 Rev A M1 from header" was
    meant, since it differs materially from the REV A-only treatment SR2A gave
    STR008/STR009: drop only "REV A" (keeping "PHASE 2 + M1"), or delete the
    entire revision line. The answer was the whole line. sheet_data.IDENTITY
    now has FOUR lines and carries no revision text at all.
    NO DIMENSION, LEVEL, BAR, SPACI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
    [STR006_Structural_Reinforcement_Detailing_Roof_Slab_and_Mat_Foundation.dxf, STR007_Structural_Reinforcement_Detailing_Shear_Wall_and_Main_Staircase.dxf, STR008_Structural_Reinforcement_Detailing_Sentry_Post_Beams_and_Column.dxf, STR009_Structural_Reinforcement_Detailing_Sentry_Post_Footing_and_Slab.dxf]
2026-09-16 MEP1: A2 services presentation sheets MEP010 (SHEET 10) and MEP011 (SHEET 11)
    Two more A2 sheets in the ARCH001...ARCH005 frame and title block, the first
    of the series for services rather than structure.
    SHEET 10 MEP010 HVAC & EMP ZONE LAYOUT PLANS - UNDERGROUND LEVEL
    1 HVAC services layout plan (-)6.100, 1:100
    2 EMP zone layout plan (-)6.100, 1:100
    3 EMP Zone 2 enclosure, plan and section, 1:30
    4 protective ventilation schematic, filter train and cascade
    SHEET 11 MEP011 SEPTIC TANK, SOAK PIT & SUMP PIT - PLANS, SECTIONS
    1 sump pit SU-01 reinforcement plan 1:35
    2 sump pit SU-01 sectional elevation A-A 1:35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
    [MEP010_HVAC_and_EMP_Zone_Layout_Plans.dxf, MEP011_Septic_Tank_Soak_Pit_and_Sump_Pit_Plans_Sections_and_Schedules.dxf]
2026-09-18 MEP2: fire plan SHEET 12, works management SHEET 13, and sheets 01 / 02 redrawn
    Four more A2 sheets in the ARCH001...ARCH005 frame and title block. The
    presentation series is now ten sheets.
    SHEET 01 ARCH001 UNDERGROUND, HEADHOUSE AND GROUND LEVEL PLANS
    SHEET 02 ARCH002 SENTRY POST - FLOOR PLANS AND SOUTH ELEVATION
    SHEET 12 FLS012 FIRE AND LIFE SAFETY - ESCAPE PLAN
    SHEET 13 WMS013 WORKS MANAGEMENT - PROGRAMME AND BILL OF QUANTITIES
    NO DESIGN VALUE MOVED, NO ANALYSIS WAS RUN, STAAD.Pro WAS NOT OPENED.
    SHEET 13 presents WM3, the REVISED owner package of master H.15 - final
    project cost Rs 2,97,90,913 and master construction schedule R1, 224 working
    days from 02-11-26 to 2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
    [ARCH001_Underground_Headhouse_and_Ground_Level_Plans_Redrawn_to_Project_Data.dxf, ARCH002_Sentry_Post_Floor_Plans_and_South_Elevation_Redrawn_to_Project_Data.dxf, FLS012_Fire_and_Life_Safety_Escape_Plan_and_Decision_Rule.dxf, WMS013_Works_Management_Master_Programme_and_Bill_of_Quantities.dxf]
2026-09-18 MEP2A: both charts deleted from SHEET 13; the full bill of quantities printed instead
    By instruction - "no need to include graphs in works management" - WMS013 is
    re-issued with view 1 (master construction programme bar chart) and view 2
    (cost distribution by bill part) DELETED. NO FIGURE CHANGED.
    Deleting the charts freed the whole drawing region, so the sheet now prints
    more than the charted version could:
    drawing region BILL OF QUANTITIES - MEASURED ITEMS (REVISED)
    all 38 items under their five part headings, each heading a
    full-width band with its own item count and total, and every
    item with unit, quantity, rate and amount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
    [WMS013_Works_Management_Master_Programme_and_Bill_of_Quantities.dxf]
